donggua127/control_board/doc/jsfs_zk_bk.pdf

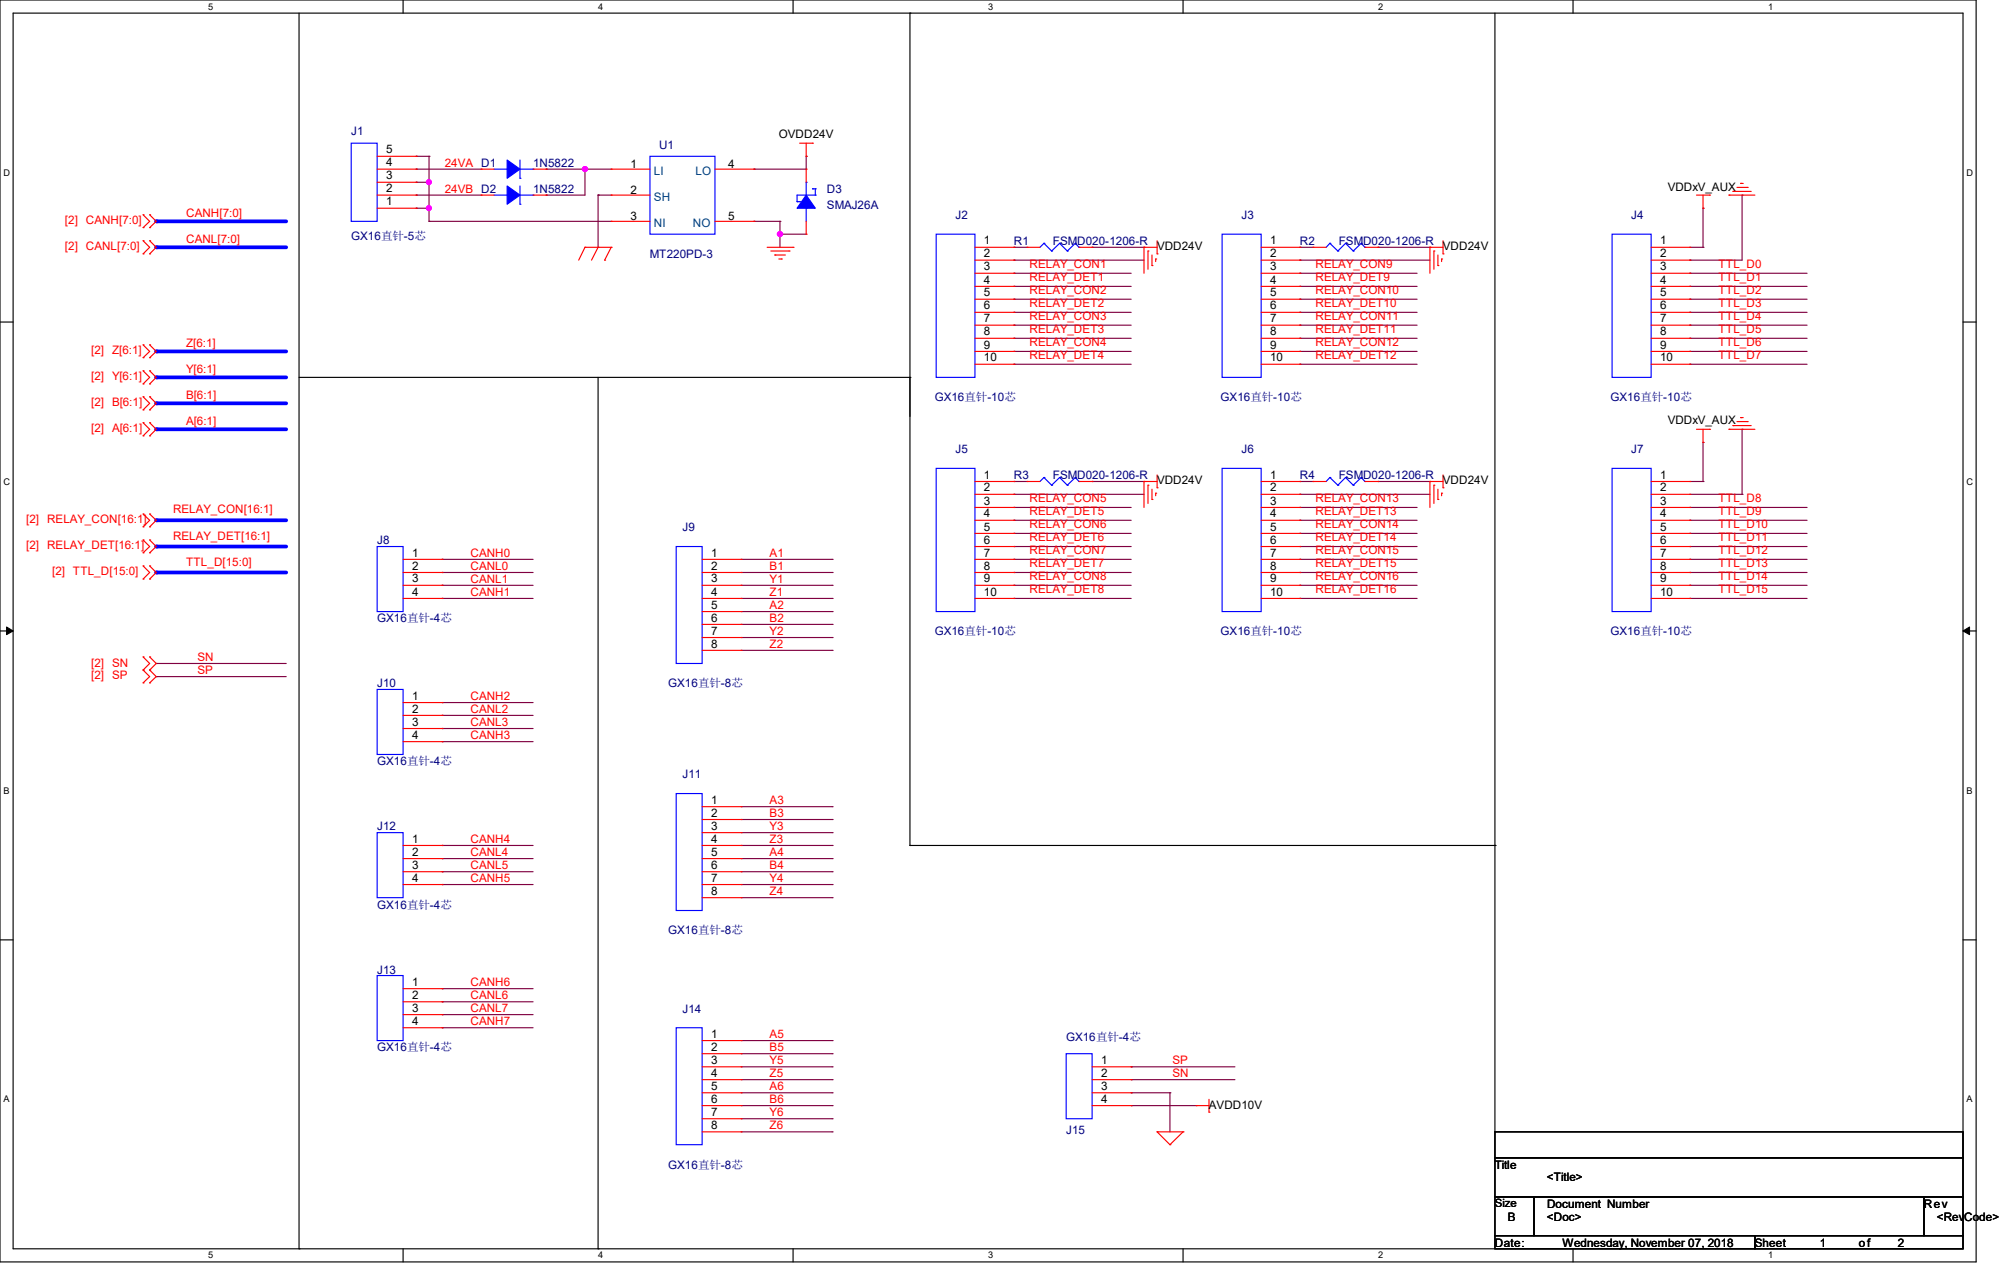
[picture p13: page 1]

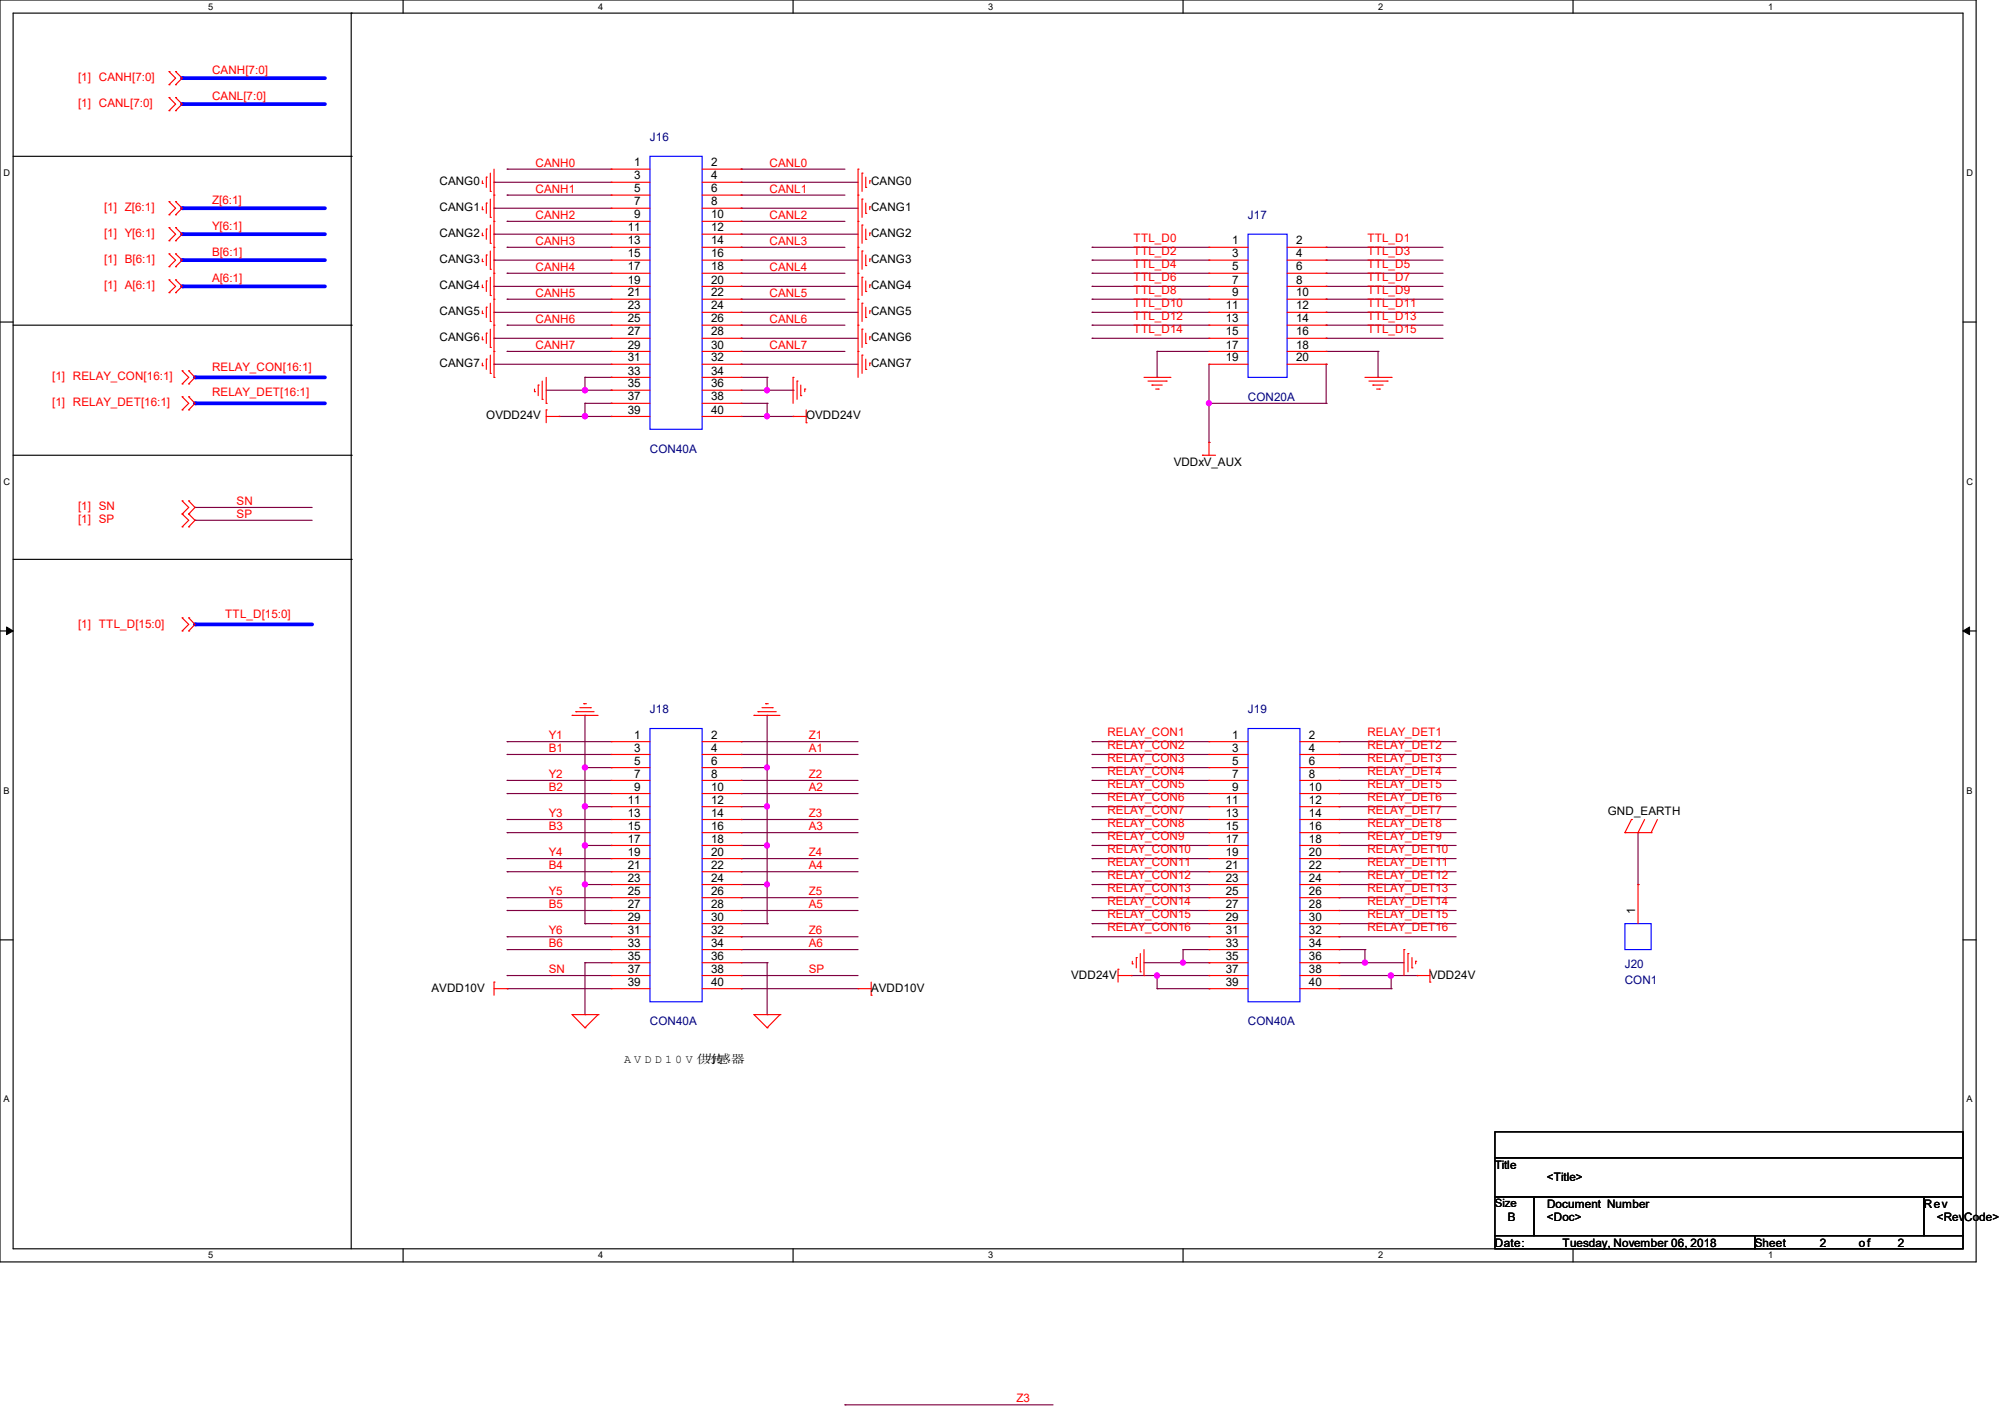
[picture p14: page 2]
A V D D 1 0 V 供力传感器; CANH[7:0]; CANL[7:0]; CANH0; CANL0; CANH1; CANL1; CANH2; CANL2; CANH3; CANL3; CANH4; CANL4; CANH5; CANL5; CANH6; CANL6; CANH7; CANL7; RELAY_CON[16:1]; RELAY_DET[16:1]; RELAY_CON1; RELAY_DET1; RELAY_CON2 RELAY_CON3 RELAY_CON4 RELAY_CON5 RELAY_CON6 RELAY_CON7 RELAY_CON8 RELAY_CON9 RELAY_CON10 RELAY_CON11 RELAY_CON12 RELAY_CON13 RELAY_CON14 RELAY_CON15 RELAY_CON16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
