donggua127/control_board/doc/JSFS_ZK_M_v1.3.pdf

# 01_NOTE 02_BLOCK_DIAGRAM

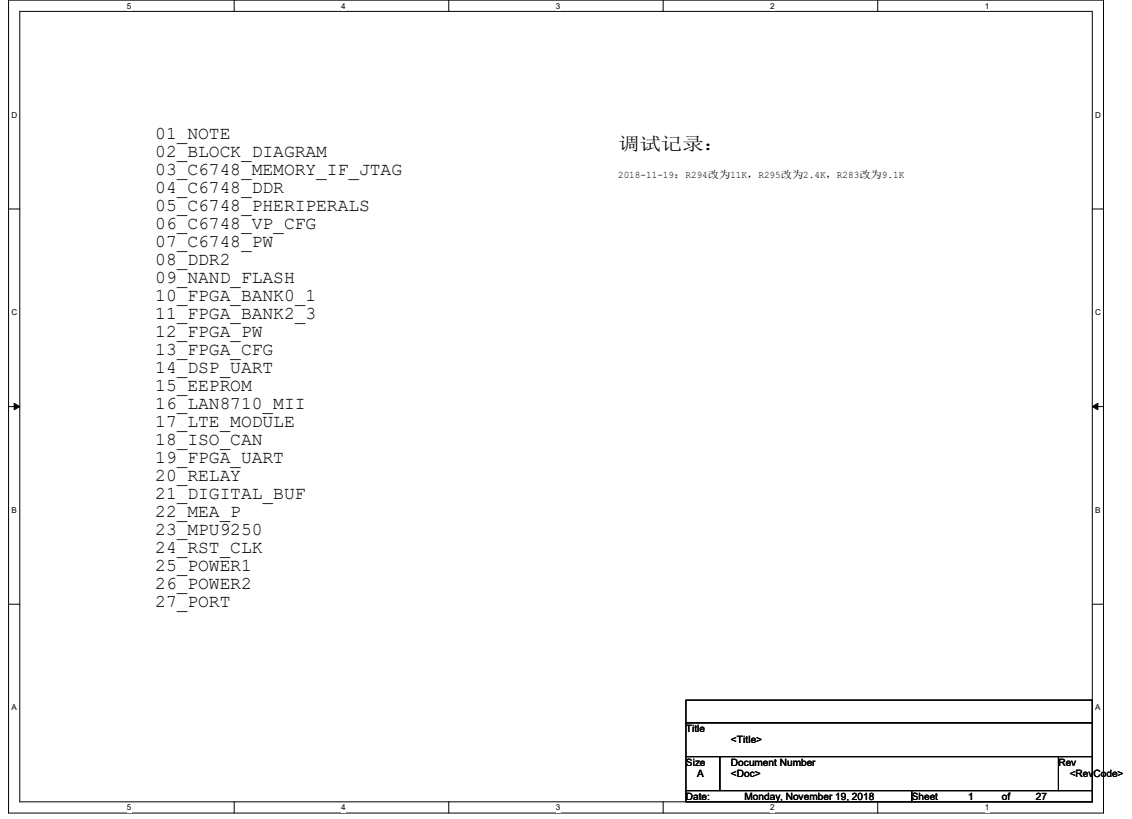
[picture p15: page 1]
03_C6748_MEMORY_IF_JTAG 04_C6748_DDR 05_C6748_PHERIPERALS 06_C6748_VP_CFG 07_C6748_PW 08_DDR2 09_NAND_FLASH 10_FPGA_BANK0_1 11_FPGA_BANK2_3 12_FPGA_PW 13_FPGA_CFG 14_DSP_UART 15_EEPROM 16_LAN8710_MII 17_LTE_MODULE 18_ISO_CAN 19_FPGA_UART 20_RELAY 21_DIGITAL_BUF 22_MEA_P 23_MPU9250 24_RST_CLK 25_POWER1 26_POWER2 27_PORT; 调试记录：; Title; Size; Document Number; Rev; Date:; Sheet; <Doc>; <RevCode>; <Title>; Monday, November 19, 2018

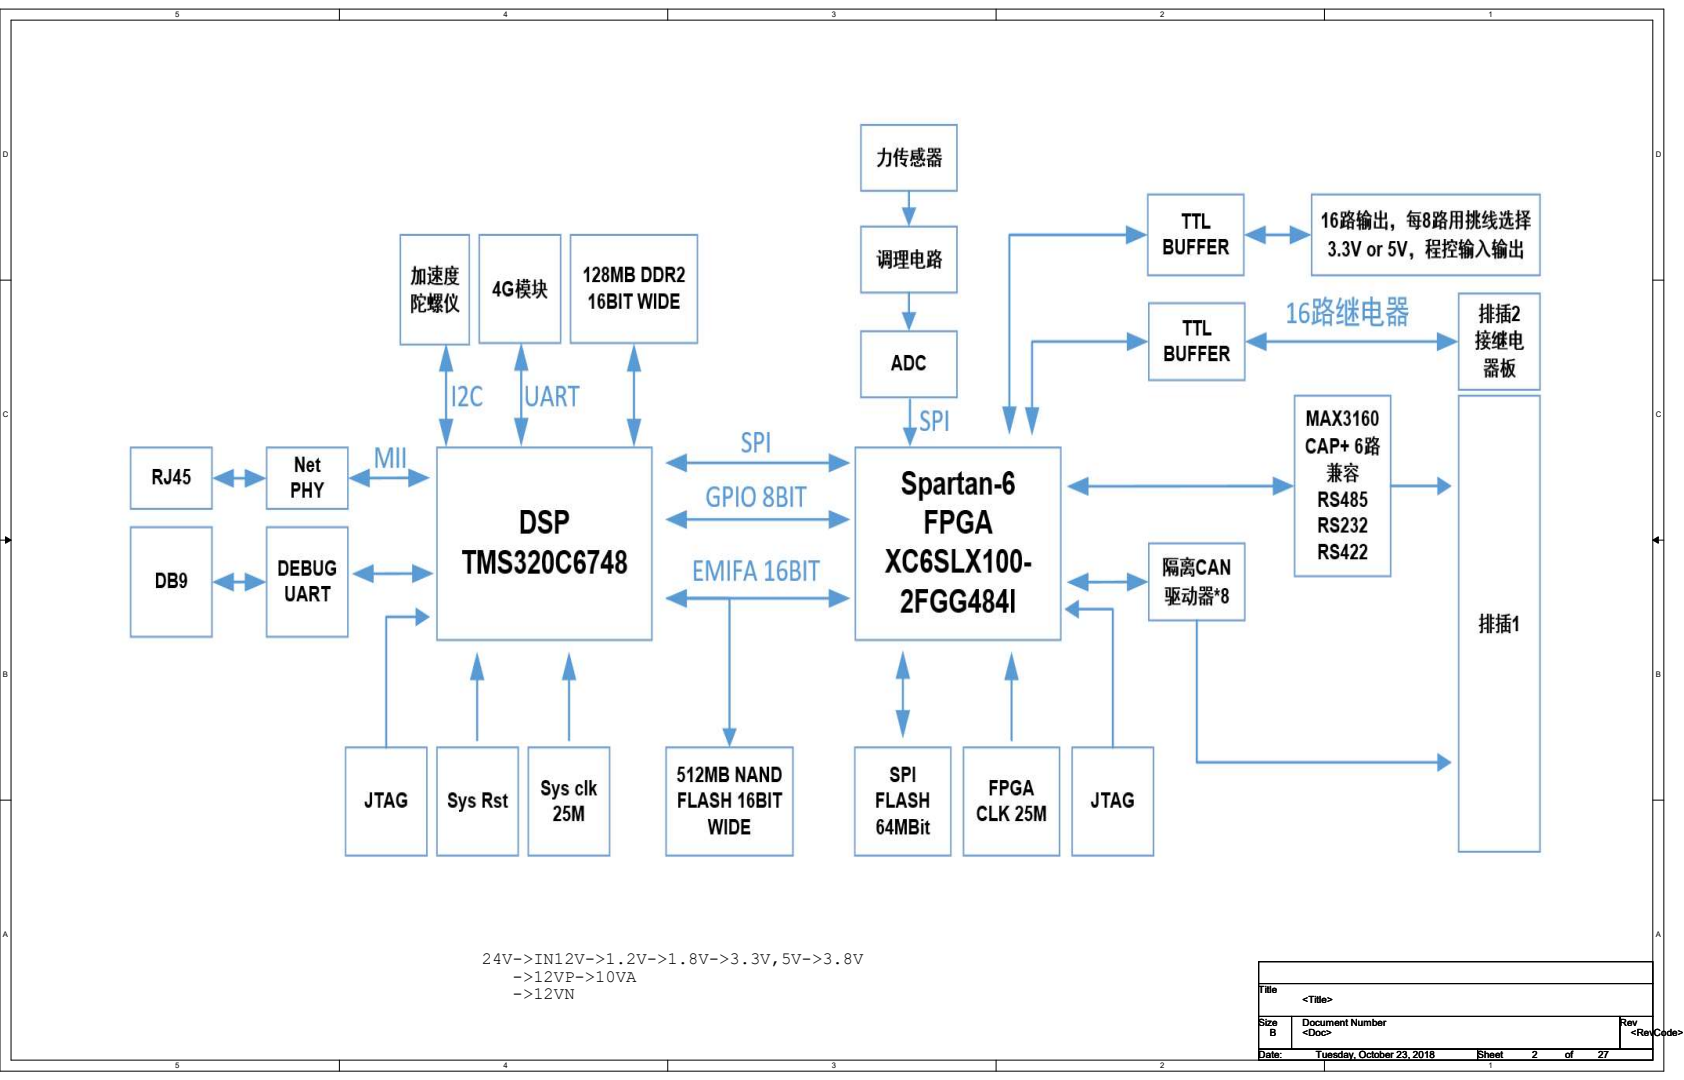
[picture p16: page 2]
Title Size; Document Number; Rev Date:; Sheet; of <Doc>; <RevCode>; <Title> B; Tuesday, October 23, 2018; 27 Title Size

# R304 4.7K R1 10K

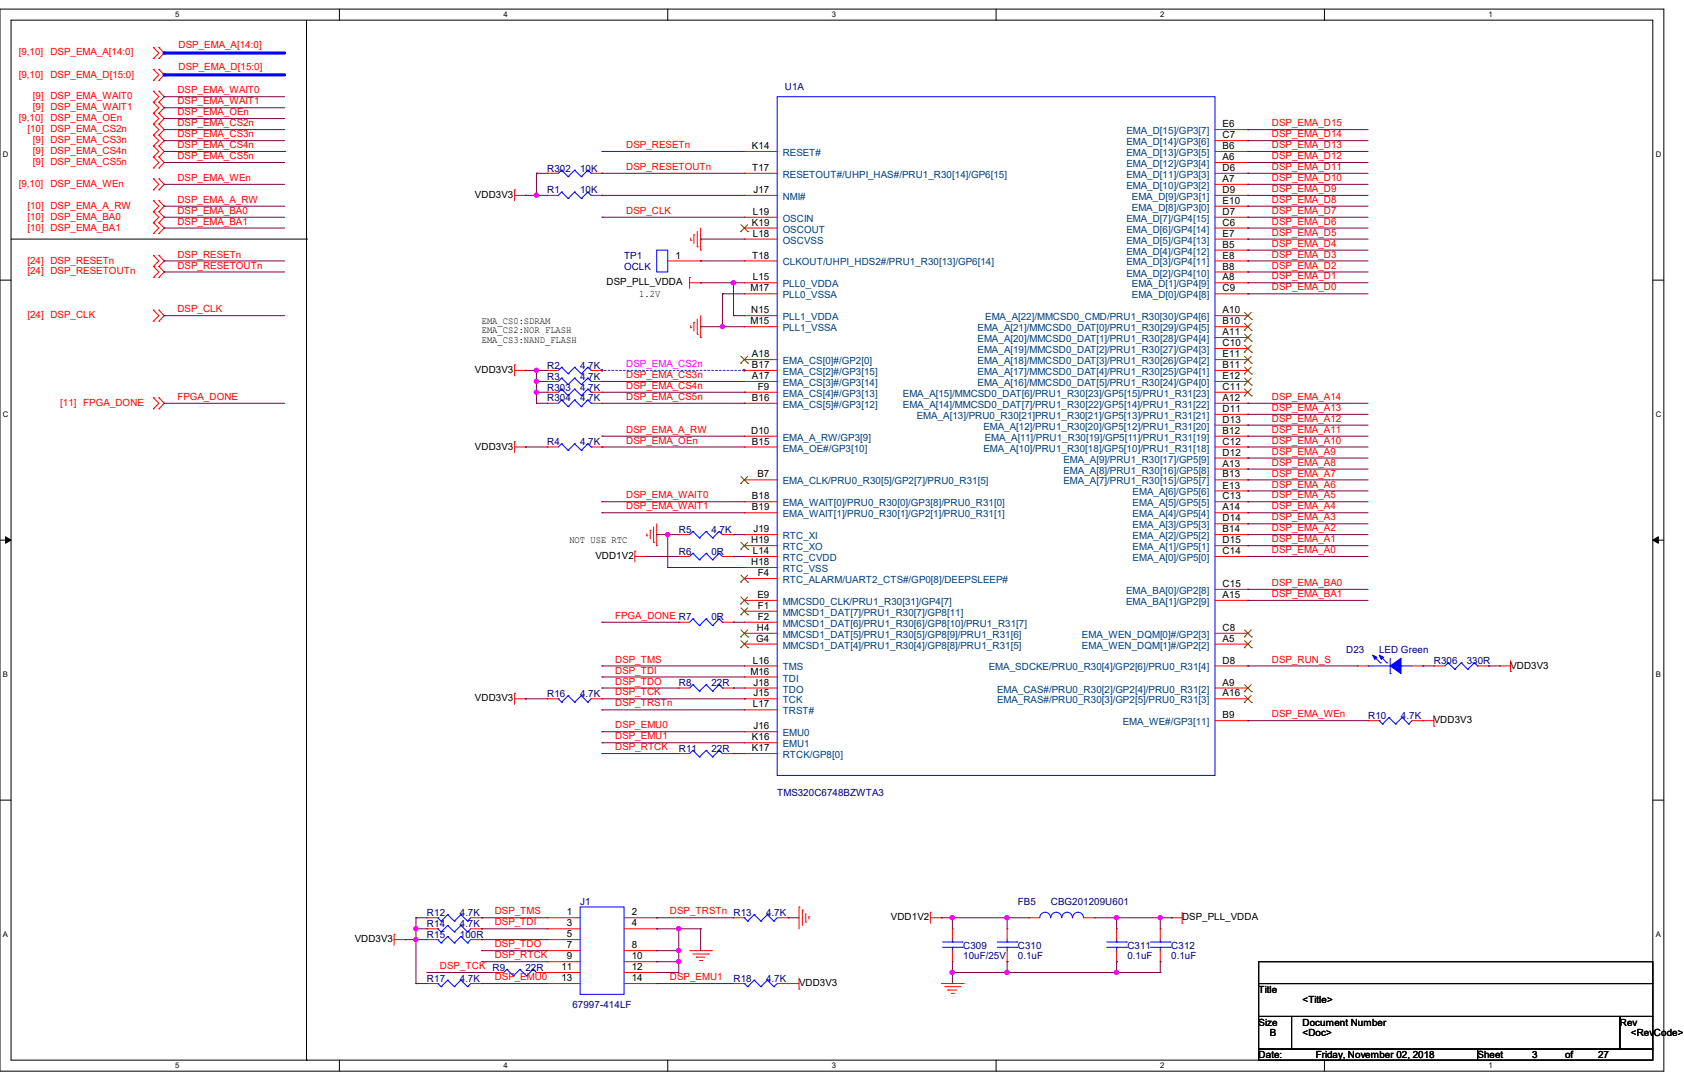
[picture p17: page 3]

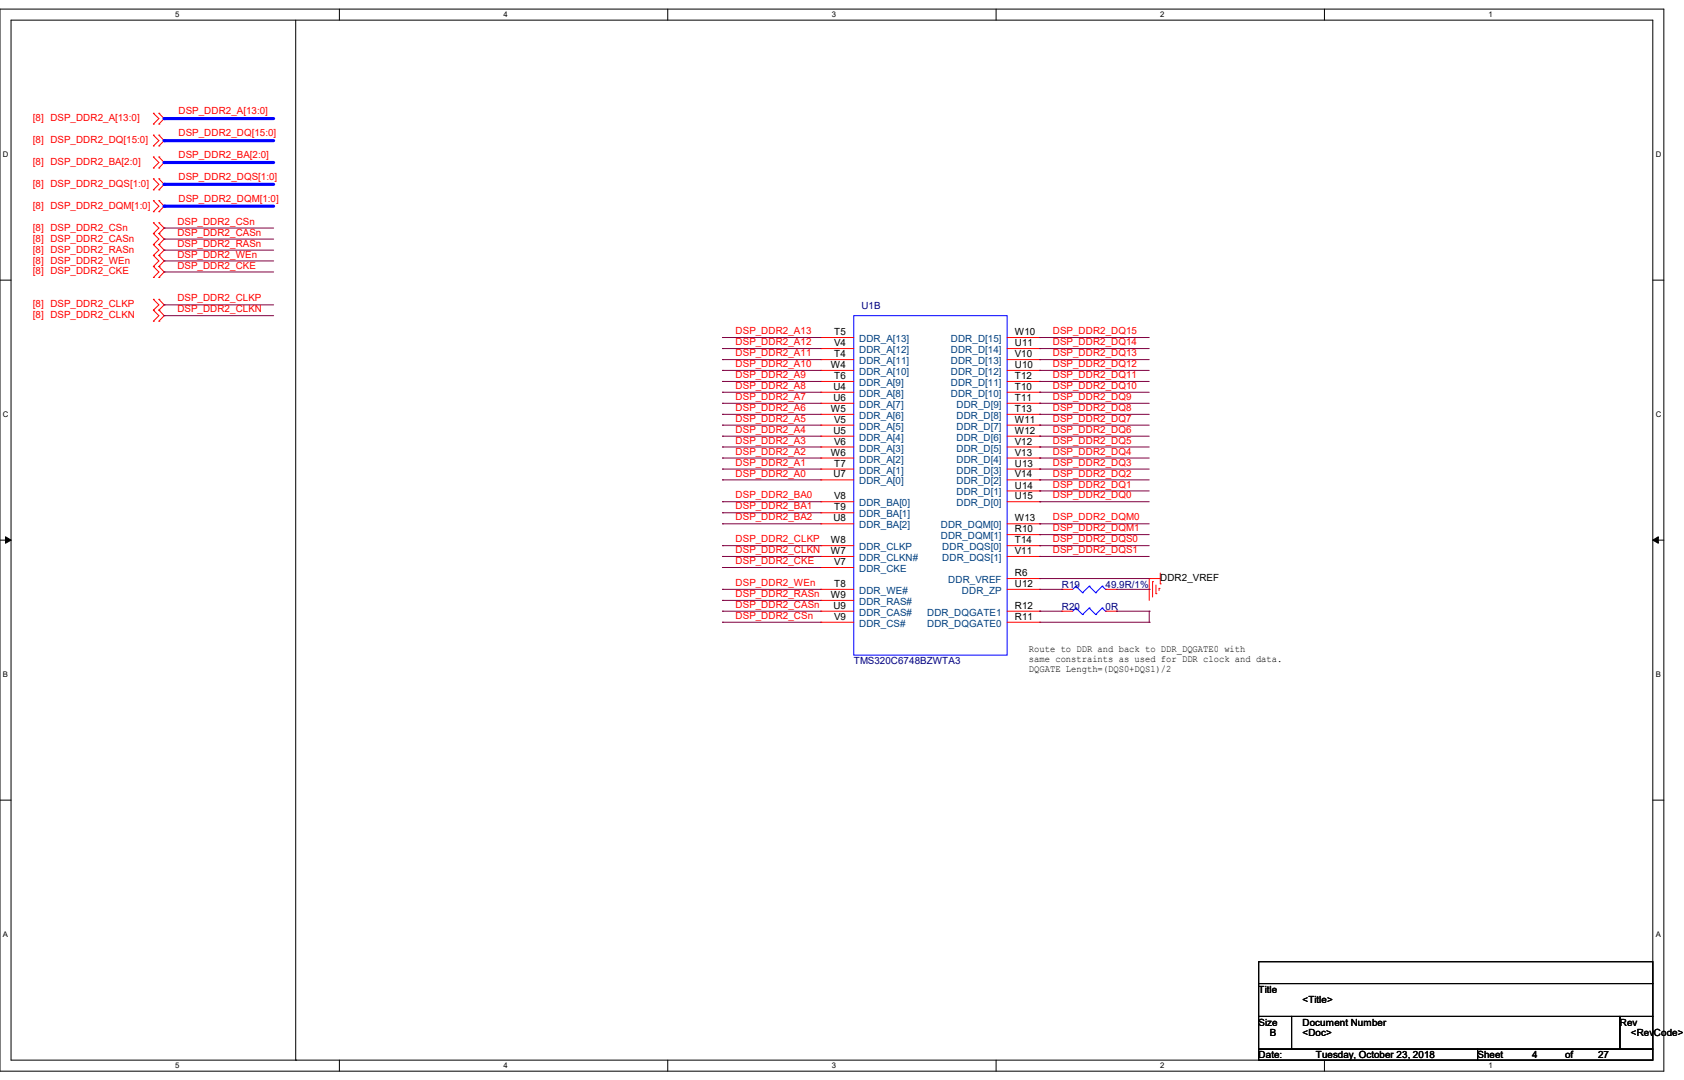
[picture p18: page 4]

Route to DDR and back to DDR_DQGATE0 with
same constraints as used for DDR clock and data.

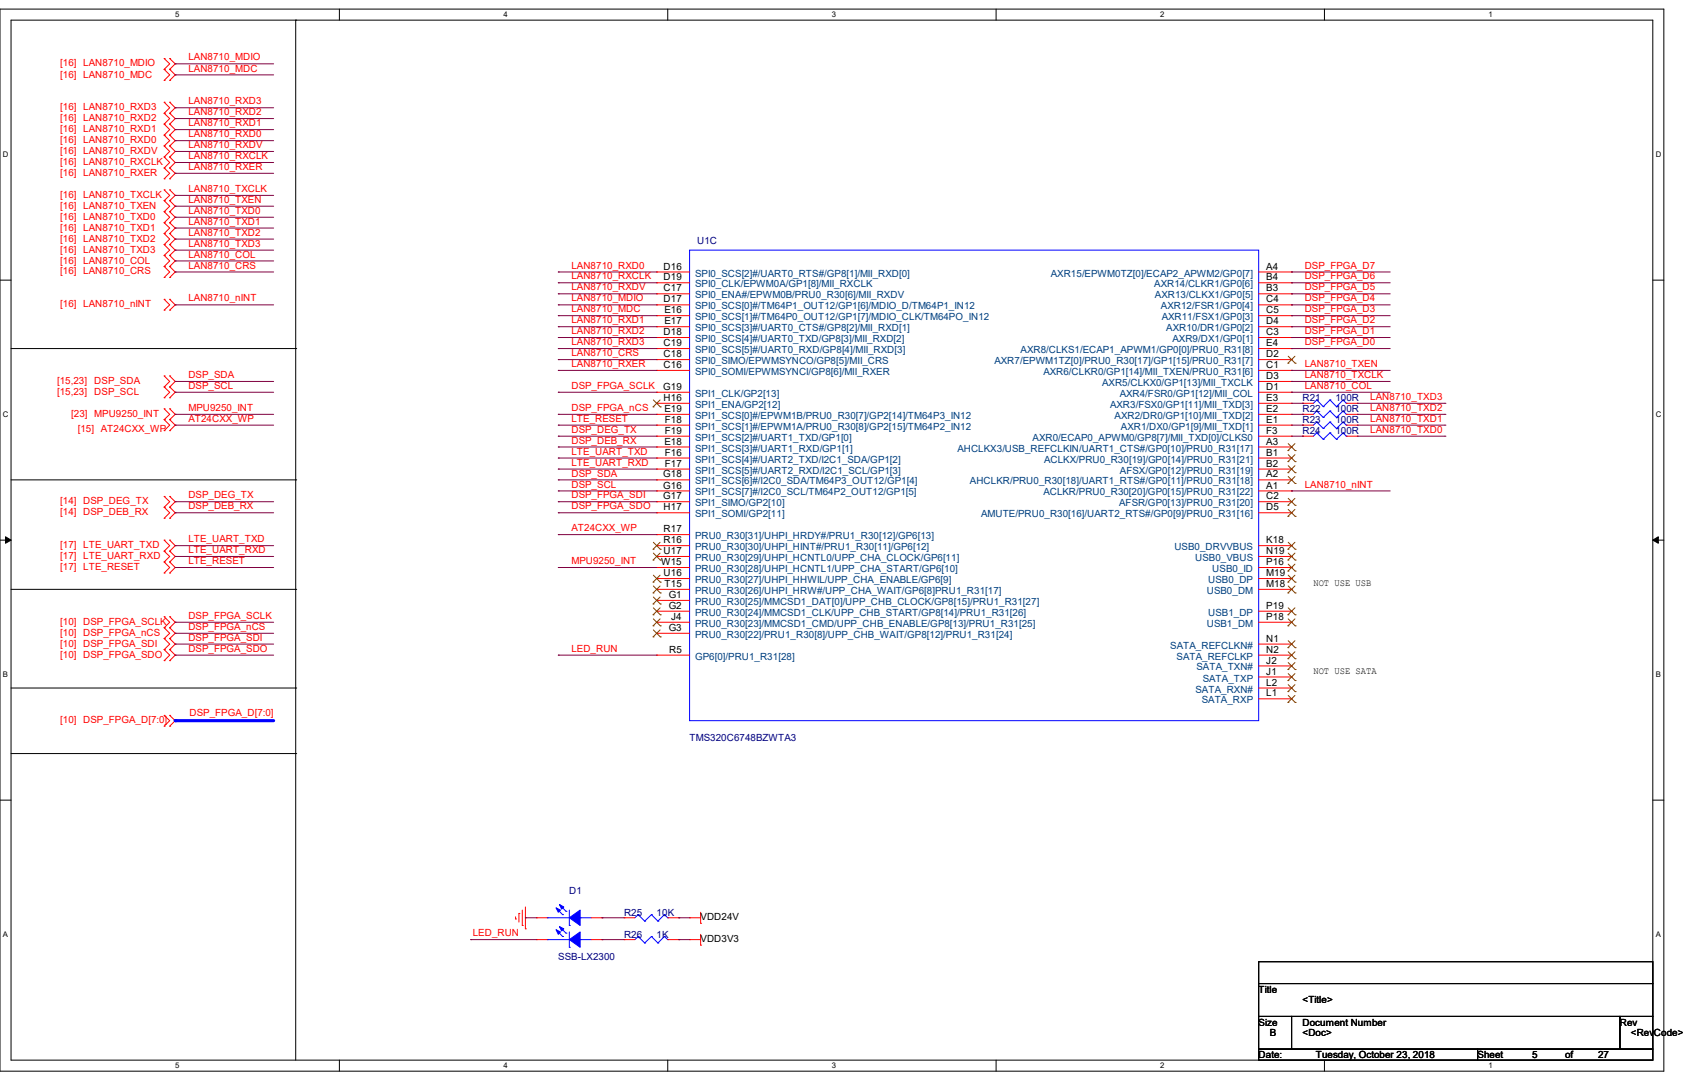
[picture p19: page 5]

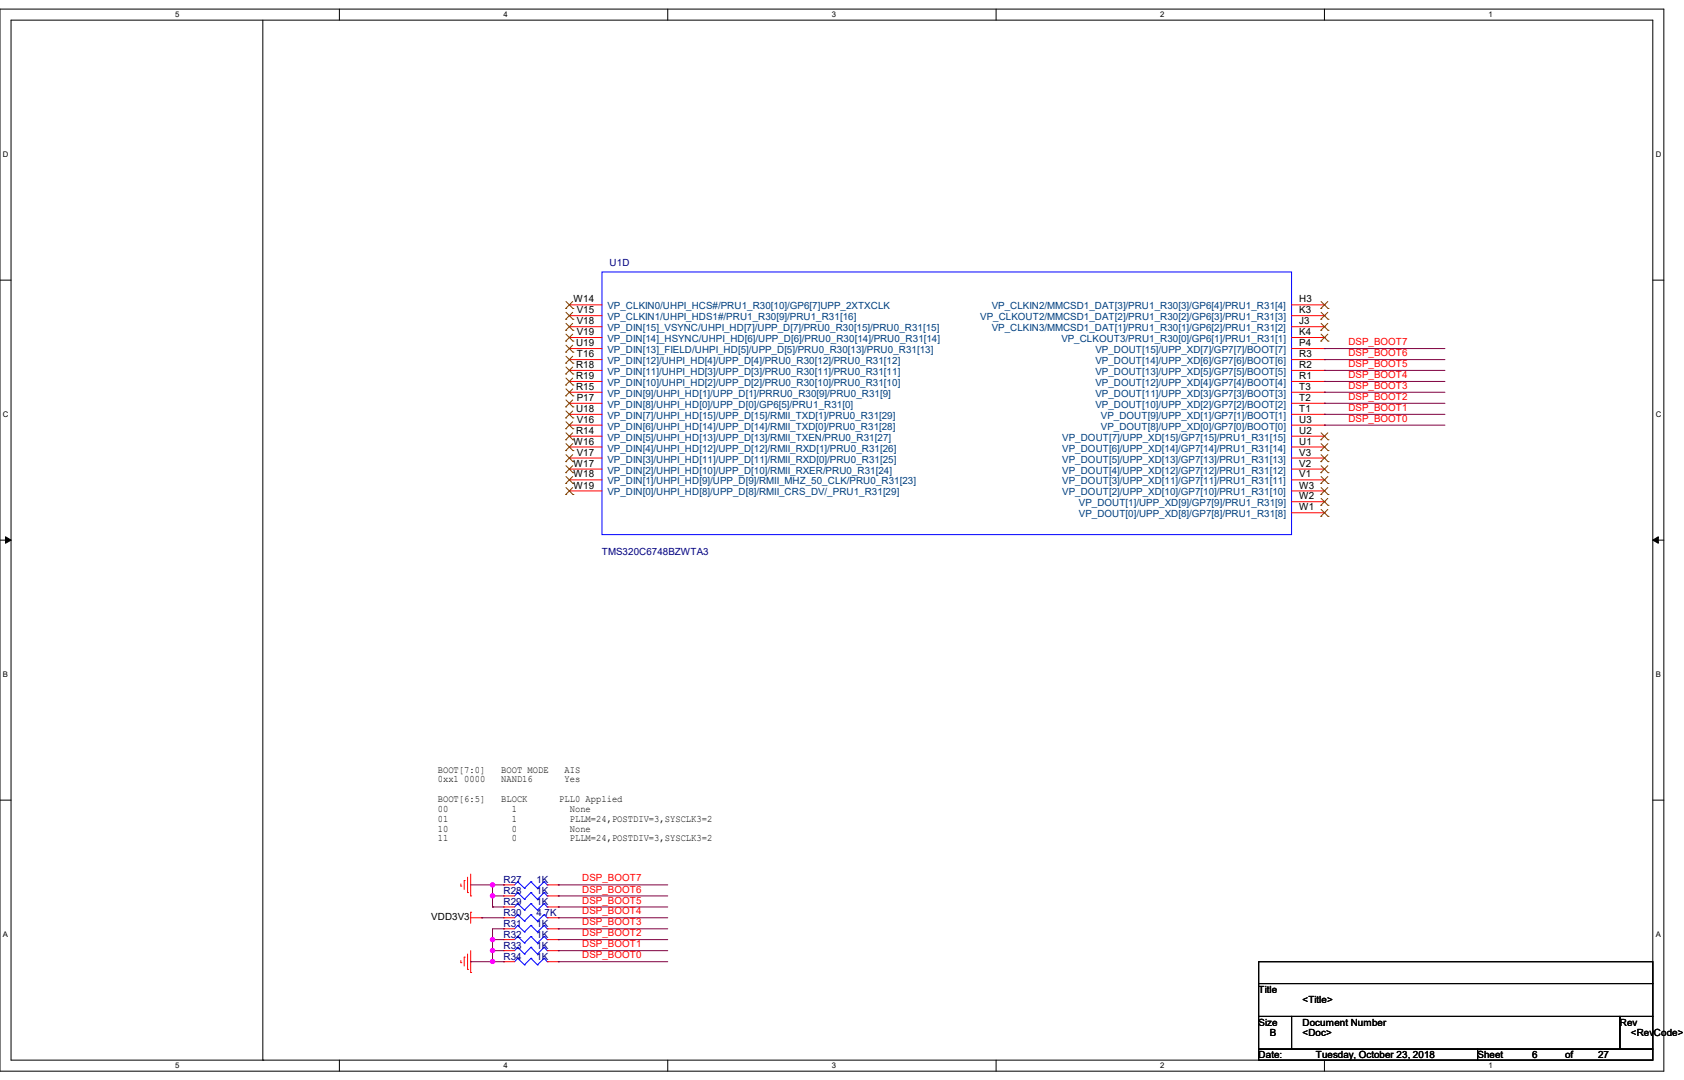
[picture p20: page 6]

RSV2 T19 | RSV3/SATA_VDD M2 | RSV3/SATA_VDD N4 | RSV3/SATA_VDD P2 | RSV3/SATA_VDD P1 | NC M³ NC M¹⁴ NC N¹⁶
USB0_VDDA33 | N18 USB0_VDDA18 | N14 USB0_VDDA12 | N17 USB_CVDD | M12 DDR_DVDD18 N6 | DDR_DVDD18 N9 | DDR_DVDD18 N10 | DDR_DVDD18 P7 | DDR_DVDD18 P8 | DDR_DVDD18 P9 | DDR_DVDD18 P10 | DDR_DVDD18 R7 | DDR_DVDD18 R8 | DDR_DVDD18 R9 | CVDD | E15 CVDD | G7 CVDD | G8 CVDD | G13 CVDD | H6 CVDD | H7 CVDD | H10 CVDD | H11 CVDD | H12 CVDD | H13 CVDD | J6 CVDD | J12 CVDD | K6 CVDD | K12 CVDD | L12 CVDD | M8 CVDD | M9 CVDD | N8 RVDD | E5 RVDD | H14 RVDD | N7 DVDD18 | F14 DVDD18 | G6 DVDD18 | G10 DVDD18 | G11 DVDD18 | G12 DVDD18 | J13 DVDD18 | K5 DVDD18 | L6 DVDD18 | P13 DVDD18 | R13 DVDD3318_A F5 DVDD3318_A F15 DVDD3318_A G5 DVDD3318_A G14 DVDD3318_A G15 DVDD3318_A H5 DVDD3318_B E14 DVDD3318_B F6 DVDD3318_B F7 DVDD3318_B F8 DVDD3318_B F10 DVDD3318_B F11 DVDD3318_B F12 DVDD3318_B F13 DVDD3318_B G9 DVDD3318_B J14 DVDD3318_B K15 DVDD3318_C | J5 DVDD3318_C | K13 DVDD3318_C | L4 DVDD3318_C | L13 DVDD3318_C | M13 DVDD3318_C | N13 DVDD3318_C | P5 DVDD3318_C | P6 DVDD3318_C | P12 DVDD3318_C | R4

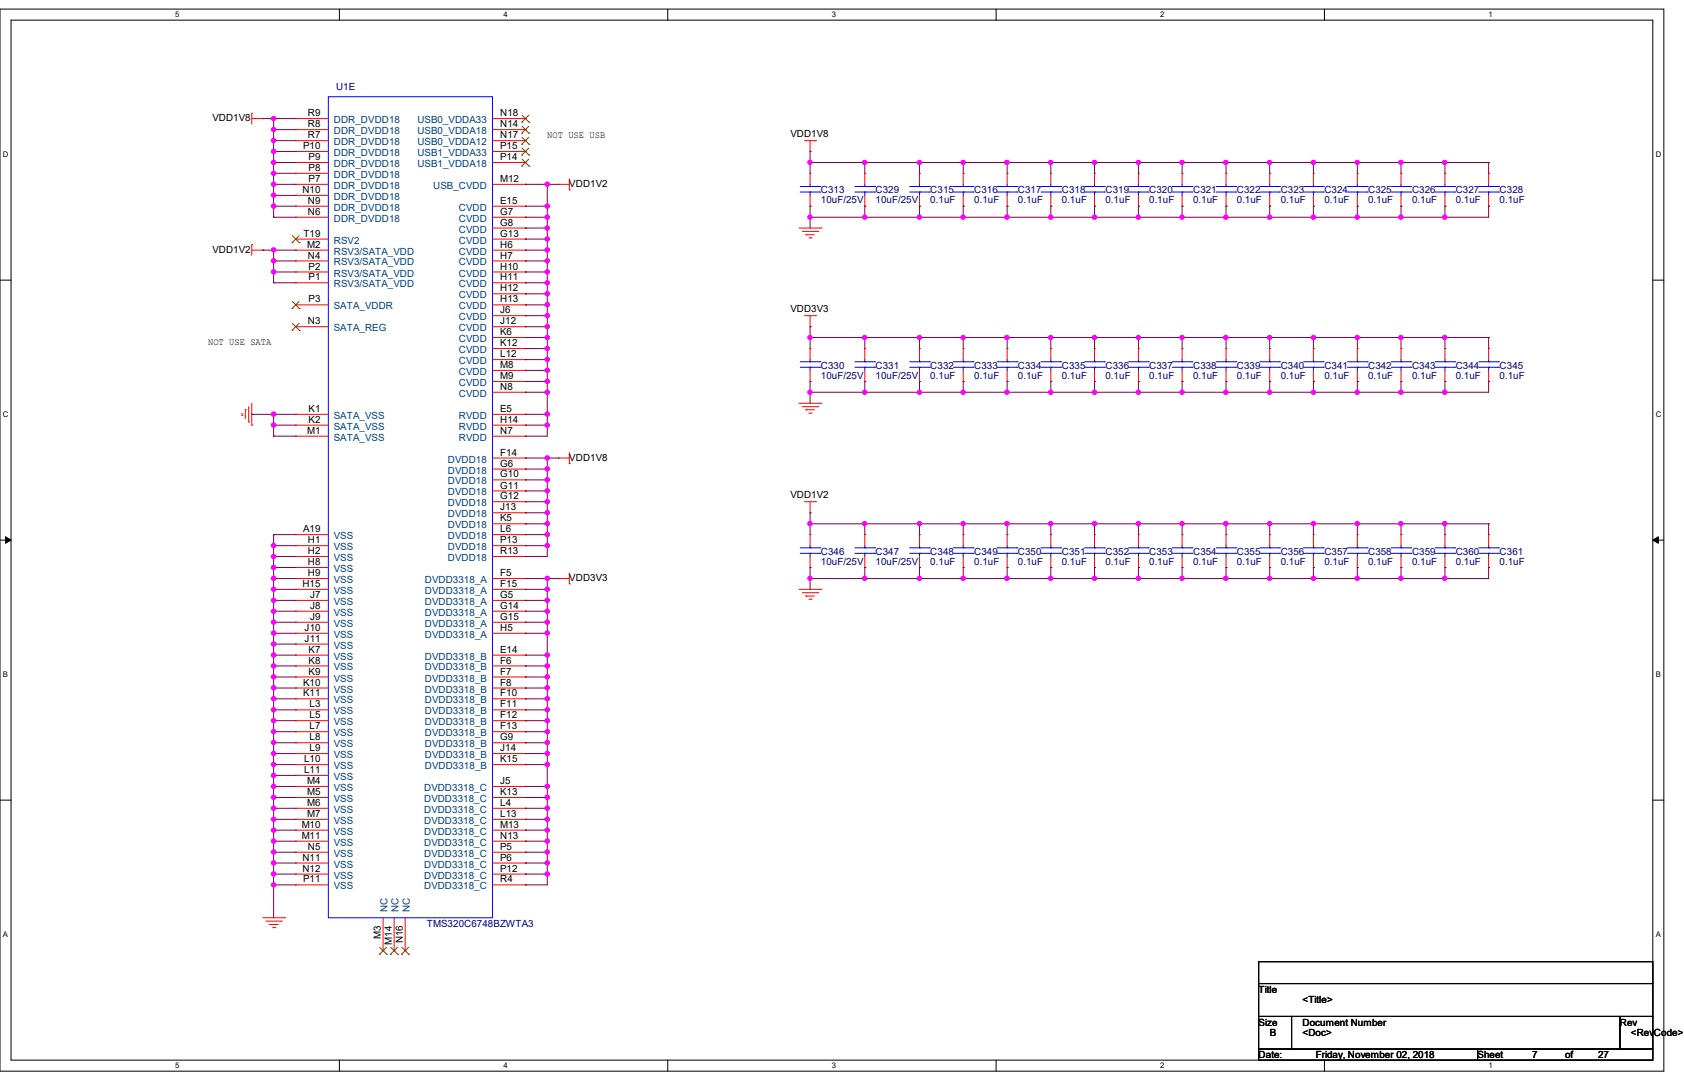
[picture p21: page 7]

A0 M8 | A1 M3 | A2 M7 | A3 N2 | A4 N8 | A5 N3 | A6 N7 | A7 P2 | A8 P8 | A9 P3 | A10 M2 | A11 P7 | A12 R2 | BA0 L2 | BA1 L3 | BA2 L1 | CK J8 | CKn K8 | CKE K2 | CSn L8
VDD5 | A1 VDD4 | E1 VDD3 | M9 VDD2 | R1 VDD1 | J9 VDDQ10 | A9 VDDQ9 | C1 VDDQ8 | C3 VDDQ7 | C7 VDDQ6 | C9 VDDQ5 | G3 VDDQ4 | E9 VDDQ3 | G1 VDDQ2 | G7 VDDQ1 | G9 VDDL | J1 VREF | J2 VSS5 | A3 VSS4 | E3 VSS3 | J3 VSS2 | N1 VSS1 | P9 VSSQ10 | A7 VSSQ9 | B2 VSSQ8 | B8 VSSQ7 | D2 VSSQ6 | D8 VSSQ5 | E7 VSSQ4 | F2 VSSQ3 | F8 VSSQ2 | H2 VSSQ1 | H8 VSSDL | J7 NC1 A2 | NC2 E2 | UDQSn/NU A8 | RFU2 R3 | RFU3 R7

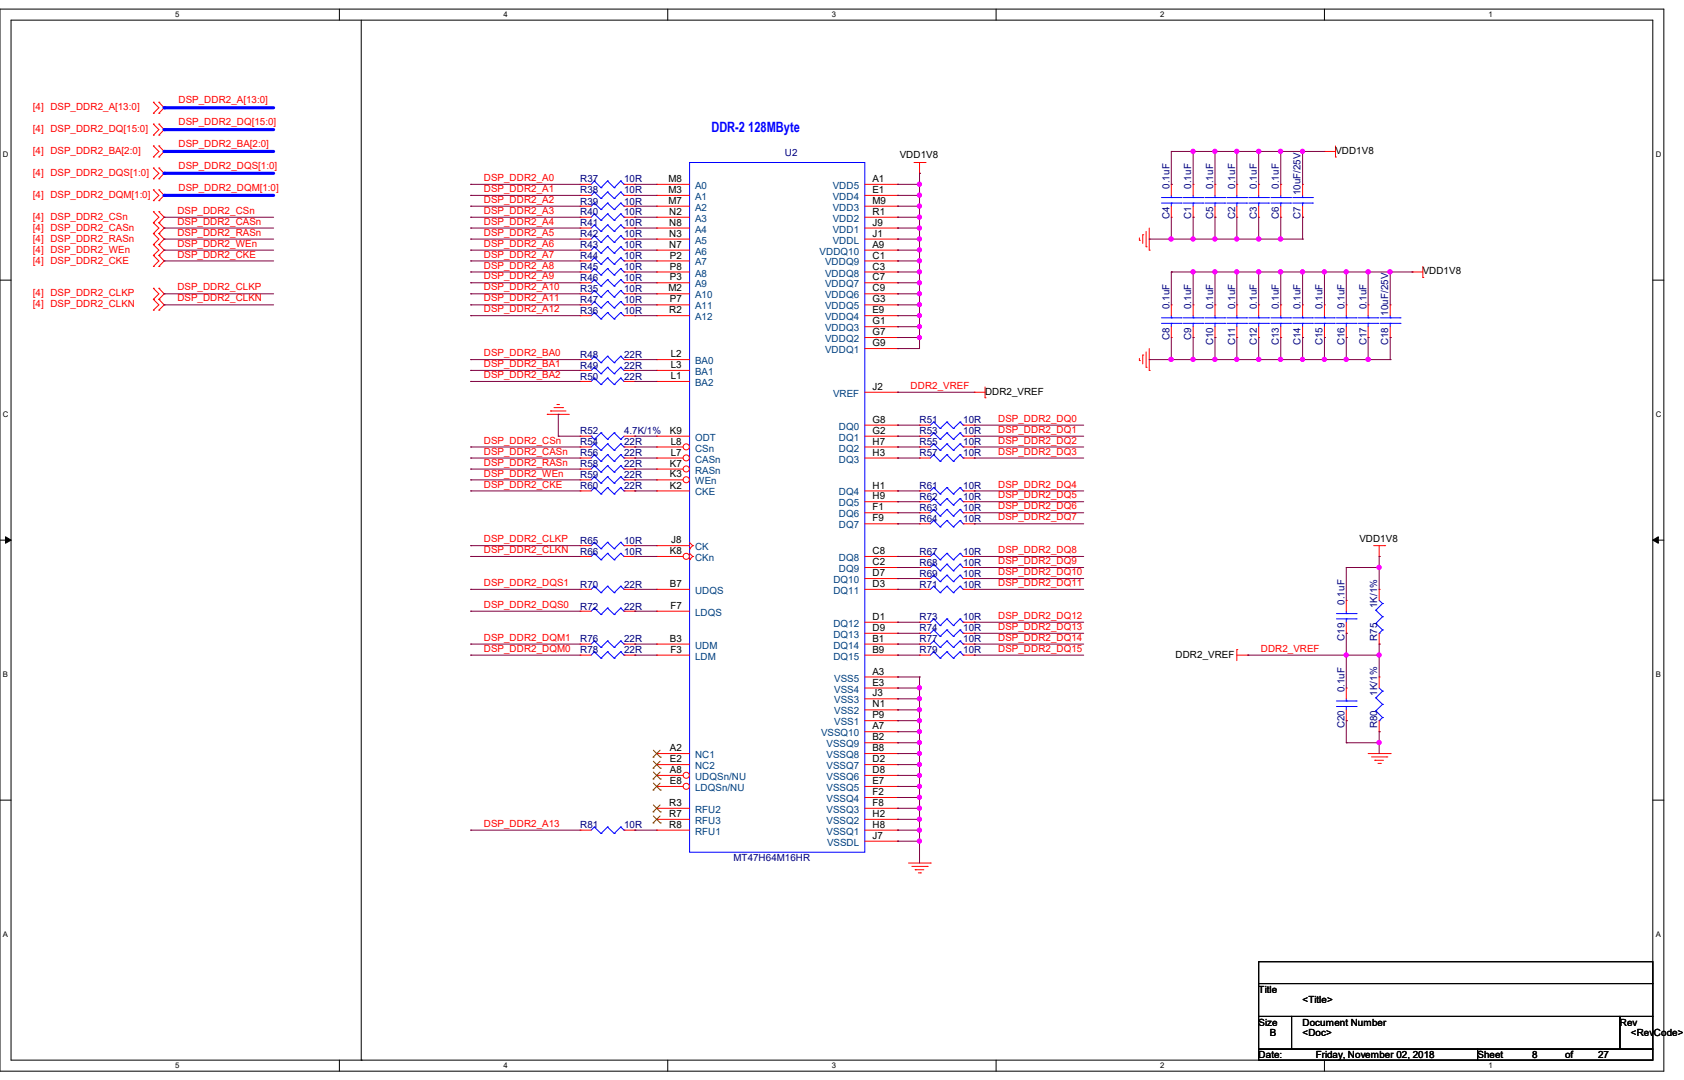
[picture p22: page 8]

## NAND FLASH 512MByte

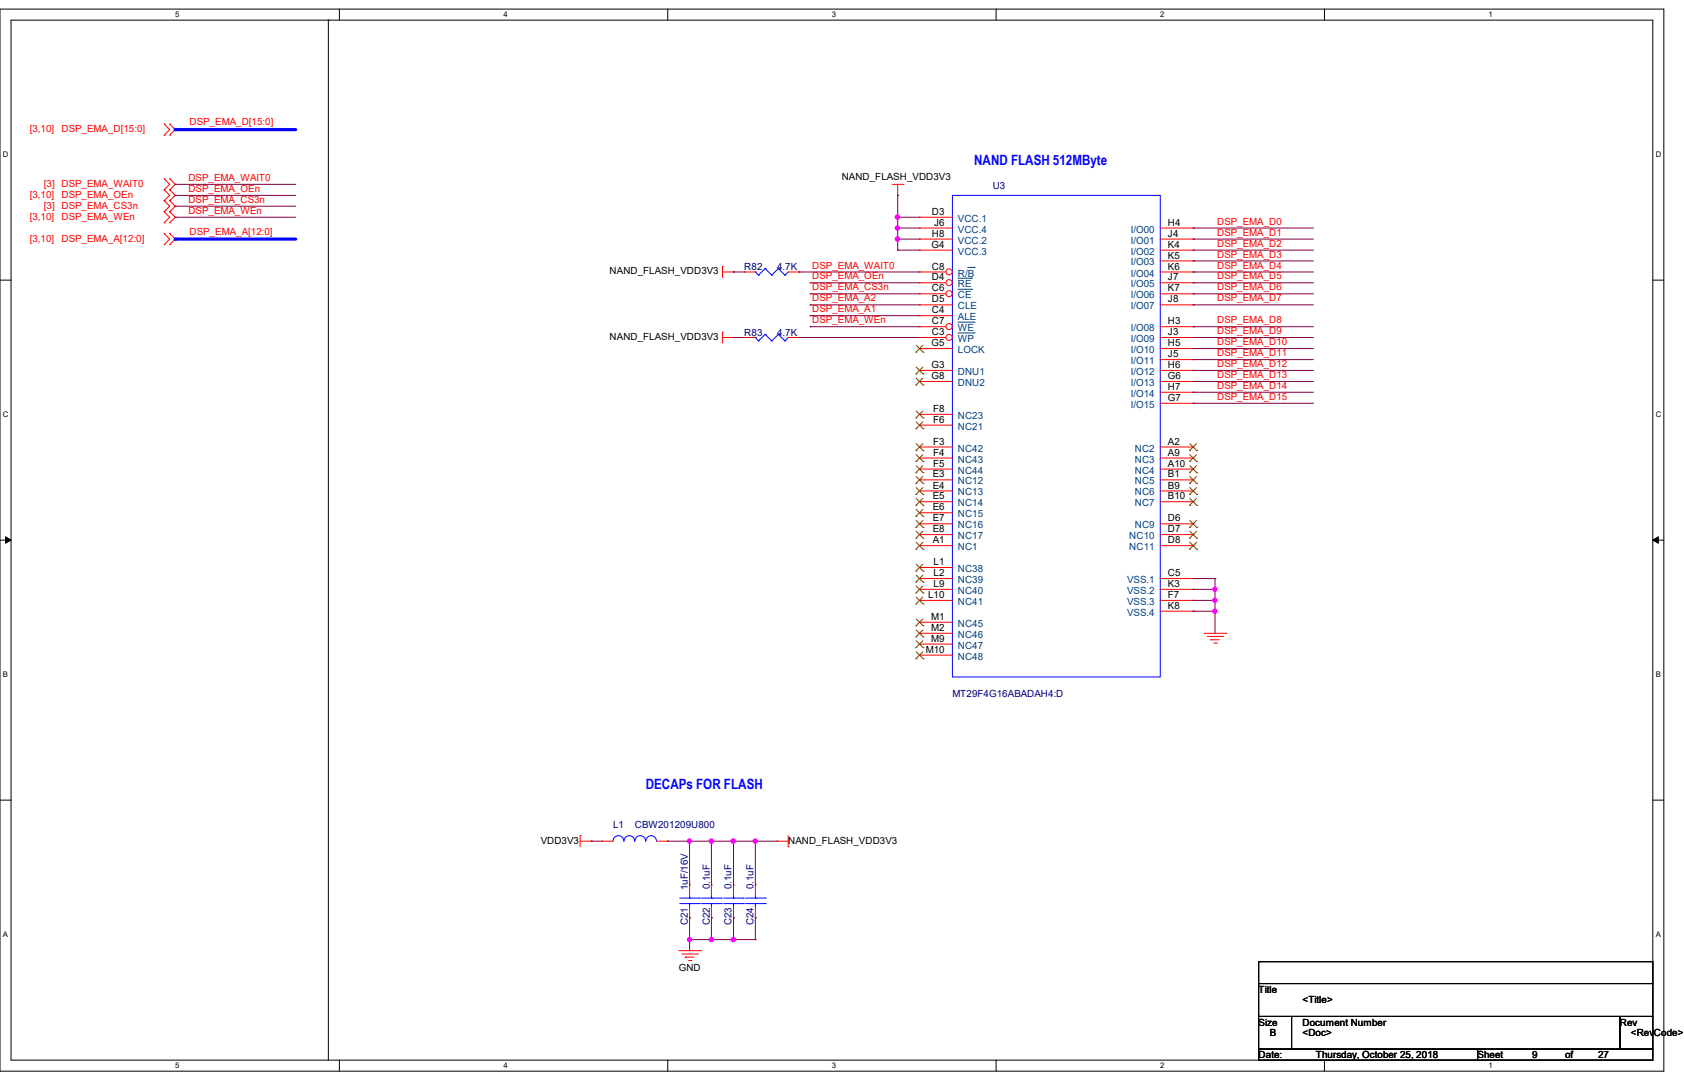
[picture p23: page 9]

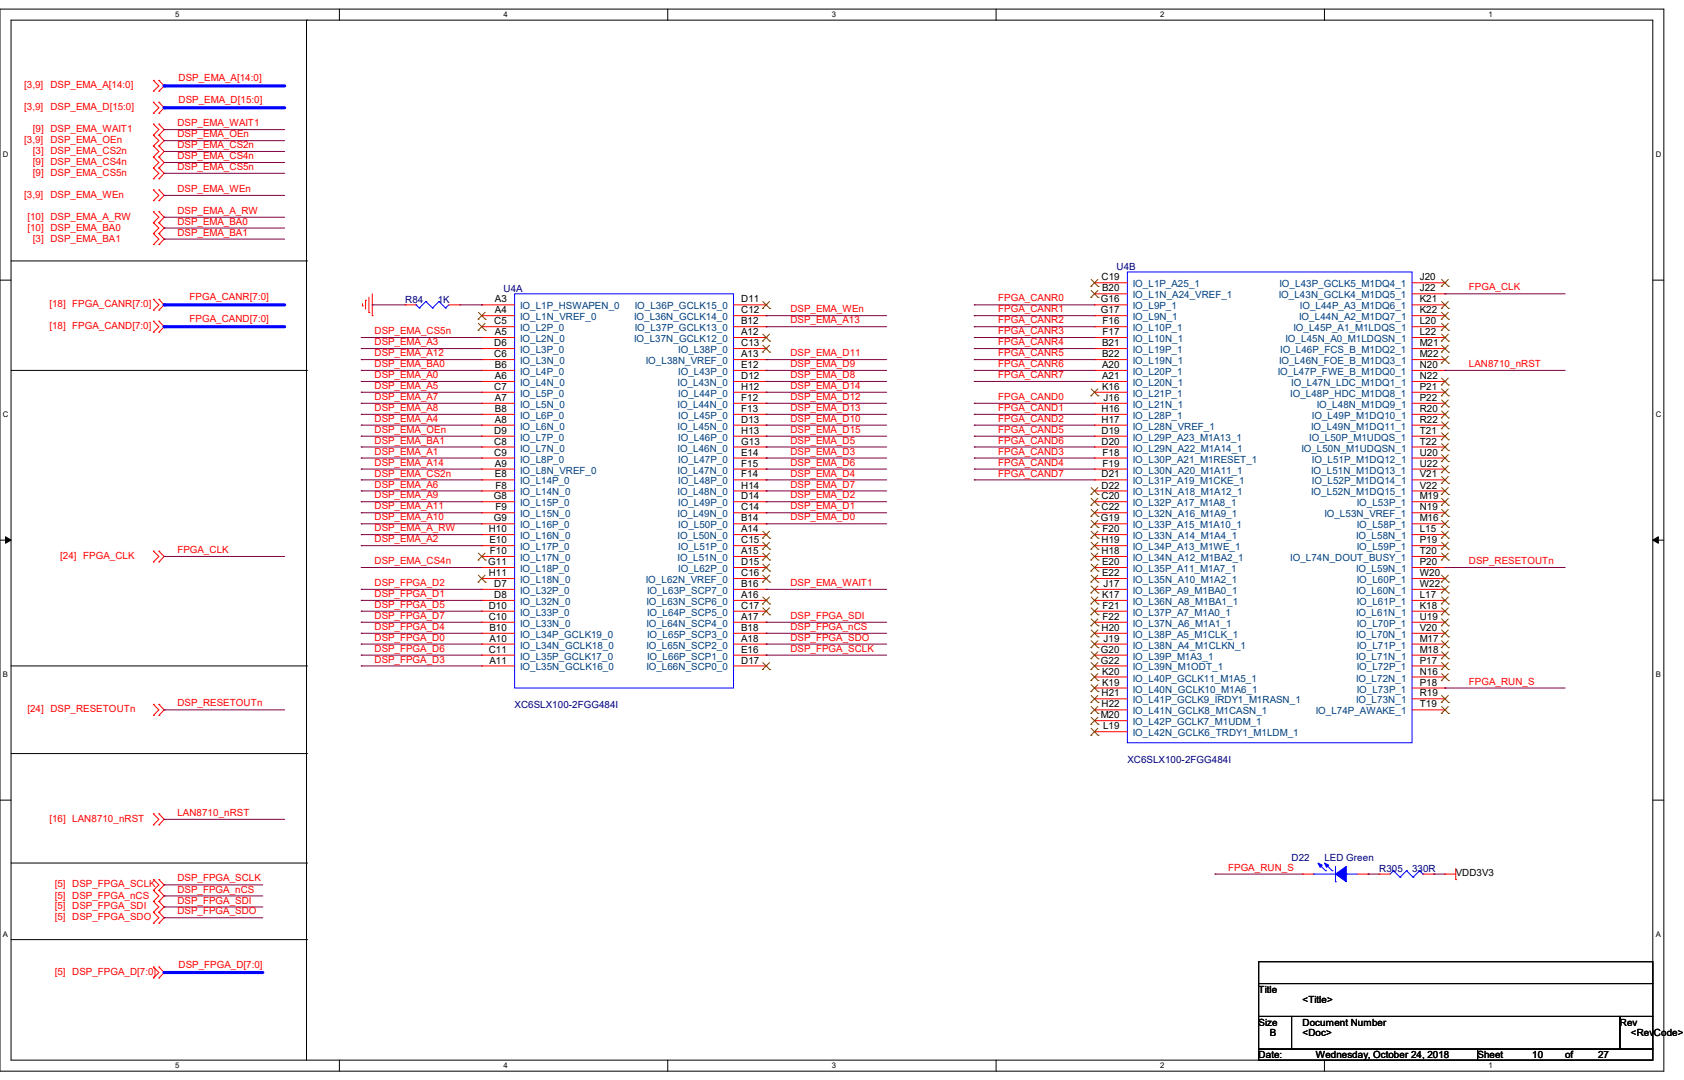
[picture p24: page 10]

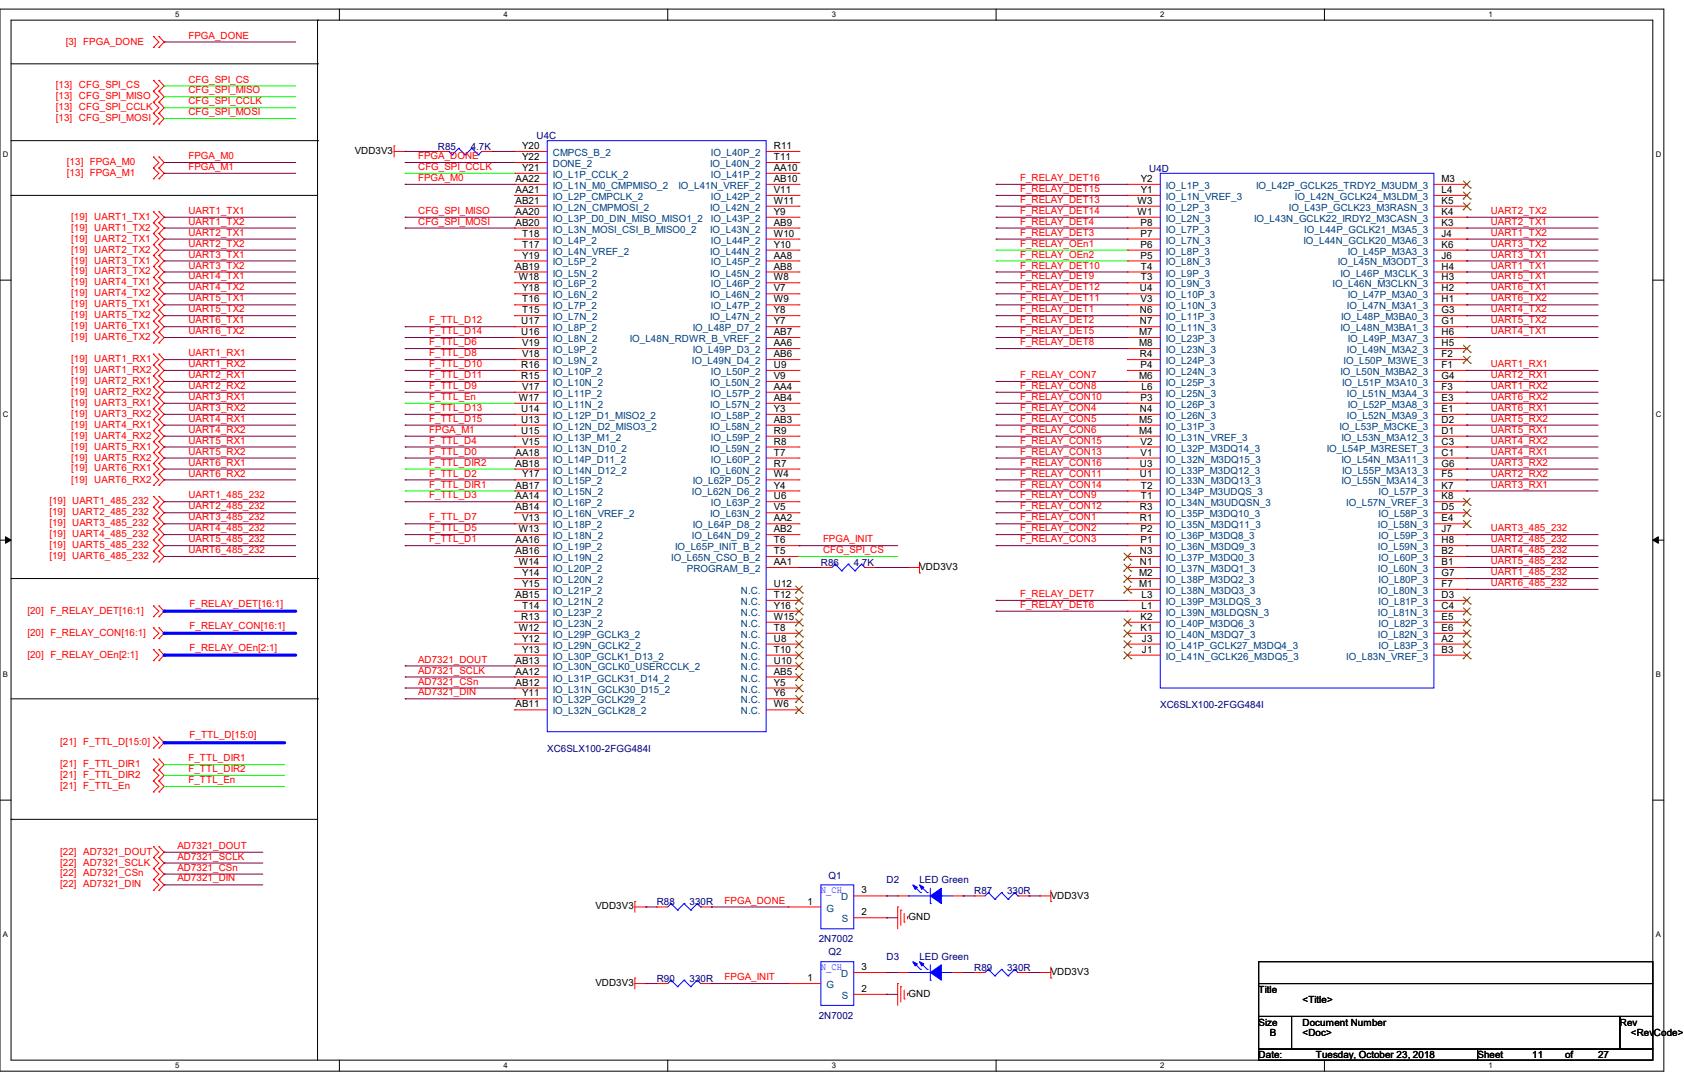
[picture p25: page 11]

# U4FXC6SLX100-2FGG484I

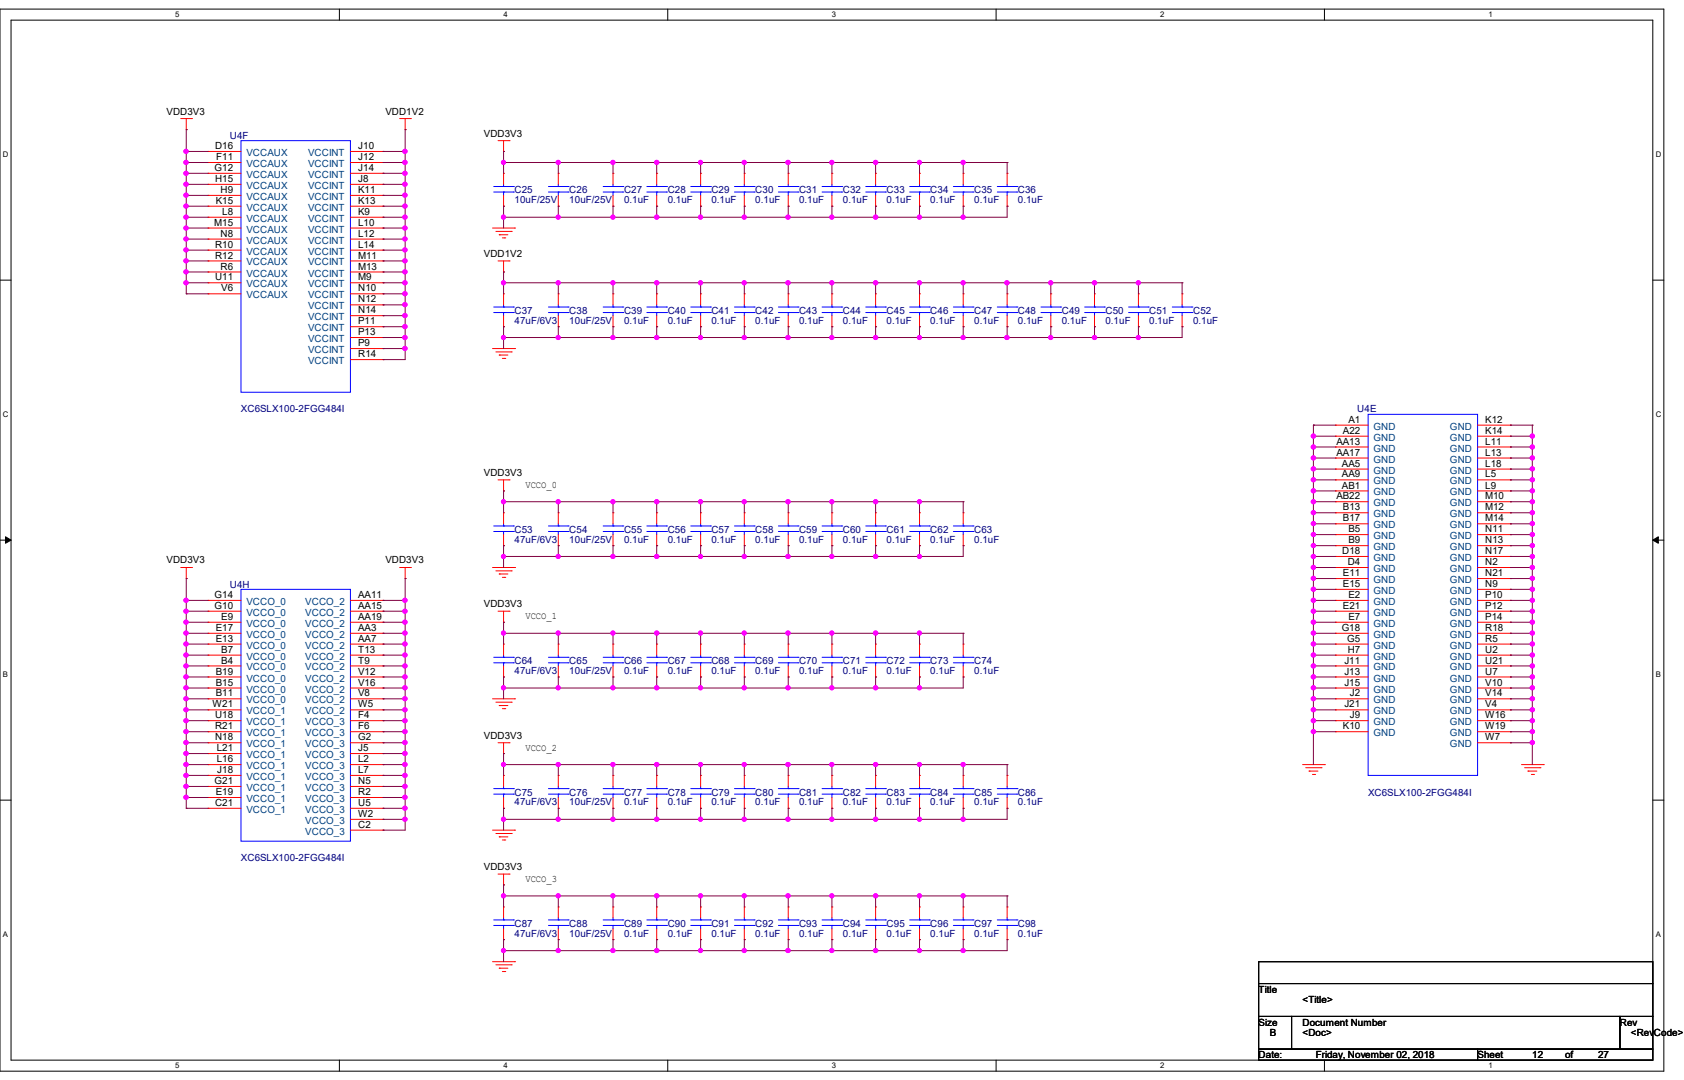
[picture p26: page 12]

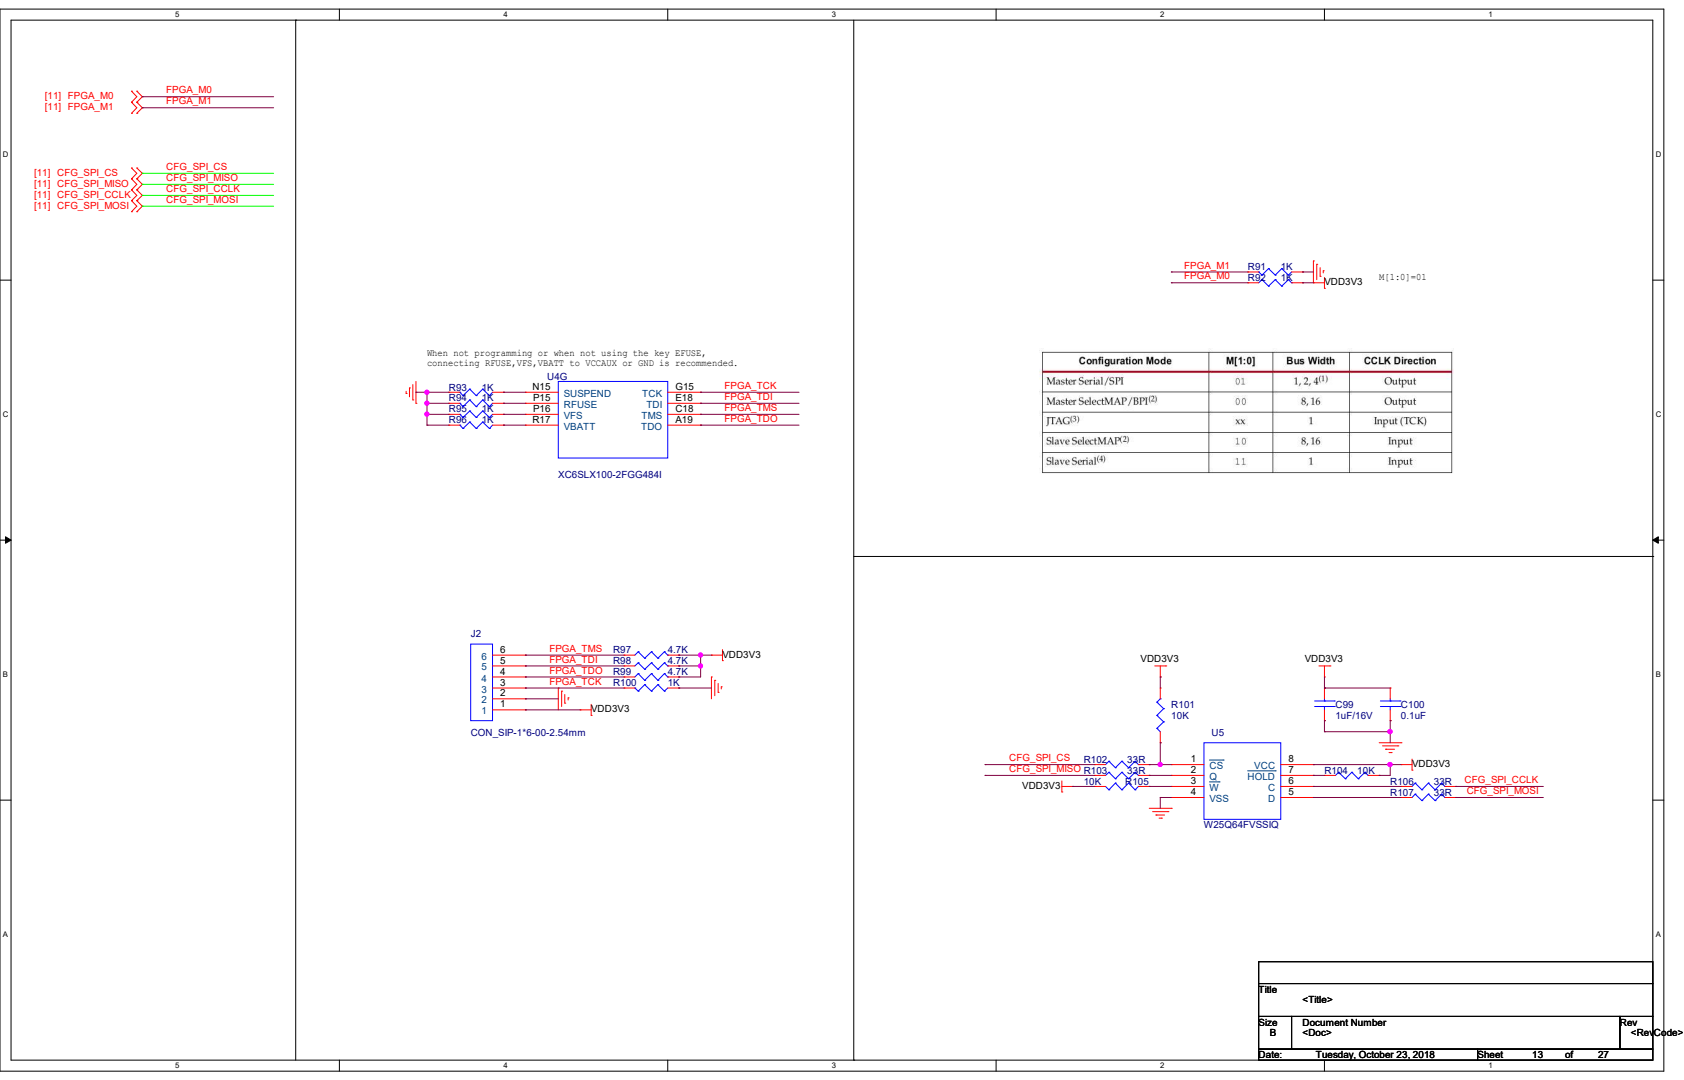
[picture p27: page 13]

When not programming or when not using the key EFUSE,
connecting RFUSE,VFS,VBATT to VCCAUX or GND is recommended.

## VDD3V3

## [5] DSP_DEG_TX

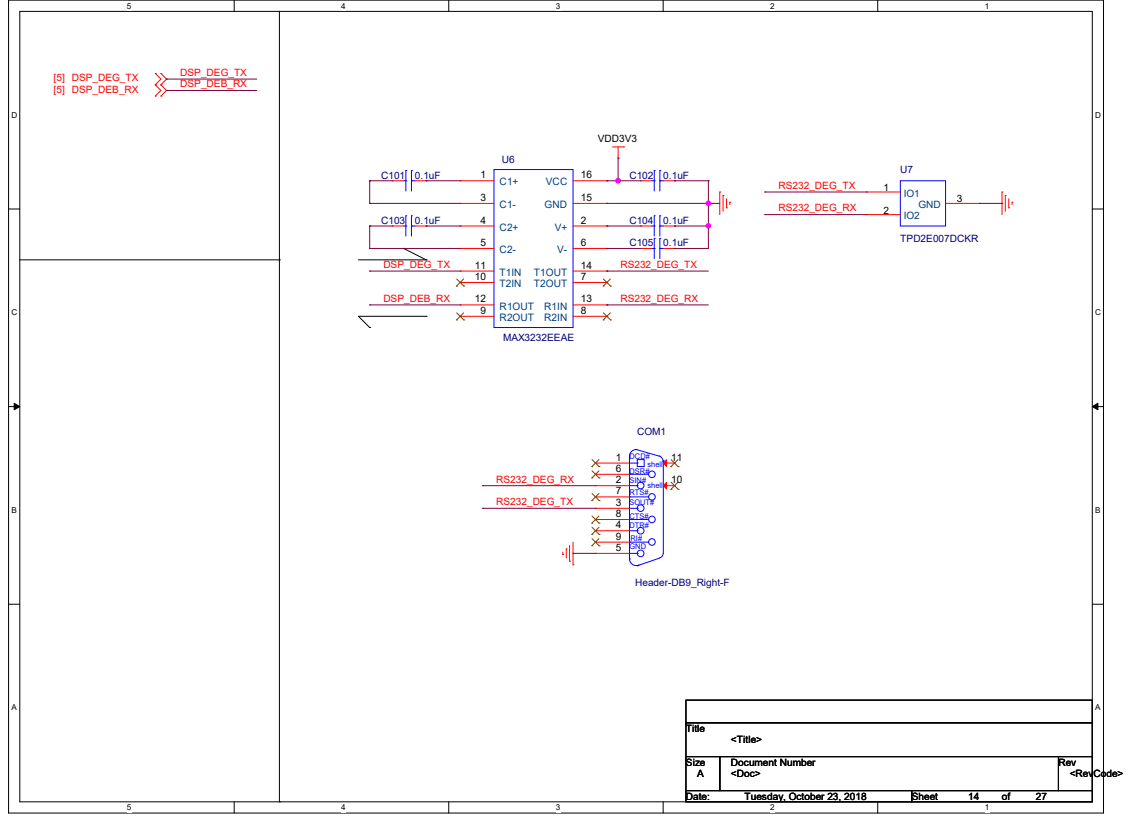
[picture p28: page 14]
[5] DSP_DEB_RX; Title; Size; Document Number; Rev; Date:; Sheet; <Doc>; <RevCode>; <Title>; Tuesday, October 23, 2018; RI# CTS# DSR# DCD# SIN# RTS# SOUT# DTR# shell GND; shell COM1; Header-DB9_Right-F; MAX3232EEAE; T2OUT 7; R2IN 8 R2OUT 9; R1OUT 12; T1OUT 14; GND 15; VCC 16; TPD2E007DCKR; GND; RS232_DEG_RX; RS232_DEG_TX; DSP_DEG_TX; DSP_DEB_RX; DSP_DEG_TX DSP_DEB_RX

## [5] AT24CXX_WP

## [5,23] DSP_SDA

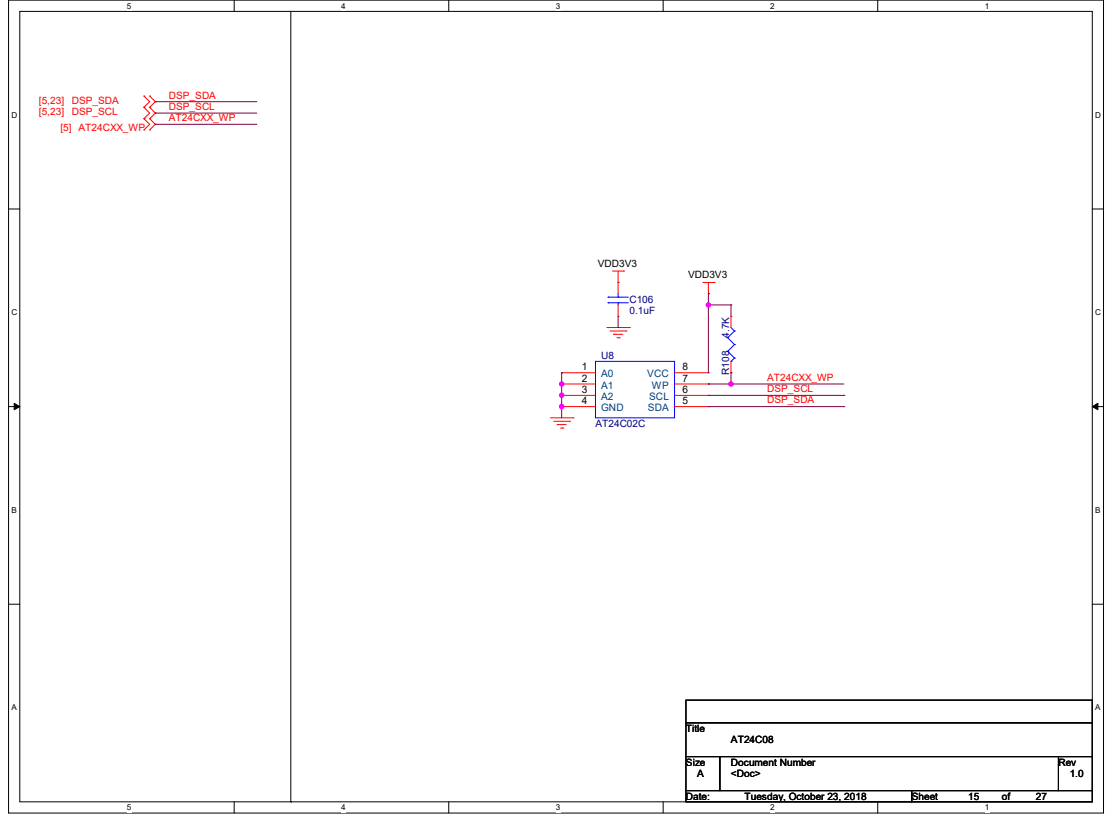
[picture p29: page 15]
VDD3V3; [5,23] DSP_SCL; Title; Size; Document Number; Rev; Date:; Sheet; <Doc>; Tuesday, October 23, 2018; U8 A0 1 A1 2 A2 3 GND 4; VCC 8 WP 7 SCL 6 SDA 5; R¹⁰⁸ ⁴.7K; DSP_SCL DSP_SDA; AT24CXX_WP; DSP_SDA DSP_SCL

# 0.1uF C¹¹³ ¹⁰pF

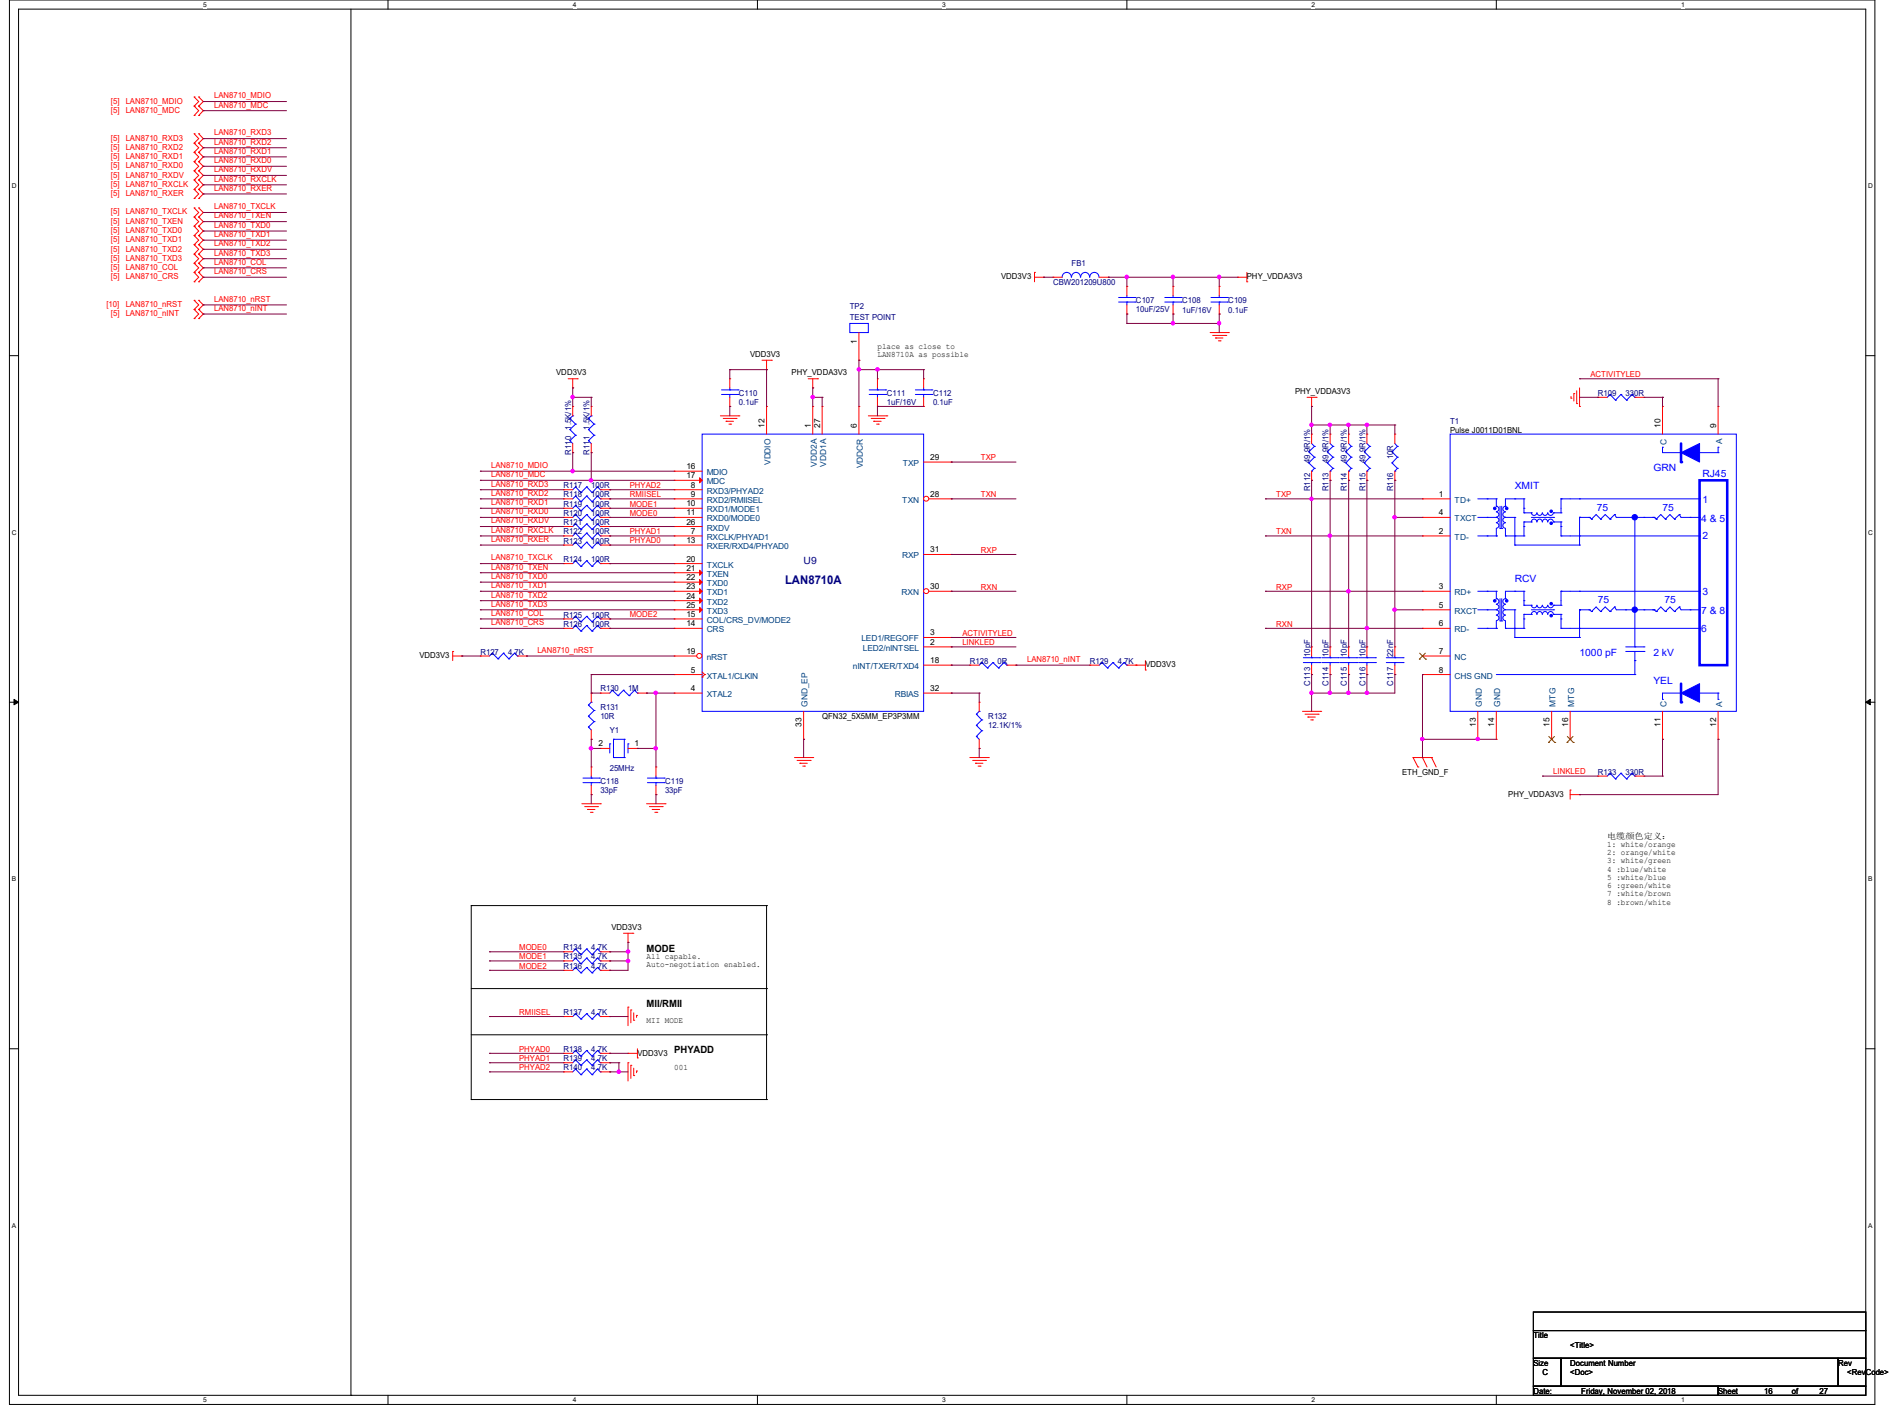
[picture p30: page 16]

place as close to
LAN8710A as possible

6 RXP 31 RXN 30 TXN 28 TXP 29

MDIO 16 MDC 17 RXD3/PHYAD2 8 RXD2/RMIISEL 9 RXD1/MODE1 10 RXD0/MODE0 11 RXDV 26 RXCLK/PHYAD1 7 RXER/RXD4/PHYAD0 13 TXCLK 20 TXEN 21 TXD0 22 TXD1 23 TXD2 24 TXD3 25 COL/CRS_DV/MODE2 15 CRS 14

8 :brown/white PHYADD MII/RMII MODE

## VDD3V3

## VDD3V3

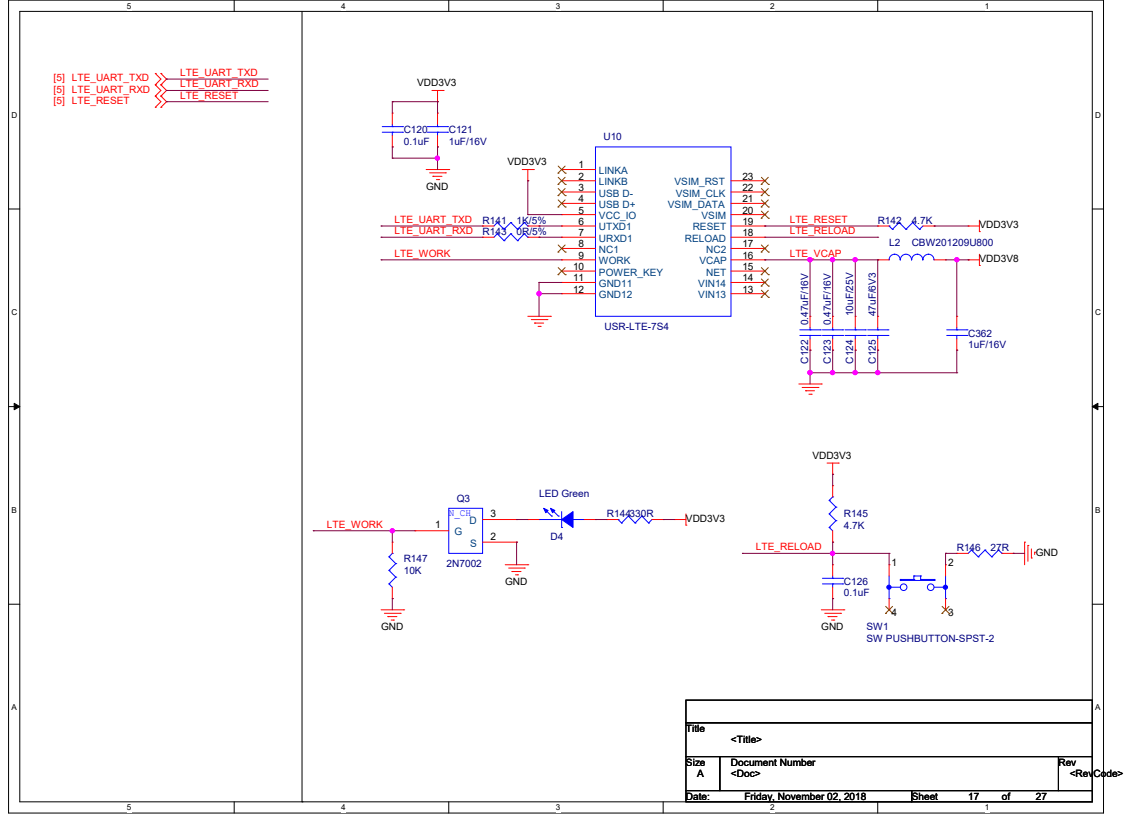
[picture p31: page 17]

VDD3V3 | CAN5V0 CANG0 | CANG0 VDD3V3 | CAN5V0 CANG0 | CANG0 | CAN5V0 VDD5VCANG1 VDD3V3 | CAN5V1 CANG1 | CANG1 VDD3V3 | CAN5V1 CAN5V1 VDD5V | CANG1 CANG2 VDD3V3 | CAN5V2 CANG2 | CANG2 VDD3V3 | CAN5V2 CAN5V2 VDD5V | CANG2 CANG3 VDD3V3 | CAN5V3 CANG3 | CANG3 VDD3V3 | CAN5V3 CAN5V3 VDD5V | CANG3
CANG4 VDD3V3 | CAN5V4 CANG4 | CANG4 VDD3V3 | CAN5V4 CAN5V4 VDD5V | CANG4 CANG5 VDD3V3 | CAN5V5 CANG5 | CANG5 VDD3V3 | CAN5V5 CAN5V5 VDD5V | CANG5 CANG6 VDD3V3 | CAN5V6 CANG6 | CANG6 VDD3V3 | CAN5V6 CAN5V6 VDD5V | CANG6 CANG7 VDD3V3 | CAN5V7 CANG7 | CANG7 VDD3V3 | CAN5V7 CAN5V7 VDD5V | CANG7

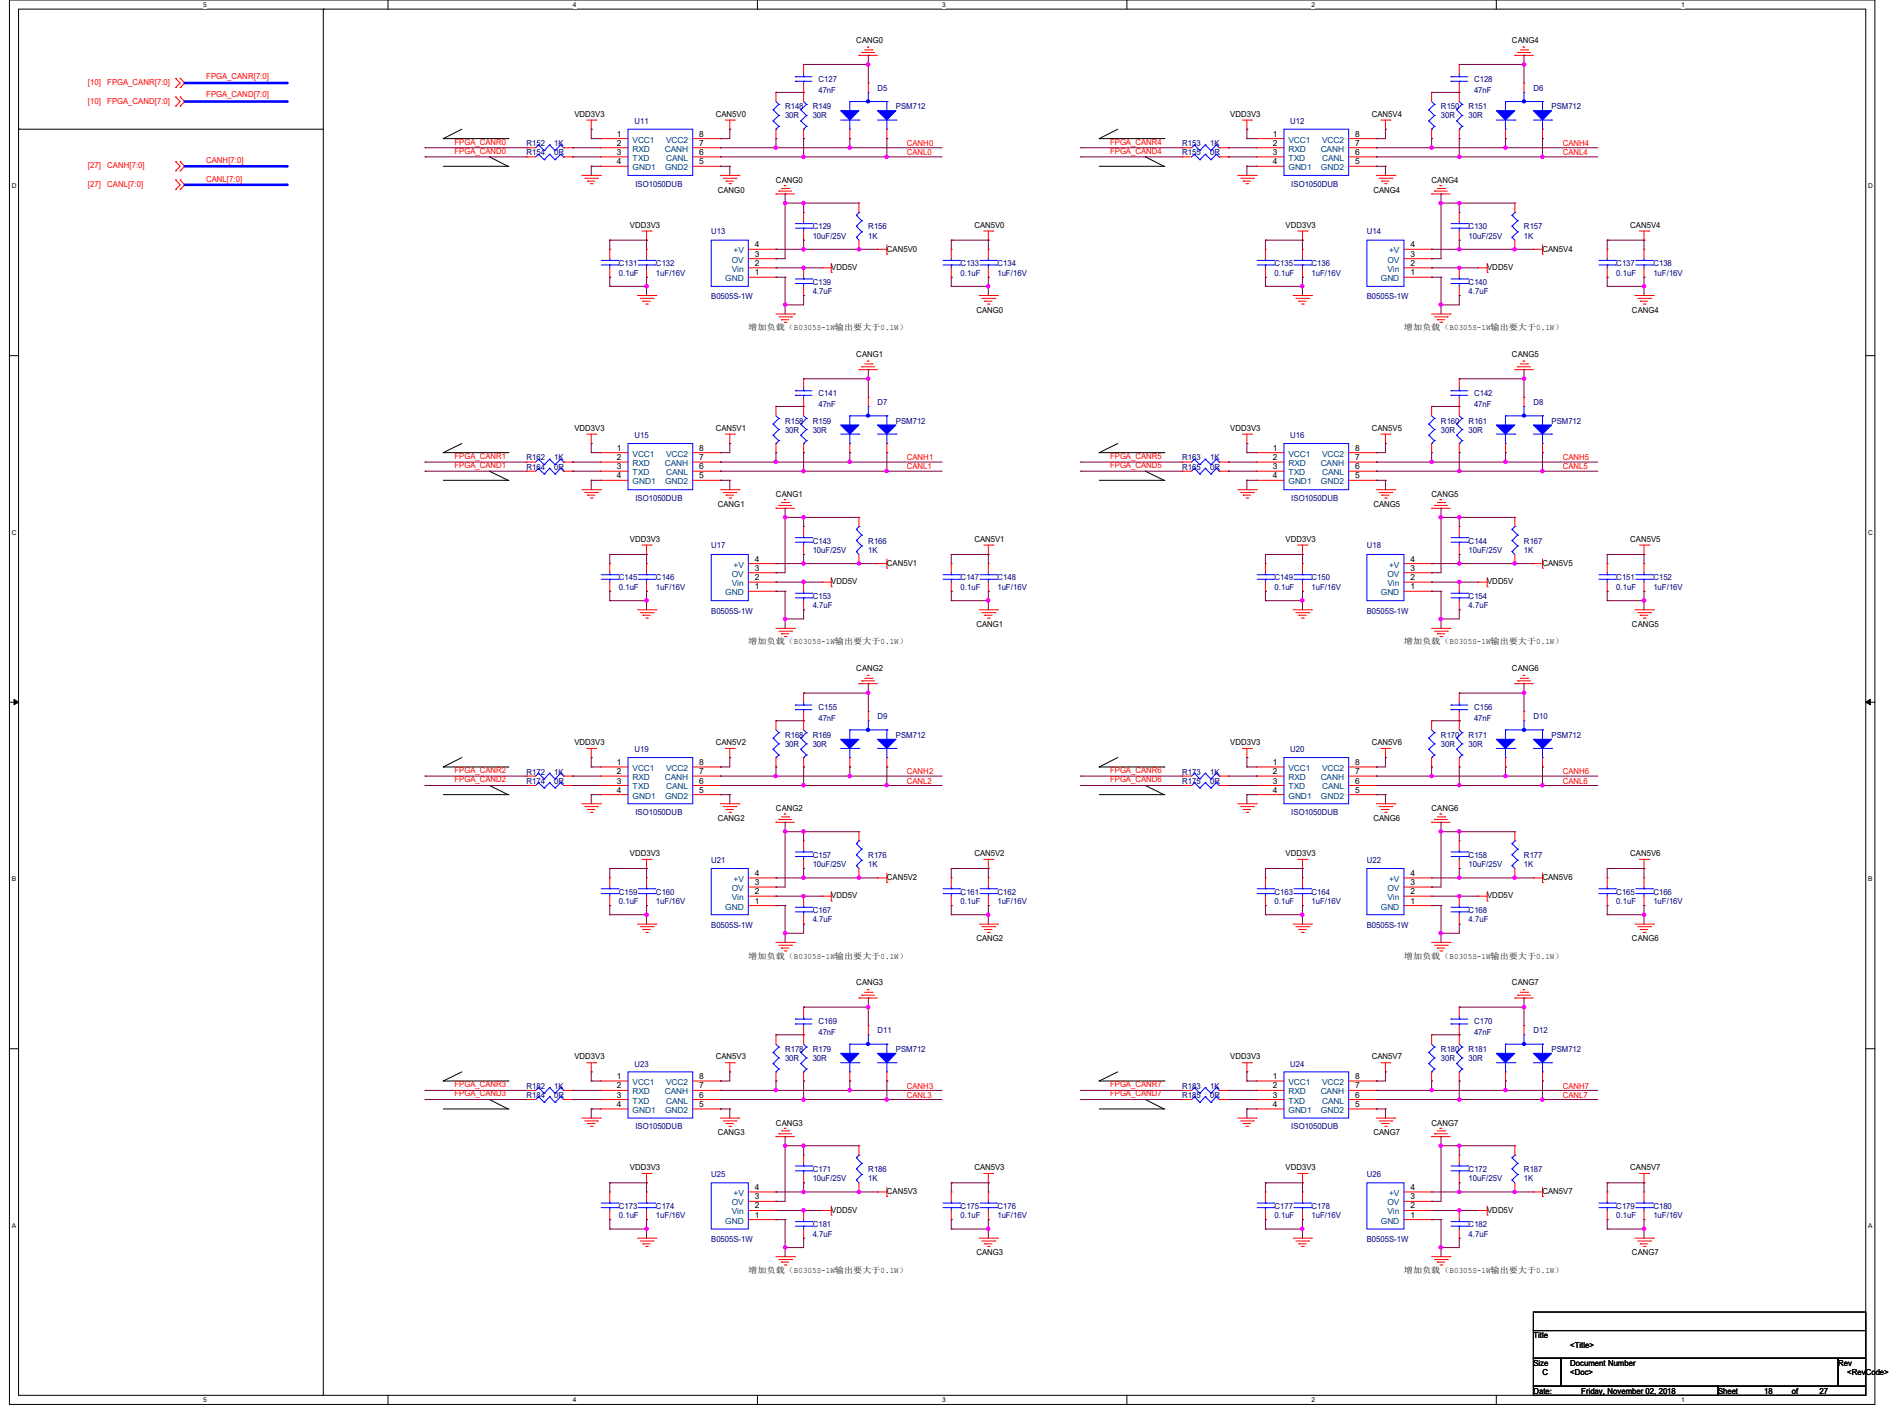
[picture p32: page 18]

VDD3V3 VDD3V3 | VDD3V3 VDD3V3 | VDD3V3 VDD3V3
VDD3V3 VDD3V3 | VDD3V3 VDD3V3 | VDD3V3 VDD3V3

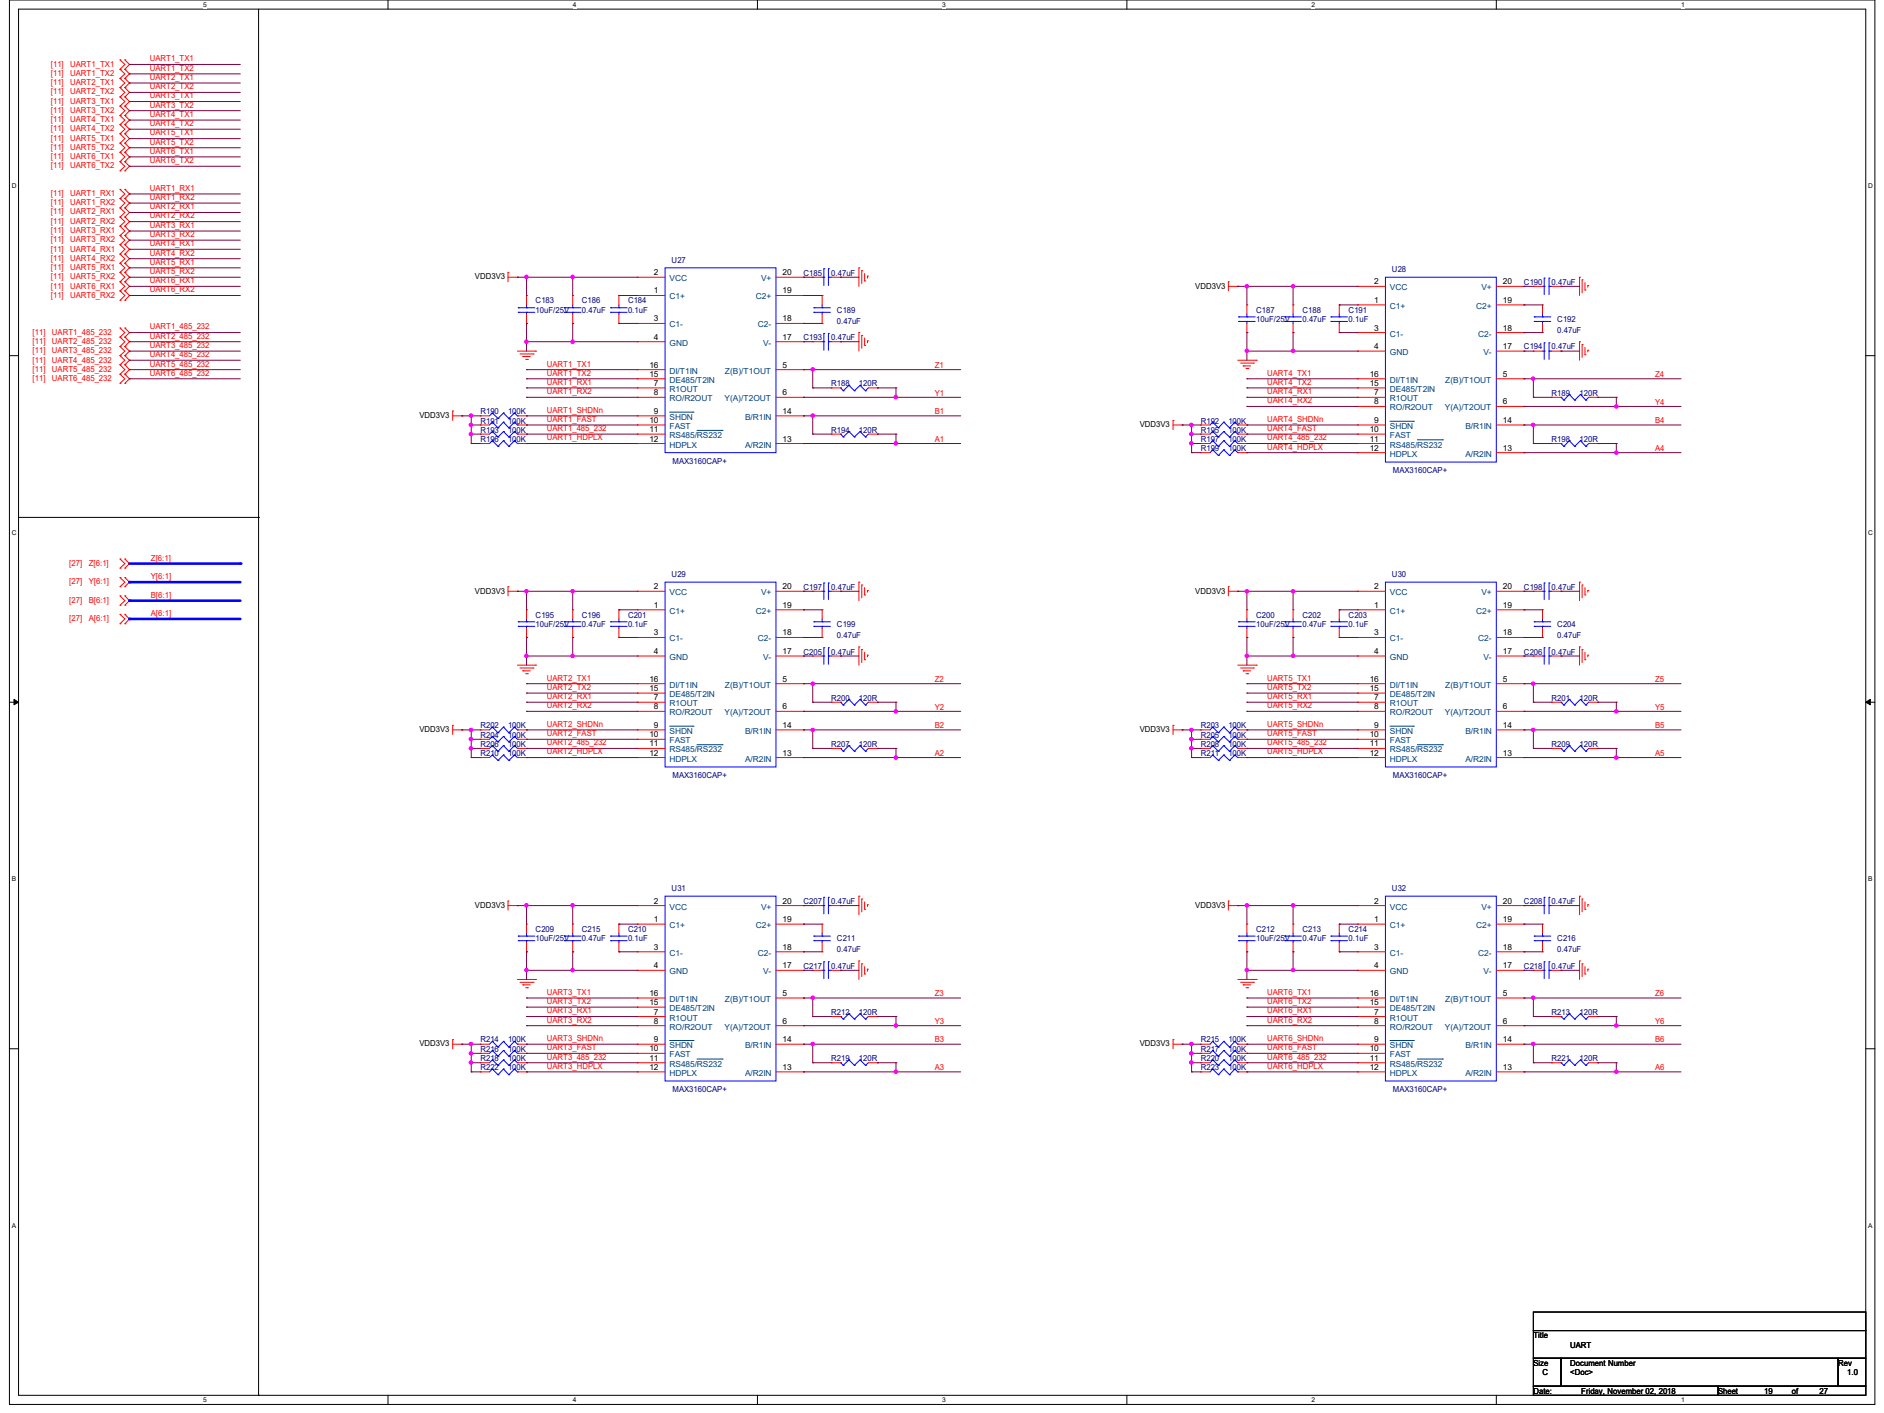
[picture p33: page 19]

# F_RELAY_DET[16:1] F_RELAY_CON[16:1] F_RELAY_OEn[2:1] RELAY_CON[16:1] RELAY_DET[16:1]

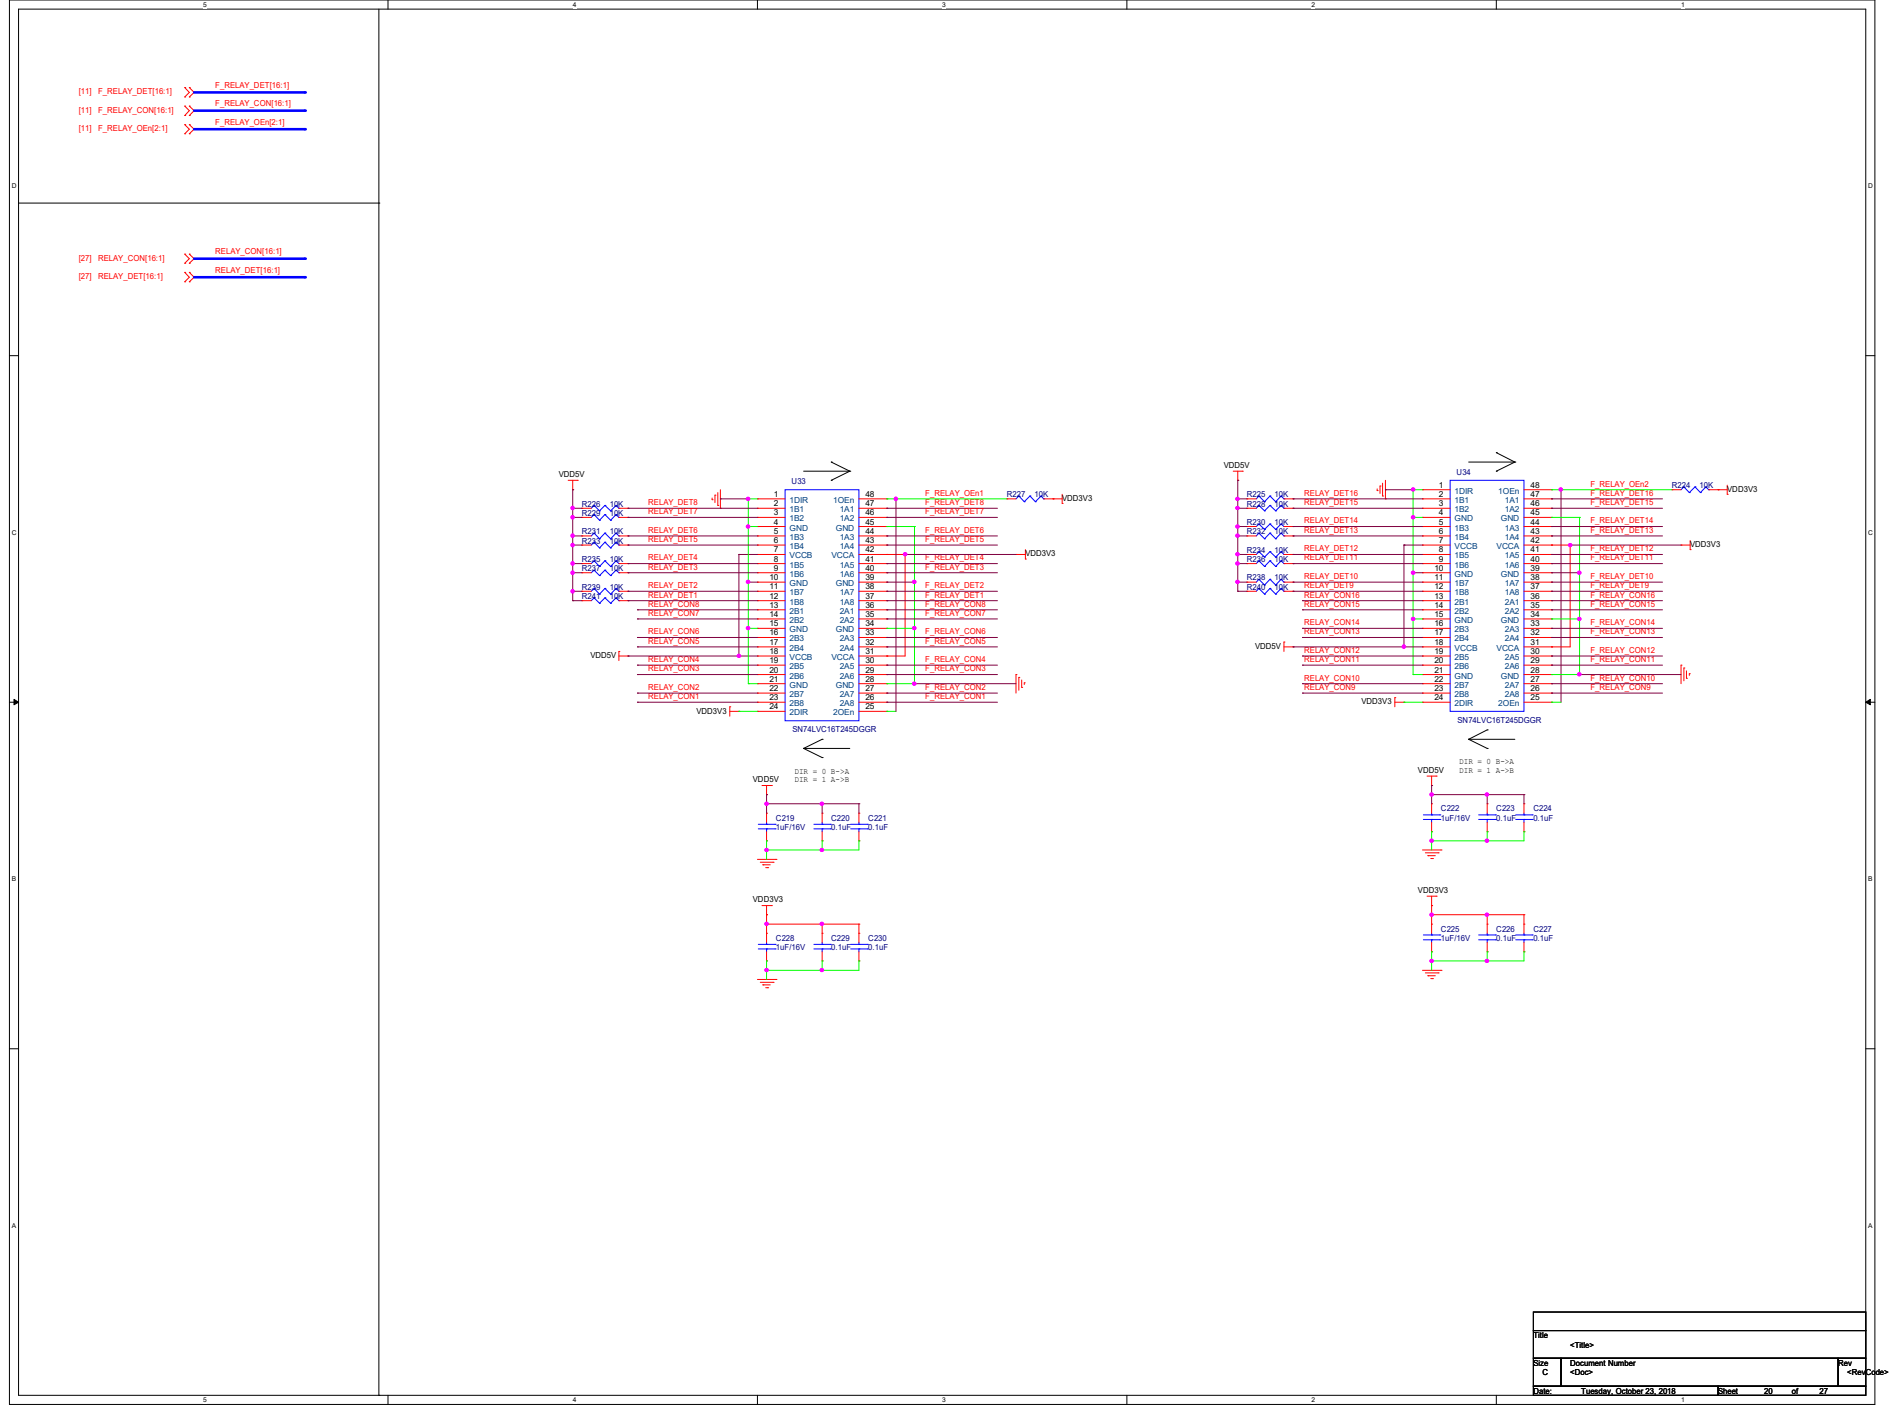
[picture p34: page 20]

# R252 4.7K R249 4.7K R253 4.7K R245 4.7K R254 4.7K R250 4.7K

# R242 4.7K R256 4.7K R251 4.7K R247 4.7K R257 4.7K

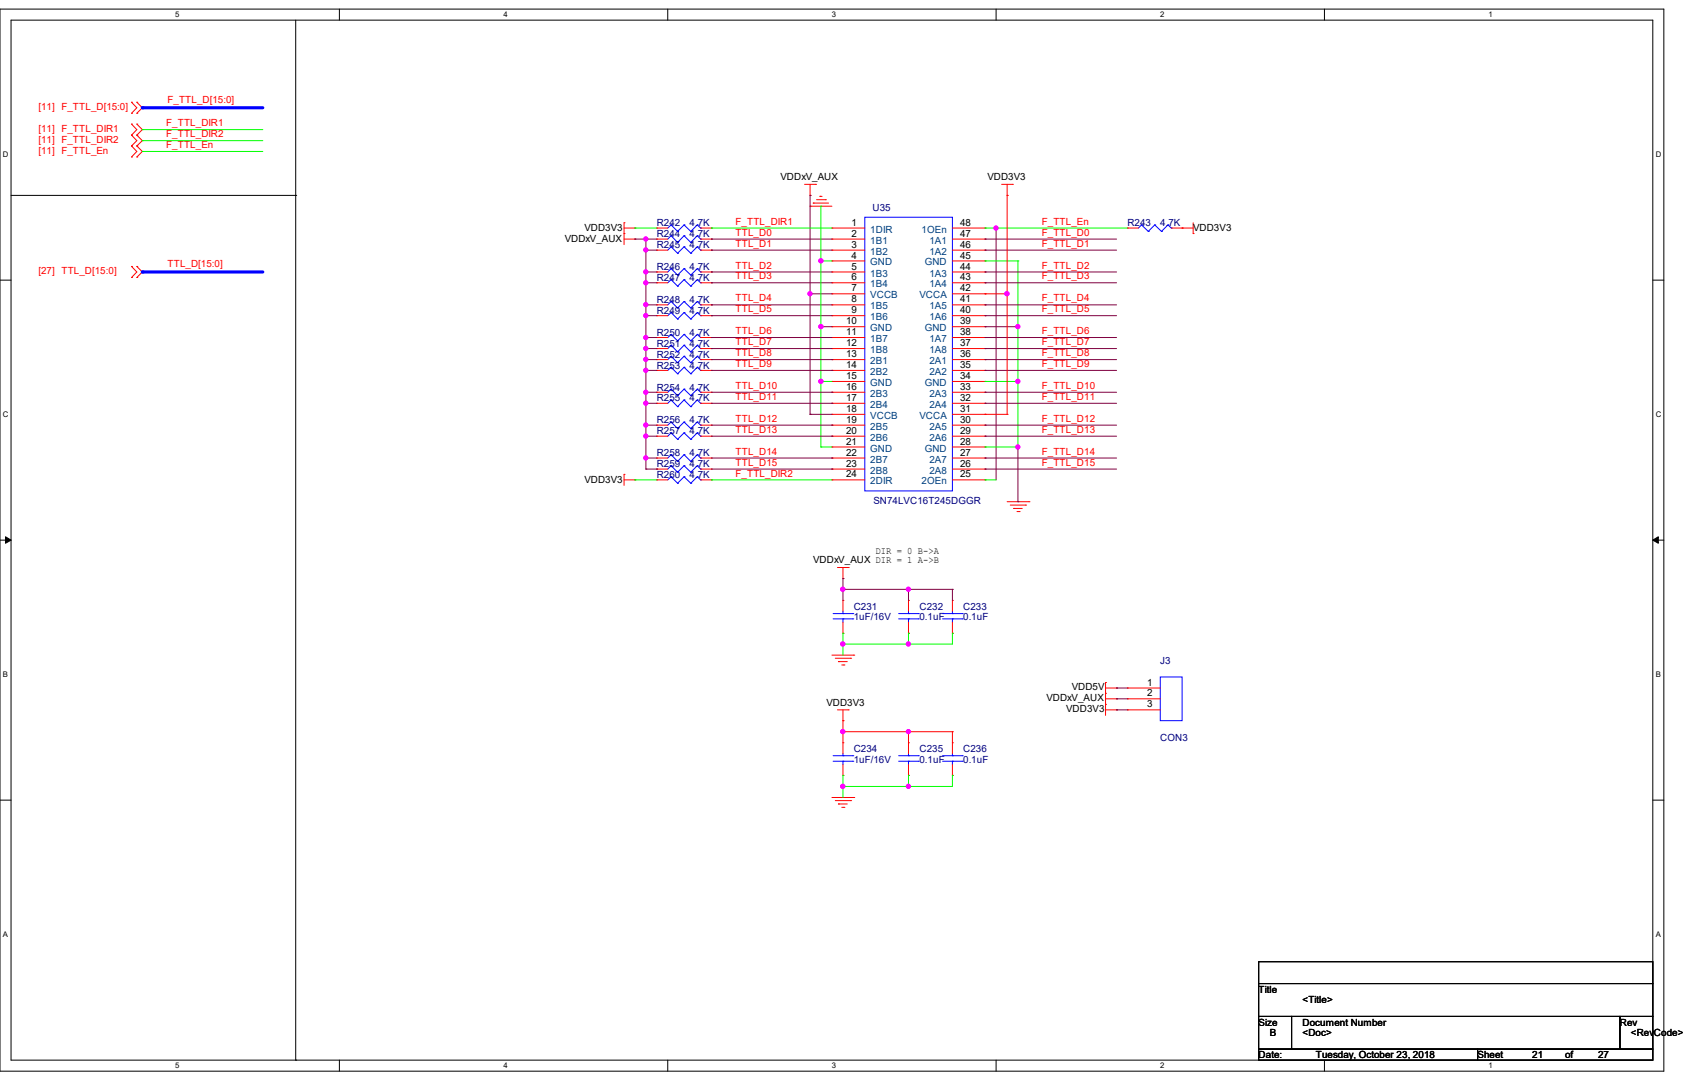
[picture p35: page 21]

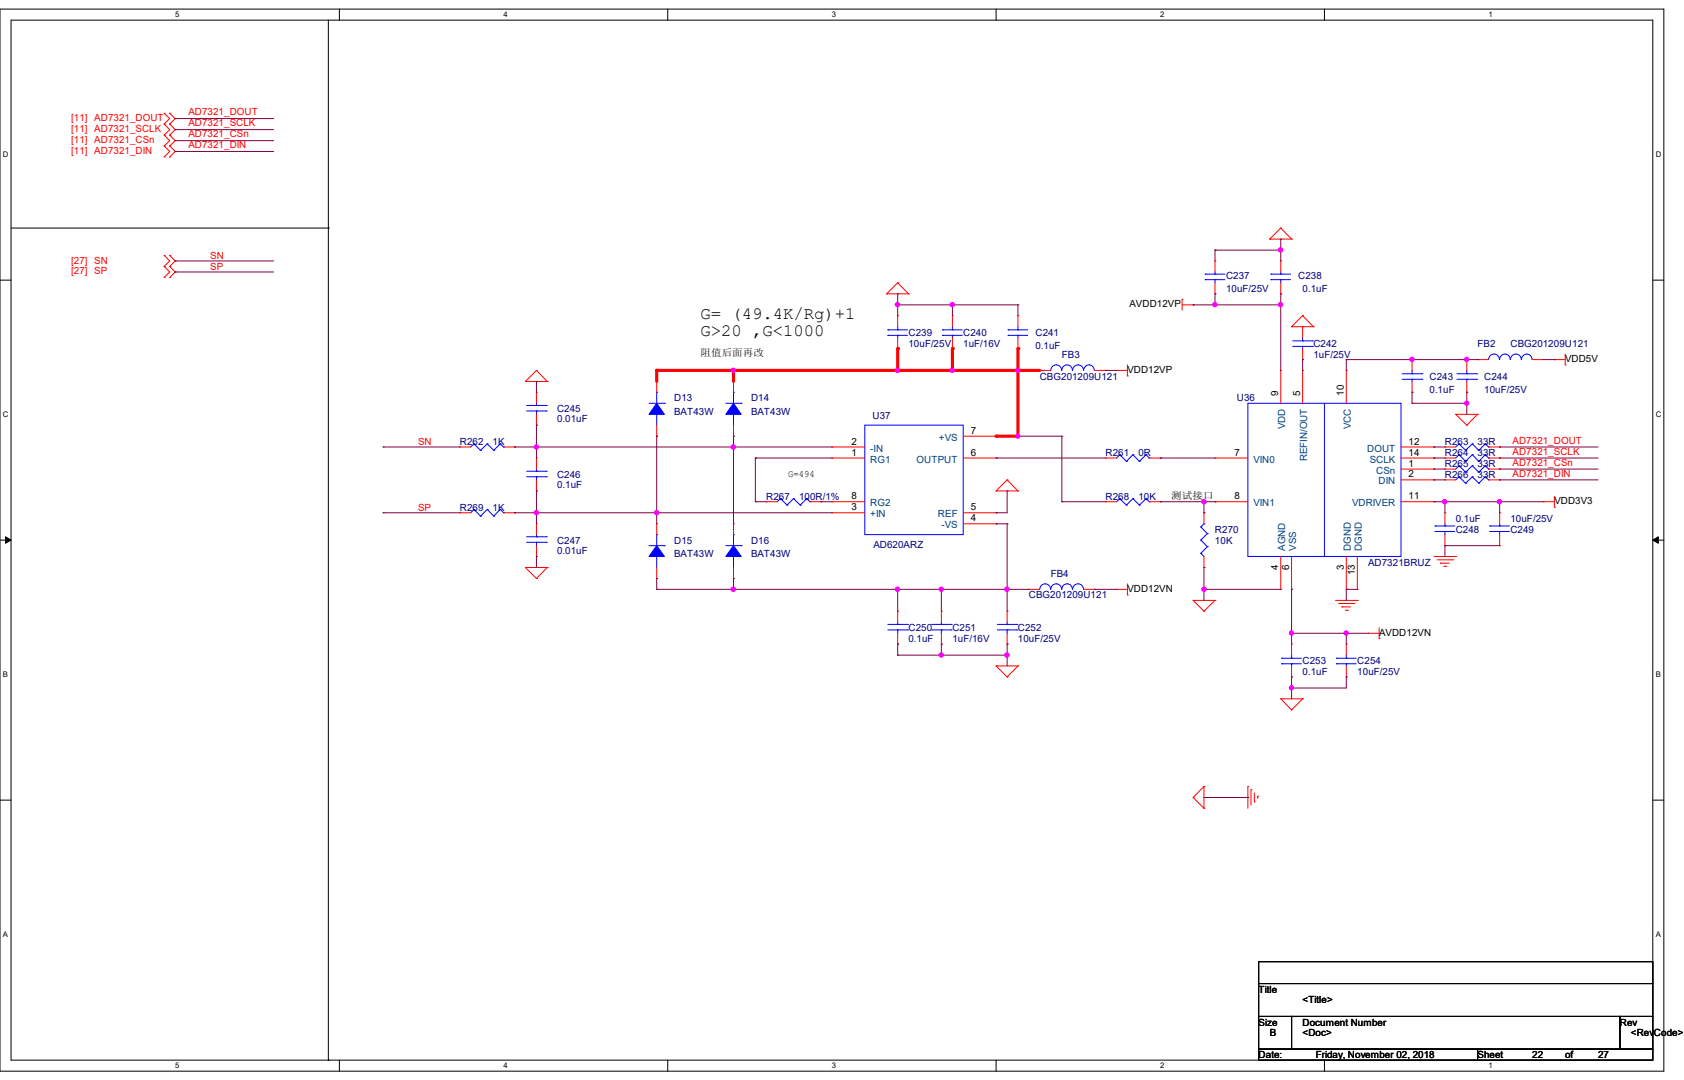
[picture p36: page 22]

9 VCC 10 VDRIVER 11 DOUT 12 DGND 13 SCLK 14 C254

## [5,15] DSP_SDA [5,15] DSP_SCL

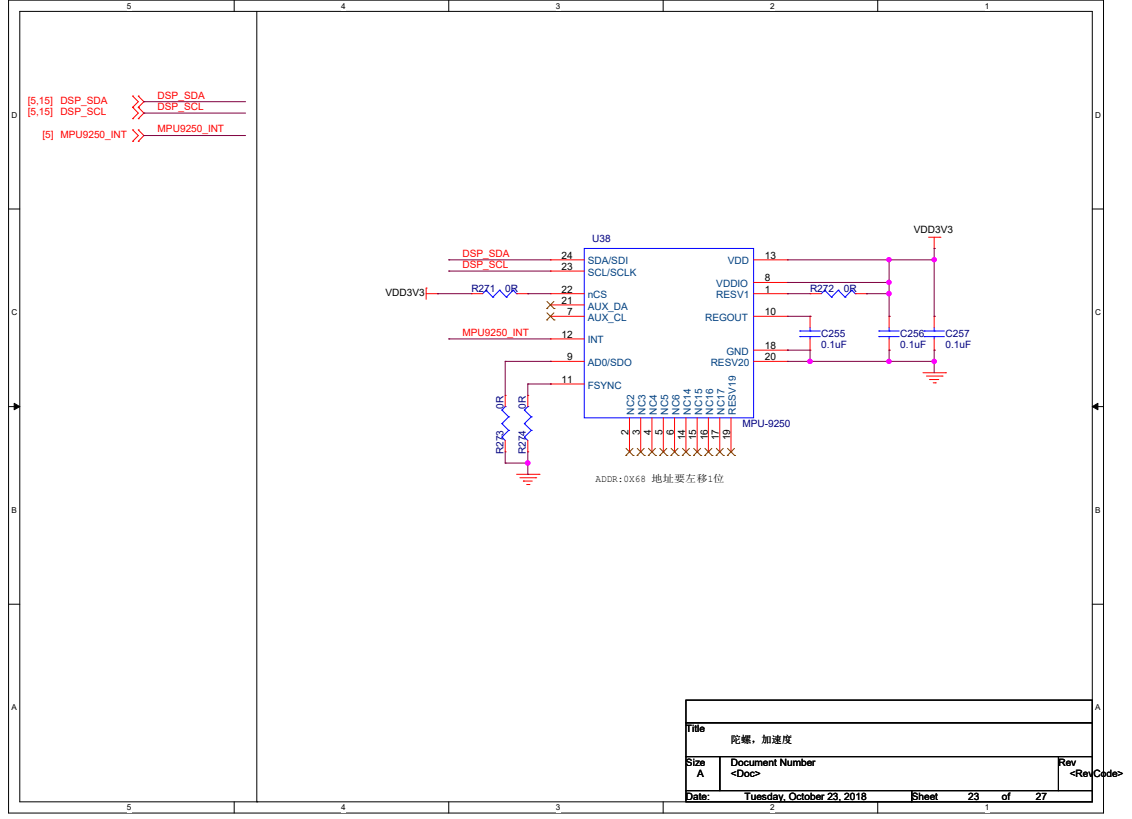
[picture p37: page 23]
ADDR:0X68 地址要左移1位; VDD3V3; [5] MPU9250_INT; Title; Size; Document Number; Rev; Date:; Sheet; <Doc>; <RevCode>; 陀螺，加速度; Tuesday, October 23, 2018; MPU-9250; RESV1; 1 NC²; AUX_CL 7; VDDIO; AD0/SDO 9; REGOUT; FSYNC 11; INT 12; VDD; 13 NC¹⁴ 14 NC¹⁵ 15 NC¹⁶ 16 NC¹⁷ 17; GND; 18 RESV¹⁹ 19; RESV20; AUX_DA 21; nCS 22; SCL/SCLK 23; SDA/SDI 24 R²⁷⁴ ⁰R; C256 0.1uF R²⁷³ ⁰R; DSP_SDA DSP_SCL; MPU9250_INT; DSP_SCL; DSP_SDA

## DSP 1.2V OSCILLATOR

## DSP Oscillator frequency range 12MHz~30MHz

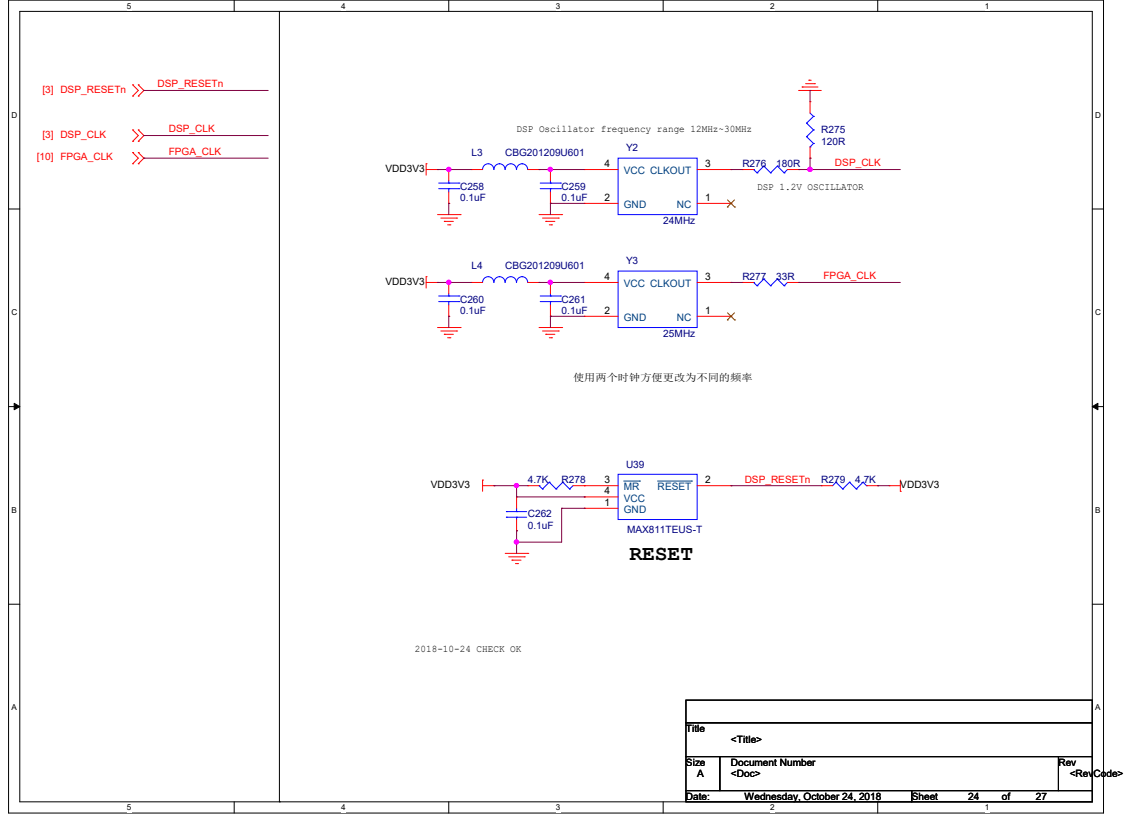
[picture p38: page 24]

# D18 SMAJ26A C273

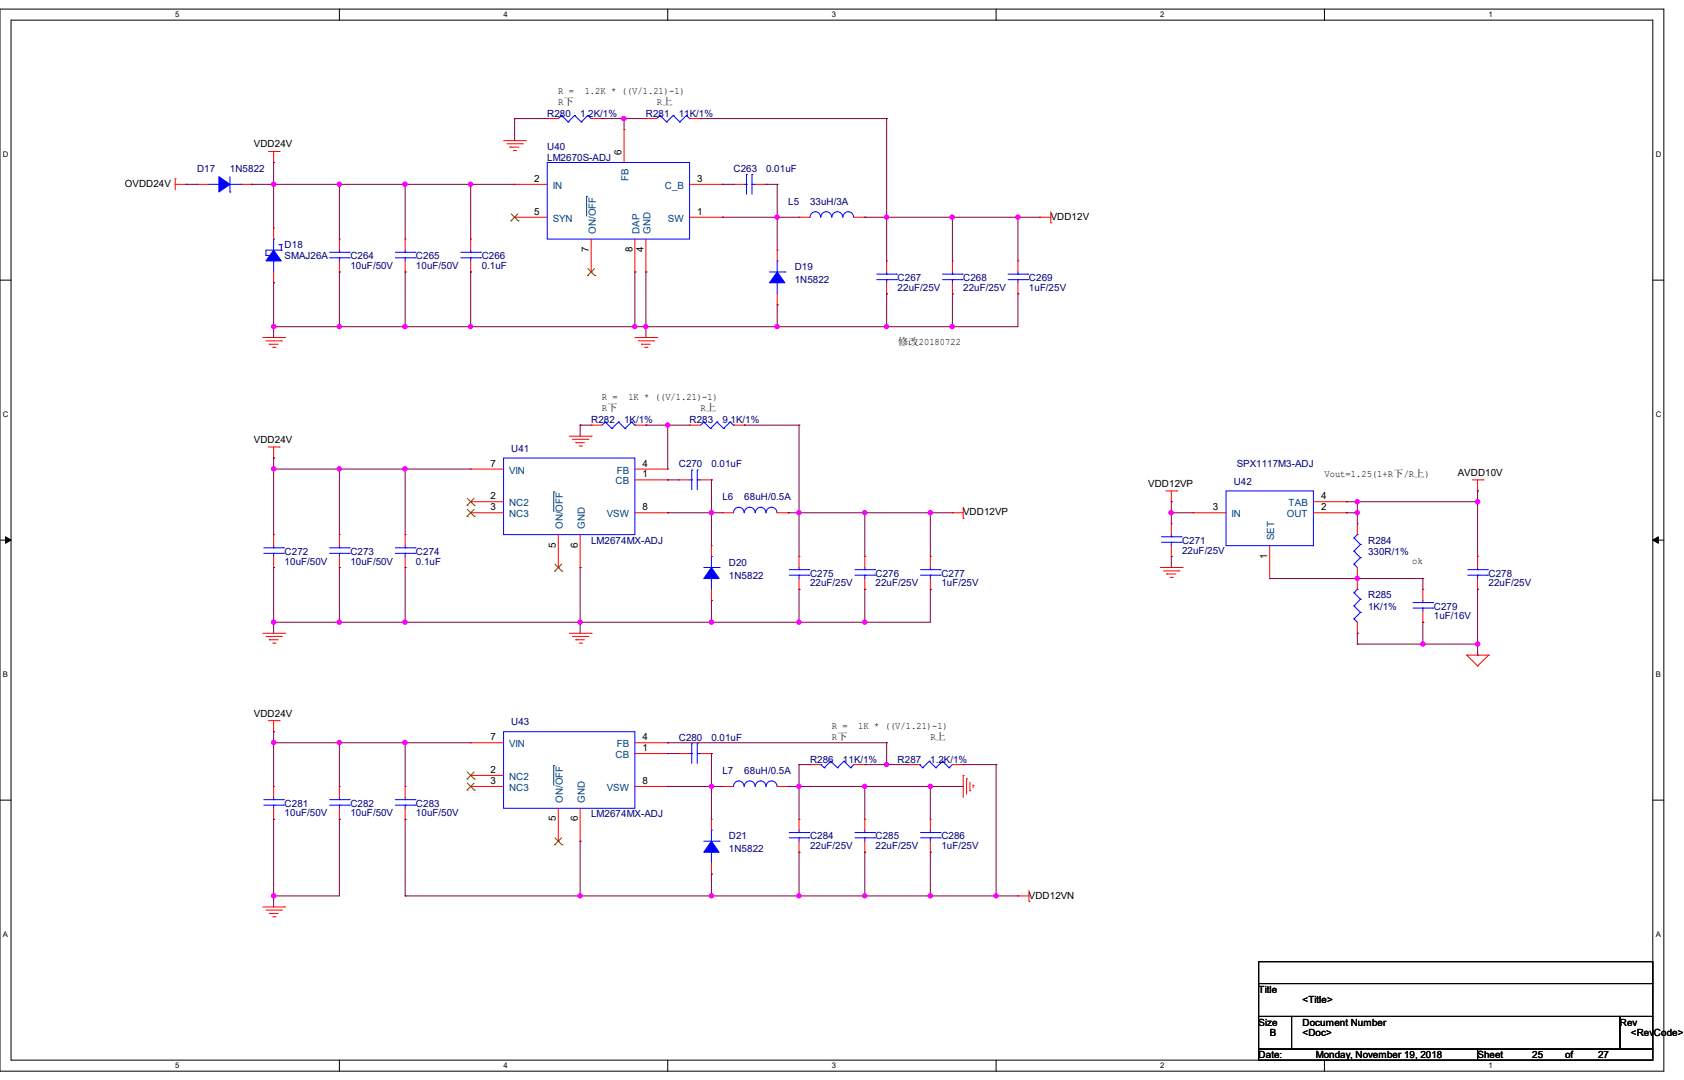
[picture p39: page 25]

注意：VIN>VOUT | 3.3V 4A
COMP1 | B7 COMP2 | E7 COMP3 | H7 COMP4 | L7

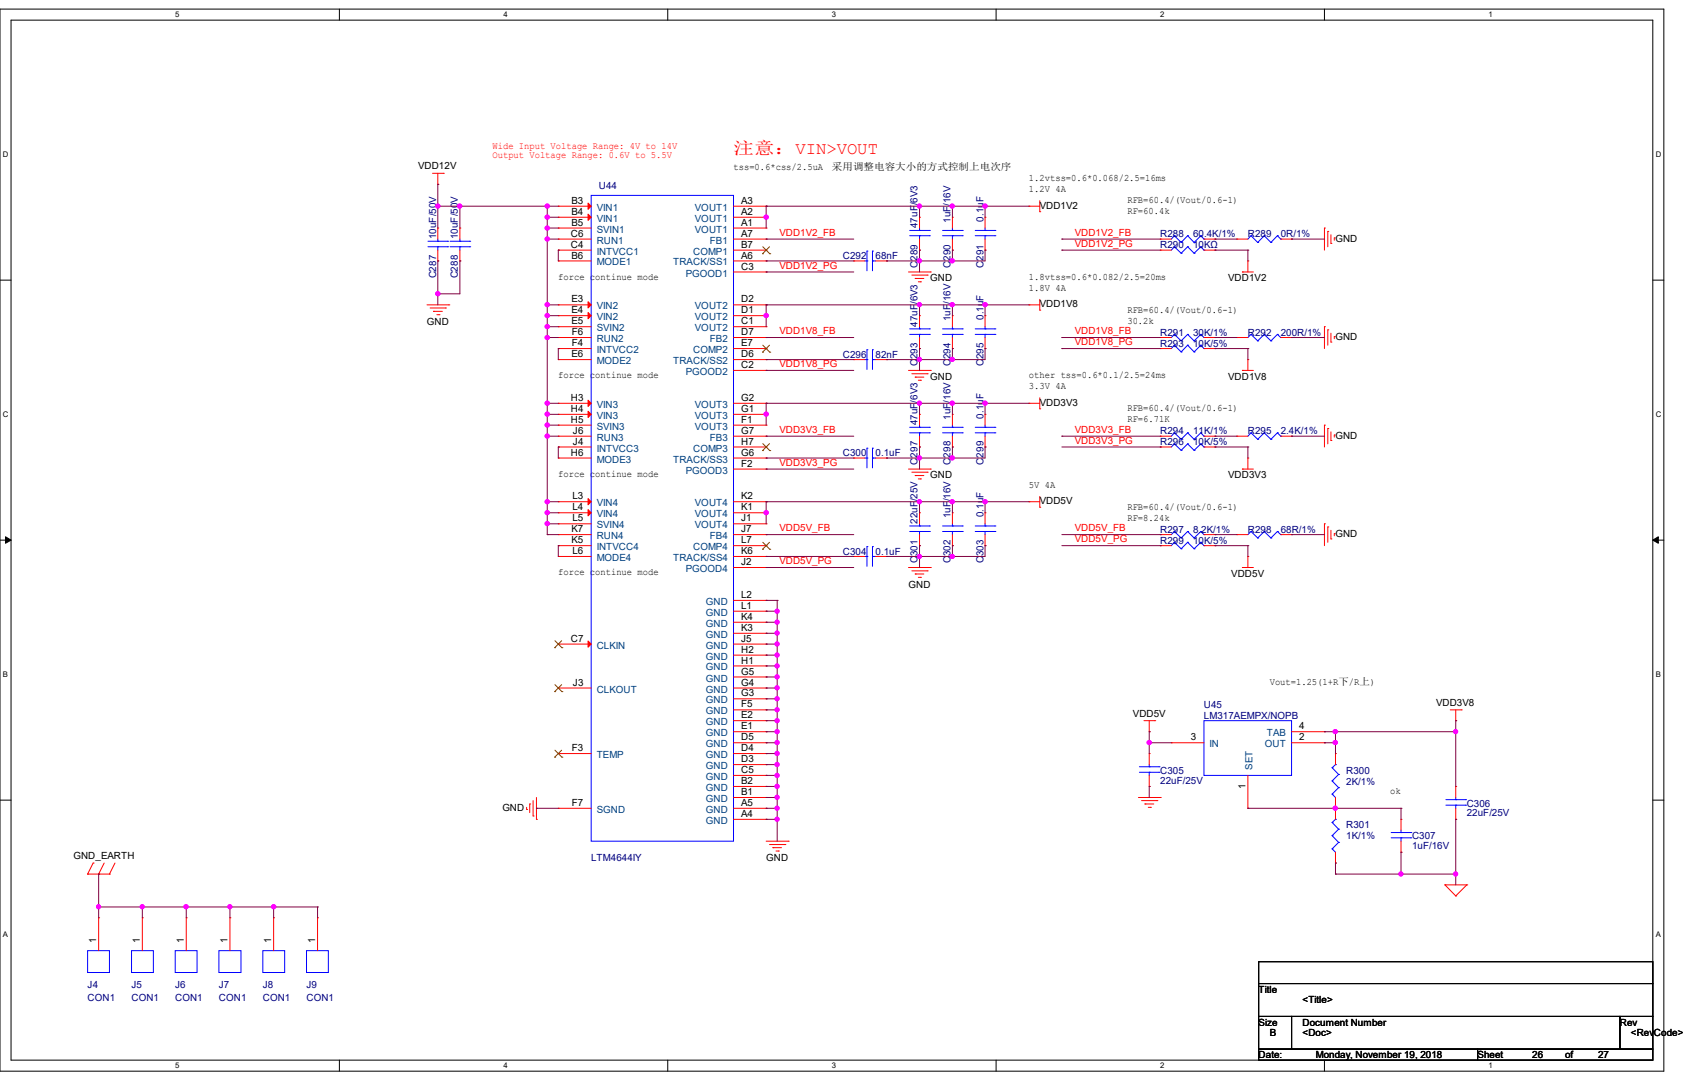
[picture p40: page 26]

Wide Input Voltage Range: 4V to 14V
Output Voltage Range: 0.6V to 5.5V

22uF/25V C²⁹⁸ ¹uF/16V
R297 8.2K/1% C²⁹⁷ ⁴⁷uF/6V³ C³⁰¹ ²²uF/25V

# J11 CON20A

# J10 CON40A

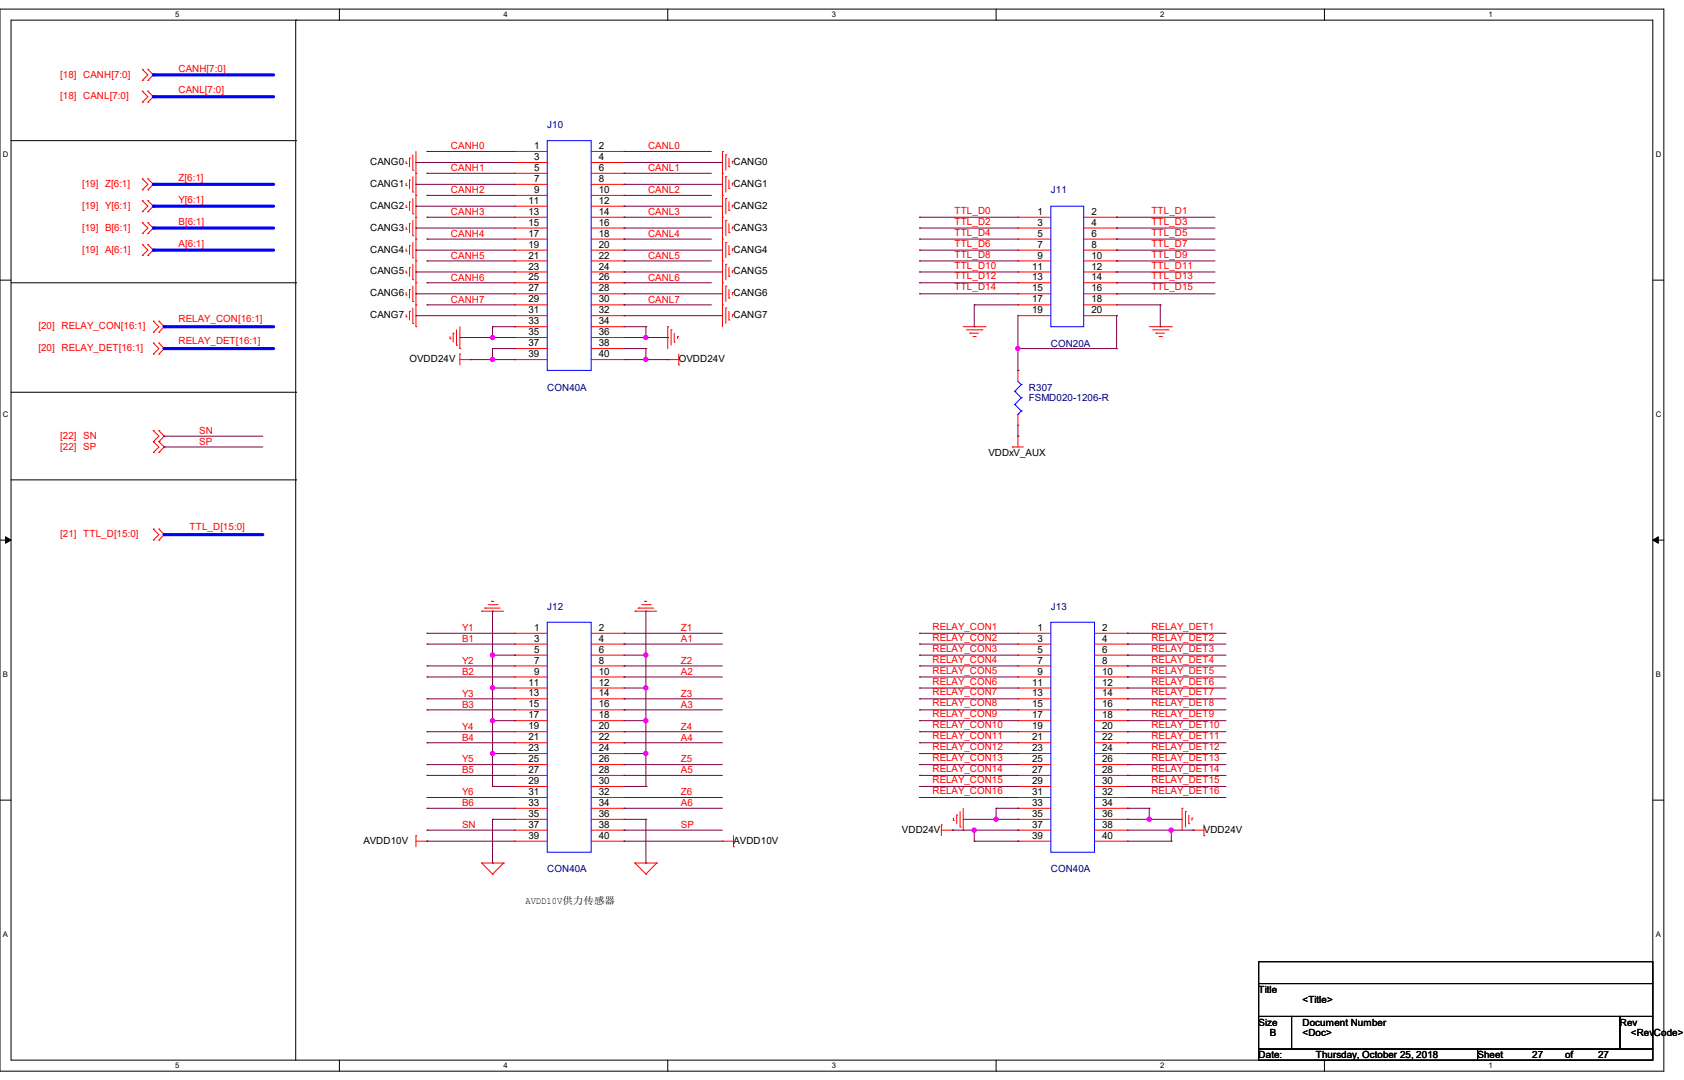
[picture p41: page 27]
A A AVDD10V供力传感器; CANG0 CANG1 CANG2 CANG3 CANG4 CANG5 CANG6 CANG7; AVDD10V; VDD24V; VDDxV_AUX OVDD24V; OVDD24V; [18] CANH[7:0]; [18] CANL[7:0]; [20] RELAY_CON[16:1]; [20] RELAY_DET[16:1]; [21] TTL_D[15:0]; Title Size; Document Number; Rev Date:; Sheet; of <Doc>; <RevCode>; <Title> B; Thursday, October 25, 2018; 27 Title Size; J12 CON40A; J13 CON40A; R307 FSMD020-1206-R; CANH[7:0]; CANL[7:0]; CANH0; CANL0 CANH1; CANL1 CANH2; CANL2 CANH3; CANL3 CANH4; CANL4 CANH5; CANL5 CANH6; CANL6 CANH7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
