donggua127/control_board/doc/3.0sch/JSFS_INT_V2.pdf

5

4

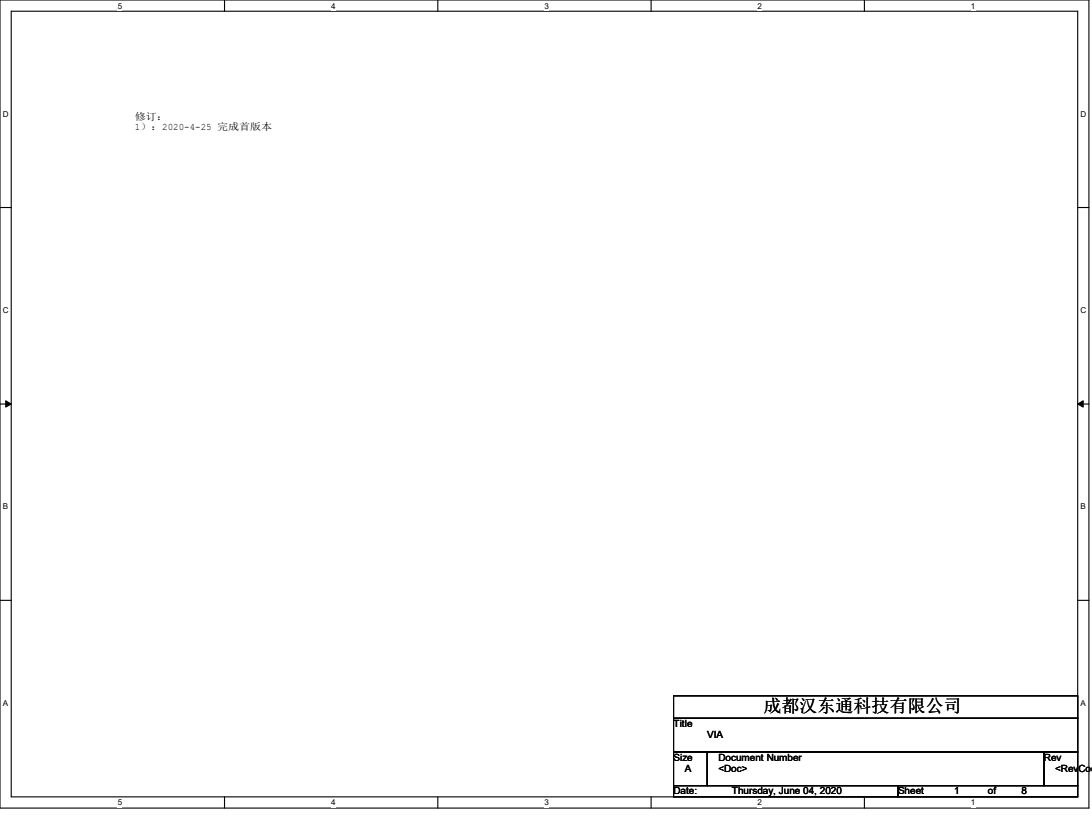
[picture p42: page 1]
修订： 1）：2020-4-25 完成首版本; Title Size; Document Number; Rev Date:; Sheet; of <Doc>; <RevCode> VIA; Thursday, June 04, 2020; 成都汉东通科技有限公司 Title Size; 成都汉东通科技有限公司

VBAT 6 | PC13-RTC_AF1 7 PC14-OSC32_IN 8 PC15-OSC32_OUT | 9 VSS_10 10 VDD_11 11 PH0-OSC_IN 12 PH1-OSC_OUT 13 | NRST | 14
PC0 15 PC1 16 PC2 17 PC3 18 VDD_19 19 VSSA 20 VREF+ 21 VDDA 22 PA0-WKUP 23 PA1 24 PA2 25 PA3 26 VSS_27 27 VDD_28 28 PA4 29 PA5 30 PA6 31 PA7 32 | PC4 33 PC5 34 PB0 35 PB1 36 PB2 37 | PE7 38 PE8 39 PE9 40 PE10 41 PE11 42 PE12 43 PE13 44 PE14 45 PE15 46 PB10 47 PB11 48

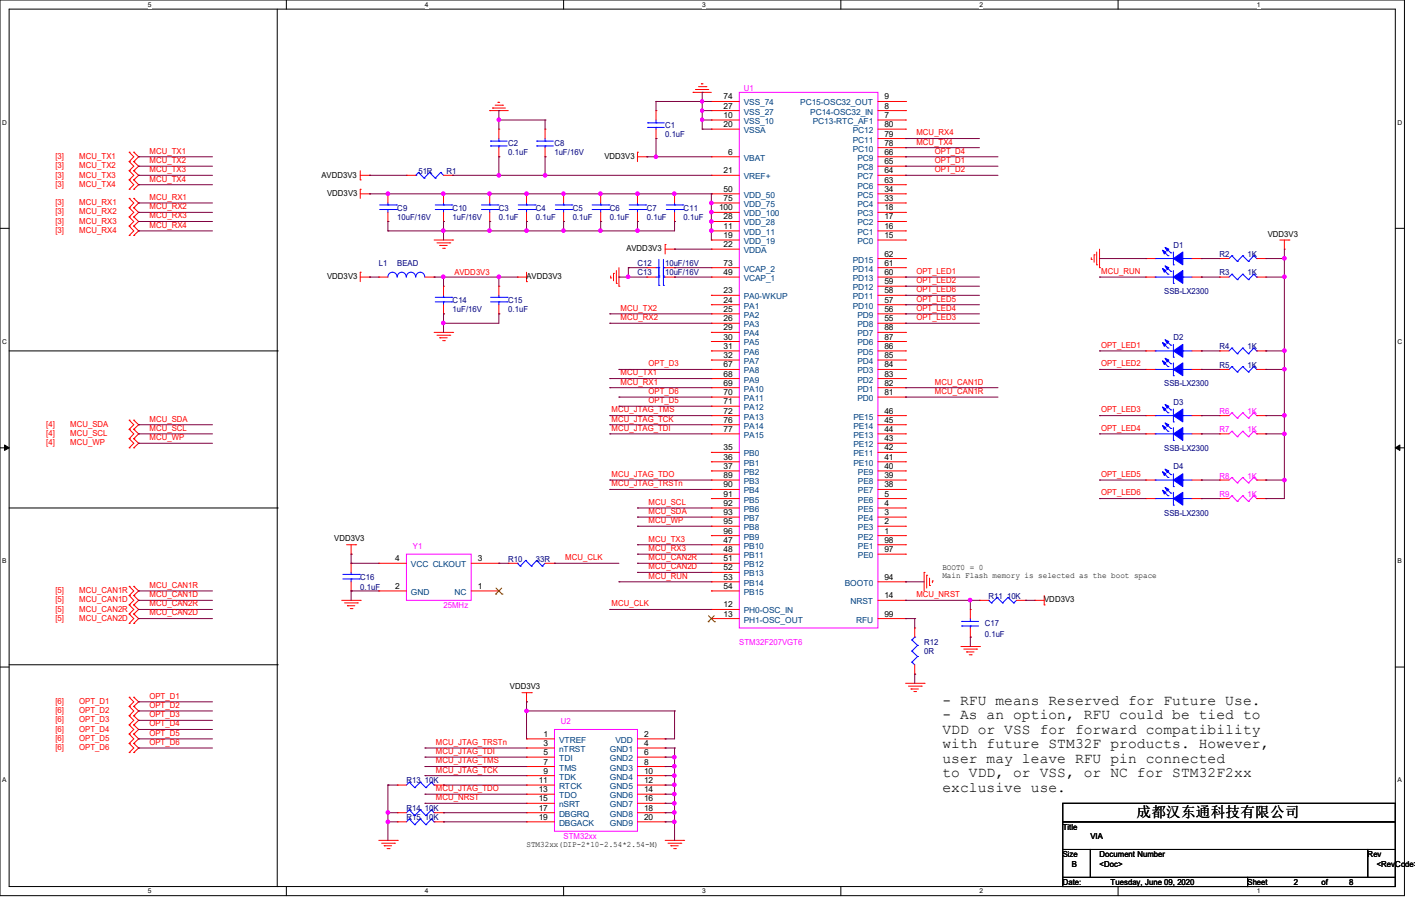
[picture p43: page 2]

Main Flash memory is selected as the boot space

- RFU means Reserved for Future Use.
- As an option, RFU could be tied to
VDD or VSS for forward compatibility
with future STM32F products. However,
user may leave RFU pin connected
to VDD, or VSS, or NC for STM32F2xx

# J1CON3

# J3CON3

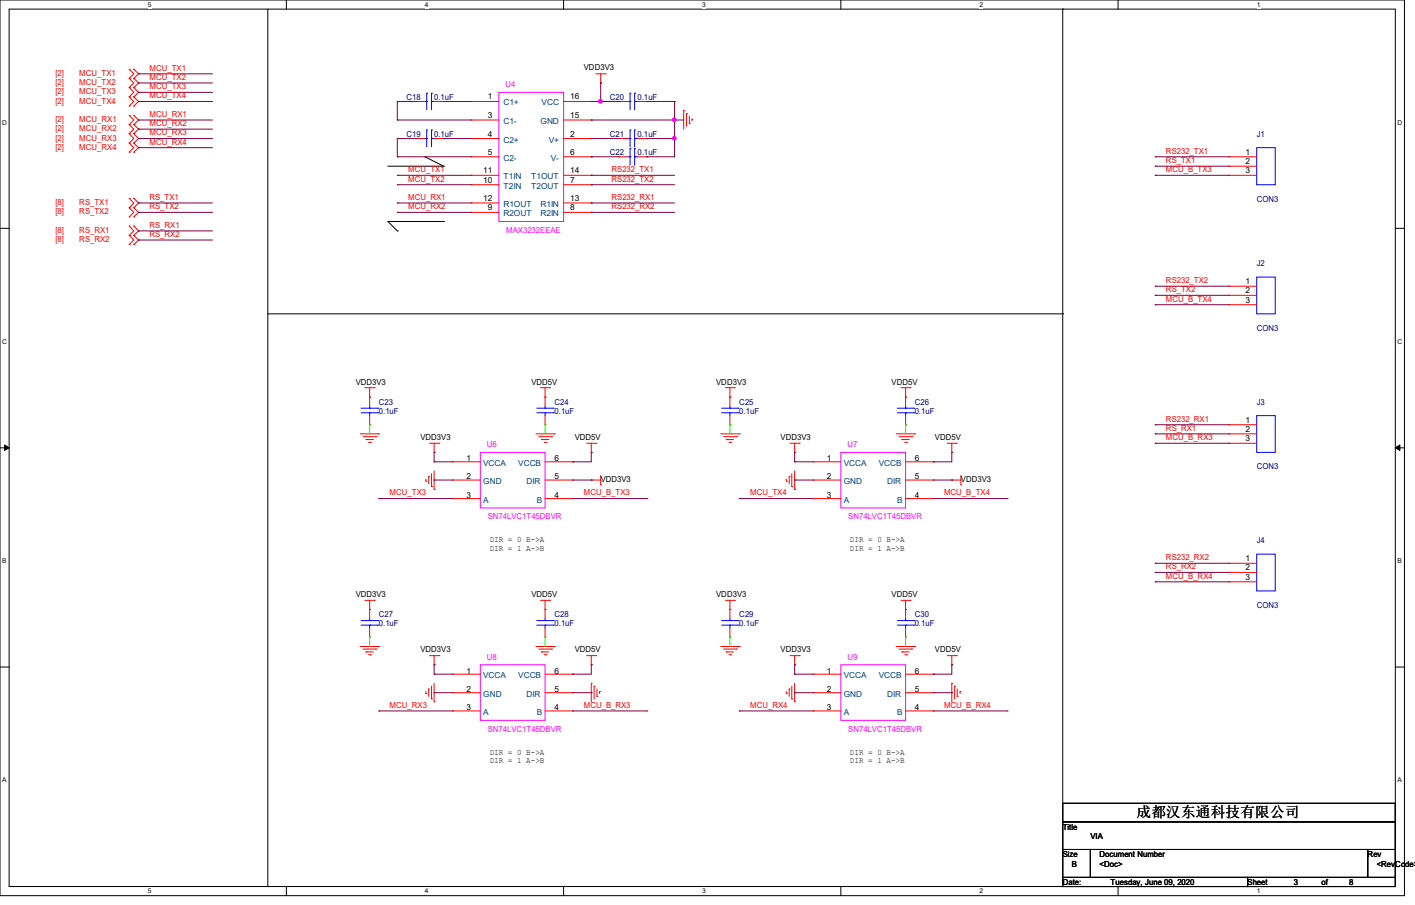
[picture p44: page 3]

C C

VDD3V3 | VDD3V3

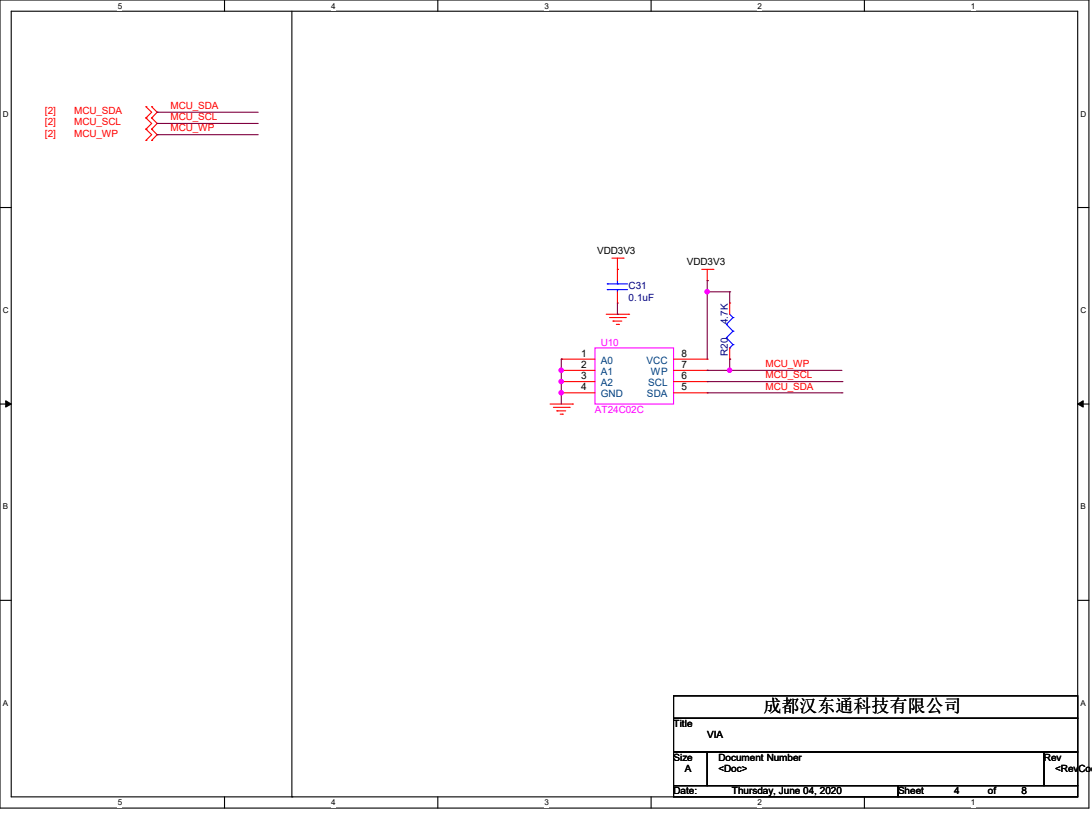
[picture p45: page 4]
[2] MCU_SDA [2] MCU_SCL [2] MCU_WP; Title Size; Document Number; Rev Date:; Sheet; of <Doc>; <RevCode> VIA; Thursday, June 04, 2020; 成都汉东通科技有限公司 Title Size; 成都汉东通科技有限公司; GND 4; VCC; 7 SCL; 6 SDA; R²⁰ ⁴.7K; MCU_WP MCU_SCL MCU_SDA; MCU_SDA MCU_SCL MCU_WP

# 10uF/25V U14 B0305S-1W

# 1uF/16V R27 0R

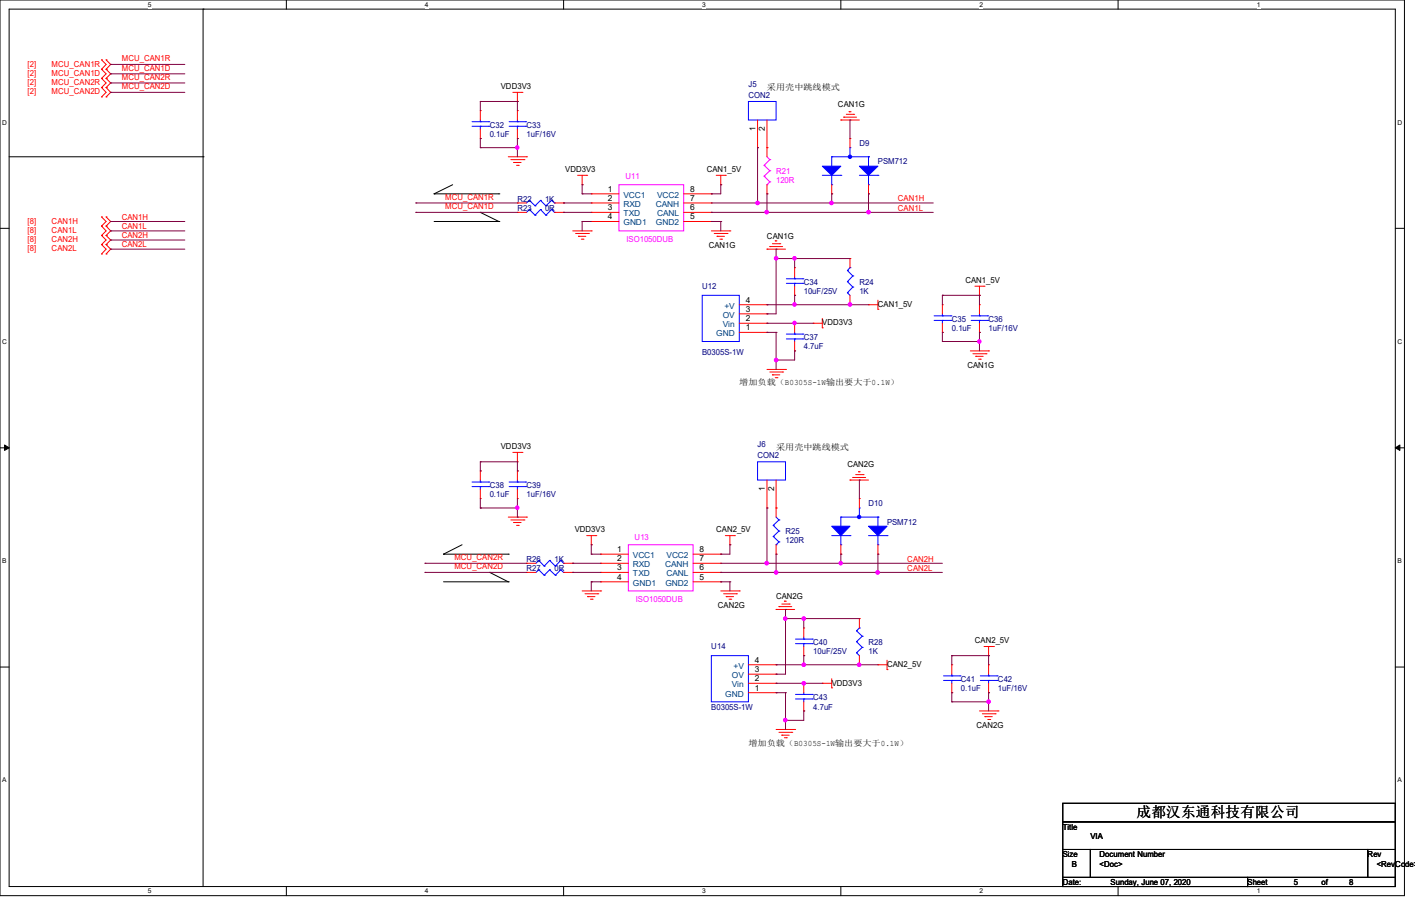
[picture p46: page 5]

# OPT_IN1 OPT_IN2 OPT_IN3 OPT_IN4 OPT_IN5 OPT_IN6 OPT_D1 OPT_D2 OPT_D3 OPT_D5 OPT_D6 OPT_D4

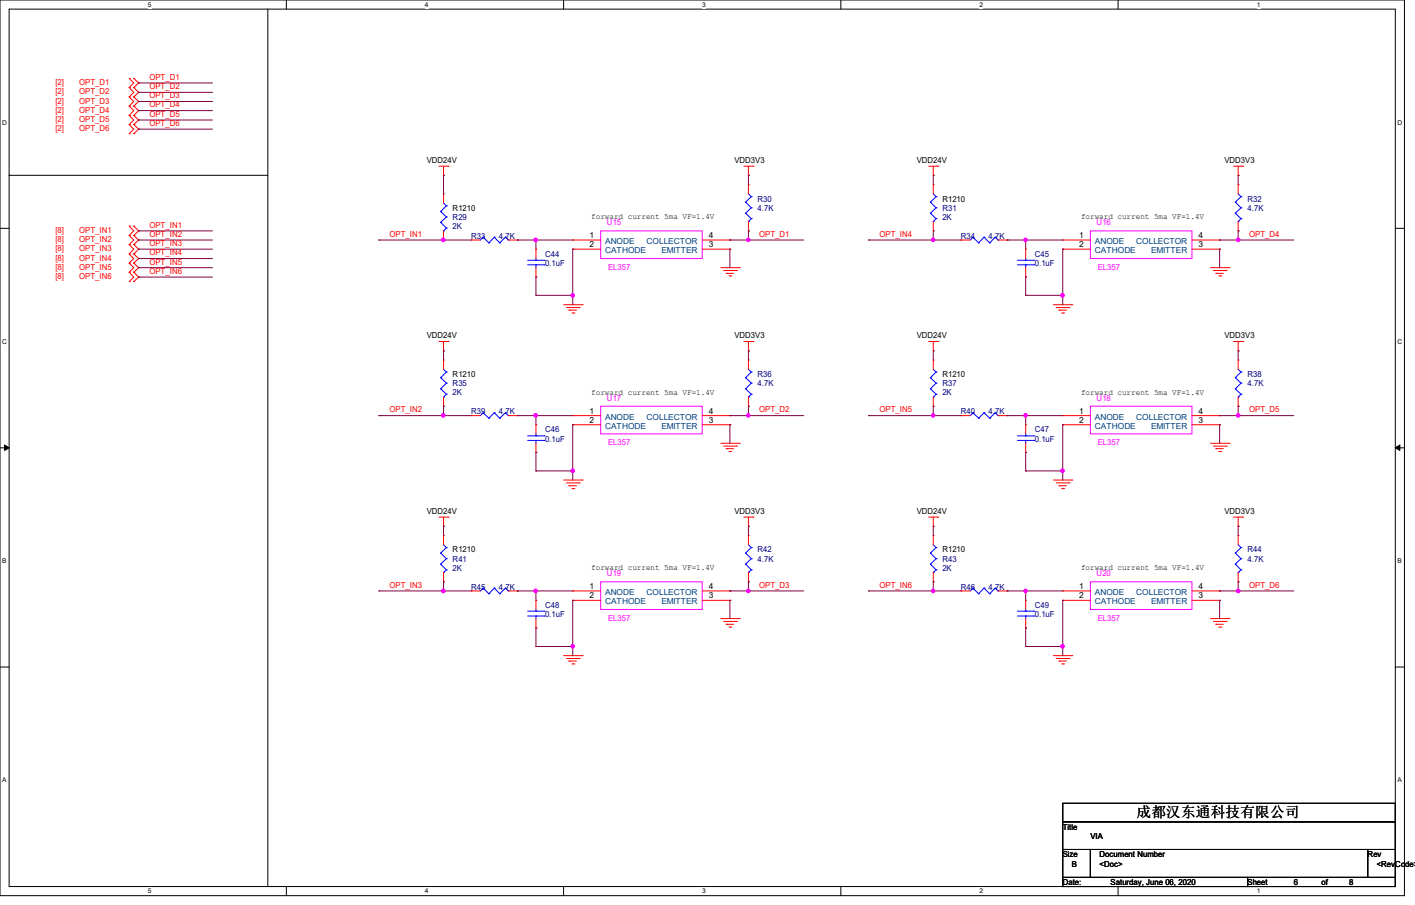
[picture p47: page 6]

# L4 68uH/0.5A C65

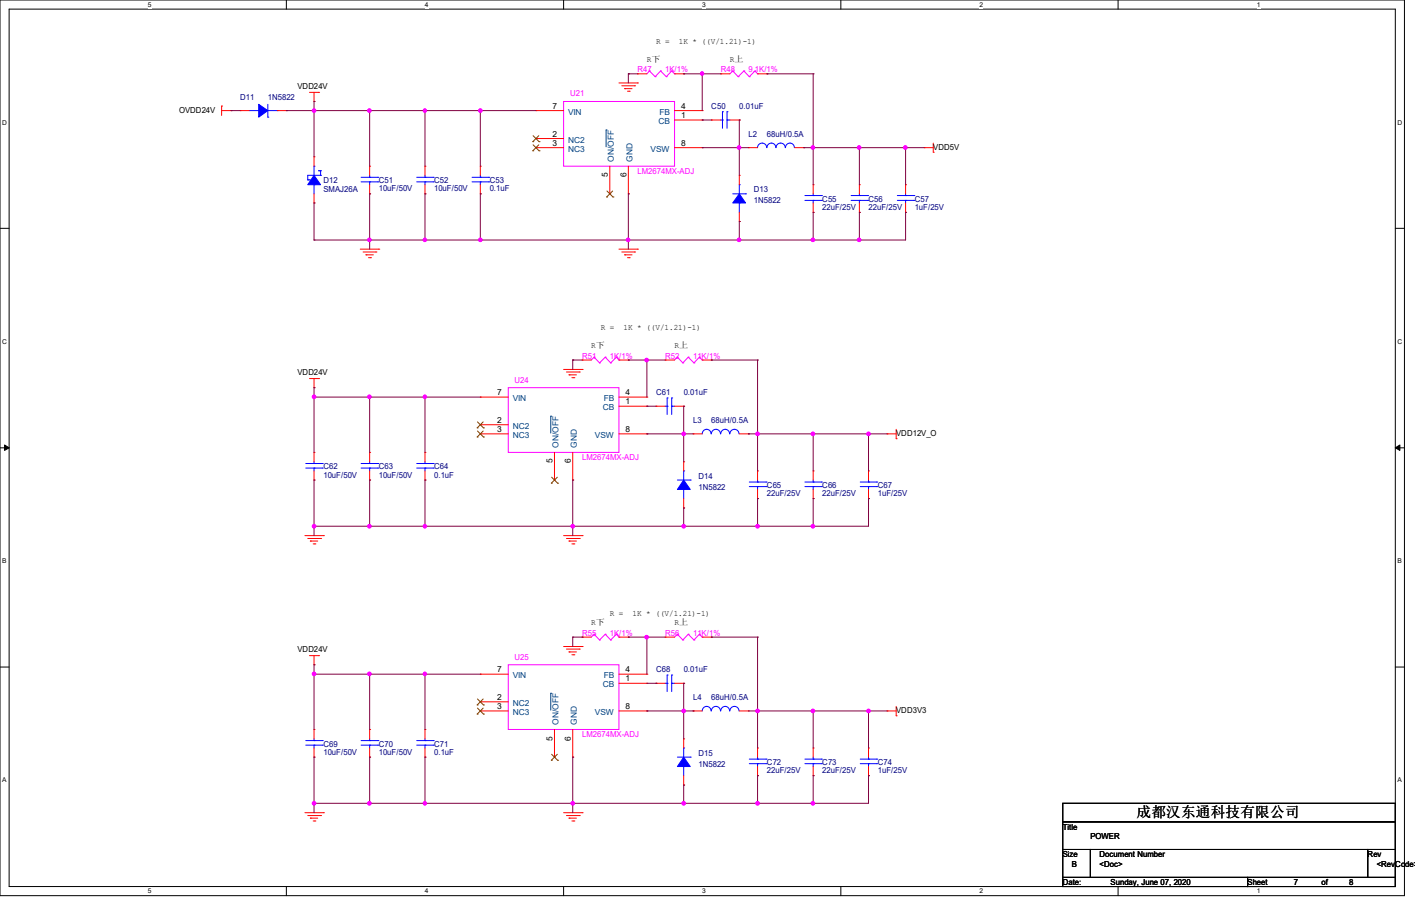
[picture p48: page 7]

# RS_TX1 RS_RX1 RS_TX2 RS_RX2

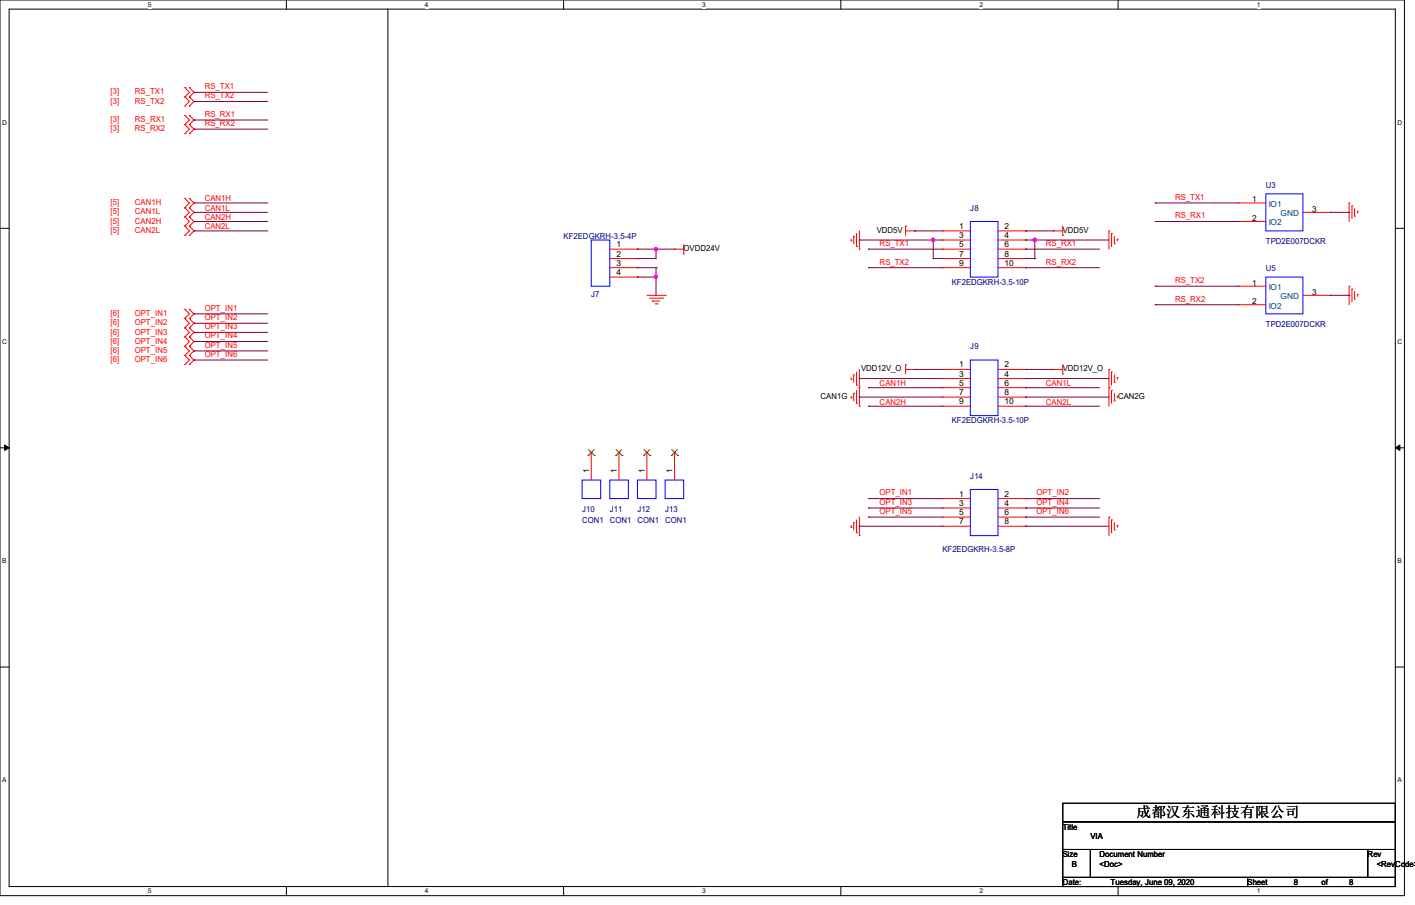
[picture p49: page 8]
