donggua127/control_board/doc/2.0sch/JSFS_ZK_M_v2.0.pdf

# 01_NOTE 02_BLOCK_DIAGRAM

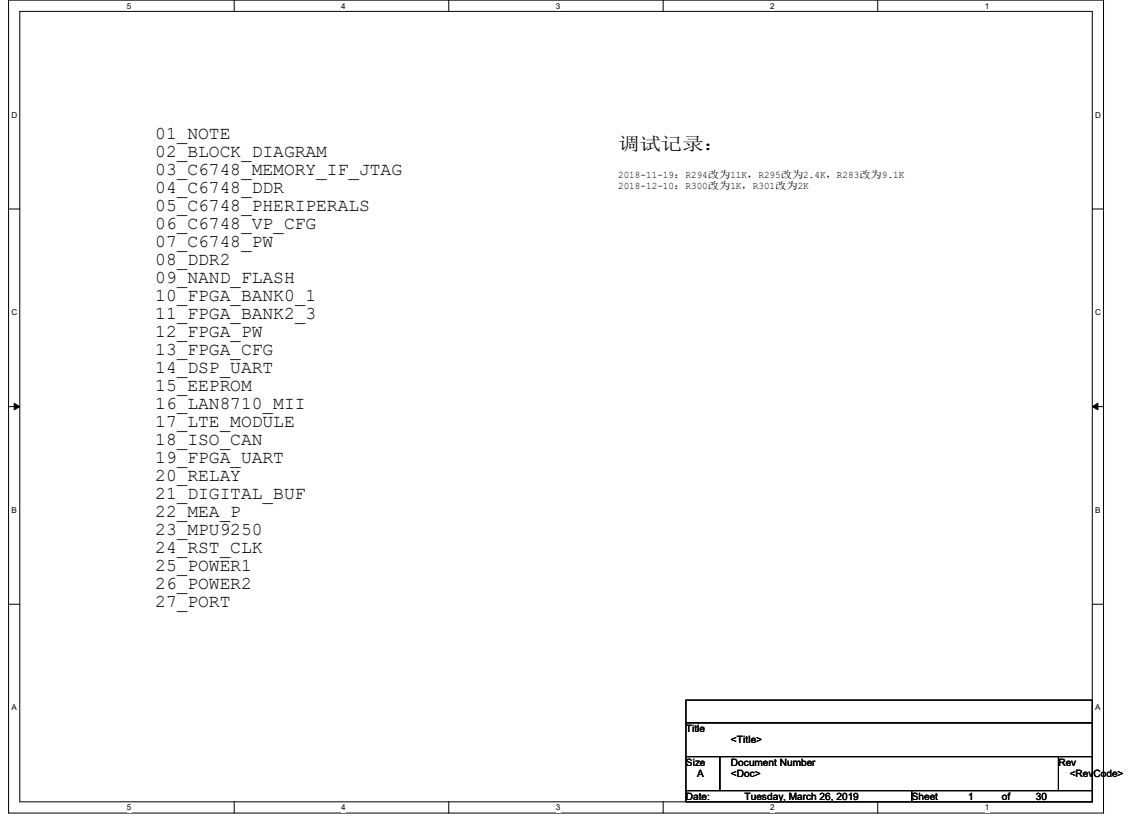
[picture p50: page 1]
03_C6748_MEMORY_IF_JTAG 04_C6748_DDR 05_C6748_PHERIPERALS 06_C6748_VP_CFG 07_C6748_PW 08_DDR2 09_NAND_FLASH 10_FPGA_BANK0_1 11_FPGA_BANK2_3 12_FPGA_PW 13_FPGA_CFG 14_DSP_UART 15_EEPROM 16_LAN8710_MII 17_LTE_MODULE 18_ISO_CAN 19_FPGA_UART 20_RELAY 21_DIGITAL_BUF 22_MEA_P 23_MPU9250 24_RST_CLK 25_POWER1 26_POWER2 27_PORT; 调试记录：; Title; Size; Document Number; Rev; Date:; Sheet; <Doc>; <RevCode>; <Title>; Tuesday, March 26, 2019

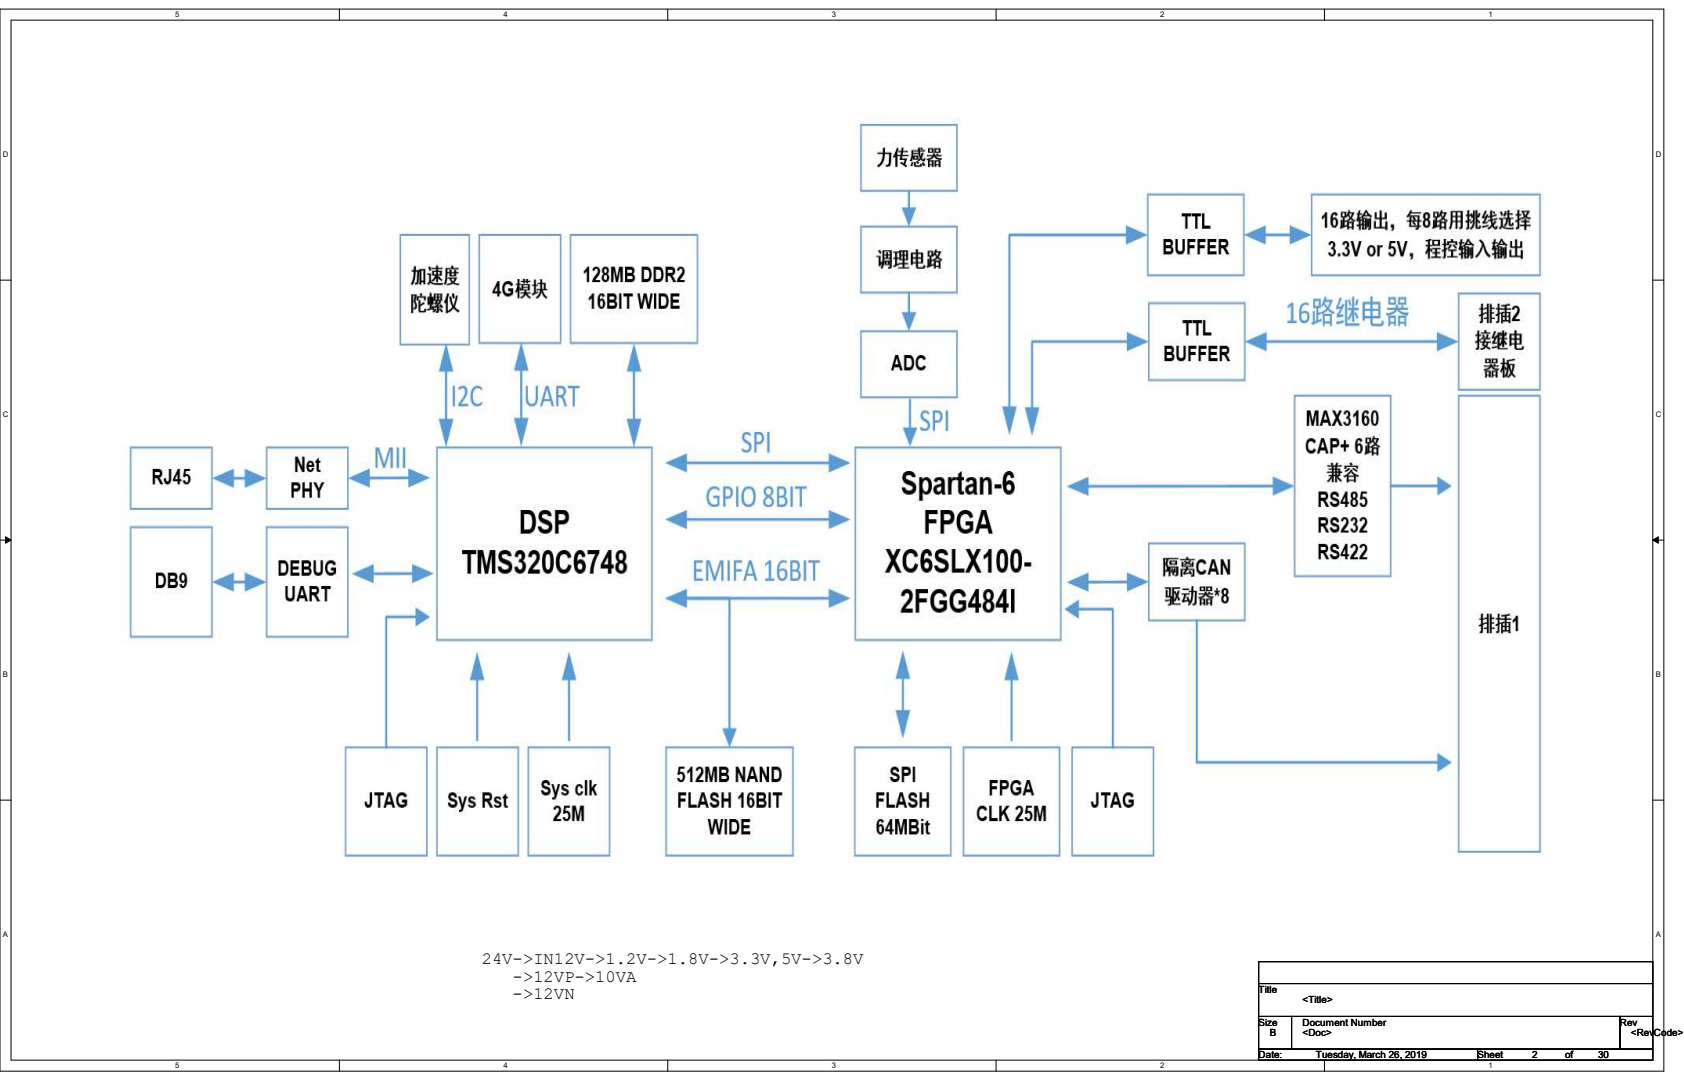
[picture p51: page 2]
Title Size; Document Number; Rev Date:; Sheet; of <Doc>; <RevCode>; <Title> B; Tuesday, March 26, 2019; 30 Title Size

R6 | 4.7K R2 | 10K

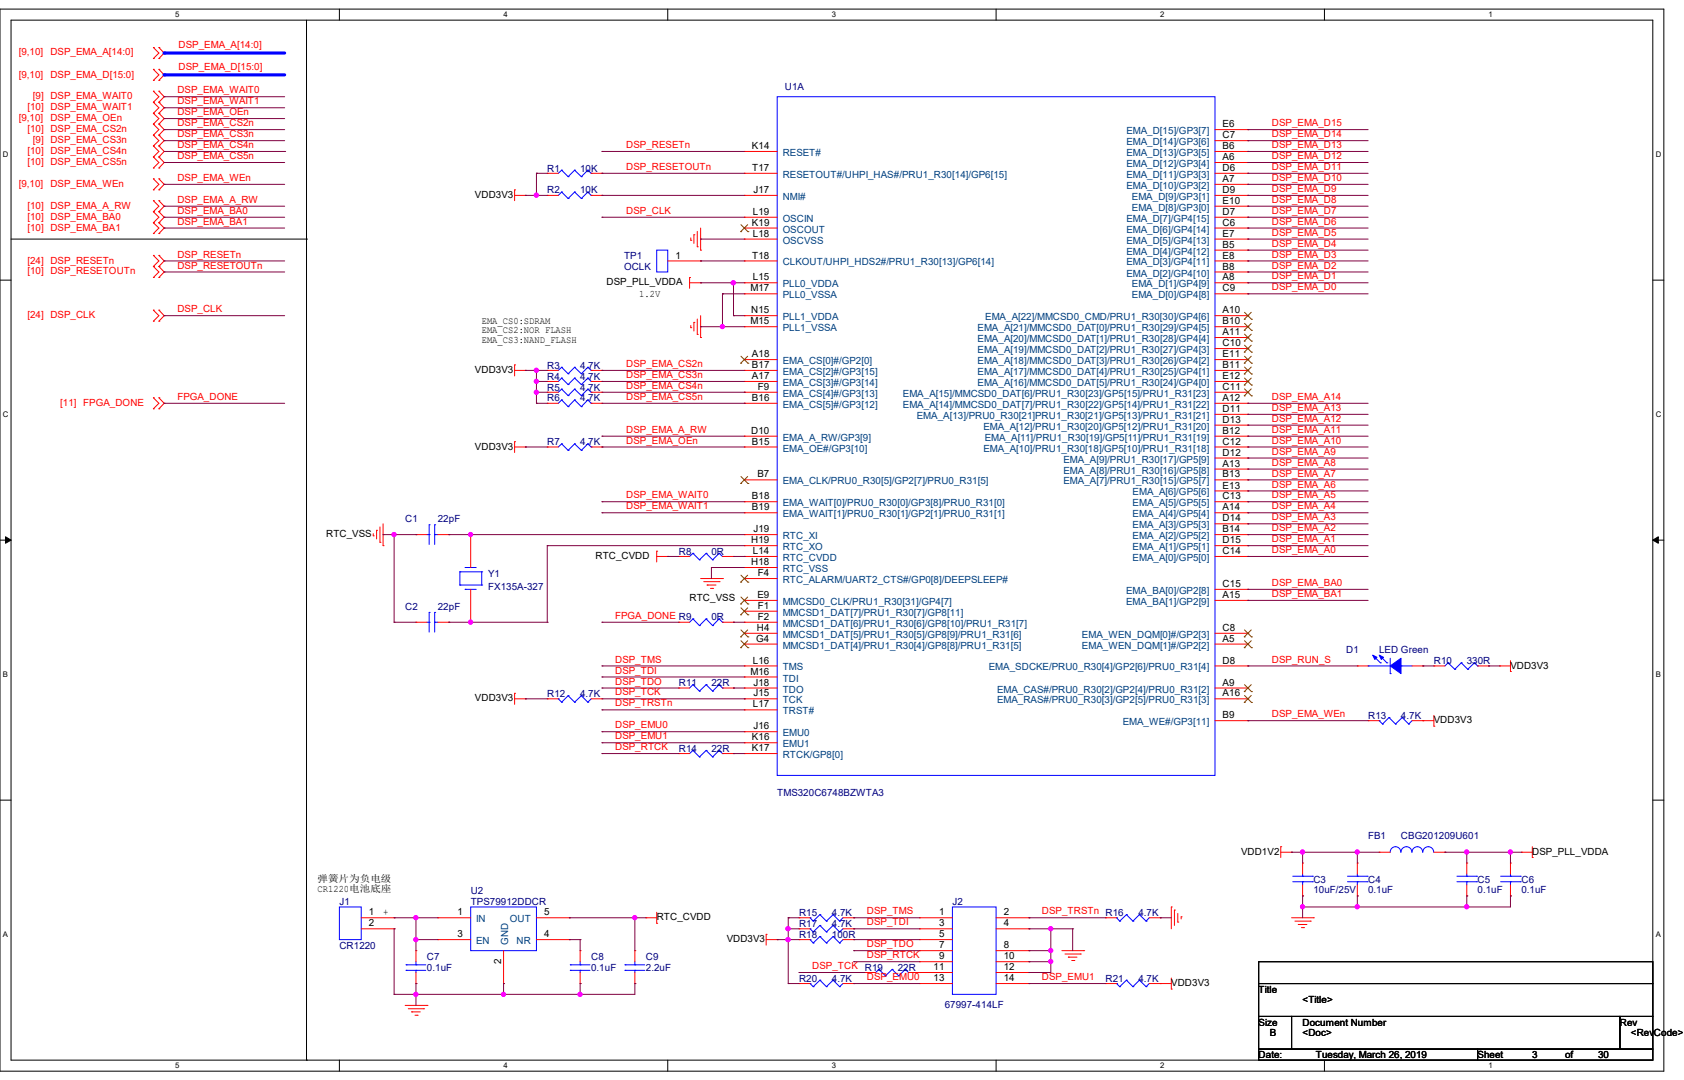
[picture p52: page 3]

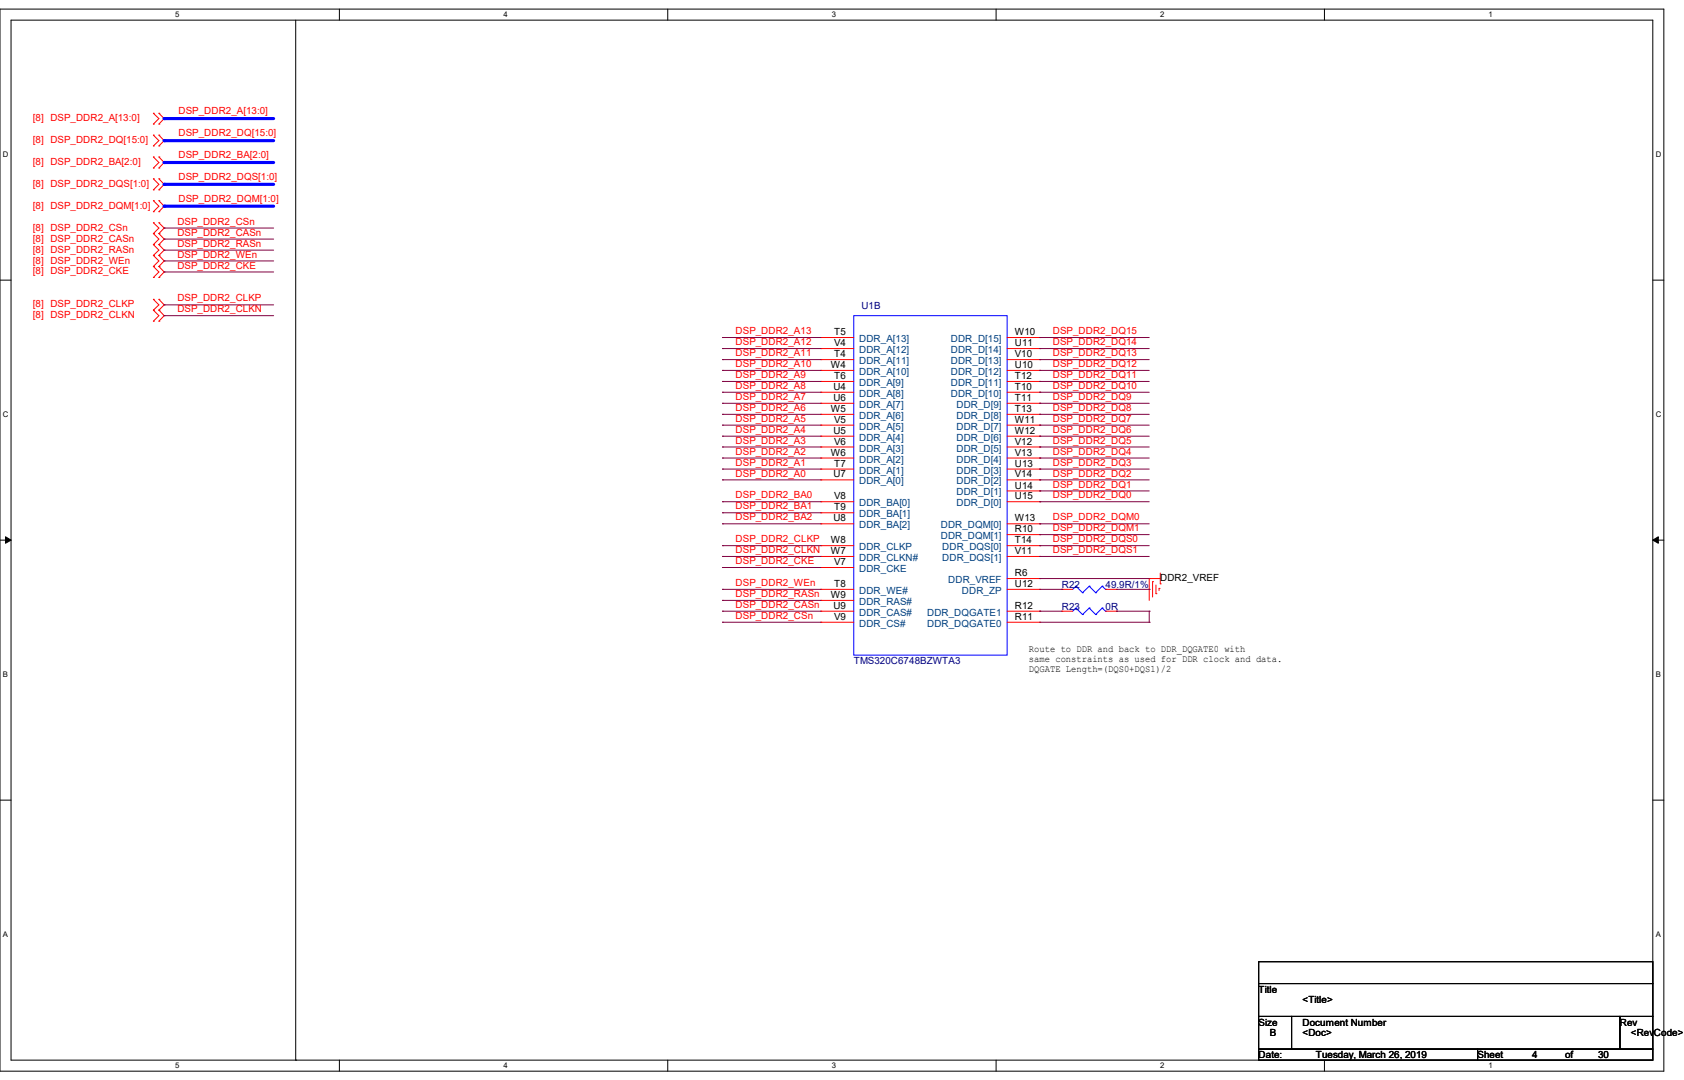
[picture p53: page 4]

Route to DDR and back to DDR_DQGATE0 with
same constraints as used for DDR clock and data.

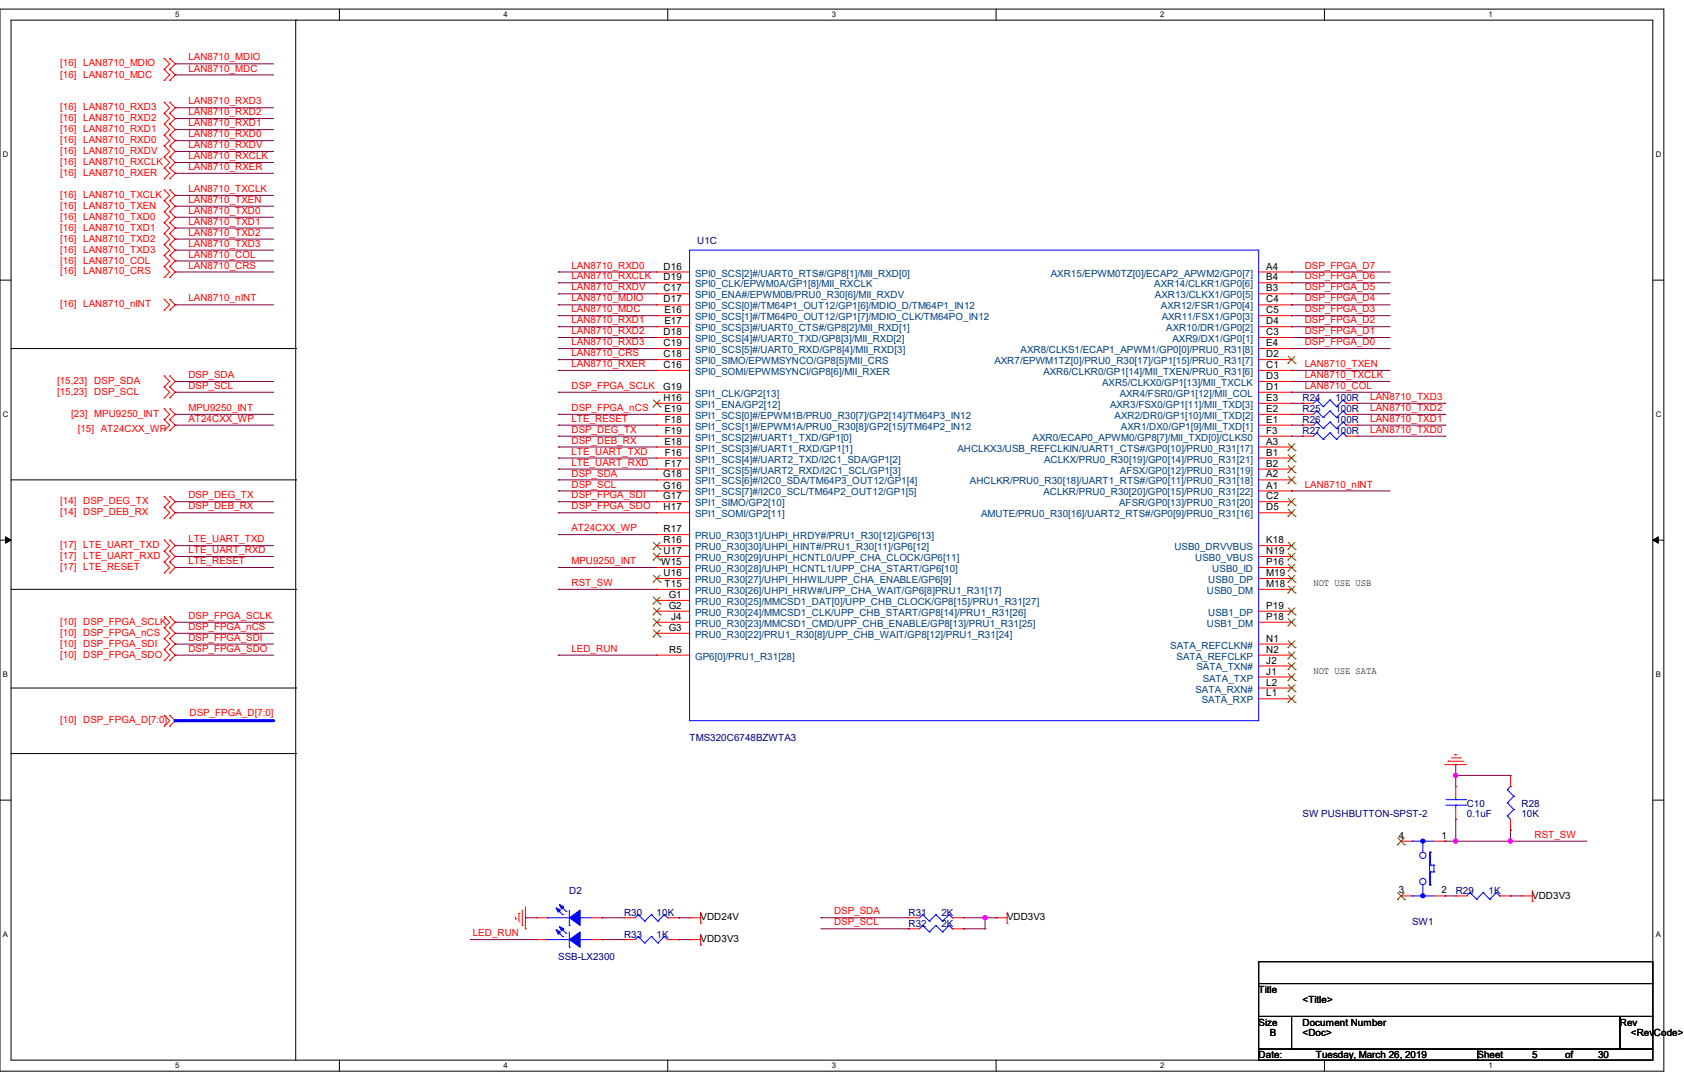
[picture p54: page 5]

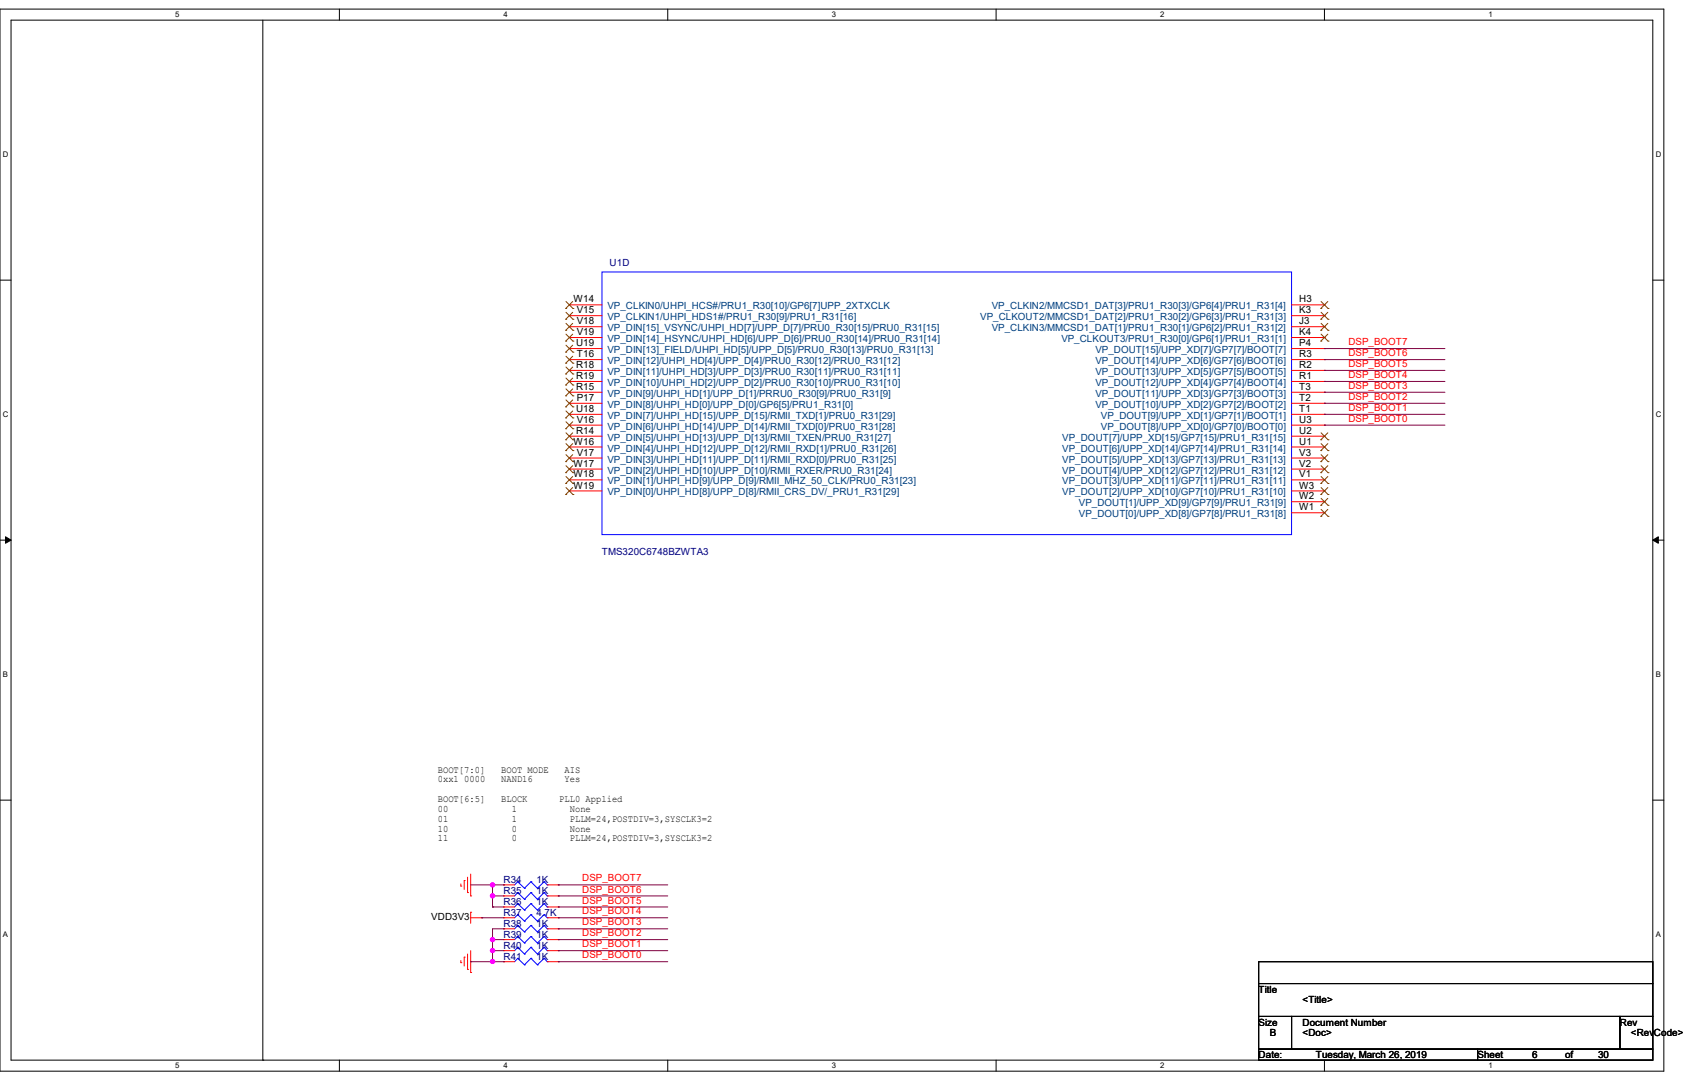
[picture p55: page 6]

RSV2 T19 | RSV3/SATA_VDD M2 | RSV3/SATA_VDD N4 | RSV3/SATA_VDD P2 | RSV3/SATA_VDD P1 | NC M³ NC M¹⁴ NC N¹⁶
USB0_VDDA33 | N18 USB0_VDDA18 | N14 USB0_VDDA12 | N17 USB_CVDD | M12 DDR_DVDD18 N6 | DDR_DVDD18 N9 | DDR_DVDD18 N10 | DDR_DVDD18 P7 | DDR_DVDD18 P8 | DDR_DVDD18 P9 | DDR_DVDD18 P10 | DDR_DVDD18 R7 | DDR_DVDD18 R8 | DDR_DVDD18 R9 | CVDD | E15 CVDD | G7 CVDD | G8 CVDD | G13 CVDD | H6 CVDD | H7 CVDD | H10 CVDD | H11 CVDD | H12 CVDD | H13 CVDD | J6 CVDD | J12 CVDD | K6 CVDD | K12 CVDD | L12 CVDD | M8 CVDD | M9 CVDD | N8 RVDD | E5 RVDD | H14 RVDD | N7 DVDD18 | F14 DVDD18 | G6 DVDD18 | G10 DVDD18 | G11 DVDD18 | G12 DVDD18 | J13 DVDD18 | K5 DVDD18 | L6 DVDD18 | P13 DVDD18 | R13 DVDD3318_A F5 DVDD3318_A F15 DVDD3318_A G5 DVDD3318_A G14 DVDD3318_A G15 DVDD3318_A H5 DVDD3318_B E14 DVDD3318_B F6 DVDD3318_B F7 DVDD3318_B F8 DVDD3318_B F10 DVDD3318_B F11 DVDD3318_B F12 DVDD3318_B F13 DVDD3318_B G9 DVDD3318_B J14 DVDD3318_B K15 DVDD3318_C | J5 DVDD3318_C | K13 DVDD3318_C | L4 DVDD3318_C | L13 DVDD3318_C | M13 DVDD3318_C | N13 DVDD3318_C | P5 DVDD3318_C | P6 DVDD3318_C | P12 DVDD3318_C | R4

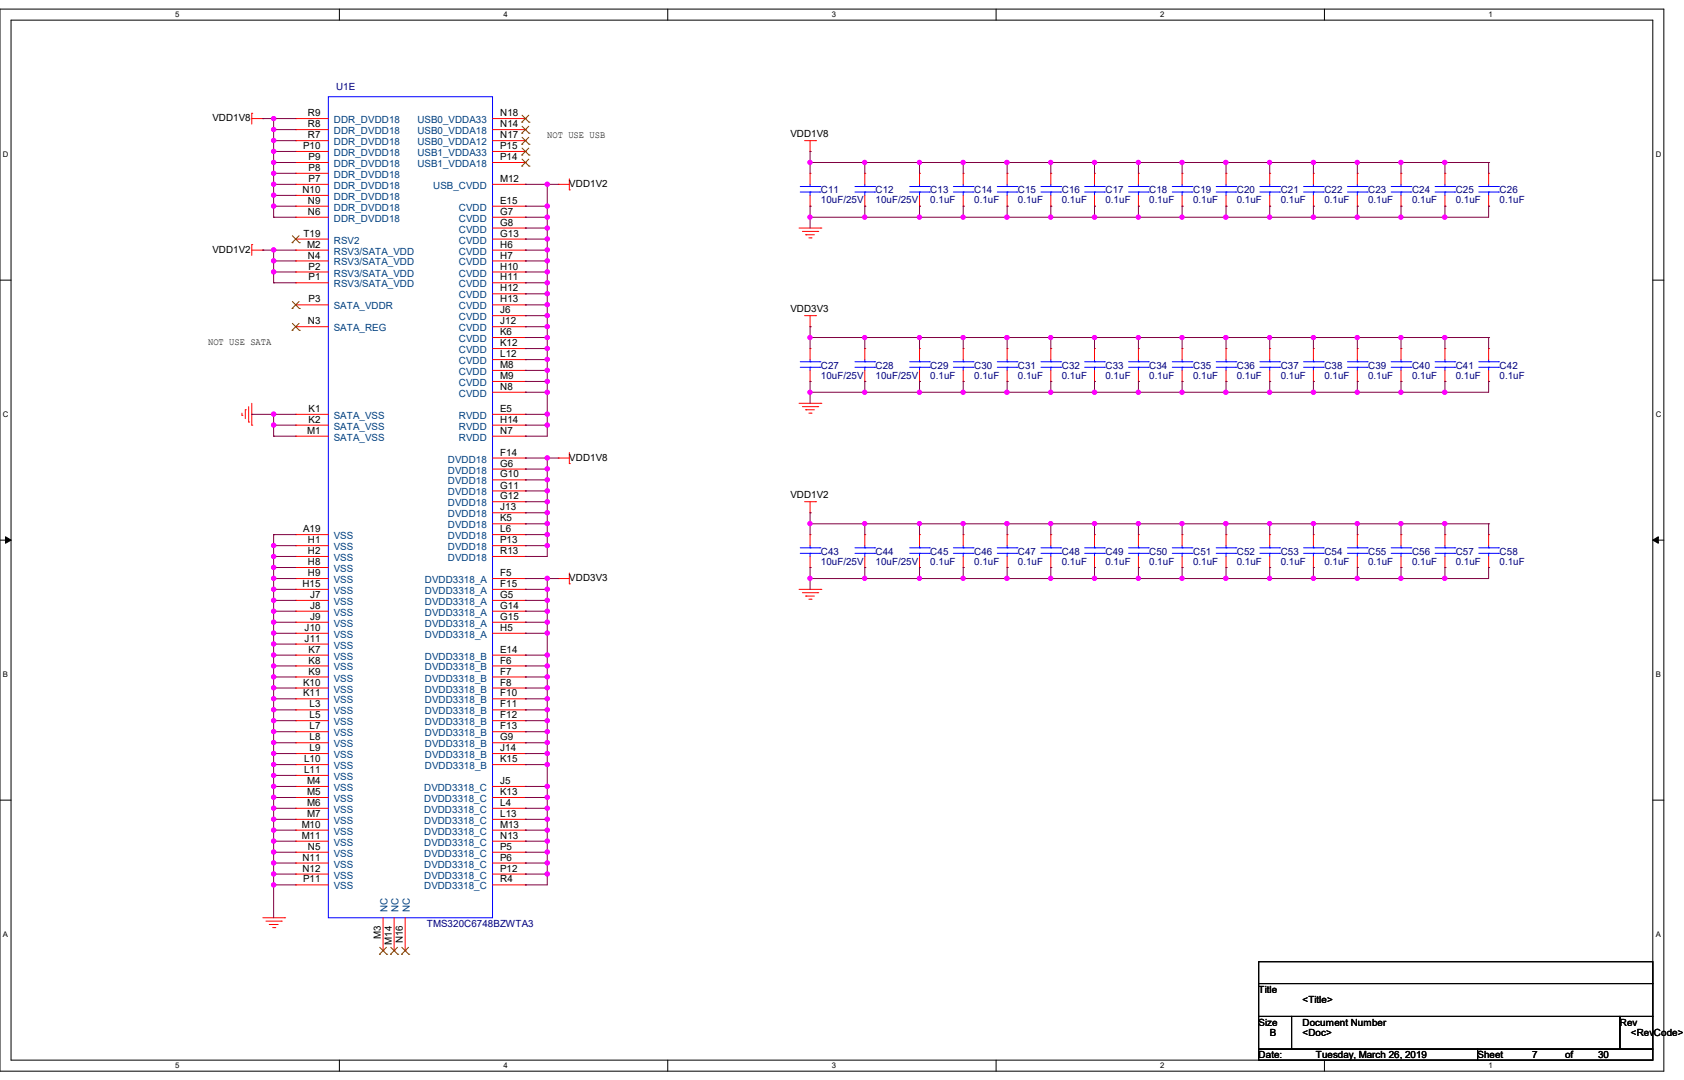
[picture p56: page 7]

A0 M8 | A1 M3 | A2 M7 | A3 N2 | A4 N8 | A5 N3 | A6 N7 | A7 P2 | A8 P8 | A9 P3 | A10 M2 | A11 P7 | A12 R2 | BA0 L2 | BA1 L3 | BA2 L1 | CK J8 | CKn K8 | CKE K2 | CSn L8
VDD5 | A1 VDD4 | E1 VDD3 | M9 VDD2 | R1 VDD1 | J9 VDDQ10 | A9 VDDQ9 | C1 VDDQ8 | C3 VDDQ7 | C7 VDDQ6 | C9 VDDQ5 | G3 VDDQ4 | E9 VDDQ3 | G1 VDDQ2 | G7 VDDQ1 | G9 VDDL | J1 VREF | J2 VSS5 | A3 VSS4 | E3 VSS3 | J3 VSS2 | N1 VSS1 | P9 VSSQ10 | A7 VSSQ9 | B2 VSSQ8 | B8 VSSQ7 | D2 VSSQ6 | D8 VSSQ5 | E7 VSSQ4 | F2 VSSQ3 | F8 VSSQ2 | H2 VSSQ1 | H8 VSSDL | J7 NC1 A2 | NC2 E2 | UDQSn/NU A8 | RFU2 R3 | RFU3 R7

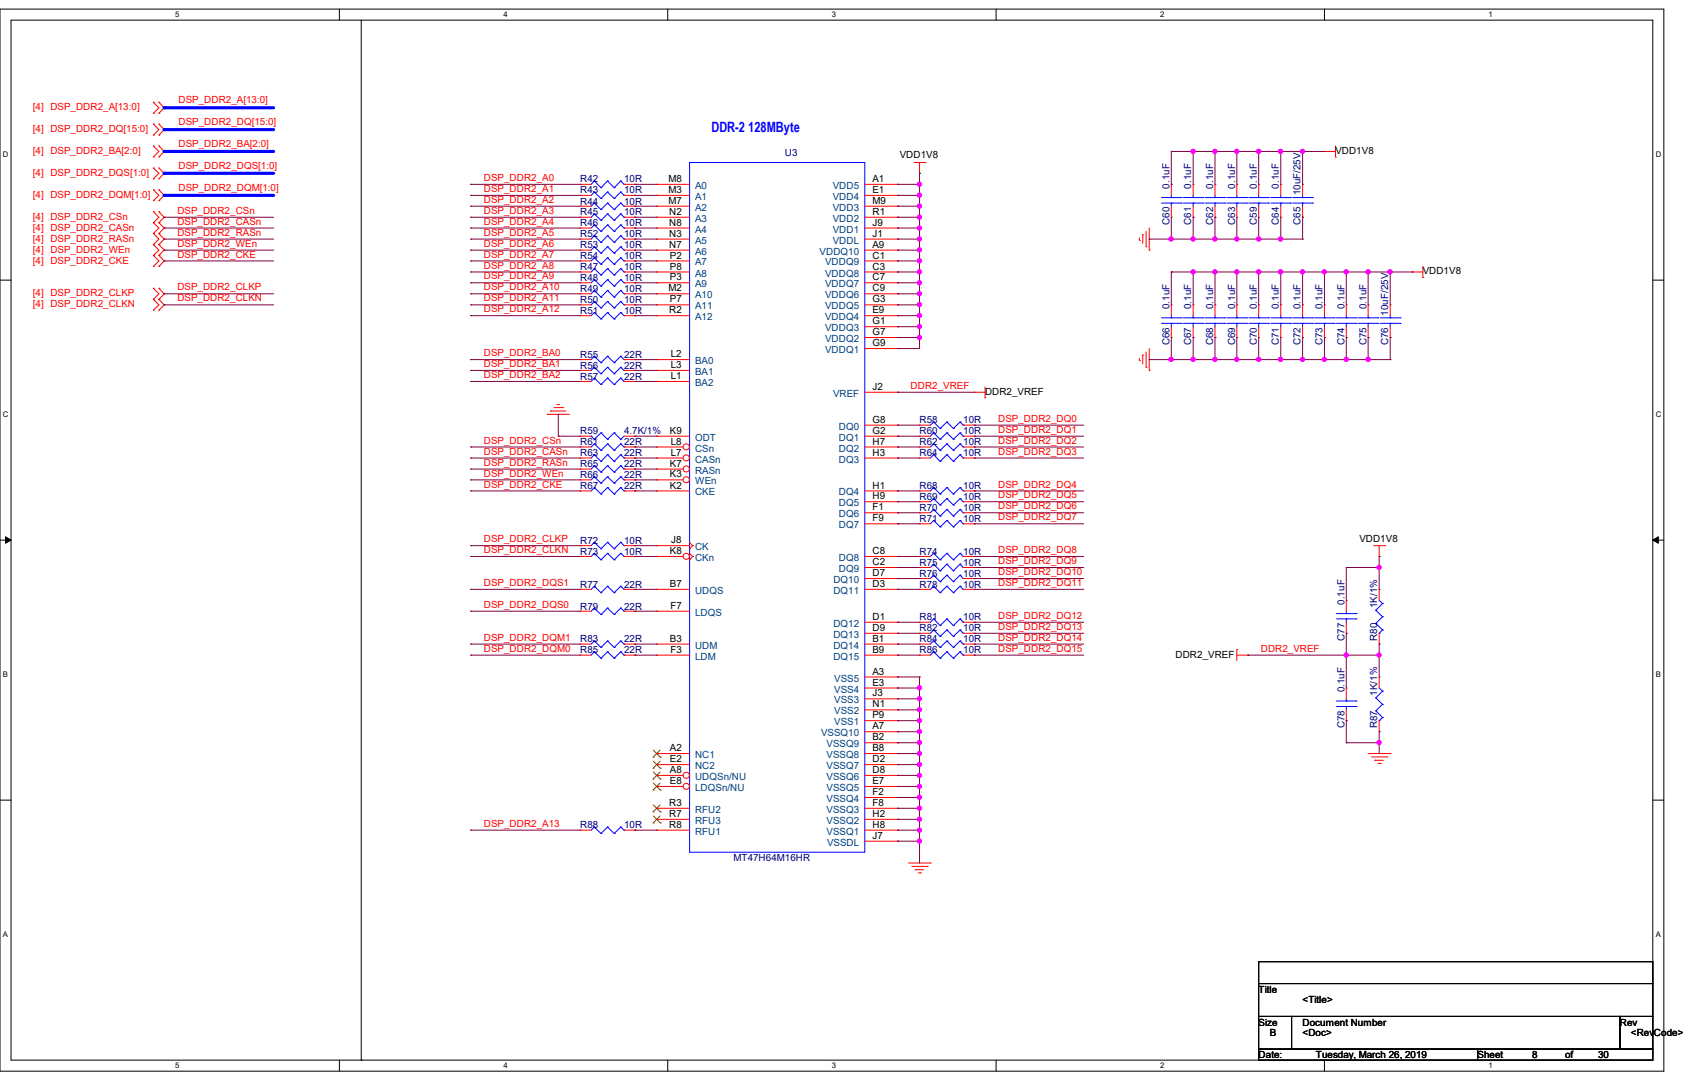
[picture p57: page 8]

## NAND FLASH 512MByte

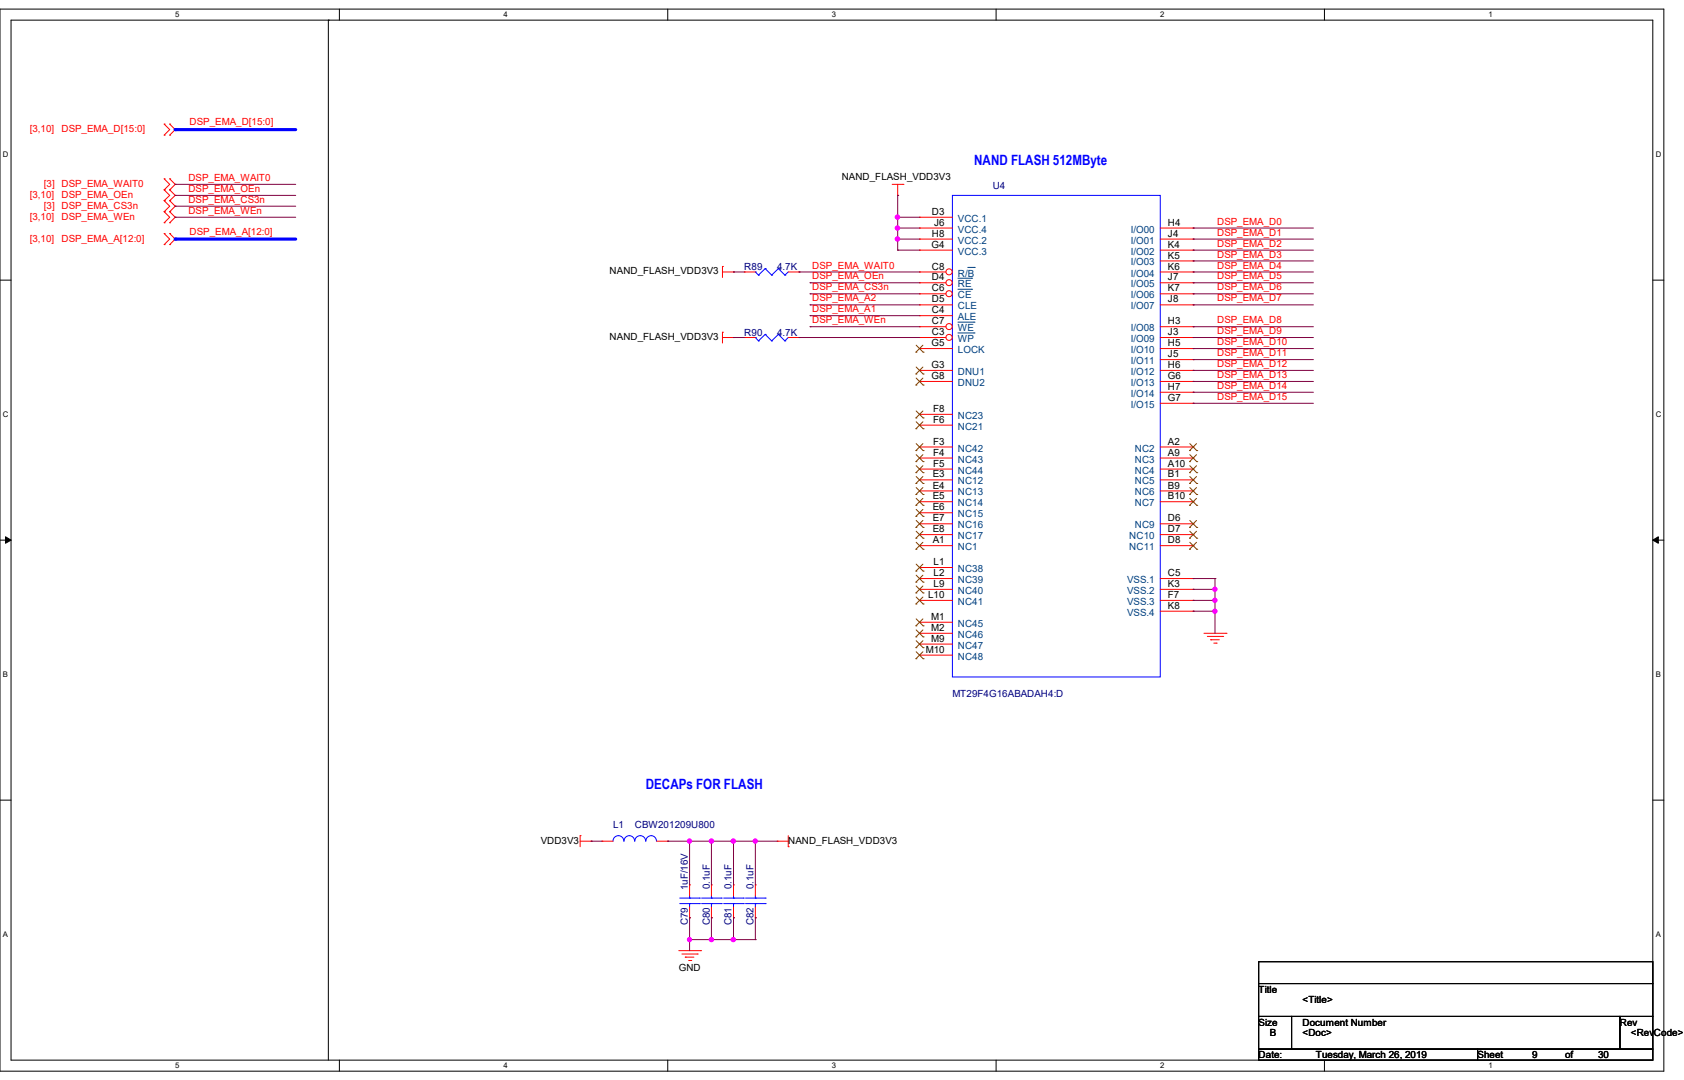
[picture p58: page 9]

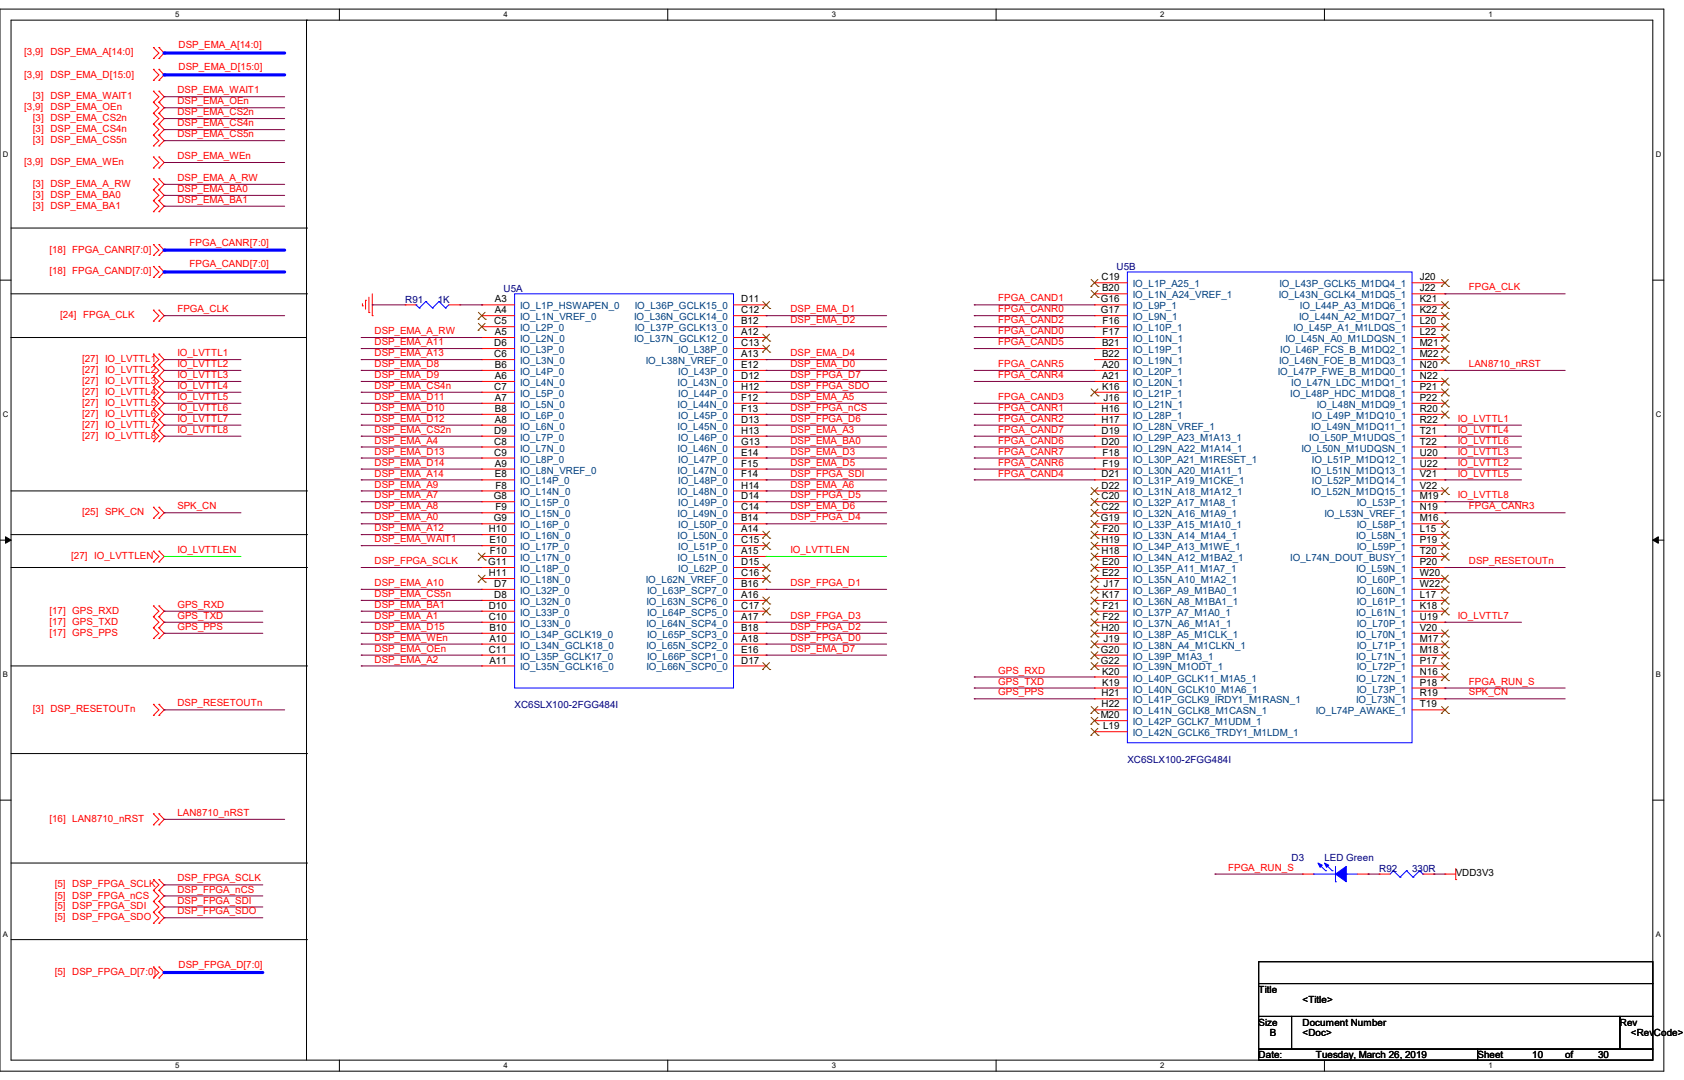
[picture p59: page 10]

# OS_2 DB0 DB1 DB2 DB3 DB4 DB5 DB6 DB7 DB8 DB9 DB10 DB11 DB12 DB13 DB14 DB15

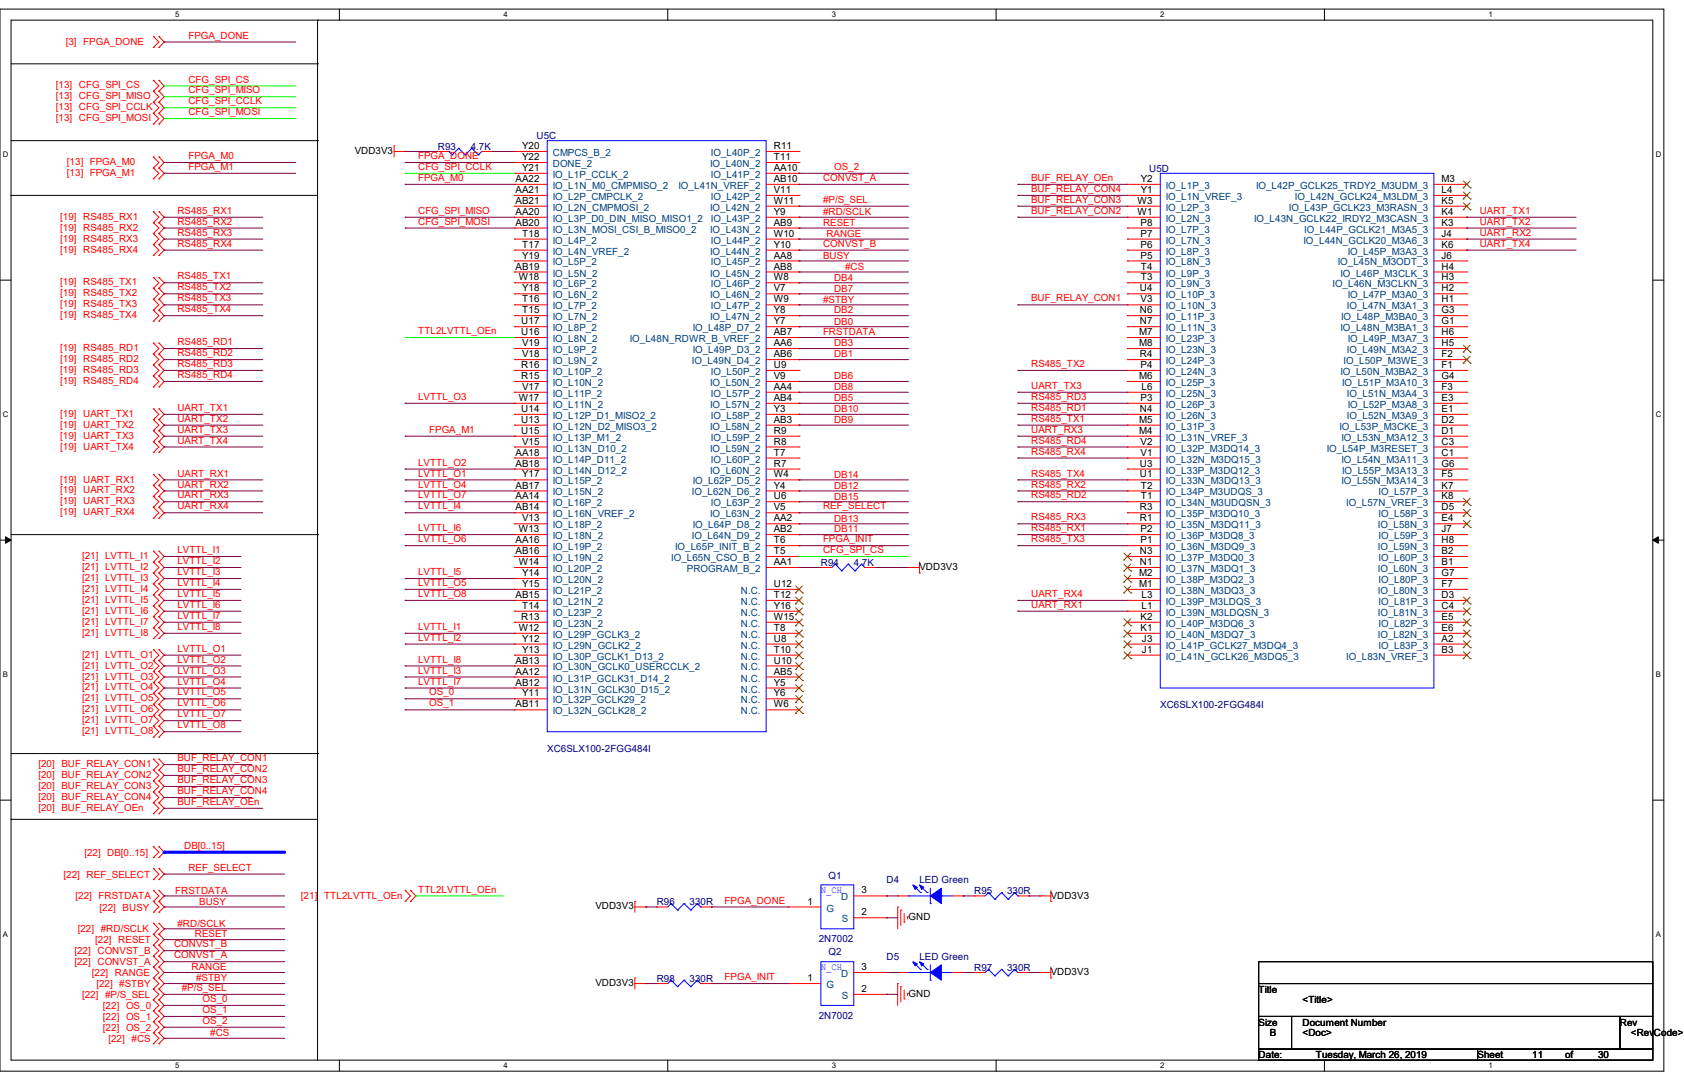
[picture p60: page 11]

# U5FXC6SLX100-2FGG484I

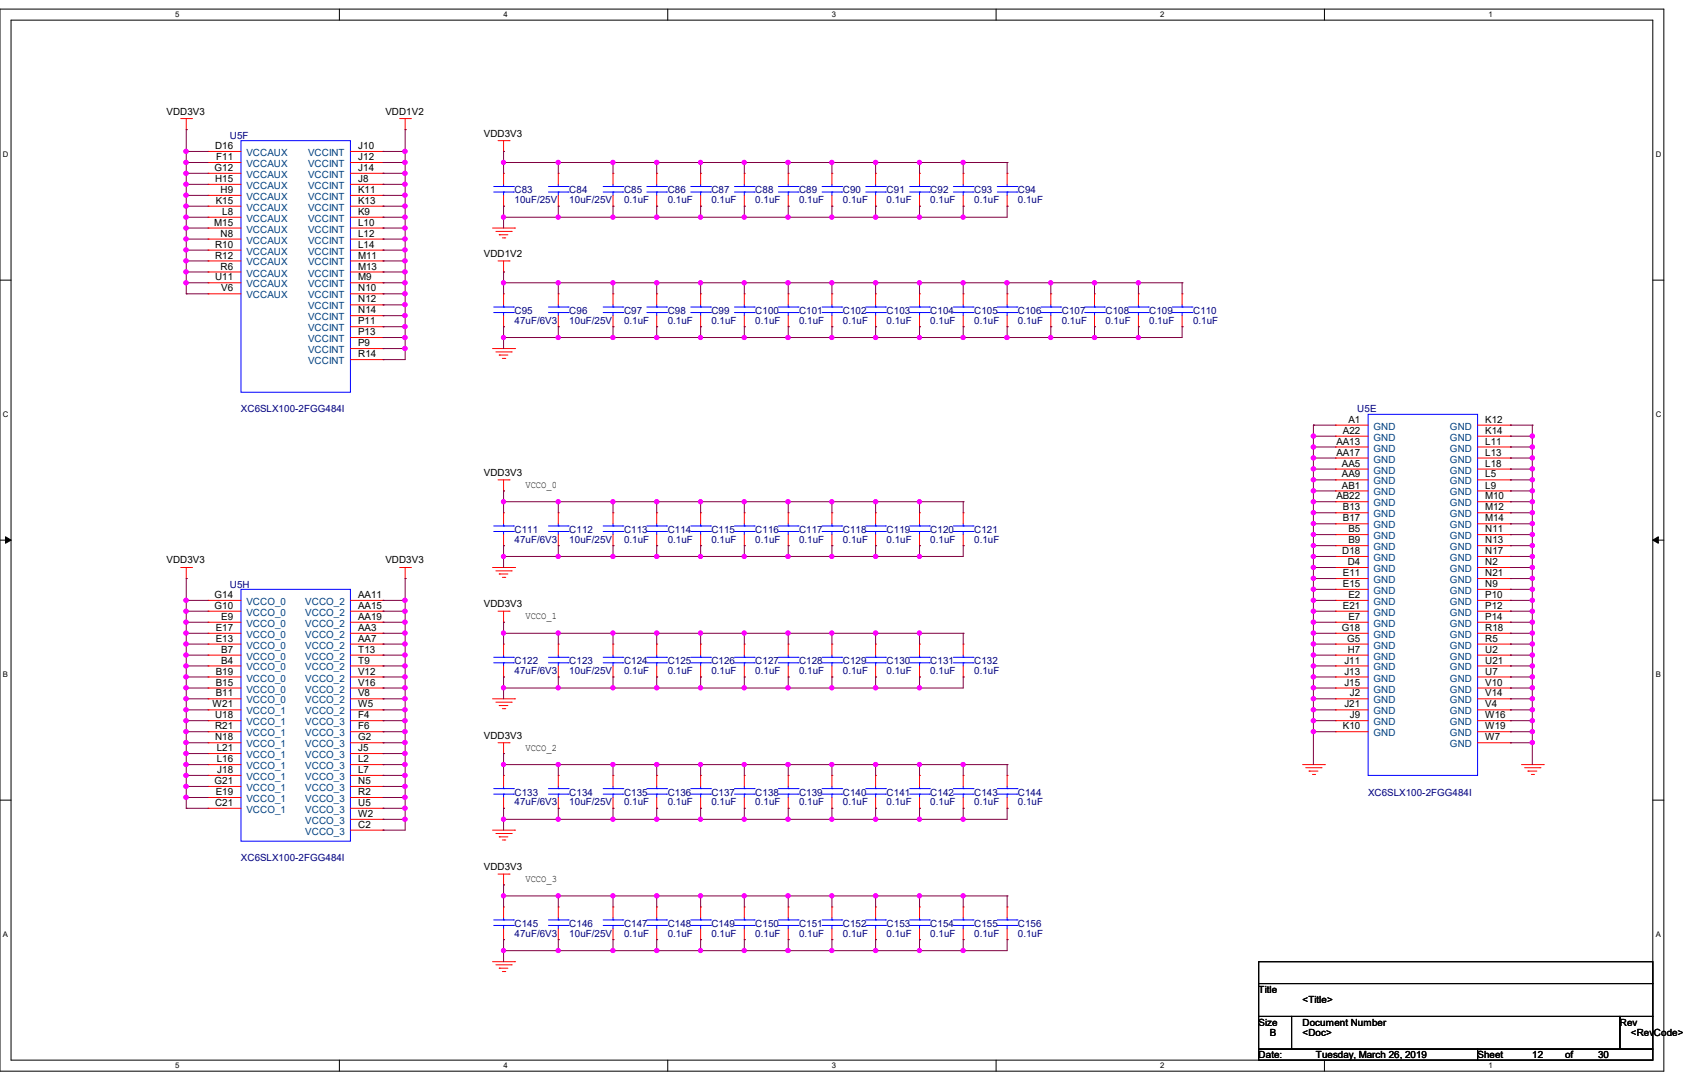
[picture p61: page 12]

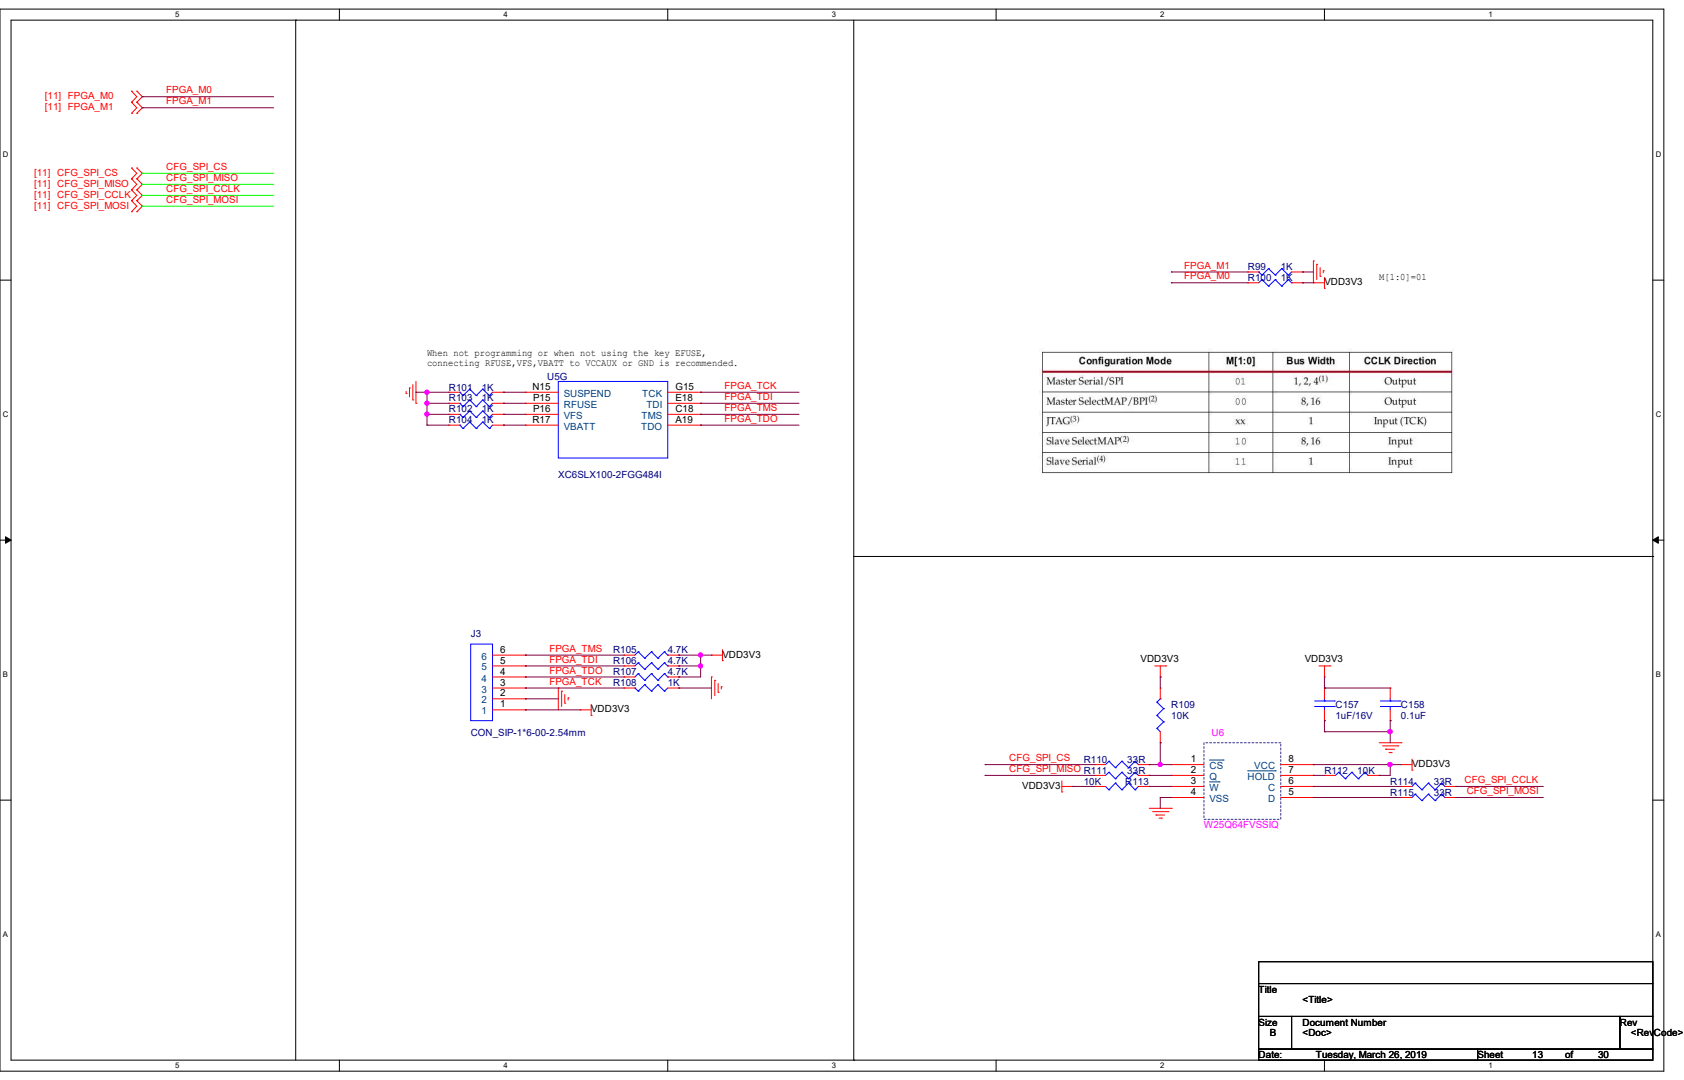
[picture p62: page 13]

When not programming or when not using the key EFUSE,
connecting RFUSE,VFS,VBATT to VCCAUX or GND is recommended.

## VDD3V3

## [5] DSP_DEG_TX

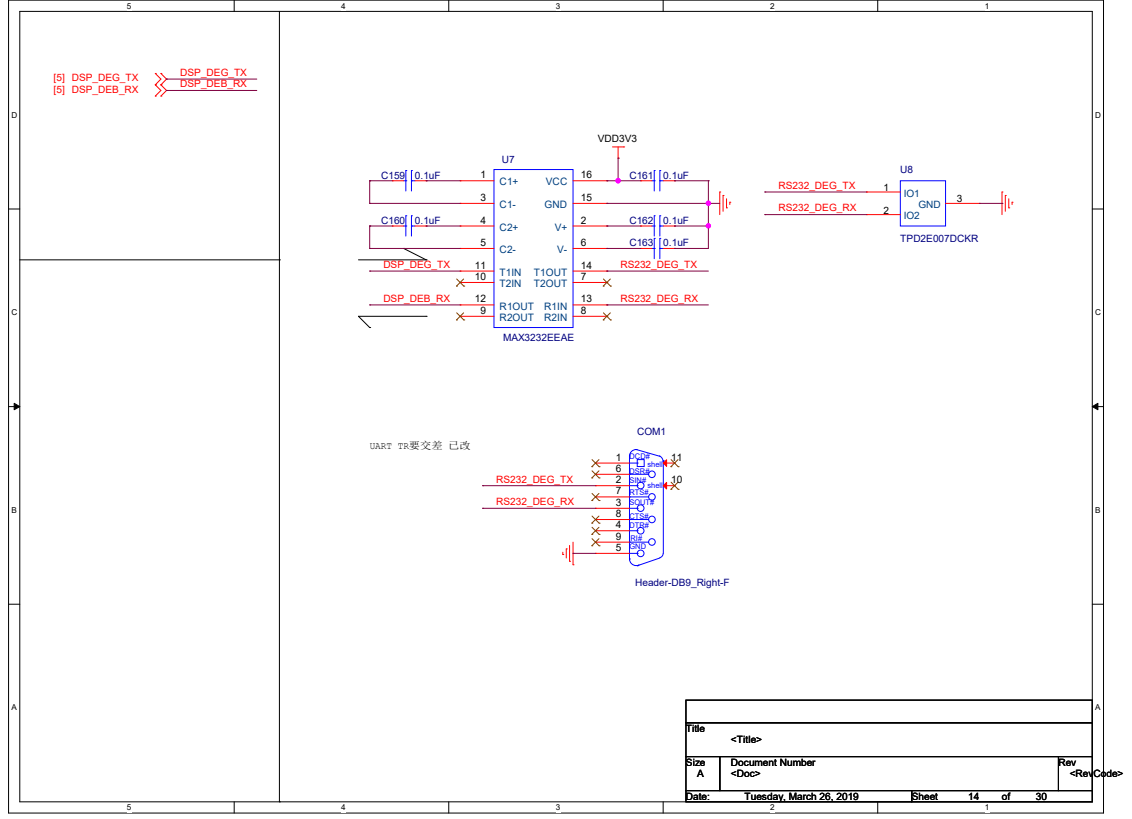
[picture p63: page 14]
[5] DSP_DEB_RX; Title; Size; Document Number; Rev; Date:; Sheet; <Doc>; <RevCode>; <Title>; Tuesday, March 26, 2019; MAX3232EEAE; T2OUT 7; R2IN 8 R2OUT 9; R1OUT 12; T1OUT 14; GND 15; VCC 16; RI# CTS# DSR# DCD# SIN# RTS# SOUT# DTR# shell GND; shell COM1; Header-DB9_Right-F; TPD2E007DCKR; GND; RS232_DEG_RX; RS232_DEG_TX; DSP_DEG_TX; DSP_DEB_RX; DSP_DEG_TX DSP_DEB_RX

UART TR要交差 已改

## [5] AT24CXX_WP

## [5,23] DSP_SDA

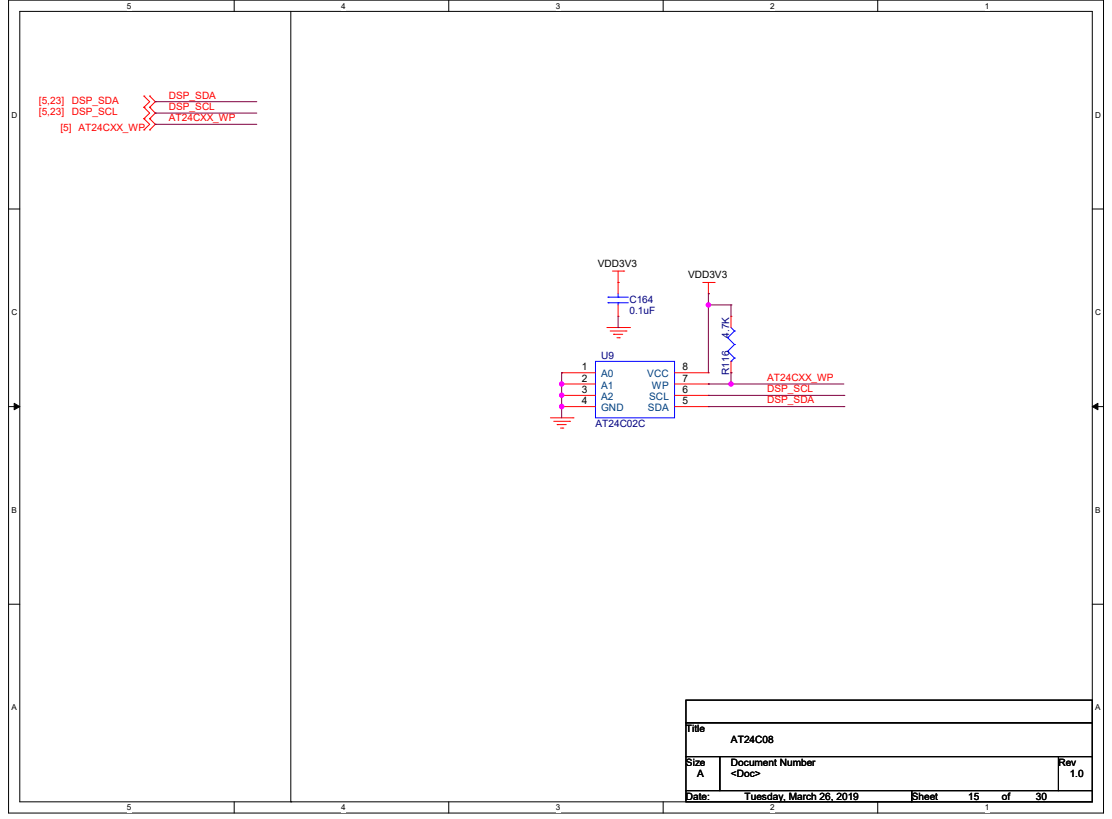
[picture p64: page 15]
VDD3V3; [5,23] DSP_SCL; Title; Size; Document Number; Rev; Date:; Sheet; <Doc>; Tuesday, March 26, 2019; U9 A0 1 A1 2 A2 3 GND 4; VCC 8 WP 7 SCL 6 SDA 5; R¹¹⁶ ⁴.7K; DSP_SCL DSP_SDA; AT24CXX_WP; DSP_SDA DSP_SCL

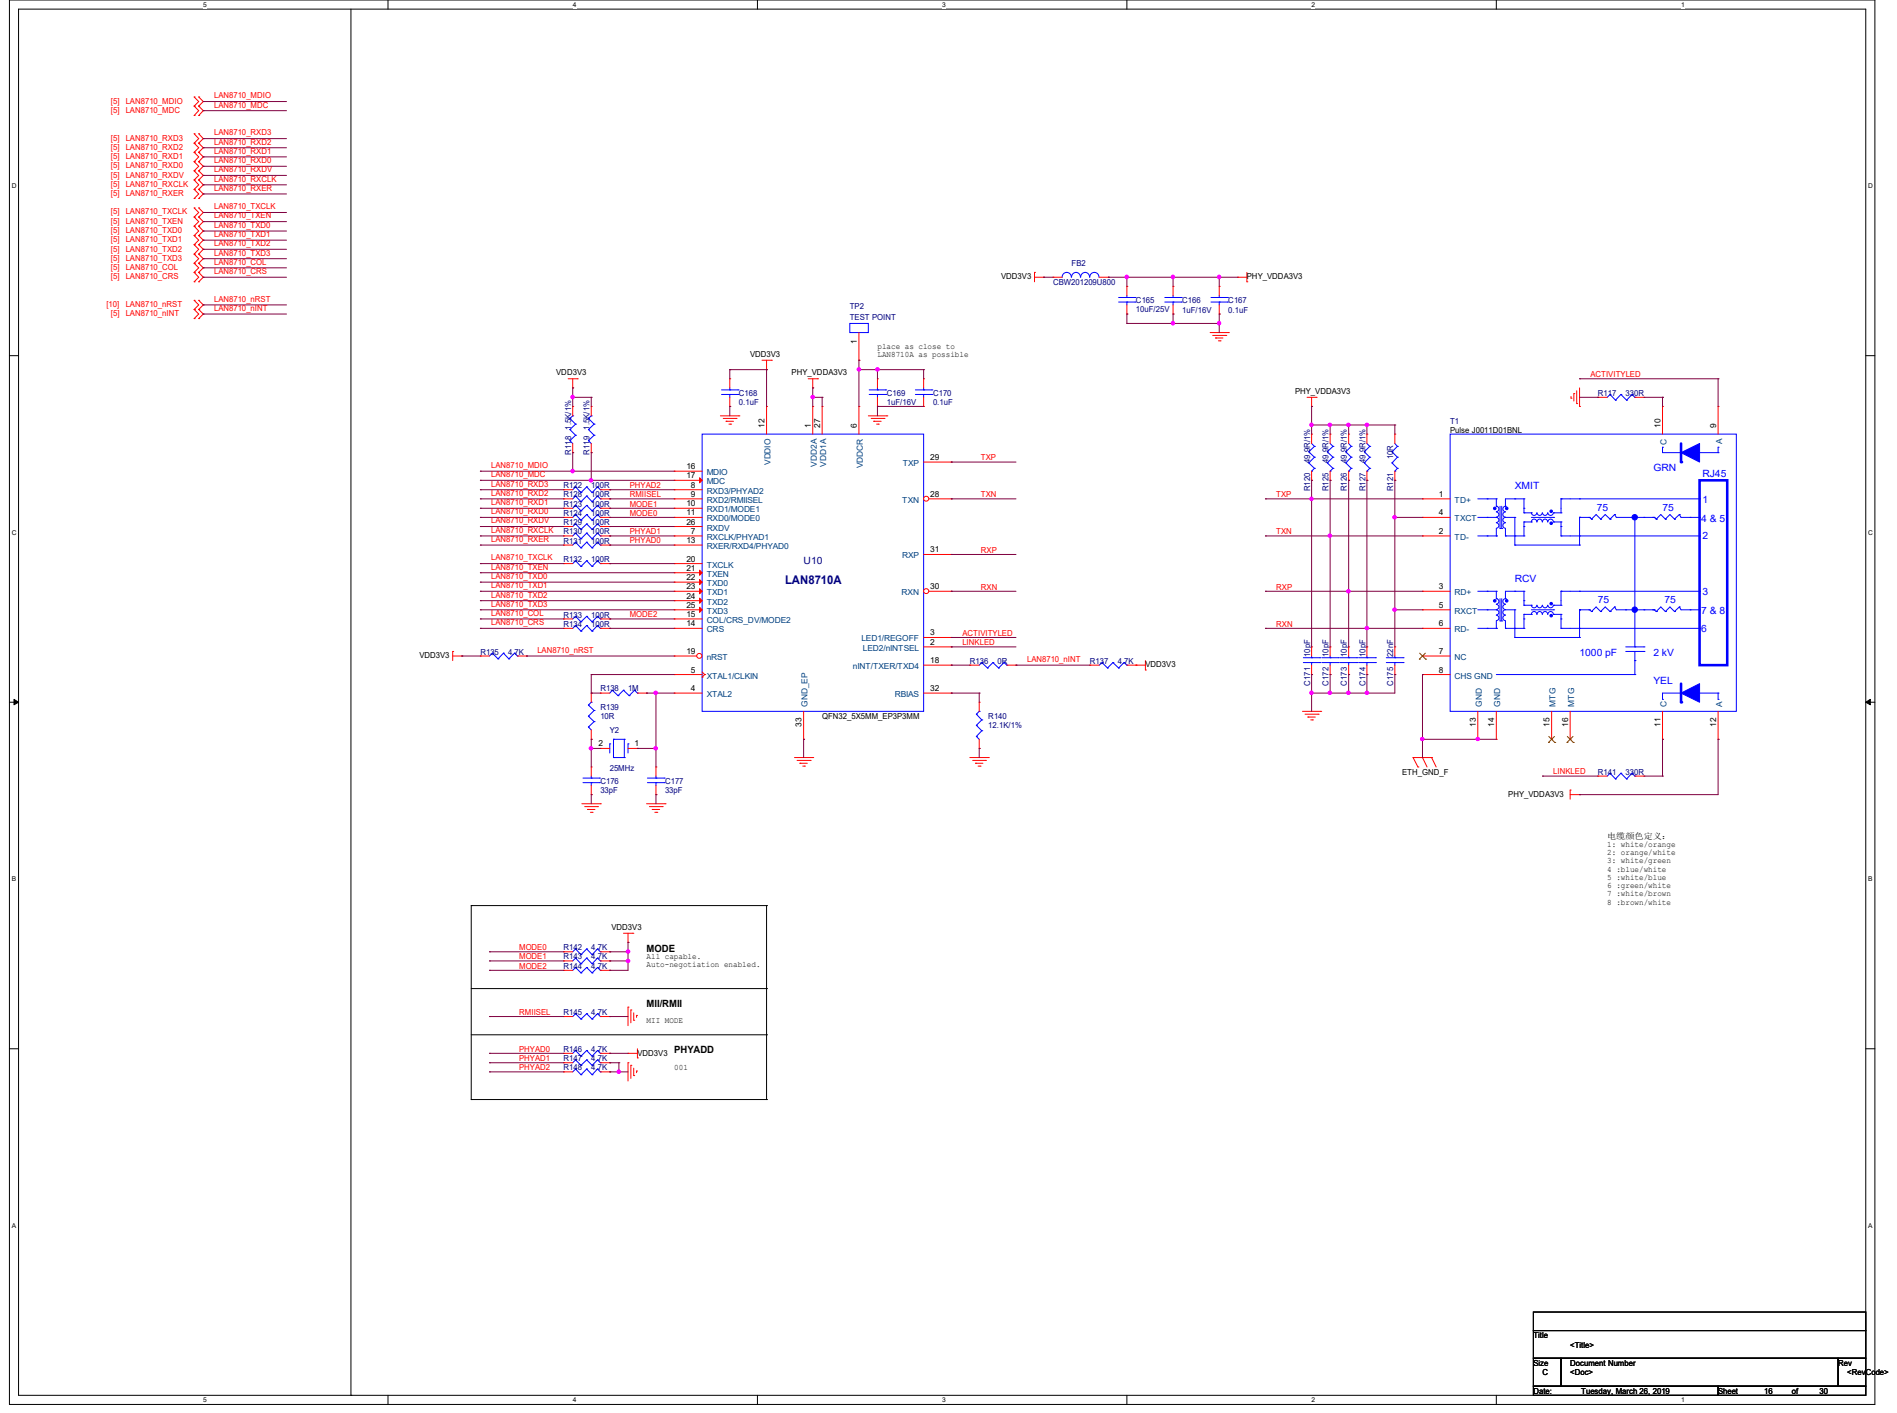
[picture p65: page 16]

place as close to
LAN8710A as possible

6 RXP 31 RXN 30 TXN 28 TXP 29

MDIO 16 MDC 17 RXD3/PHYAD2 8 RXD2/RMIISEL 9 RXD1/MODE1 10 RXD0/MODE0 11 RXDV 26 RXCLK/PHYAD1 7 RXER/RXD4/PHYAD0 13 TXCLK 20 TXEN 21 TXD0 22 TXD1 23 TXD2 24 TXD3 25 COL/CRS_DV/MODE2 15 CRS 14

8 :brown/white PHYADD MII/RMII MODE

# U11 USR-LTE-7S4

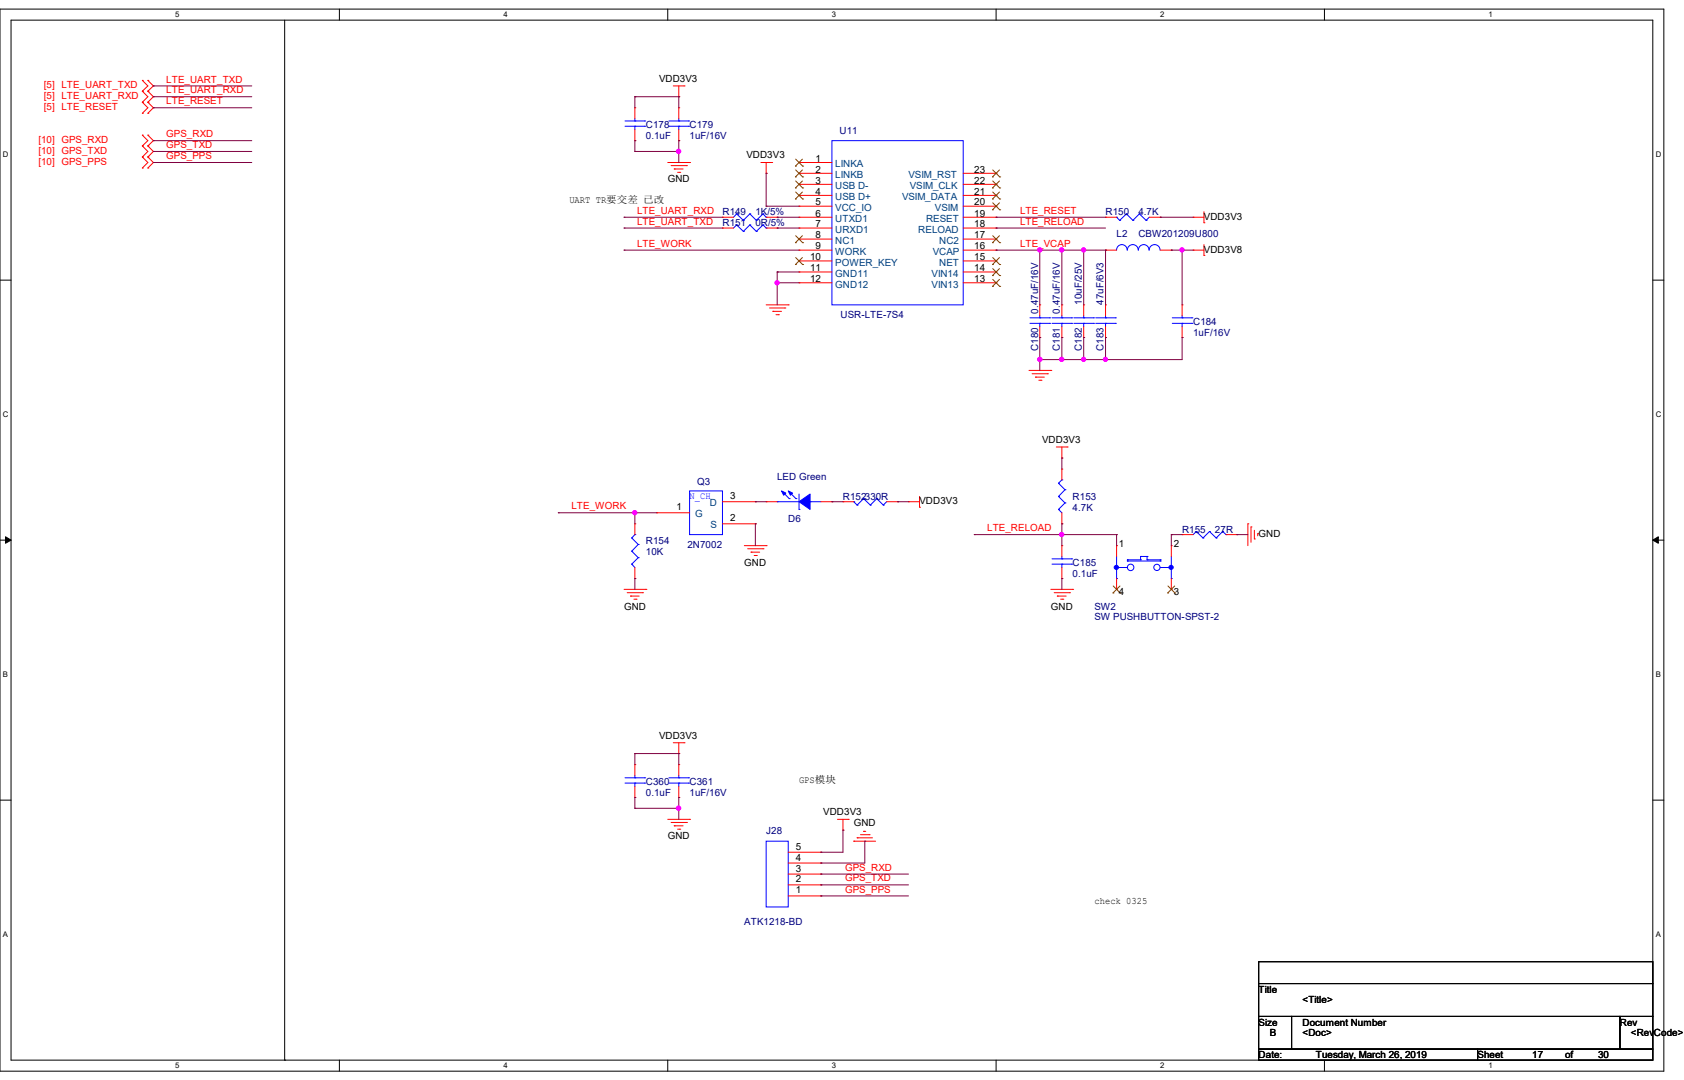
[picture p66: page 17]

# R158 1K U17

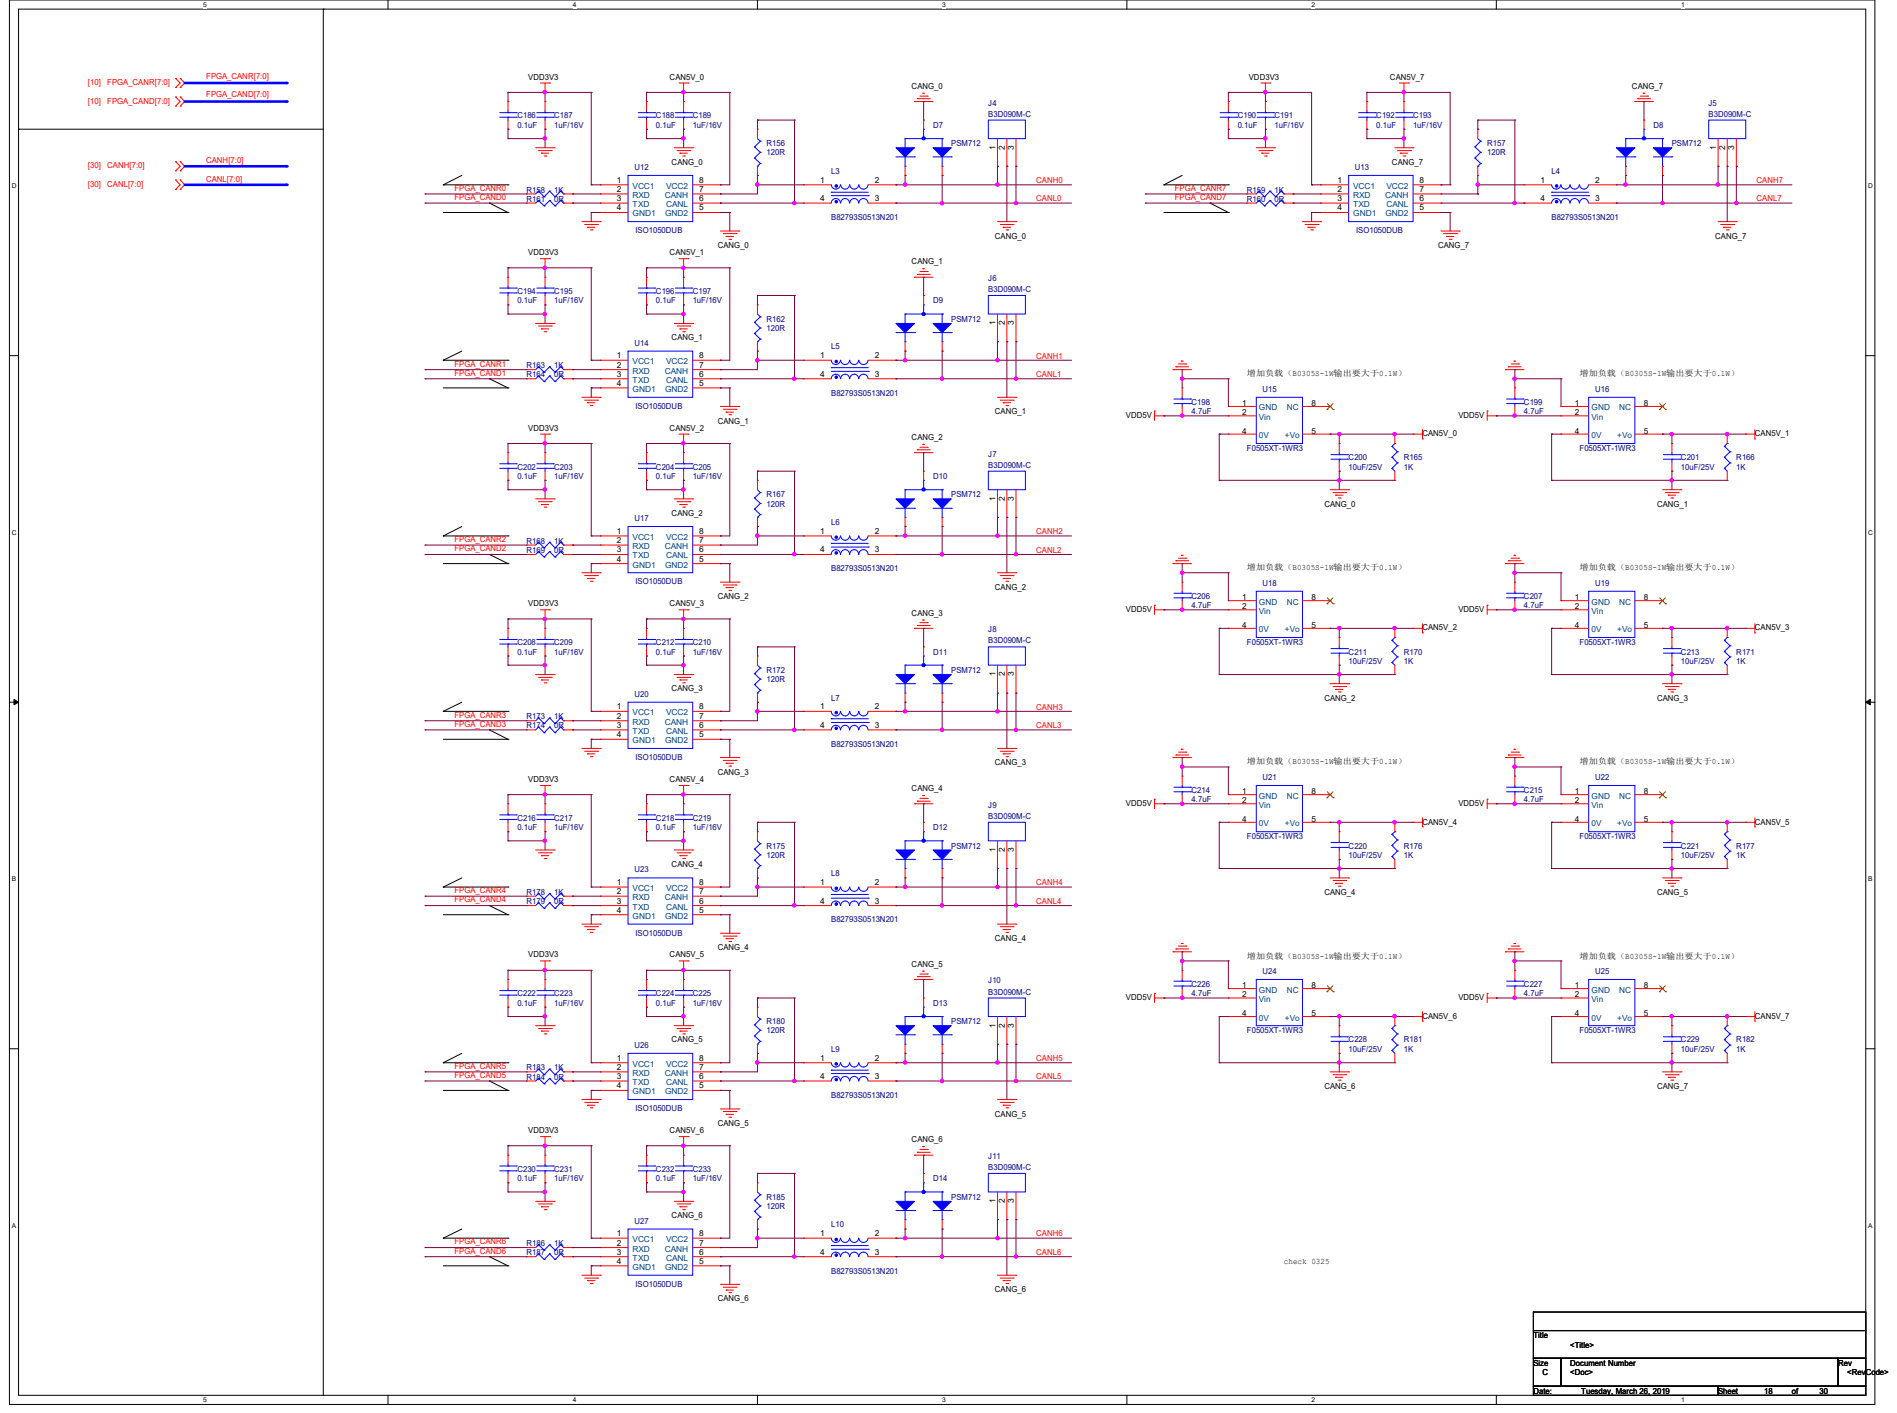
[picture p67: page 18]

10K R204

RS485_RX1 RS485_RX2 RS485_RX3 RS485_RX4 RS485_TX1 RS485_TX2 RS485_TX3 RS485_TX4 RS485_RD1 RS485_RD2 RS485_RD3 RS485_RD4 MAX485_B1 MAX485_A1 MAX485_A2 MAX485_A3 MAX485_A4 MAX485_B2 MAX485_B3 MAX485_B4 UART_TX1 UART_TX2 UART_TX3 UART_TX4 UART_RX1 UART_RX2 UART_RX3 UART_RX4 RS232_TX1 RS232_RX1 RS232_TX2 RS232_TX3 RS232_TX4 RS232_RX2 RS232_RX3 RS232_RX4

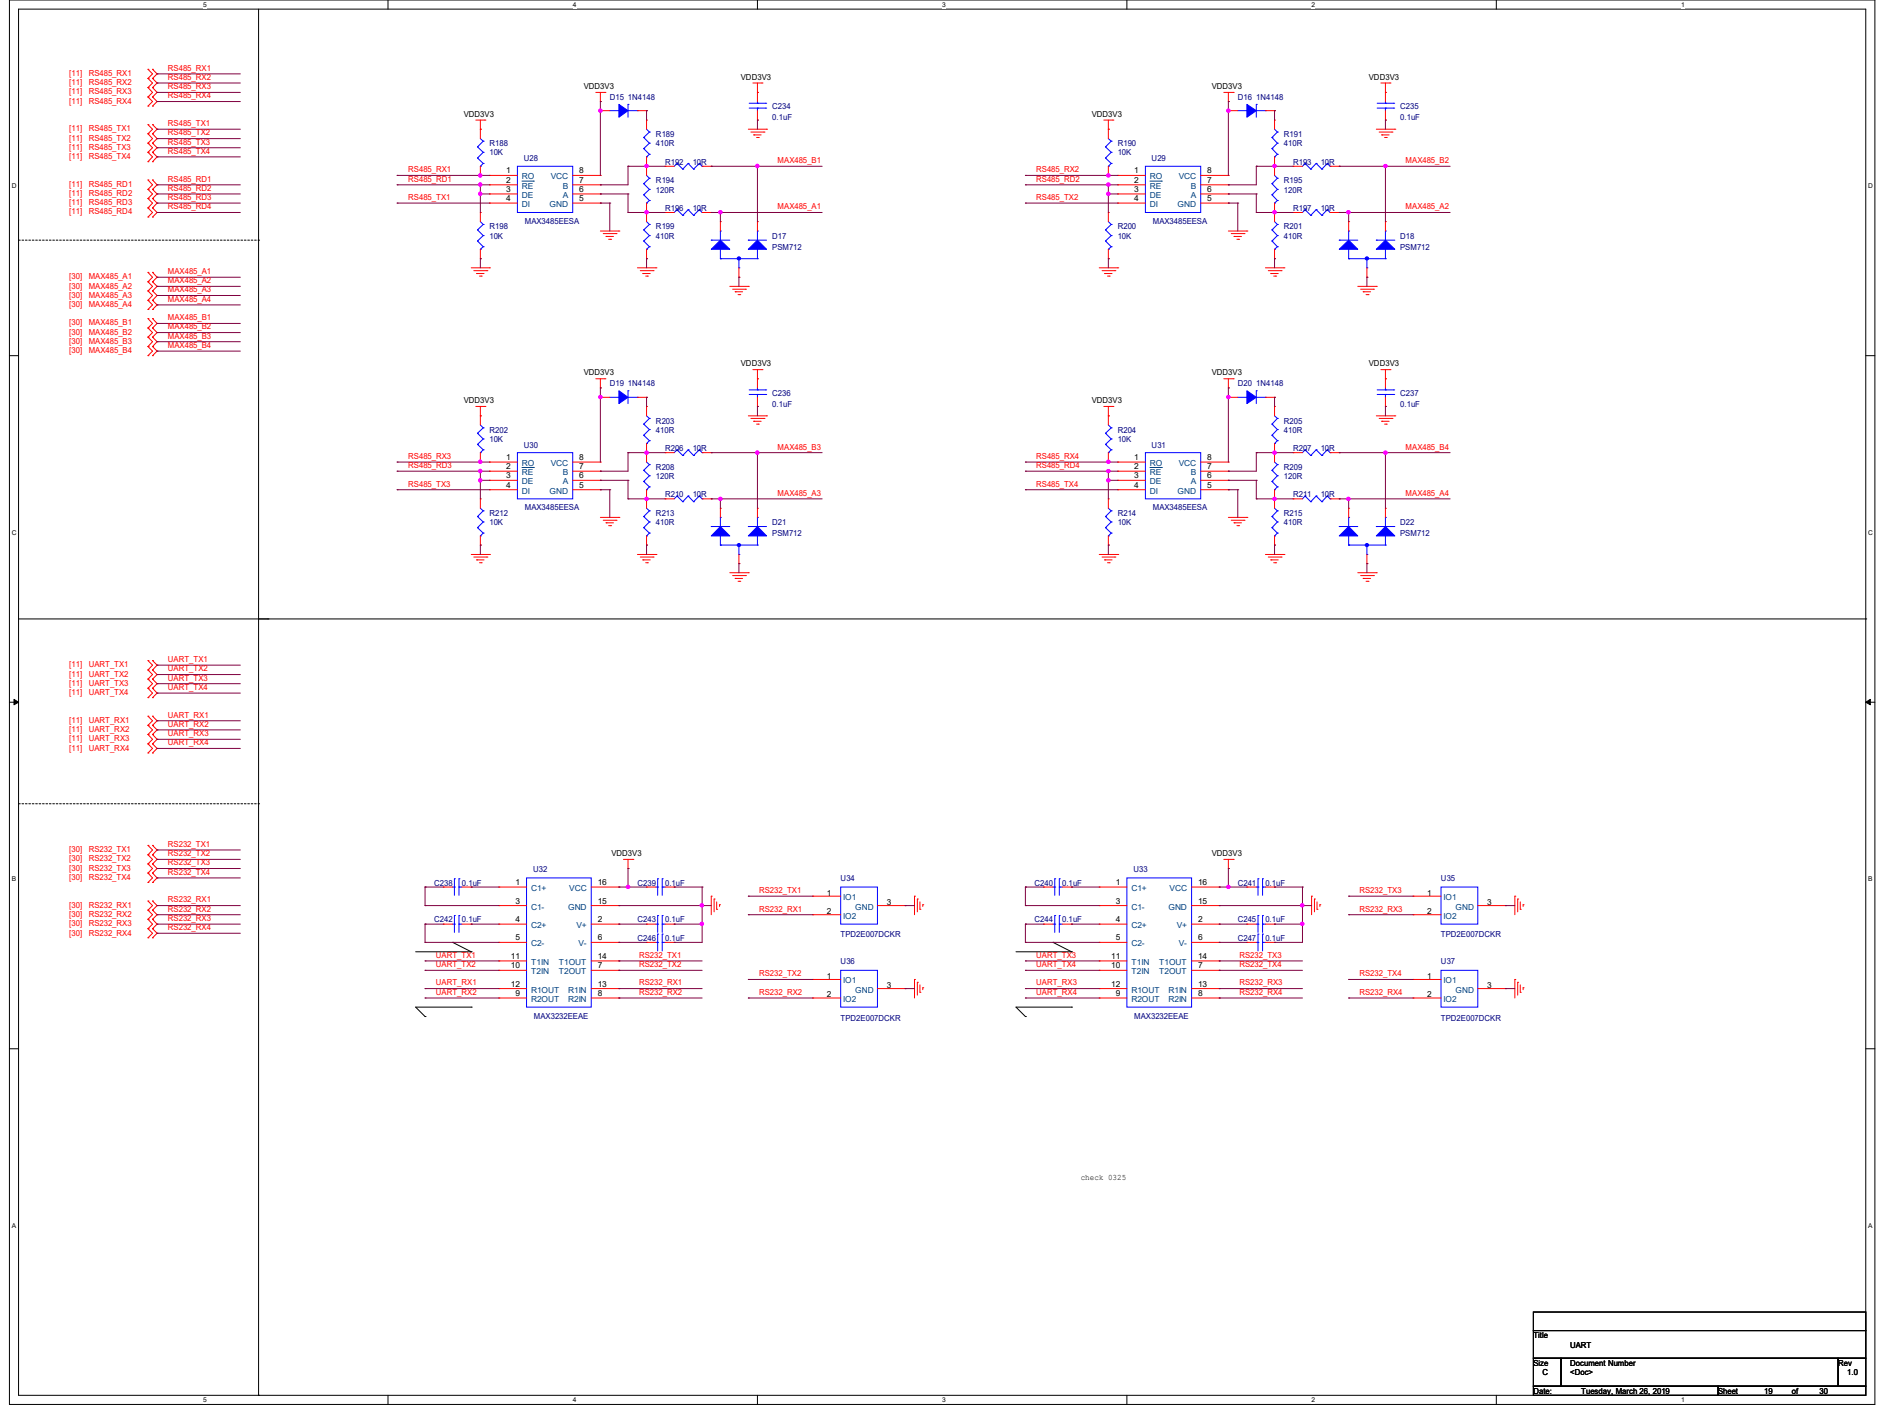
[picture p68: page 19]

# RL2 APAN3124

# RL1 APAN3124

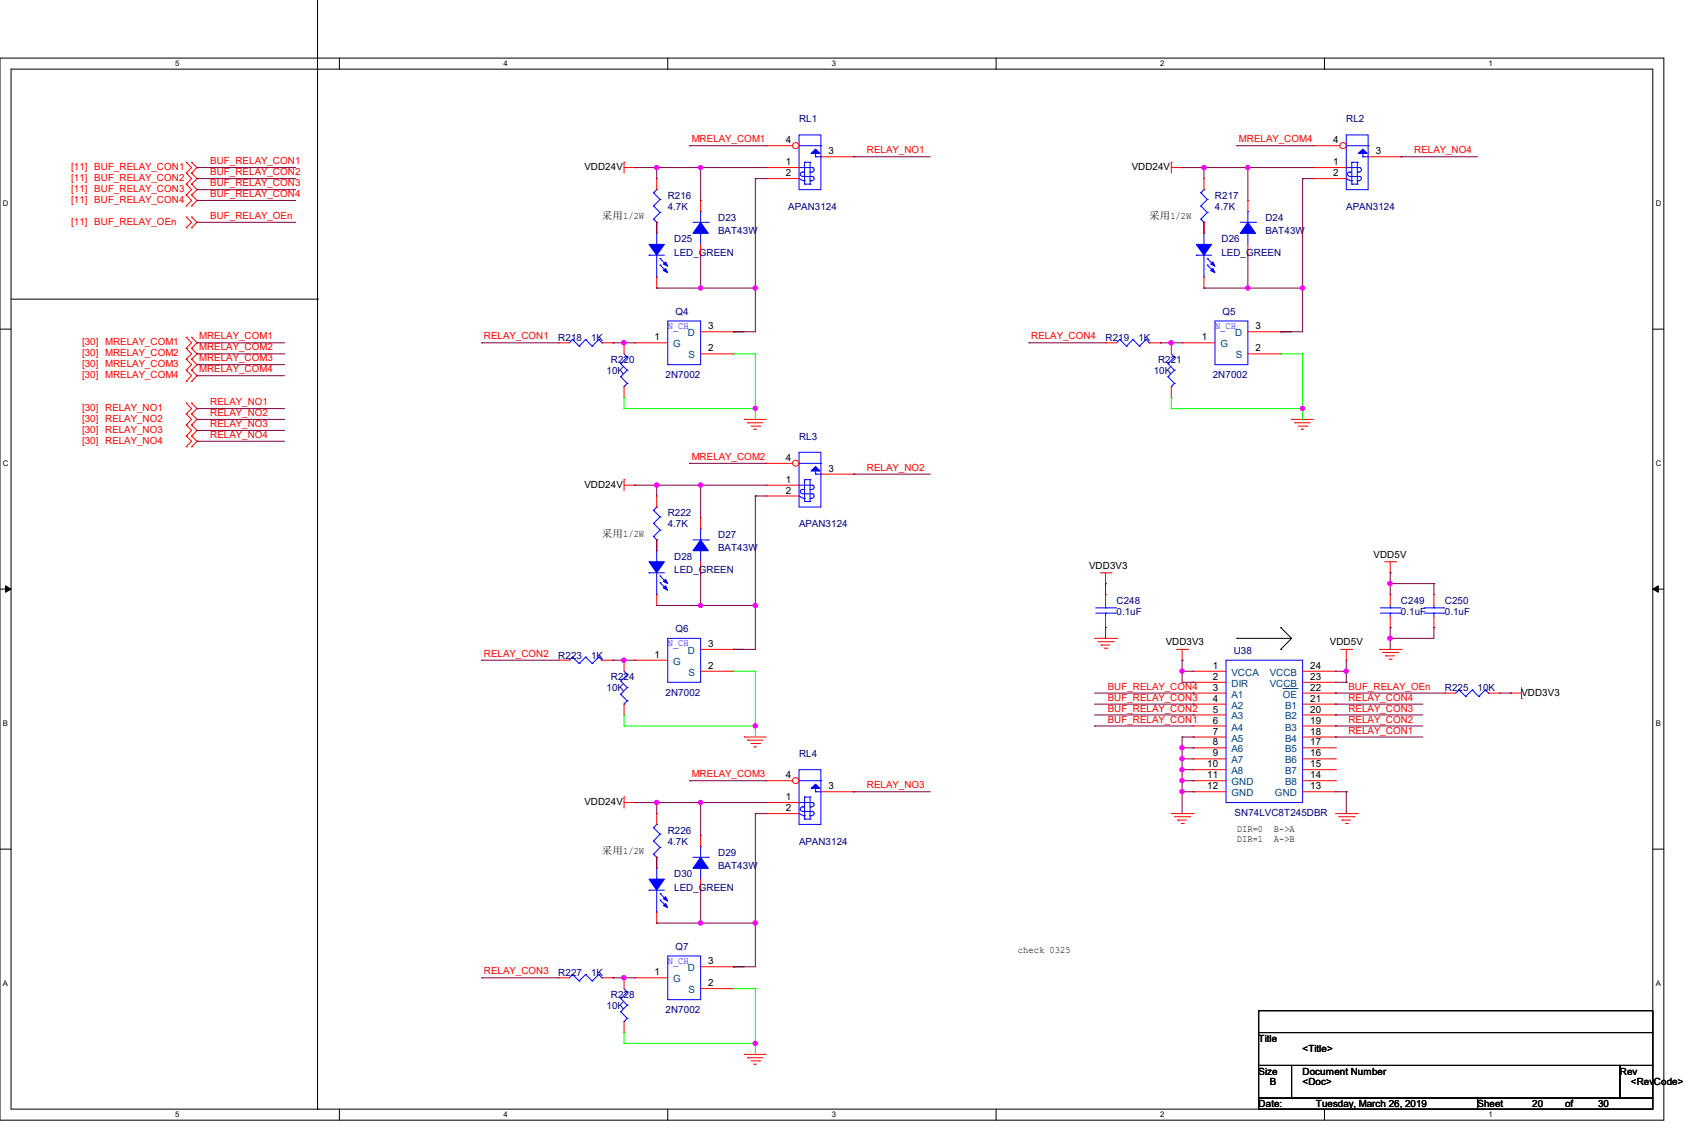
[picture p69: page 20]

[11] BUF_RELAY_CON1 BUF_RELAY_CON2 [11] BUF_RELAY_CON2 BUF_RELAY_CON3 [11] BUF_RELAY_CON3 BUF_RELAY_CON4 [11] BUF_RELAY_CON4 BUF_RELAY_OEn [11] BUF_RELAY_OEn | MRELAY_COM1 4 MRELAY_COM4 4

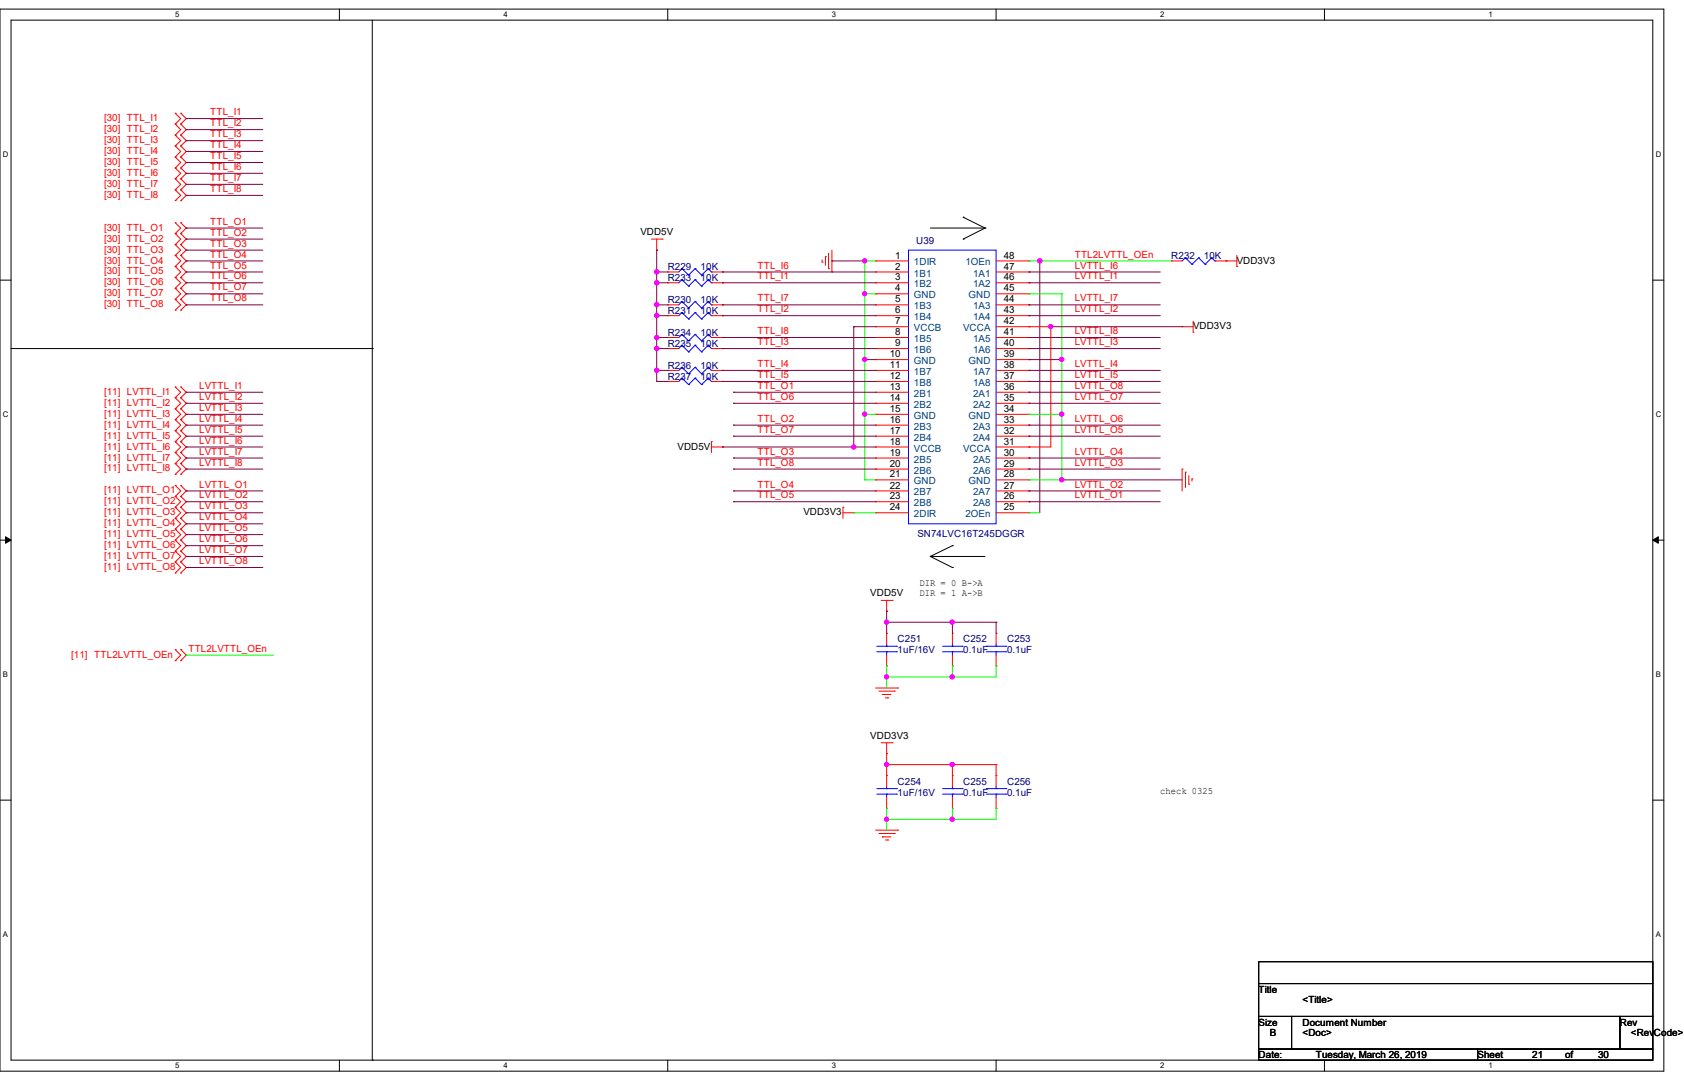
[picture p70: page 21]

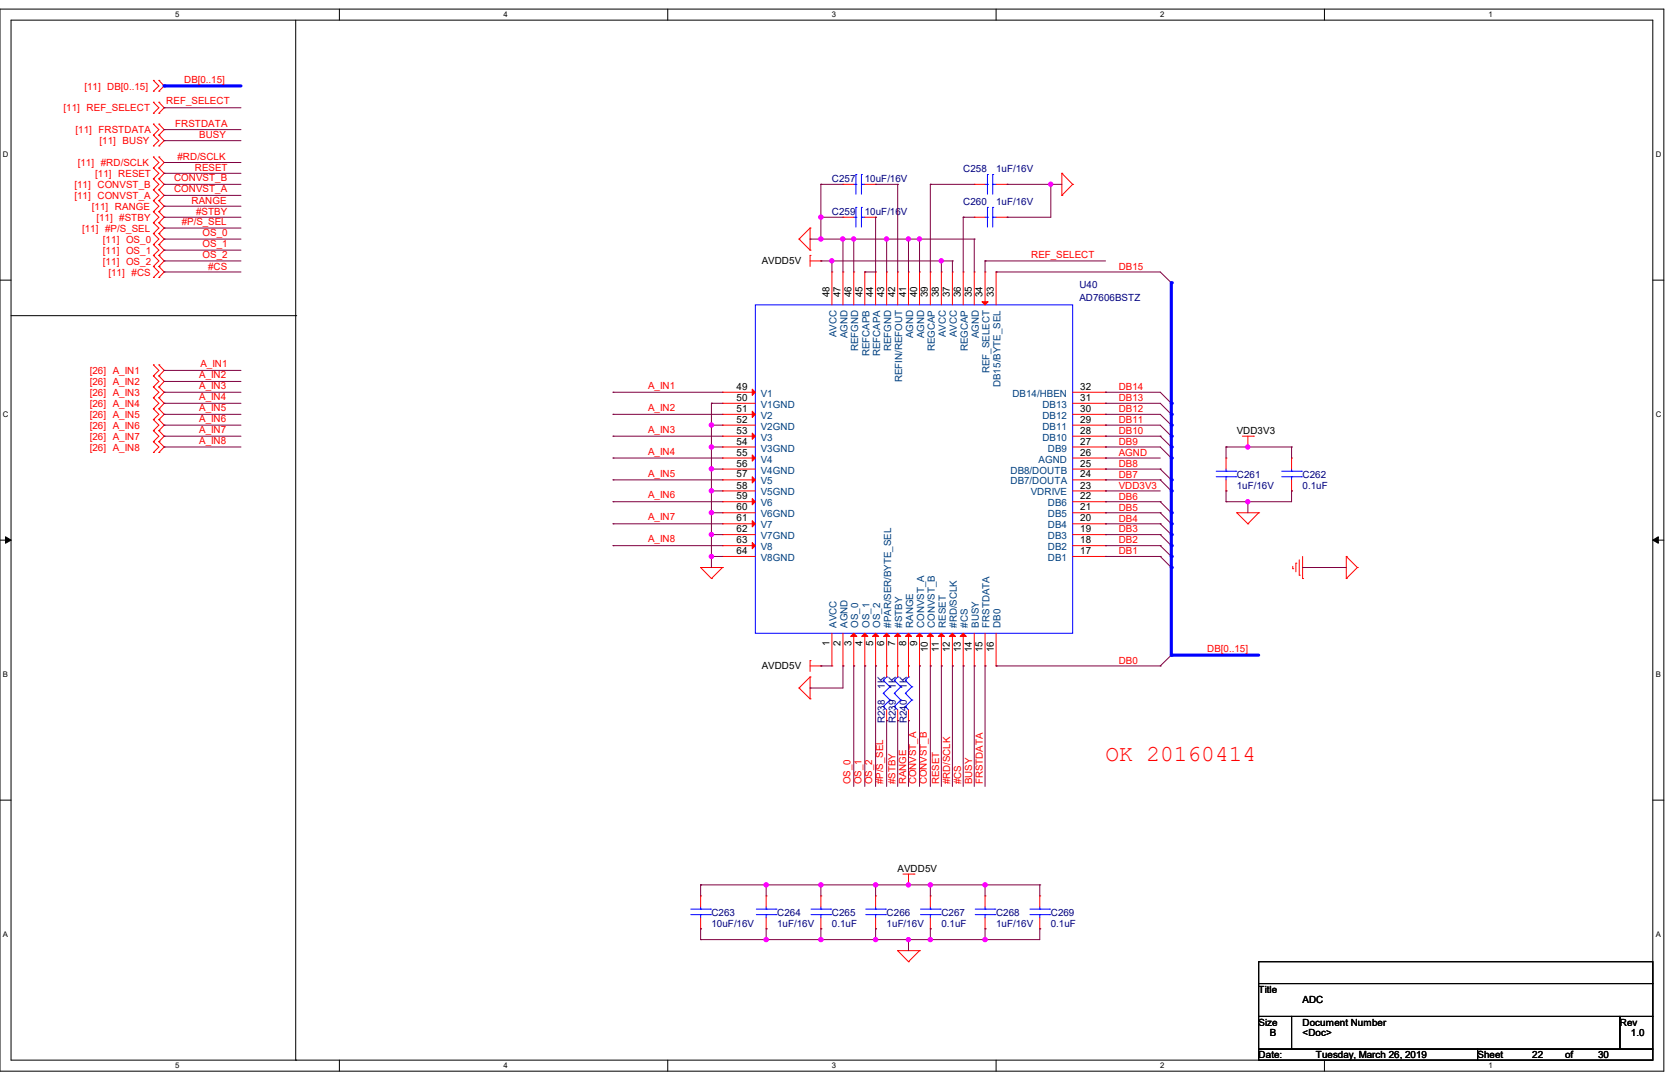
[picture p71: page 22]

## [5,15] DSP_SDA [5,15] DSP_SCL

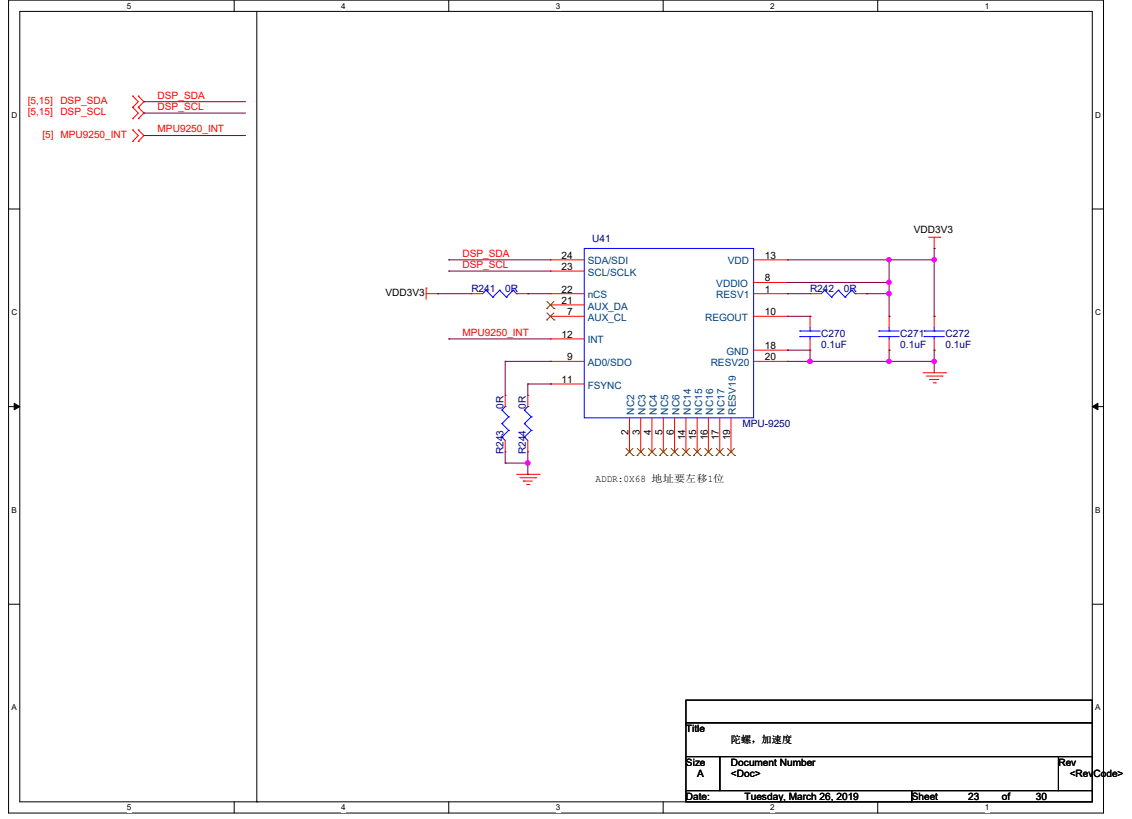
[picture p72: page 23]
ADDR:0X68 地址要左移1位; VDD3V3; [5] MPU9250_INT; Title; Size; Document Number; Rev; Date:; Sheet; <Doc>; <RevCode>; 陀螺，加速度; Tuesday, March 26, 2019; 0.1uF R²⁴³ ⁰R; R²⁴⁴ ⁰R; MPU-9250; RESV1; 1 NC²; AUX_CL 7; VDDIO; AD0/SDO 9; REGOUT; FSYNC 11; INT 12; VDD; 13 NC¹⁴ 14 NC¹⁵ 15 NC¹⁶ 16 NC¹⁷ 17; GND; 18 RESV¹⁹ 19; RESV20; AUX_DA 21; nCS 22; SCL/SCLK 23; SDA/SDI 24; DSP_SDA DSP_SCL; MPU9250_INT; DSP_SCL; DSP_SDA

## DSP 1.2V OSCILLATOR

## DSP Oscillator frequency range 12MHz~30MHz

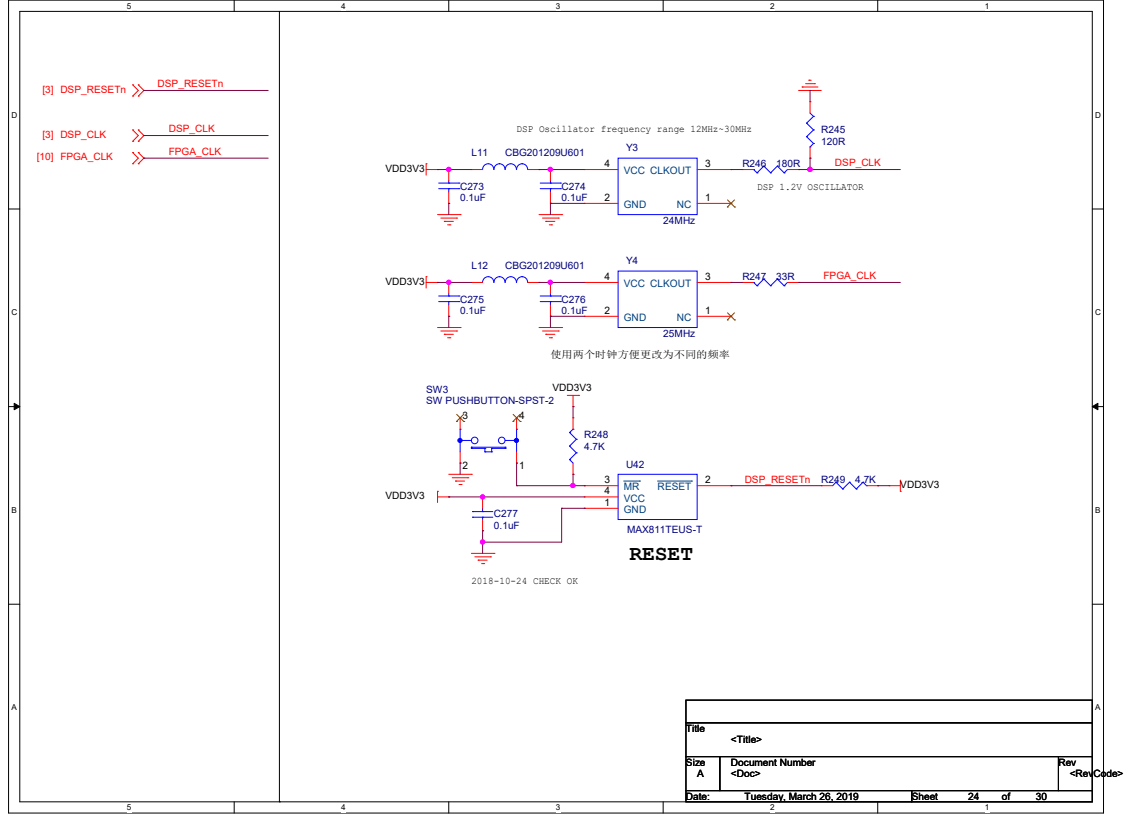
[picture p73: page 24]

## [10] SPK_CN

## SPK_CN

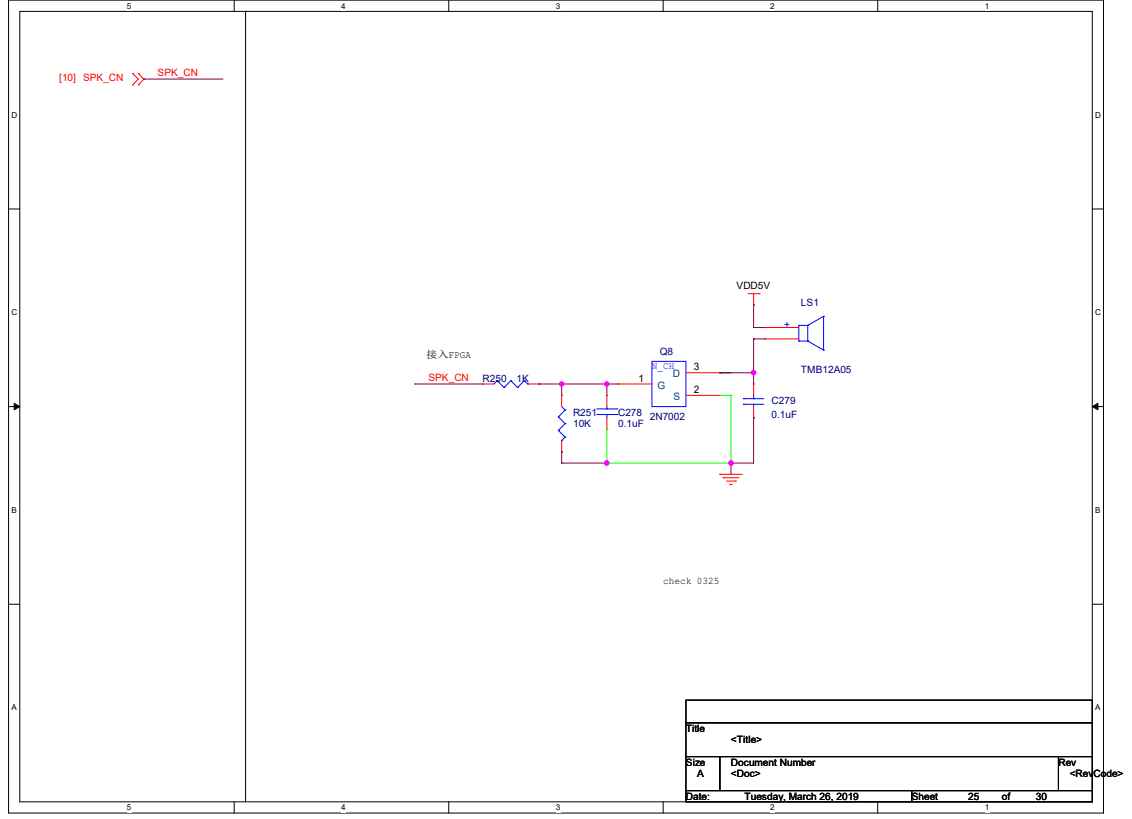
[picture p74: page 25]
接入FPGA; check 0325; VDD5V; Title; Size; Document Number; Rev; Date:; Sheet; <Doc>; <RevCode>; <Title>; Tuesday, March 26, 2019; TMB12A05; SPK_CN

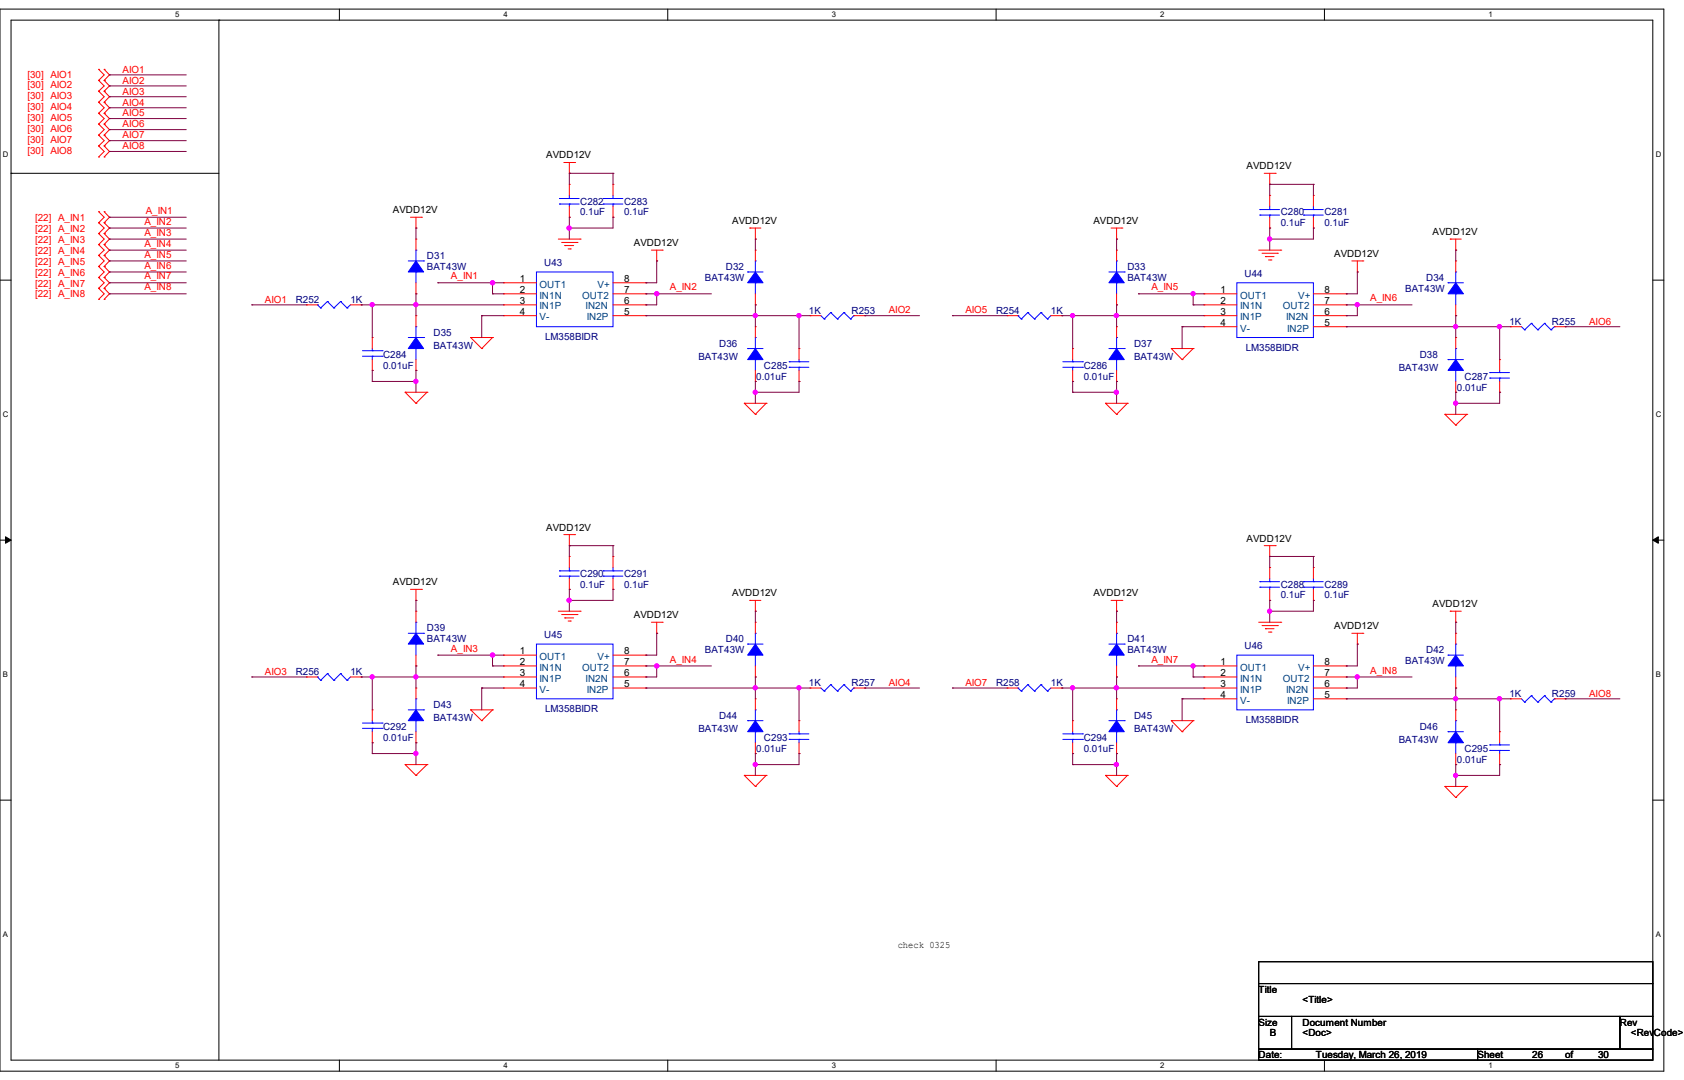
[picture p75: page 26]

# R264 4.7K C300

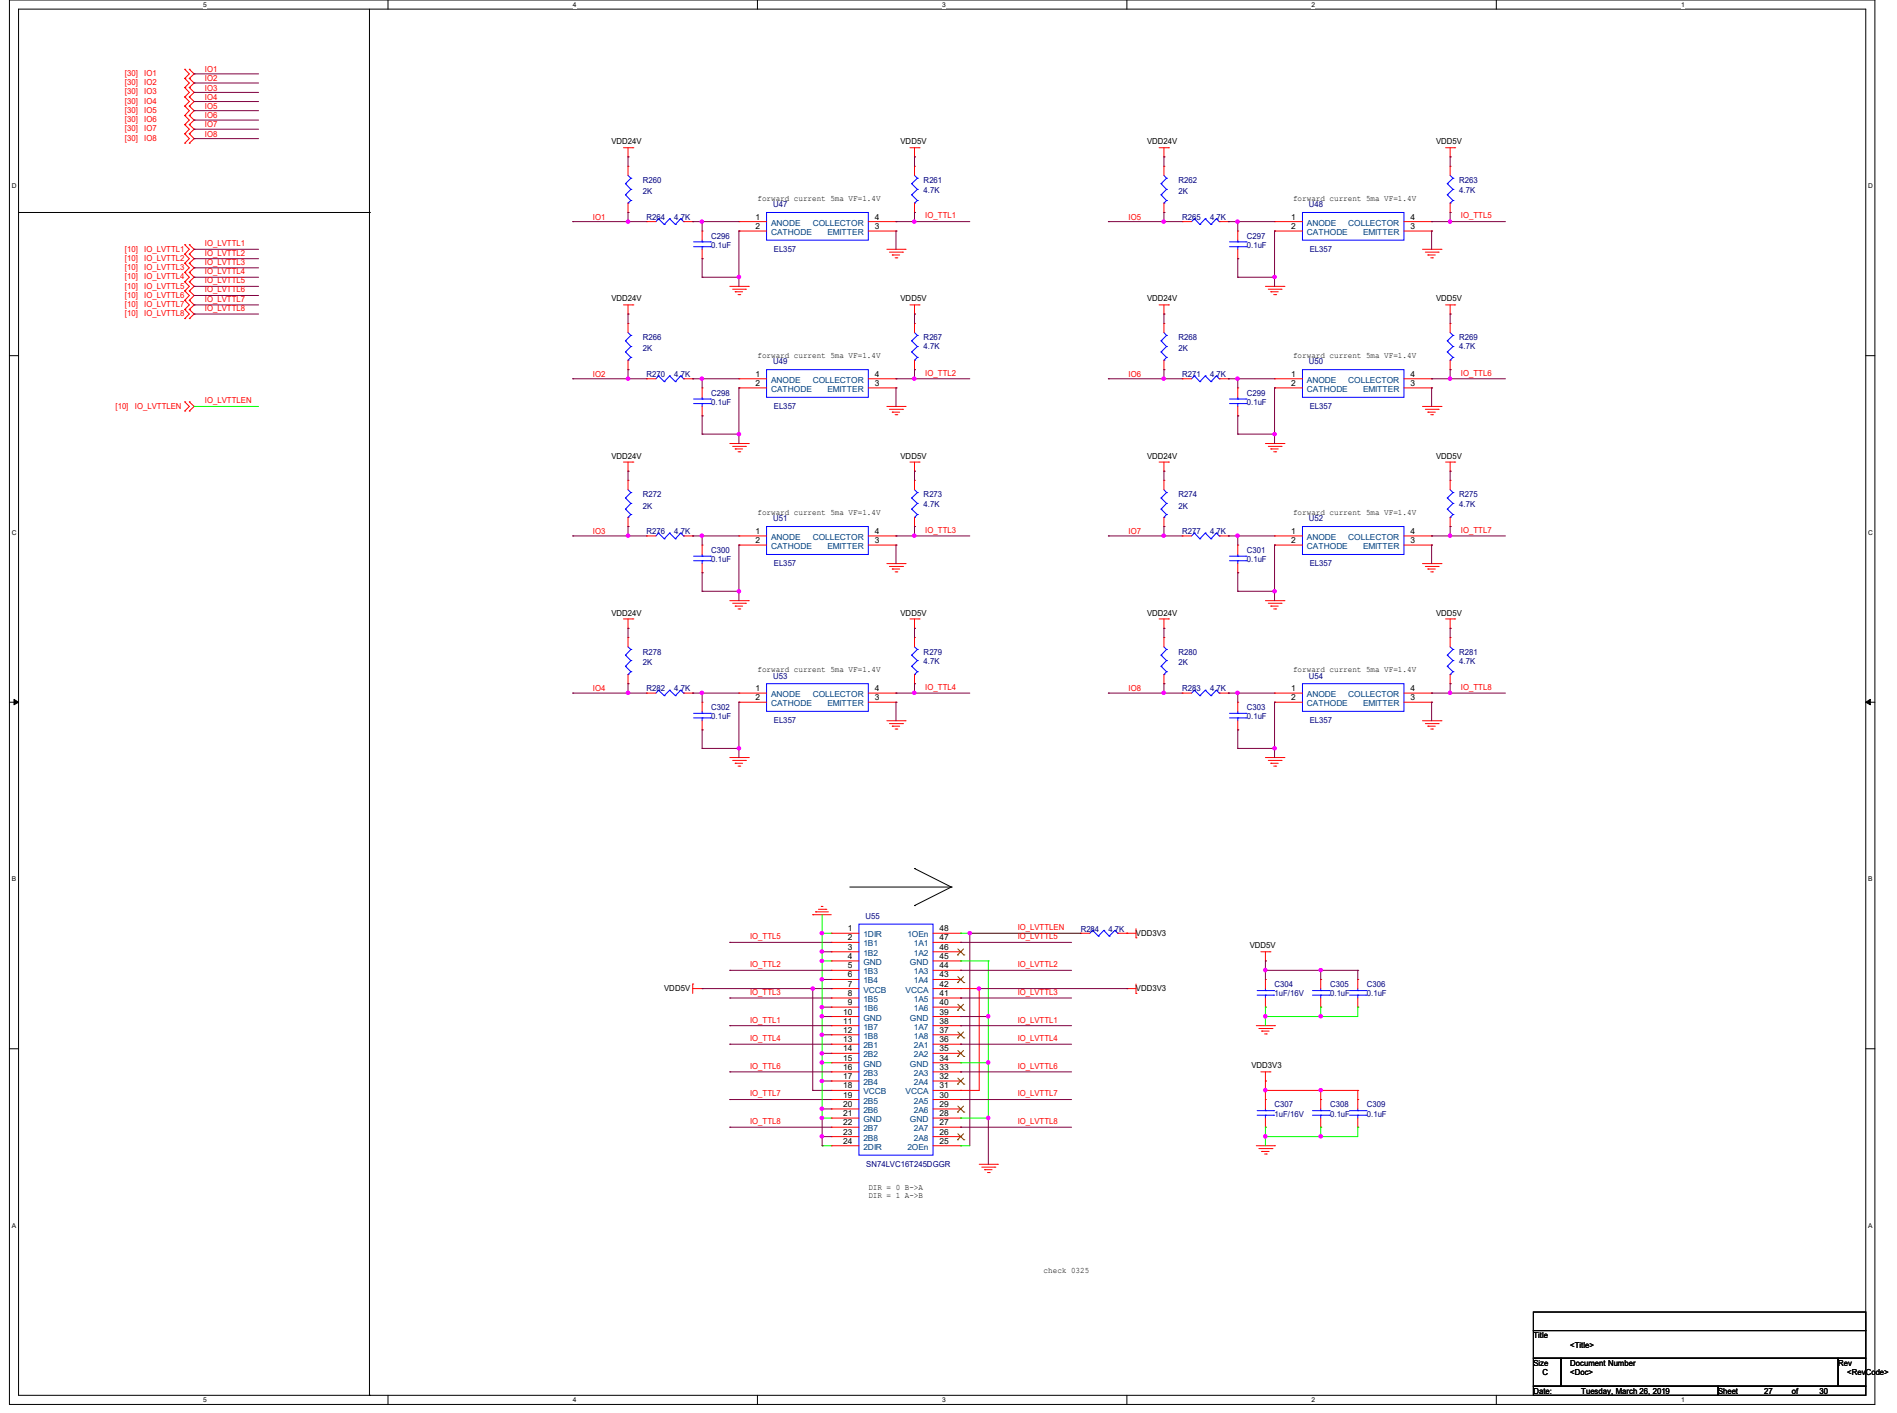
[picture p76: page 27]

# D47 SMAJ26AC323

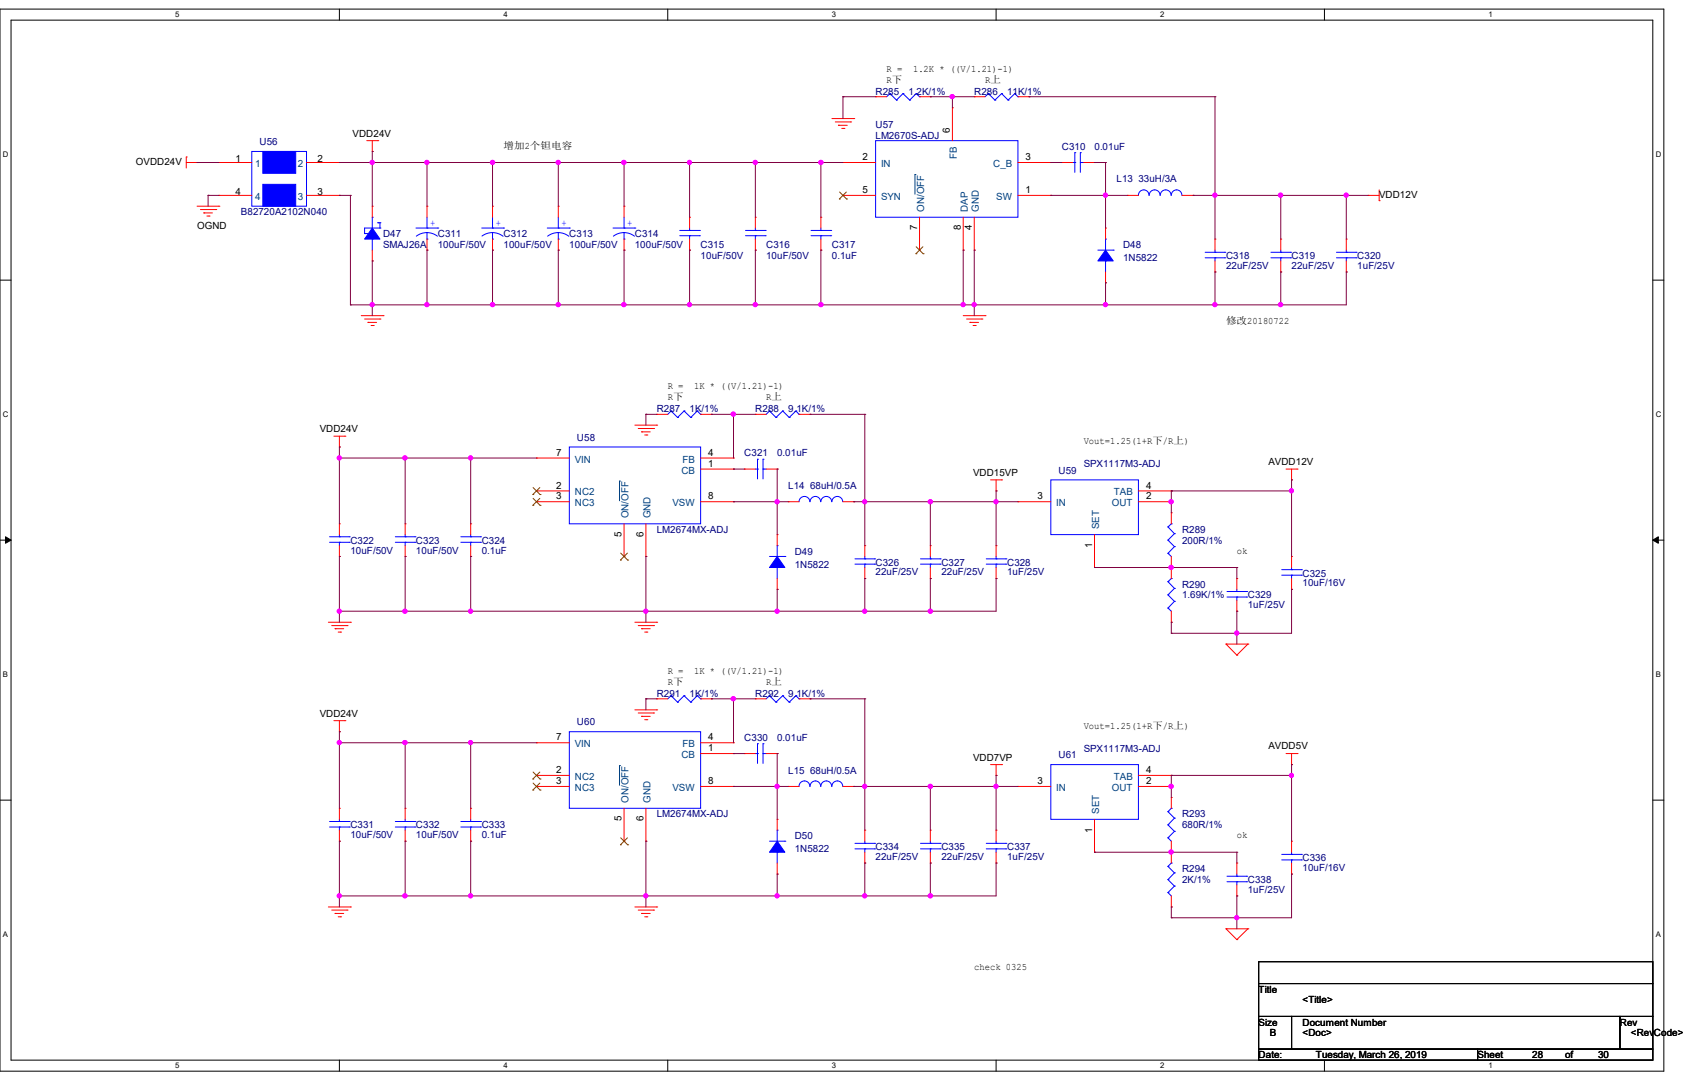
[picture p77: page 28]

注意：VIN>VOUT | 3.3V 4A
COMP1 | B7 COMP2 | E7 COMP3 | H7 COMP4 | L7

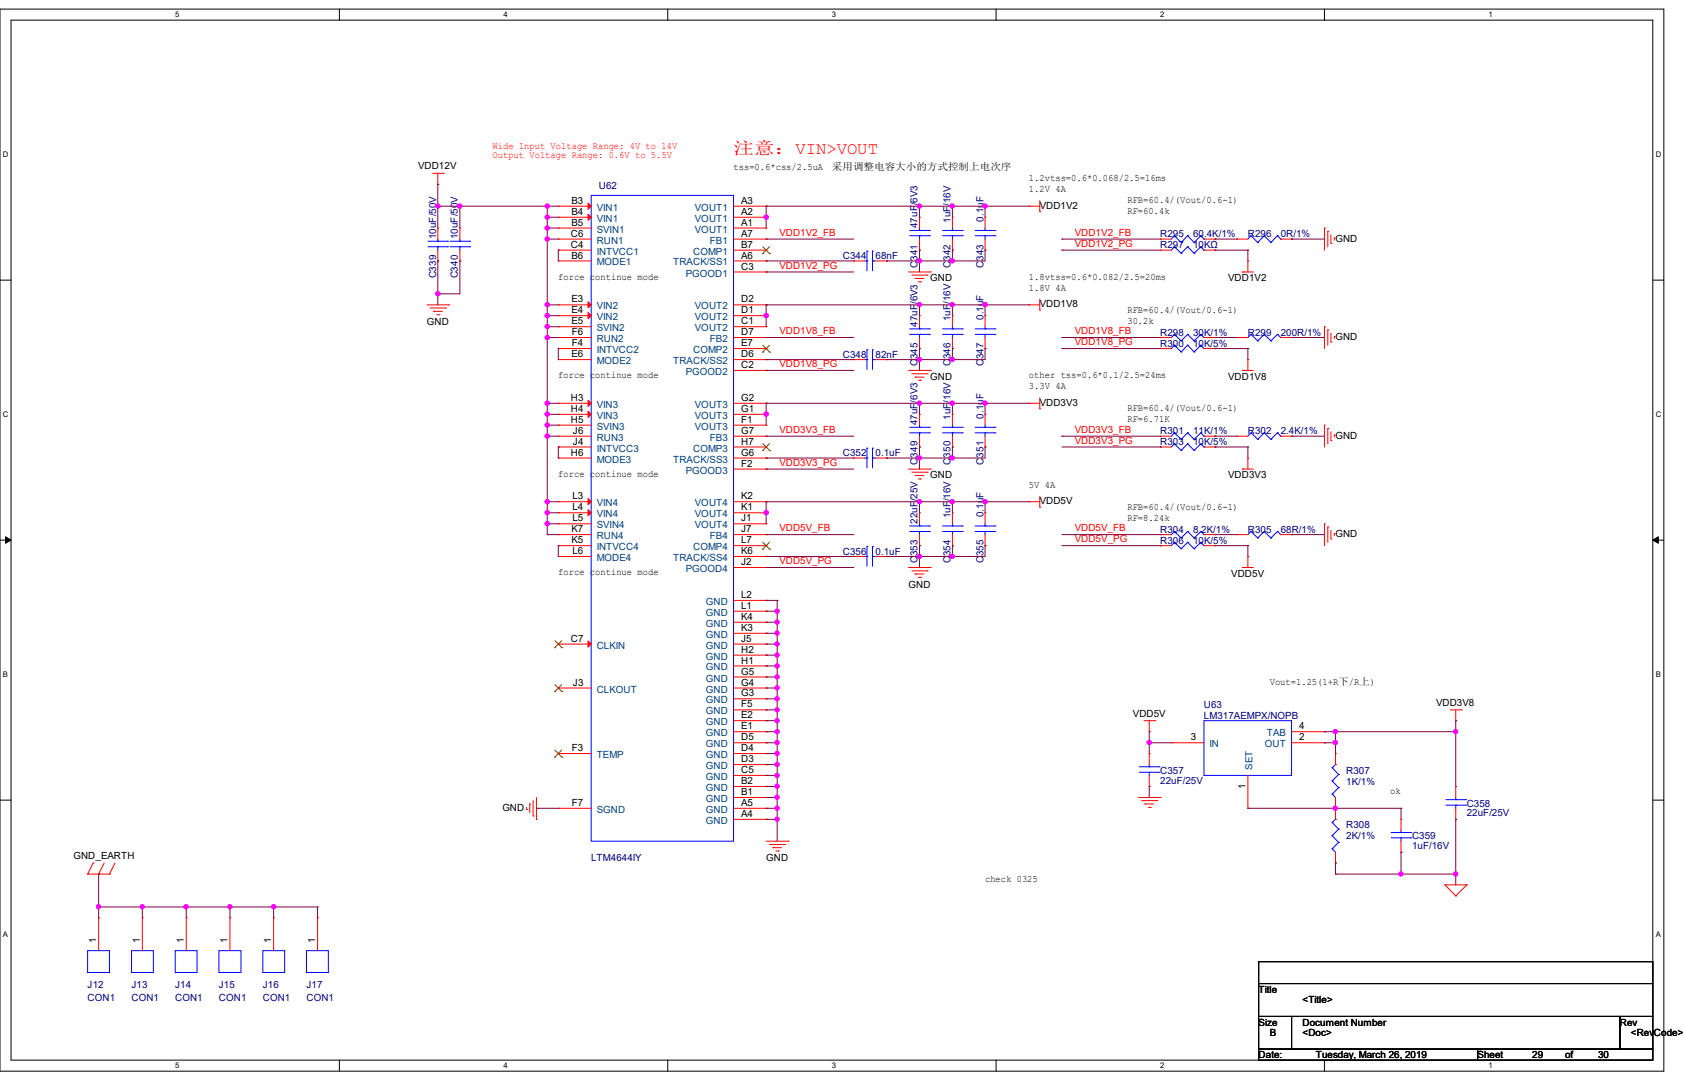
[picture p78: page 29]

Wide Input Voltage Range: 4V to 14V
Output Voltage Range: 0.6V to 5.5V

22uF/25V C³⁵⁰ ¹uF/16V
R304 8.2K/1% C³⁴⁹ ⁴⁷uF/6V³ C³⁵³ ²²uF/25V

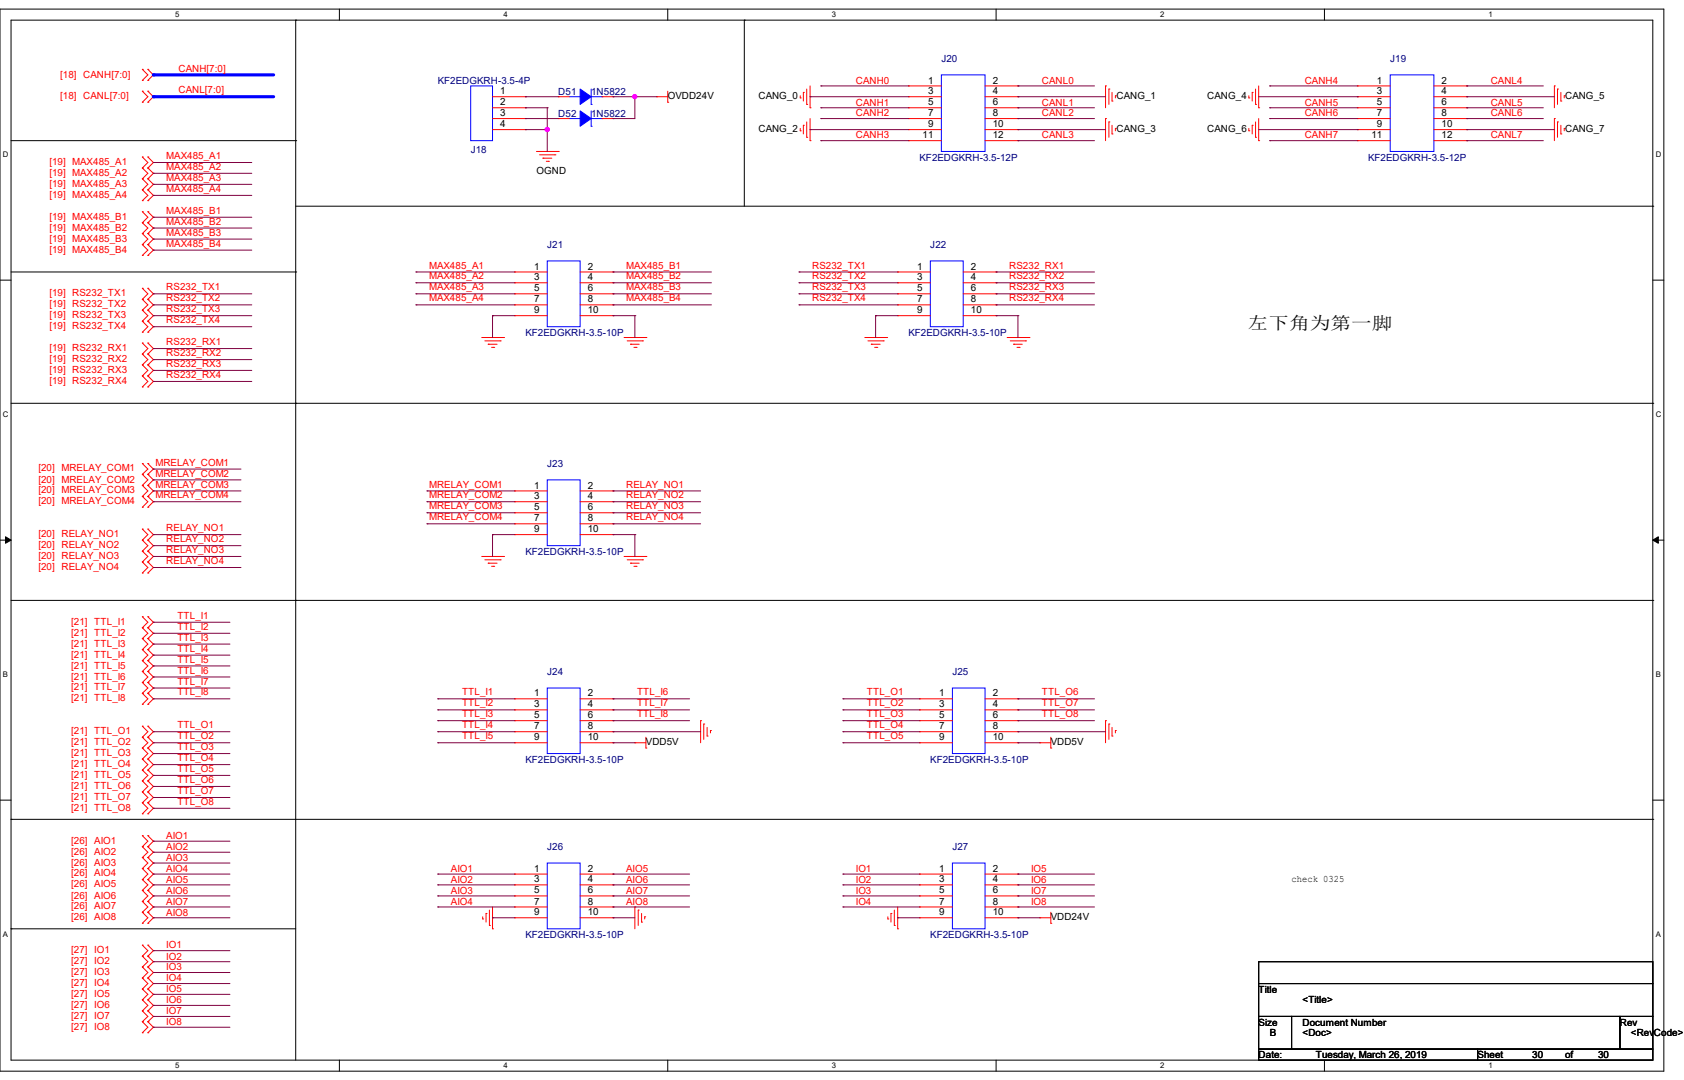
[picture p79: page 30]

MRELAY_COM1 [20] MRELAY_COM1 MRELAY_COM2 [20] MRELAY_COM2 MRELAY_COM3 [20] MRELAY_COM3 MRELAY_COM4 [20] MRELAY_COM4 RELAY_NO1 [20] RELAY_NO1 RELAY_NO2 [20] RELAY_NO2 RELAY_NO3 [20] RELAY_NO3 RELAY_NO4 [20] RELAY_NO4 | J23 KF2EDGKRH-3.5-10P 1 2 3 4 5 6 7 8 9 10 MRELAY_COM1 RELAY_NO1 MRELAY_COM2 RELAY_NO2 MRELAY_COM3 RELAY_NO3 MRELAY_COM4 RELAY_NO4

TTL_I1 [21] TTL_I1 TTL_I2 [21] TTL_I2 TTL_I3 [21] TTL_I3 TTL_I4 [21] TTL_I4 TTL_I5 [21] TTL_I5 TTL_I6 [21] TTL_I6 TTL_I7 [21] TTL_I7 TTL_I8 [21] TTL_I8 TTL_O1 [21] TTL_O1 TTL_O2 [21] TTL_O2 TTL_O3 [21] TTL_O3 [21] TTL_O4 TTL_O4 TTL_O5 [21] TTL_O5 TTL_O6 [21] TTL_O6 TTL_O7 [21] TTL_O7 TTL_O8 [21] TTL_O8 | J24 KF2EDGKRH-3.5-10P 1 2 3 4 5 6 7 8 9 10 J25 KF2EDGKRH-3.5-10P 1 2 3 4 5 6 7 8 9 10 TTL_I1 TTL_I6 TTL_O1 TTL_O6 TTL_I2 TTL_I7 TTL_O2 TTL_O7 TTL_I3 TTL_I8 TTL_O3

IO8 AIO1 AIO2 AIO3 AIO4 AIO5 AIO6 AIO7 AIO8 [26] AIO1 [26] AIO2 [26] AIO3 [26] AIO4 [26] AIO5 [26] AIO6 [26] AIO7 [26] AIO8 | J26 KF2EDGKRH-3.5-10P 1 2 3 4 5 6 7 8 9 10 J27 KF2EDGKRH-3.5-10P 1 2 3 4 5 6 7 8 9 10 IO1 IO5 IO2 IO6 check 0325 IO3 IO7 IO4 IO8 <Title> B <Title> B <Title> B Tuesday, March 26, 2019 30 30
