donggua127/control_board/doc/3.0sch/jsfs_zk_m_v3.1.pdf

# 01_NOTE 02_BLOCK_DIAGRAM

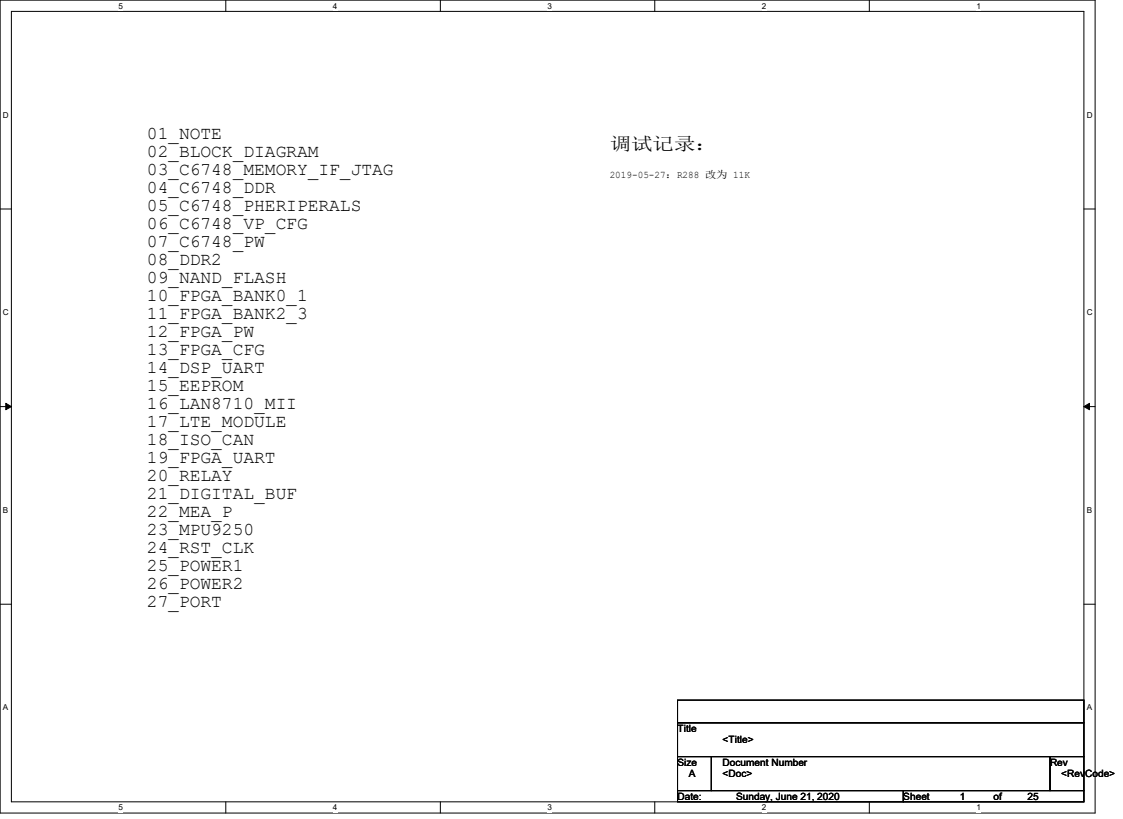
[picture p80: page 1]
03_C6748_MEMORY_IF_JTAG 04_C6748_DDR 05_C6748_PHERIPERALS 06_C6748_VP_CFG 07_C6748_PW 08_DDR2 09_NAND_FLASH 10_FPGA_BANK0_1 11_FPGA_BANK2_3 12_FPGA_PW 13_FPGA_CFG 14_DSP_UART 15_EEPROM 16_LAN8710_MII 17_LTE_MODULE 18_ISO_CAN 19_FPGA_UART 20_RELAY 21_DIGITAL_BUF 22_MEA_P 23_MPU9250 24_RST_CLK 25_POWER1 26_POWER2 27_PORT; 调试记录：; Title; Size; Document Number; Rev; Date:; Sheet; <Doc>; <RevCode>; <Title>; Sunday, June 21, 2020

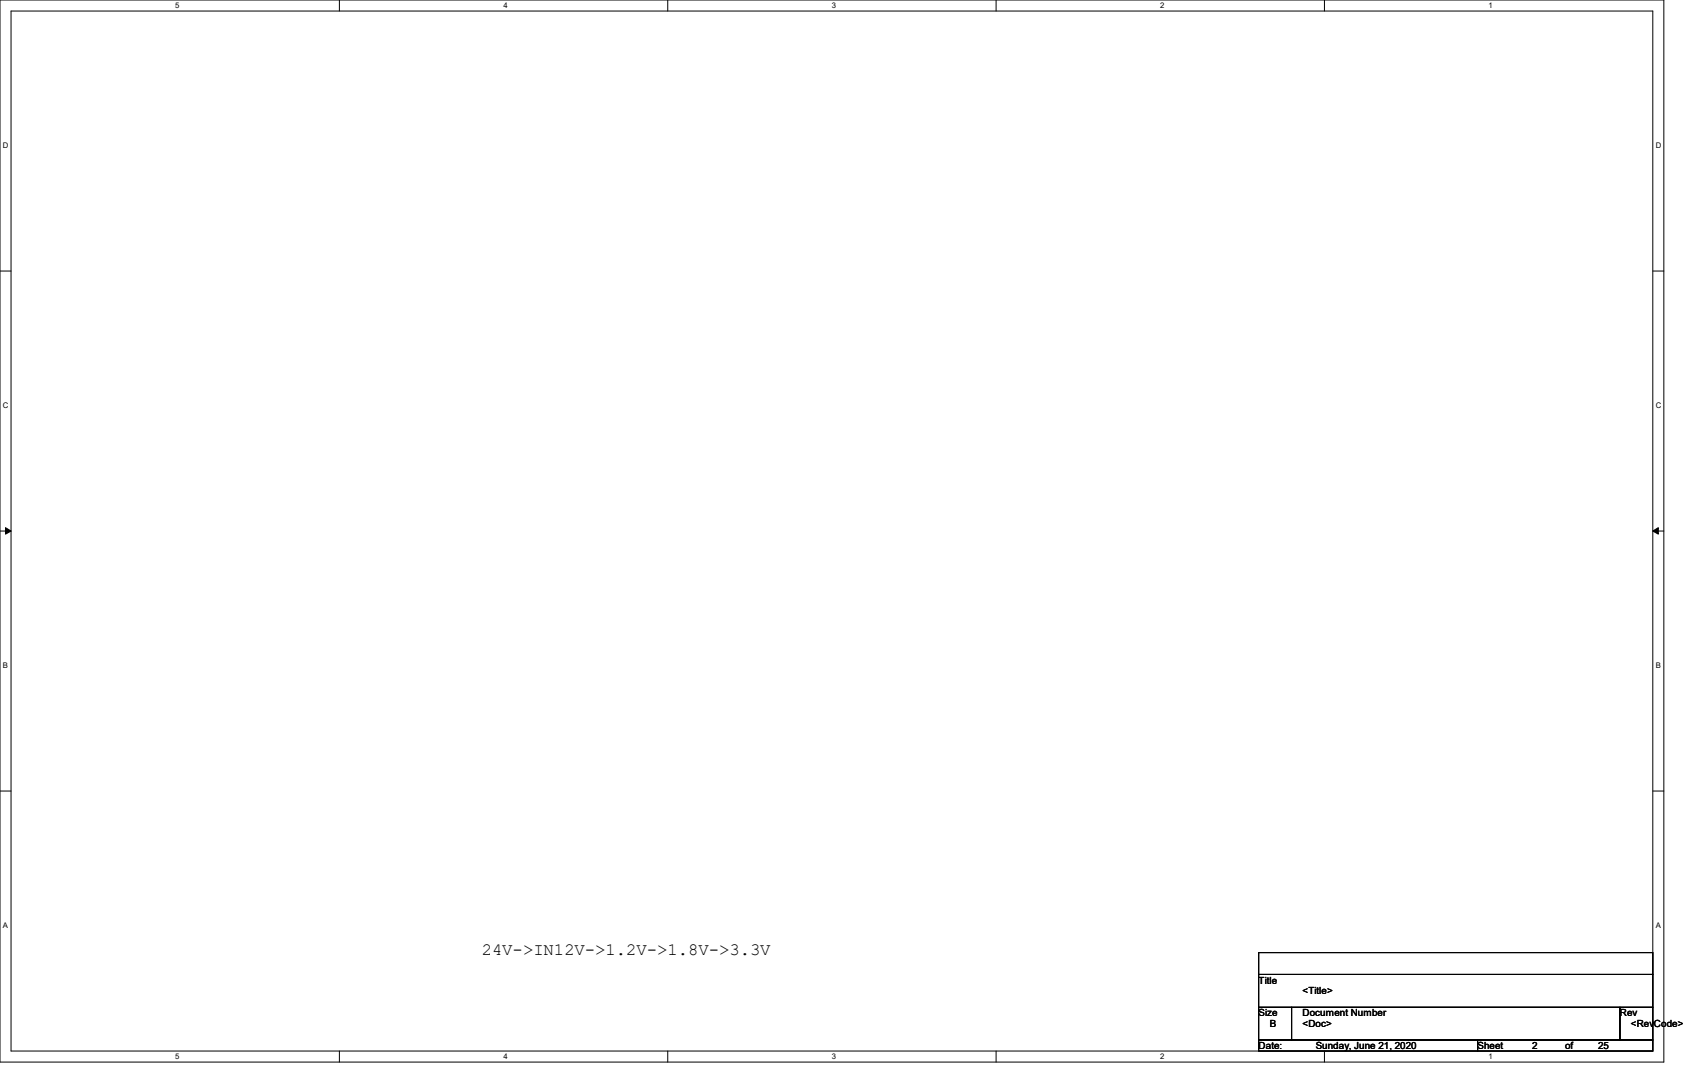
[picture p81: page 2]
Title Size; Document Number; Rev Date:; Sheet; of <Doc>; <RevCode>; <Title> B; Sunday, June 21, 2020; 25 Title Size

R6 | 4.7K R2 | 10K

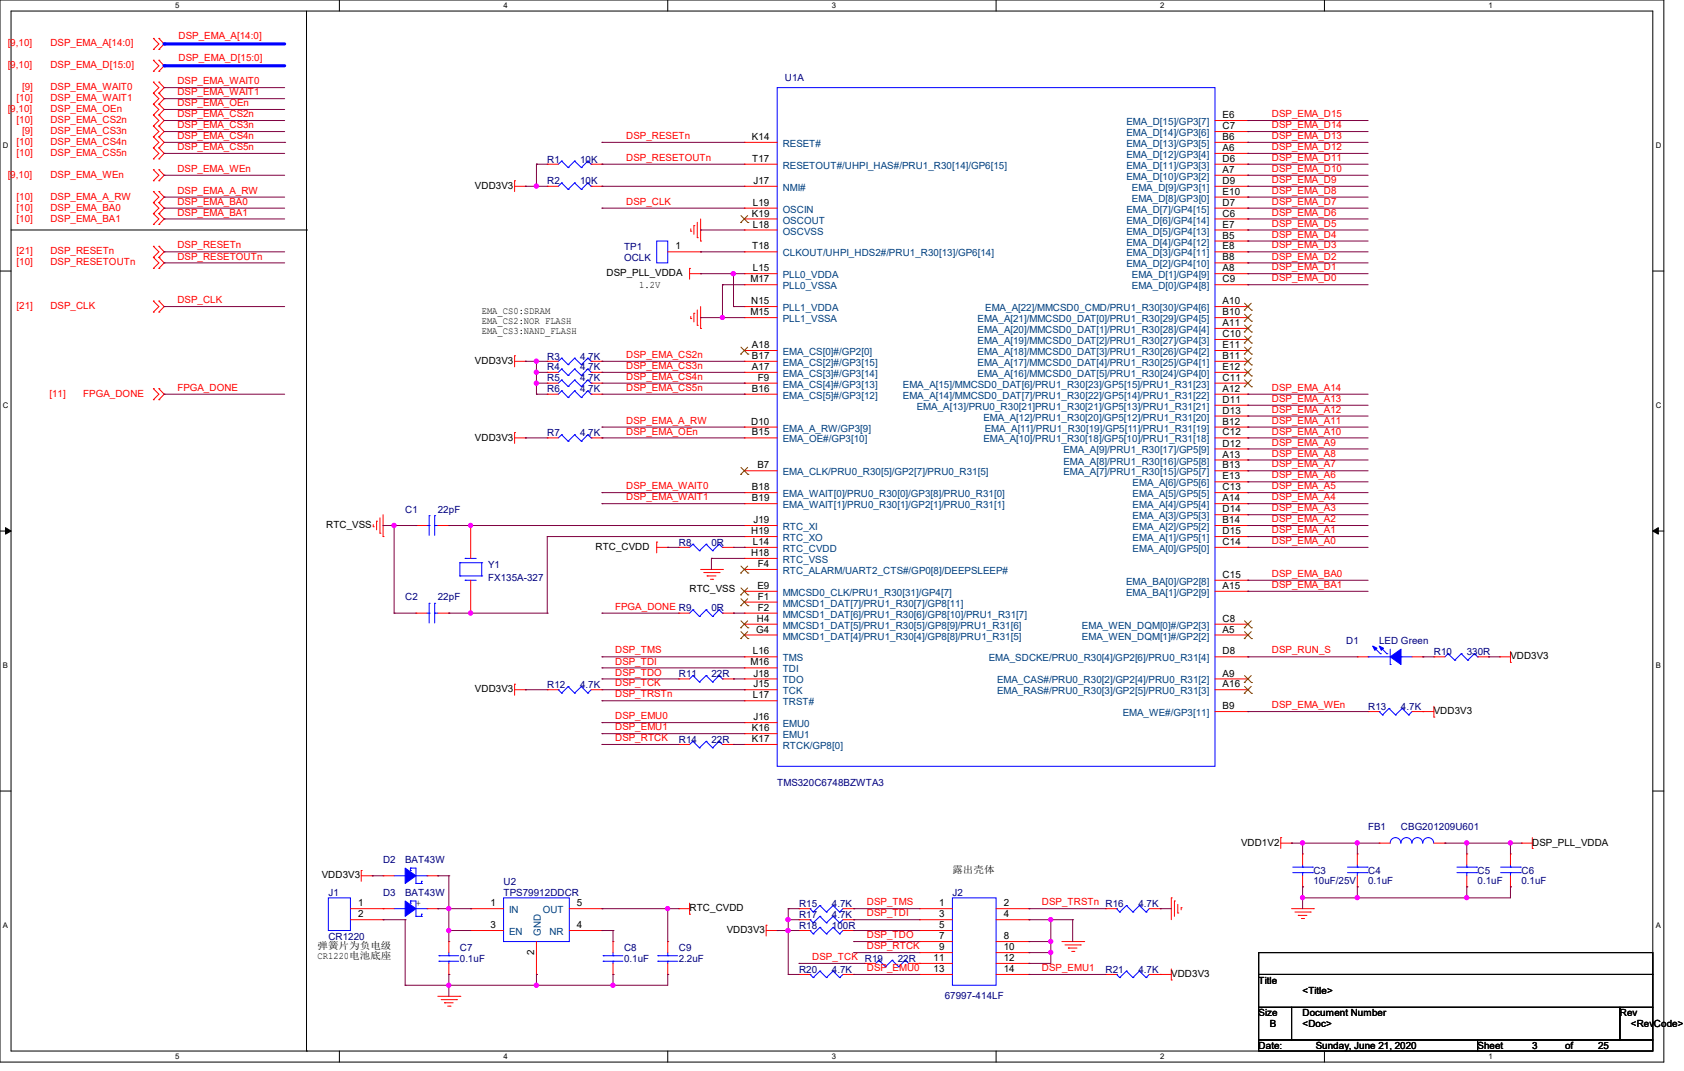
[picture p82: page 3]

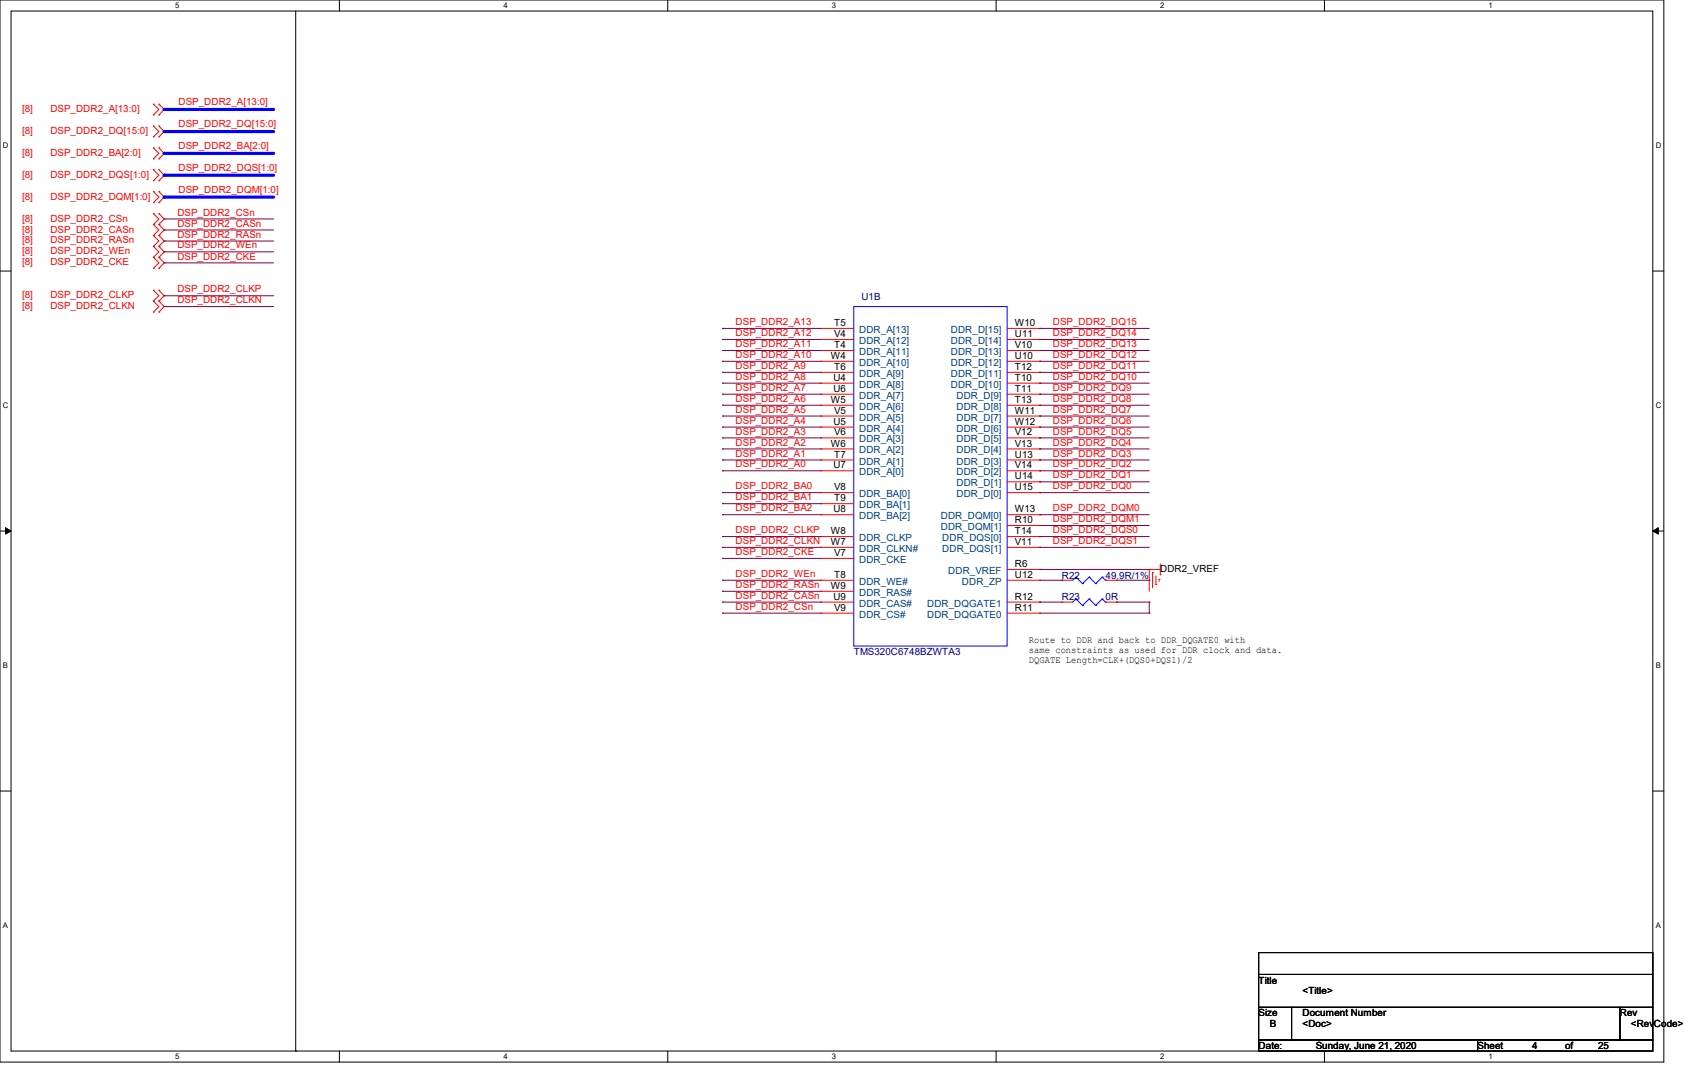
[picture p83: page 4]

Route to DDR and back to DDR_DQGATE0 with
same constraints as used for DDR clock and data.

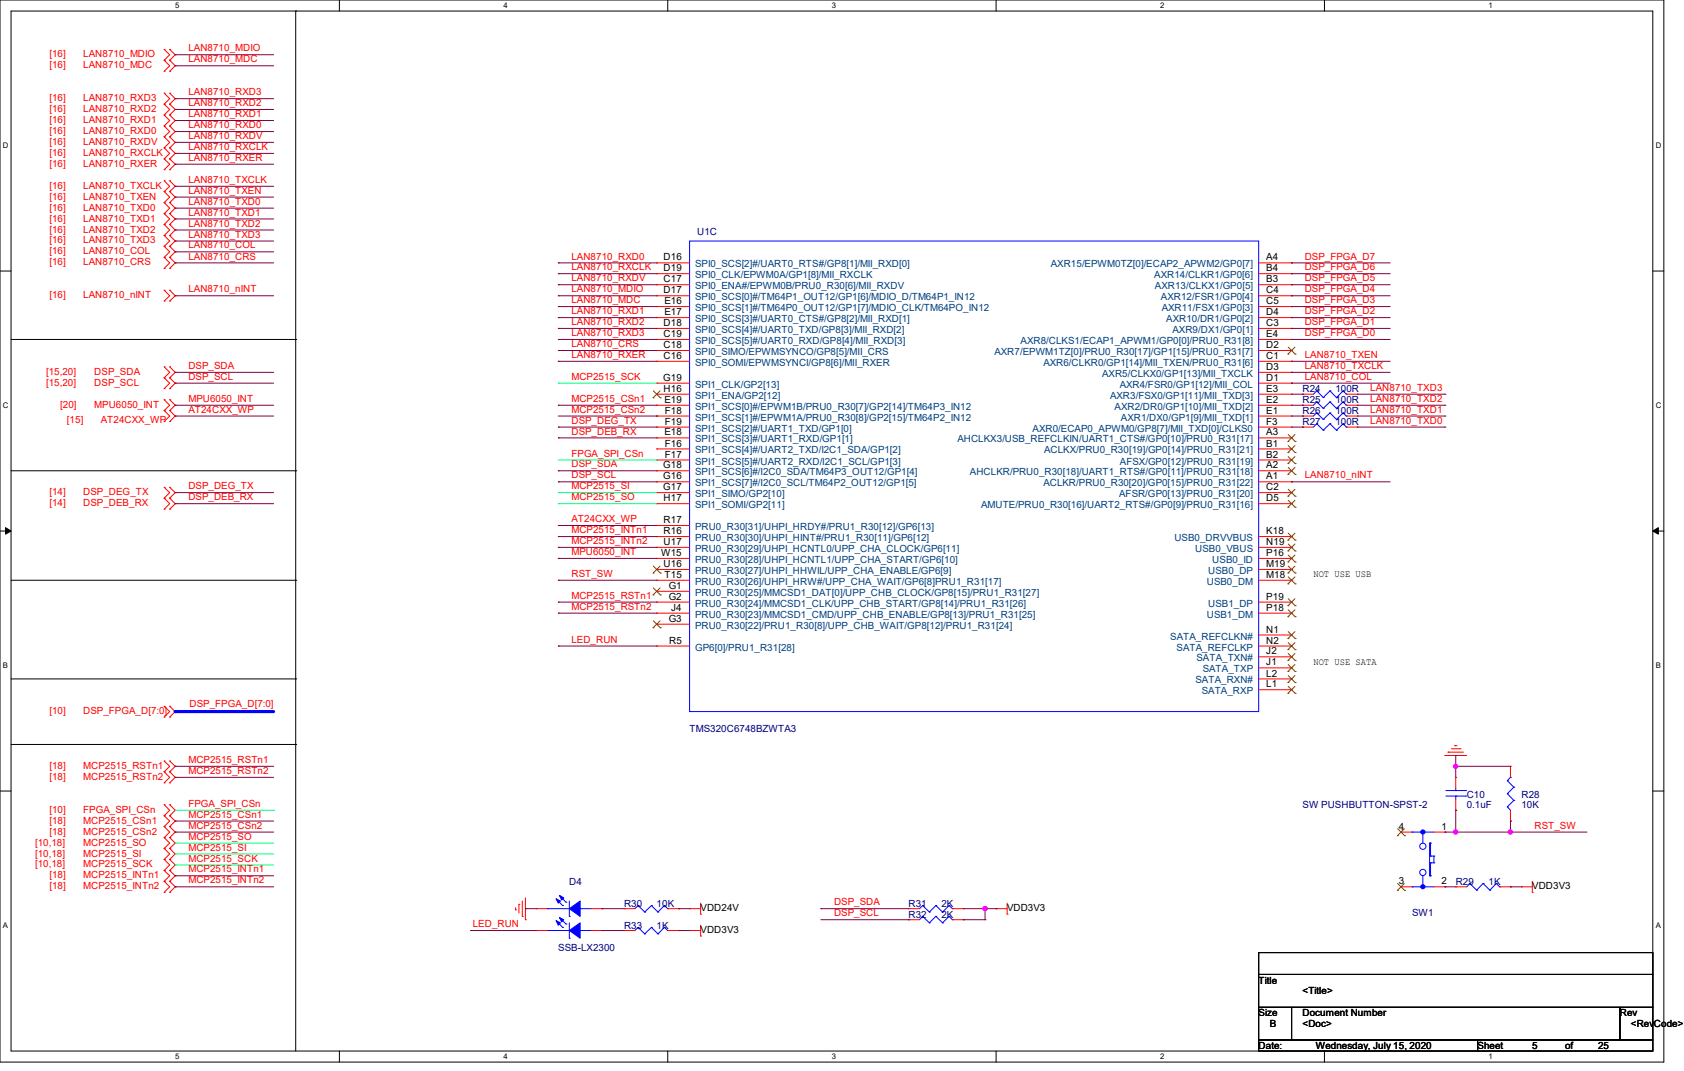
[picture p84: page 5]

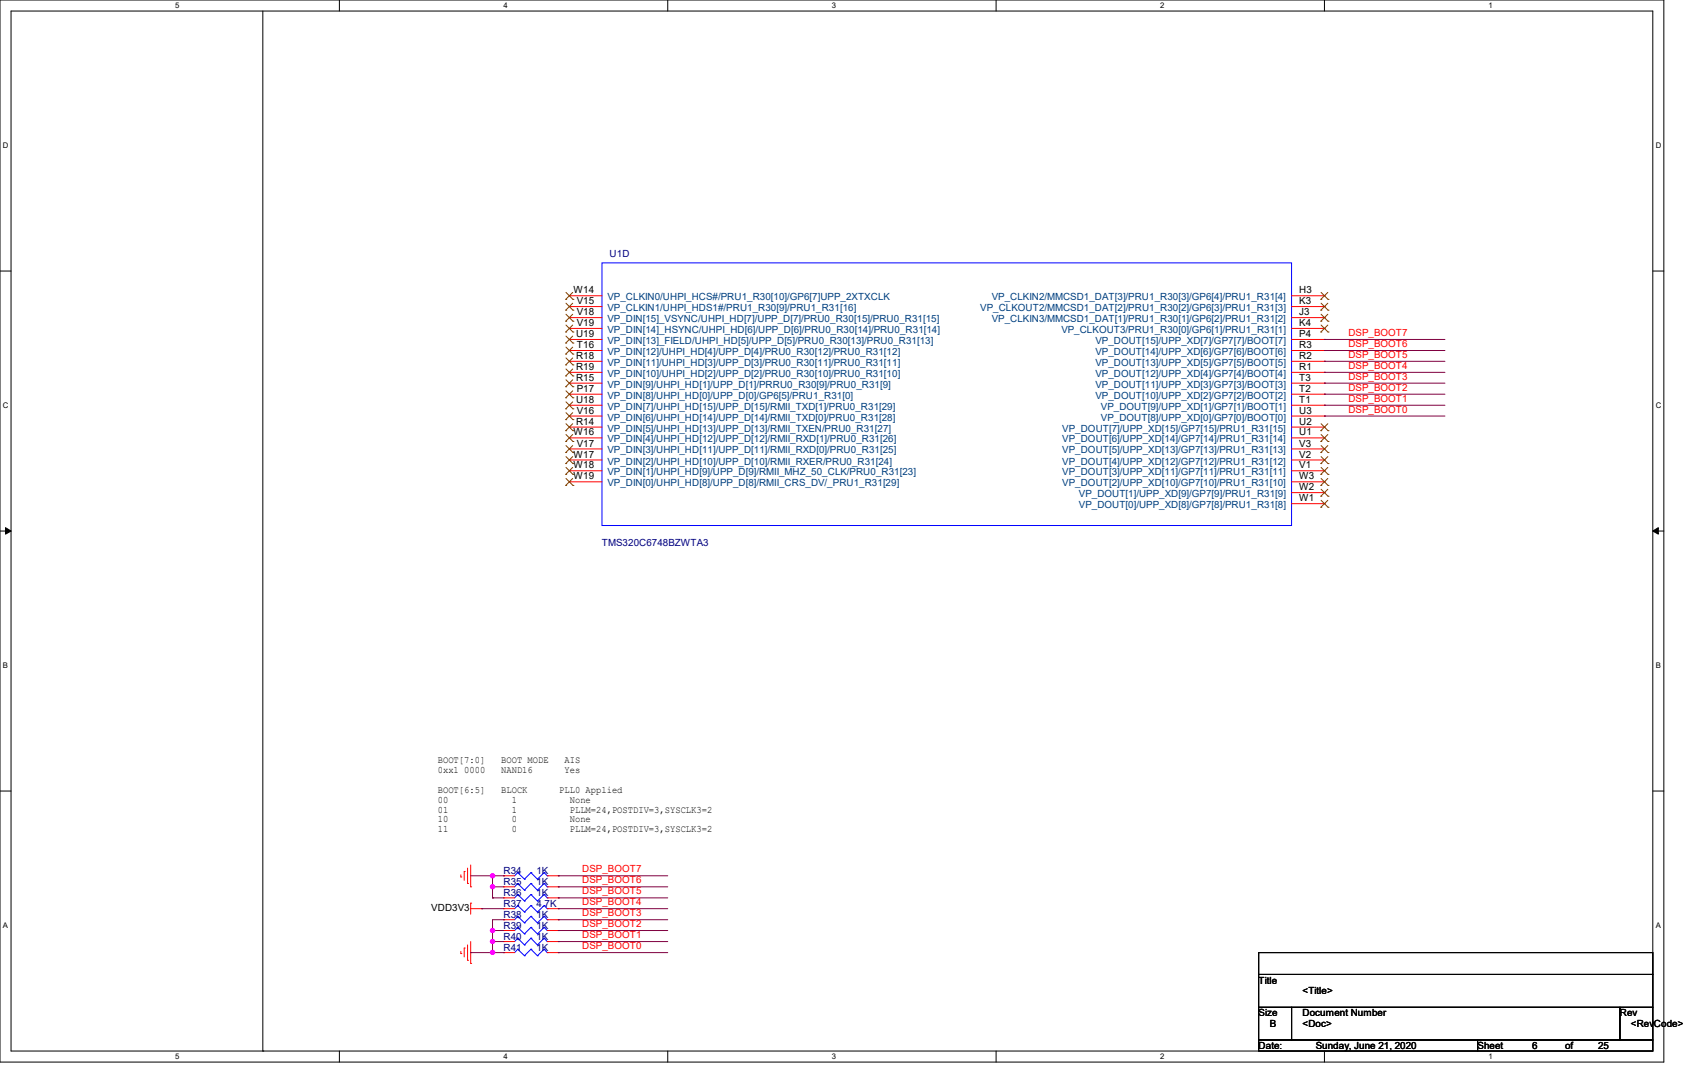
[picture p85: page 6]

RSV2 T19 | RSV3/SATA_VDD M2 | RSV3/SATA_VDD N4 | RSV3/SATA_VDD P2 | RSV3/SATA_VDD P1 | NC M³ NC M¹⁴ NC N¹⁶
USB0_VDDA33 | N18 USB0_VDDA18 | N14 USB0_VDDA12 | N17 USB_CVDD | M12 DDR_DVDD18 N6 | DDR_DVDD18 N9 | DDR_DVDD18 N10 | DDR_DVDD18 P7 | DDR_DVDD18 P8 | DDR_DVDD18 P9 | DDR_DVDD18 P10 | DDR_DVDD18 R7 | DDR_DVDD18 R8 | DDR_DVDD18 R9 | CVDD | E15 CVDD | G7 CVDD | G8 CVDD | G13 CVDD | H6 CVDD | H7 CVDD | H10 CVDD | H11 CVDD | H12 CVDD | H13 CVDD | J6 CVDD | J12 CVDD | K6 CVDD | K12 CVDD | L12 CVDD | M8 CVDD | M9 CVDD | N8 RVDD | E5 RVDD | H14 RVDD | N7 DVDD18 | F14 DVDD18 | G6 DVDD18 | G10 DVDD18 | G11 DVDD18 | G12 DVDD18 | J13 DVDD18 | K5 DVDD18 | L6 DVDD18 | P13 DVDD18 | R13 DVDD3318_A F5 DVDD3318_A F15 DVDD3318_A G5 DVDD3318_A G14 DVDD3318_A G15 DVDD3318_A H5 DVDD3318_B E14 DVDD3318_B F6 DVDD3318_B F7 DVDD3318_B F8 DVDD3318_B F10 DVDD3318_B F11 DVDD3318_B F12 DVDD3318_B F13 DVDD3318_B G9 DVDD3318_B J14 DVDD3318_B K15 DVDD3318_C | J5 DVDD3318_C | K13 DVDD3318_C | L4 DVDD3318_C | L13 DVDD3318_C | M13 DVDD3318_C | N13 DVDD3318_C | P5 DVDD3318_C | P6 DVDD3318_C | P12 DVDD3318_C | R4

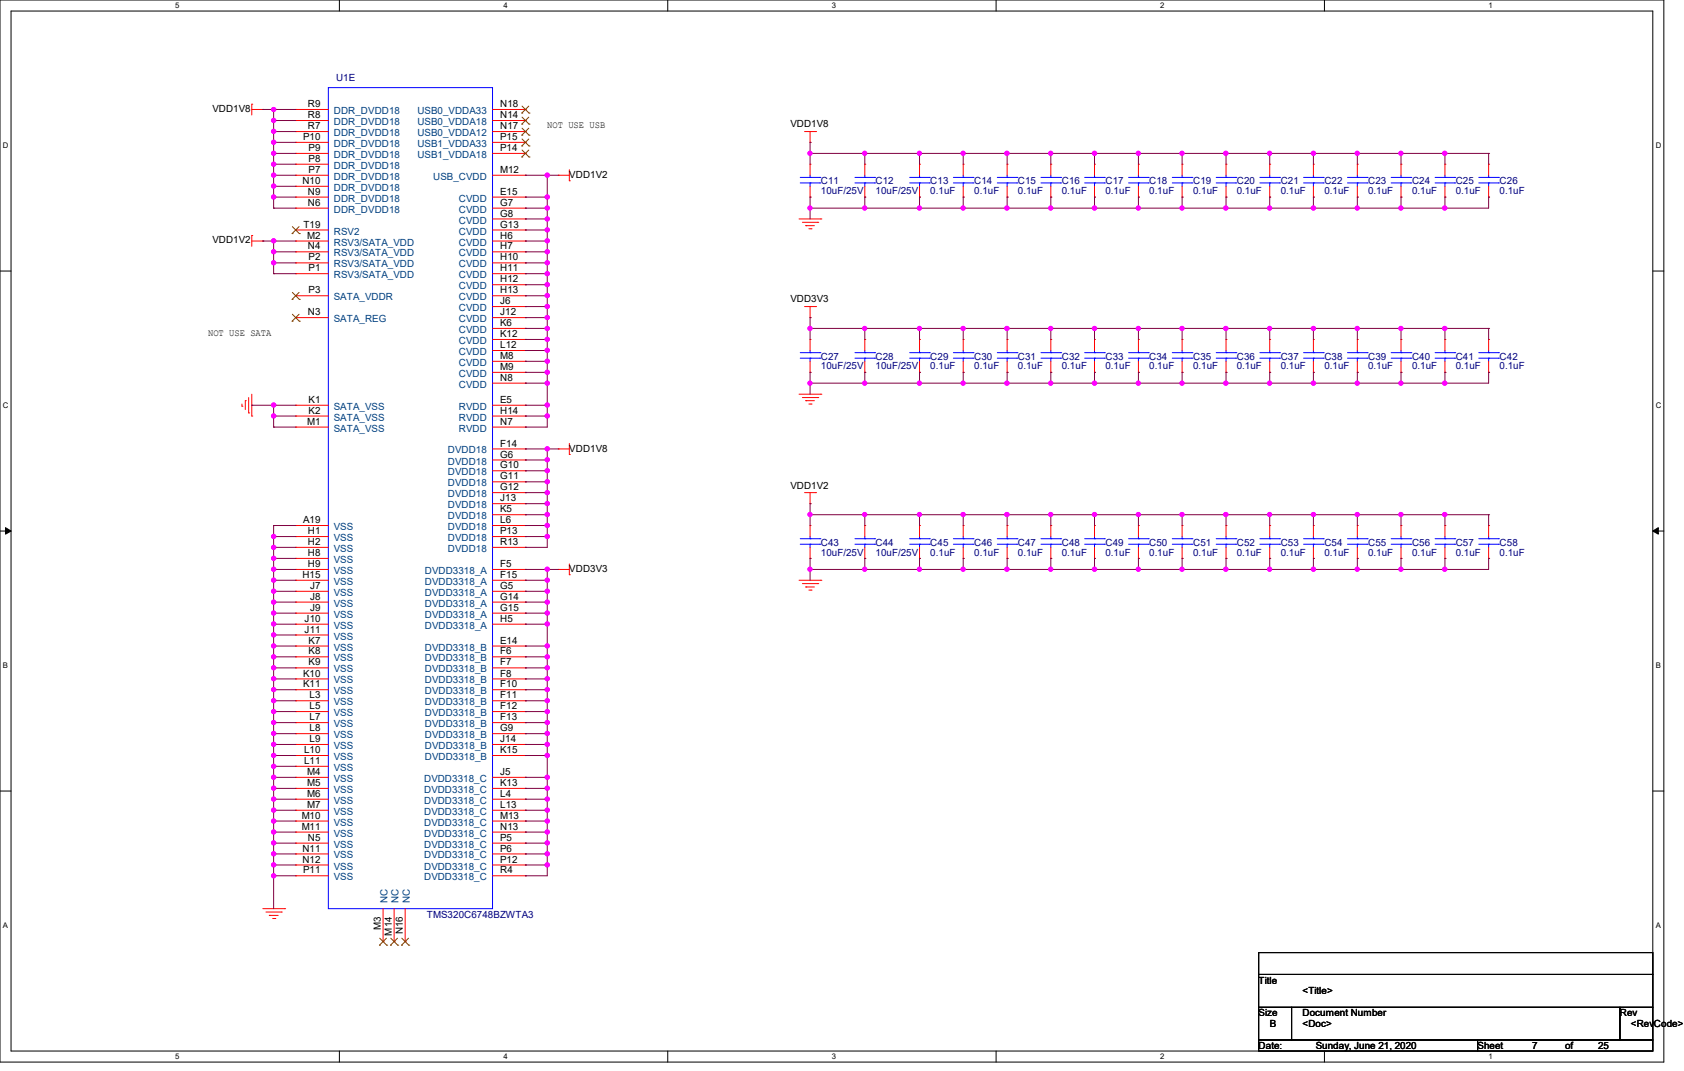
[picture p86: page 7]

A0 M8 | A1 M3 | A2 M7 | A3 N2 | A4 N8 | A5 N3 | A6 N7 | A7 P2 | A8 P8 | A9 P3 | A10 M2 | A11 P7 | A12 R2 | BA0 L2 | BA1 L3 | BA2 L1 | CK J8 | CKn K8 | CKE K2 | CSn L8
VDD5 | A1 VDD4 | E1 VDD3 | M9 VDD2 | R1 VDD1 | J9 VDDQ10 | A9 VDDQ9 | C1 VDDQ8 | C3 VDDQ7 | C7 VDDQ6 | C9 VDDQ5 | G3 VDDQ4 | E9 VDDQ3 | G1 VDDQ2 | G7 VDDQ1 | G9 VDDL | J1 VREF | J2 VSS5 | A3 VSS4 | E3 VSS3 | J3 VSS2 | N1 VSS1 | P9 VSSQ10 | A7 VSSQ9 | B2 VSSQ8 | B8 VSSQ7 | D2 VSSQ6 | D8 VSSQ5 | E7 VSSQ4 | F2 VSSQ3 | F8 VSSQ2 | H2 VSSQ1 | H8 VSSDL | J7 NC1 A2 | NC2 E2 | UDQSn/NU A8 | RFU2 R3 | RFU3 R7

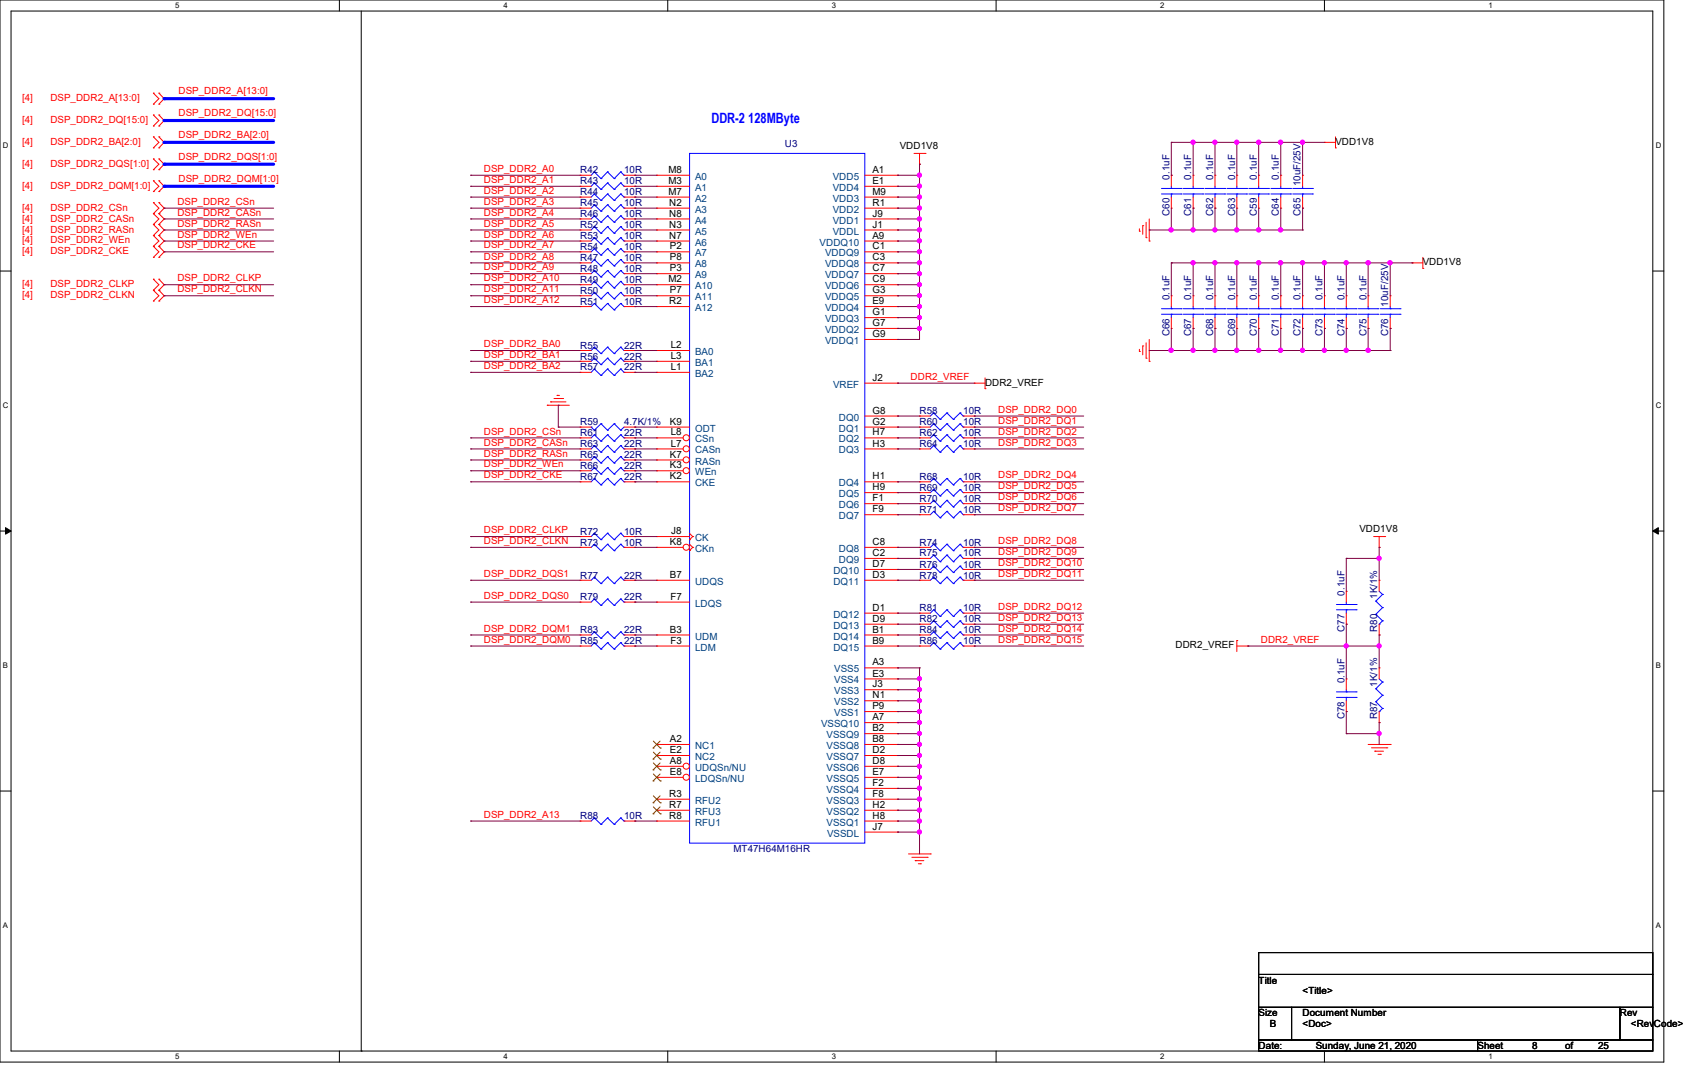
[picture p87: page 8]

## NAND FLASH 512MByte

I/O05 | J7 NC2 | A2 NC3 | A9 NC4 | A10 NC5 | B1 NC6 | B9 NC7 | B10

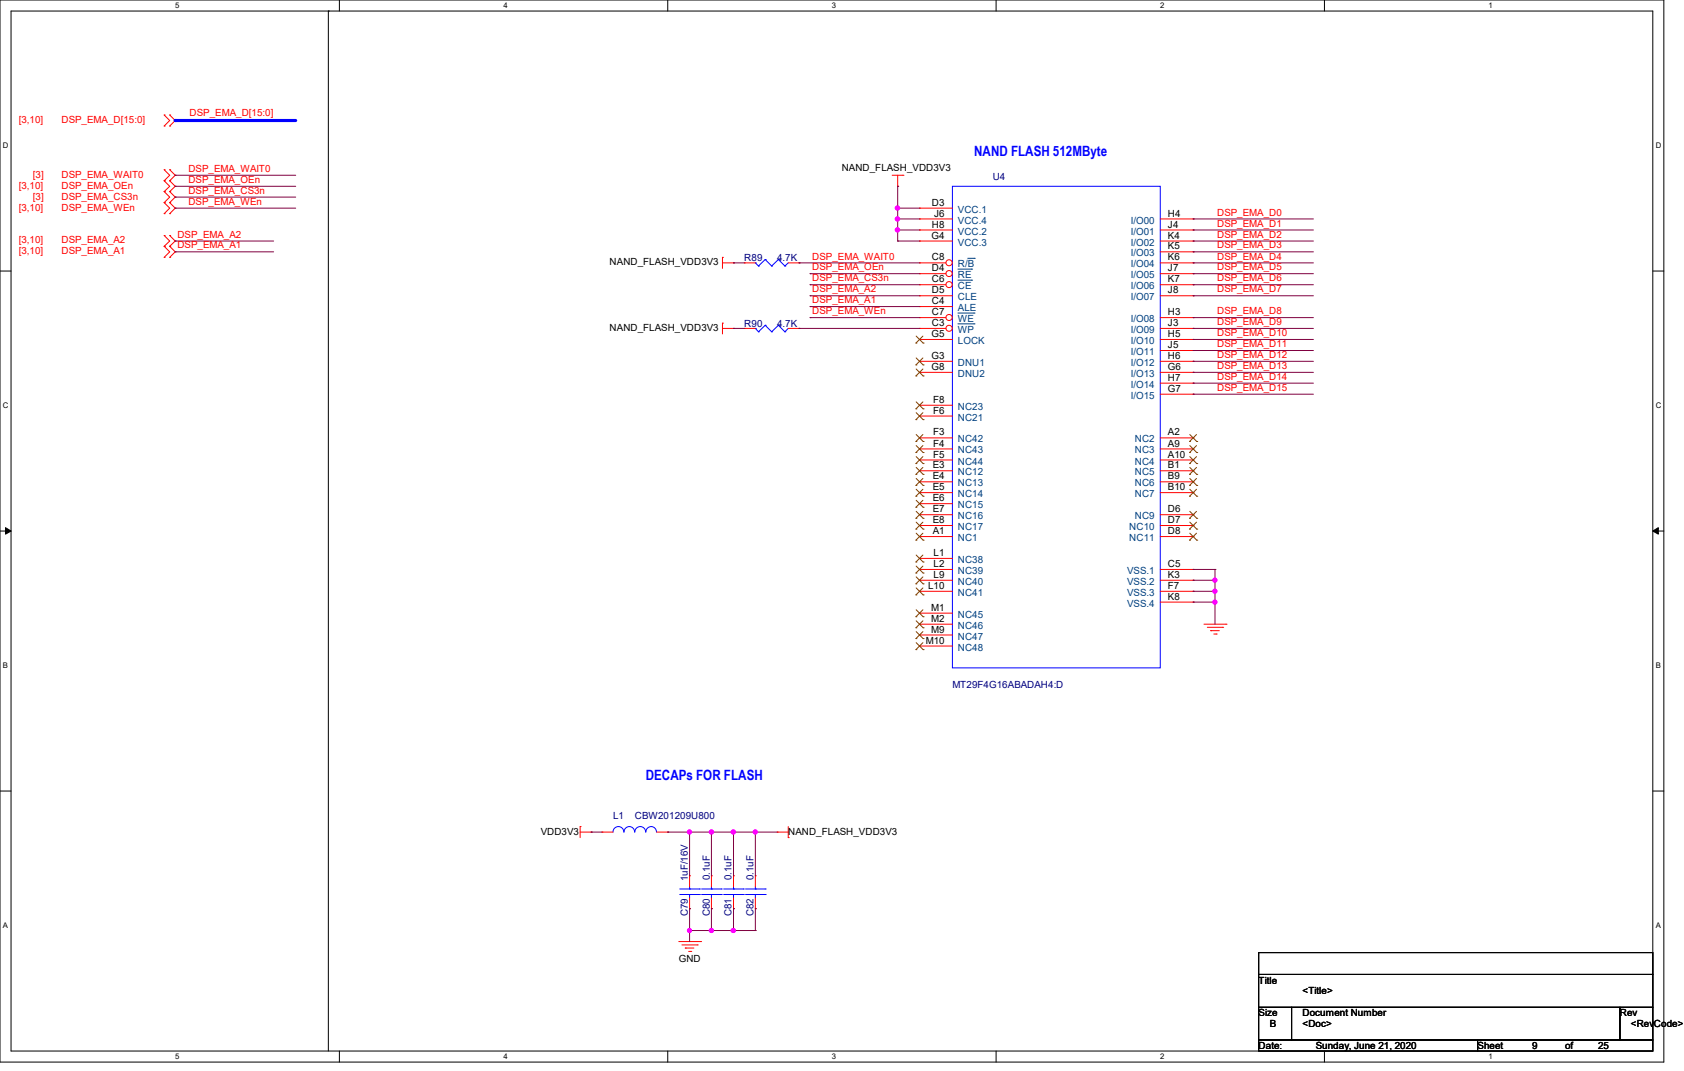
[picture p88: page 9]

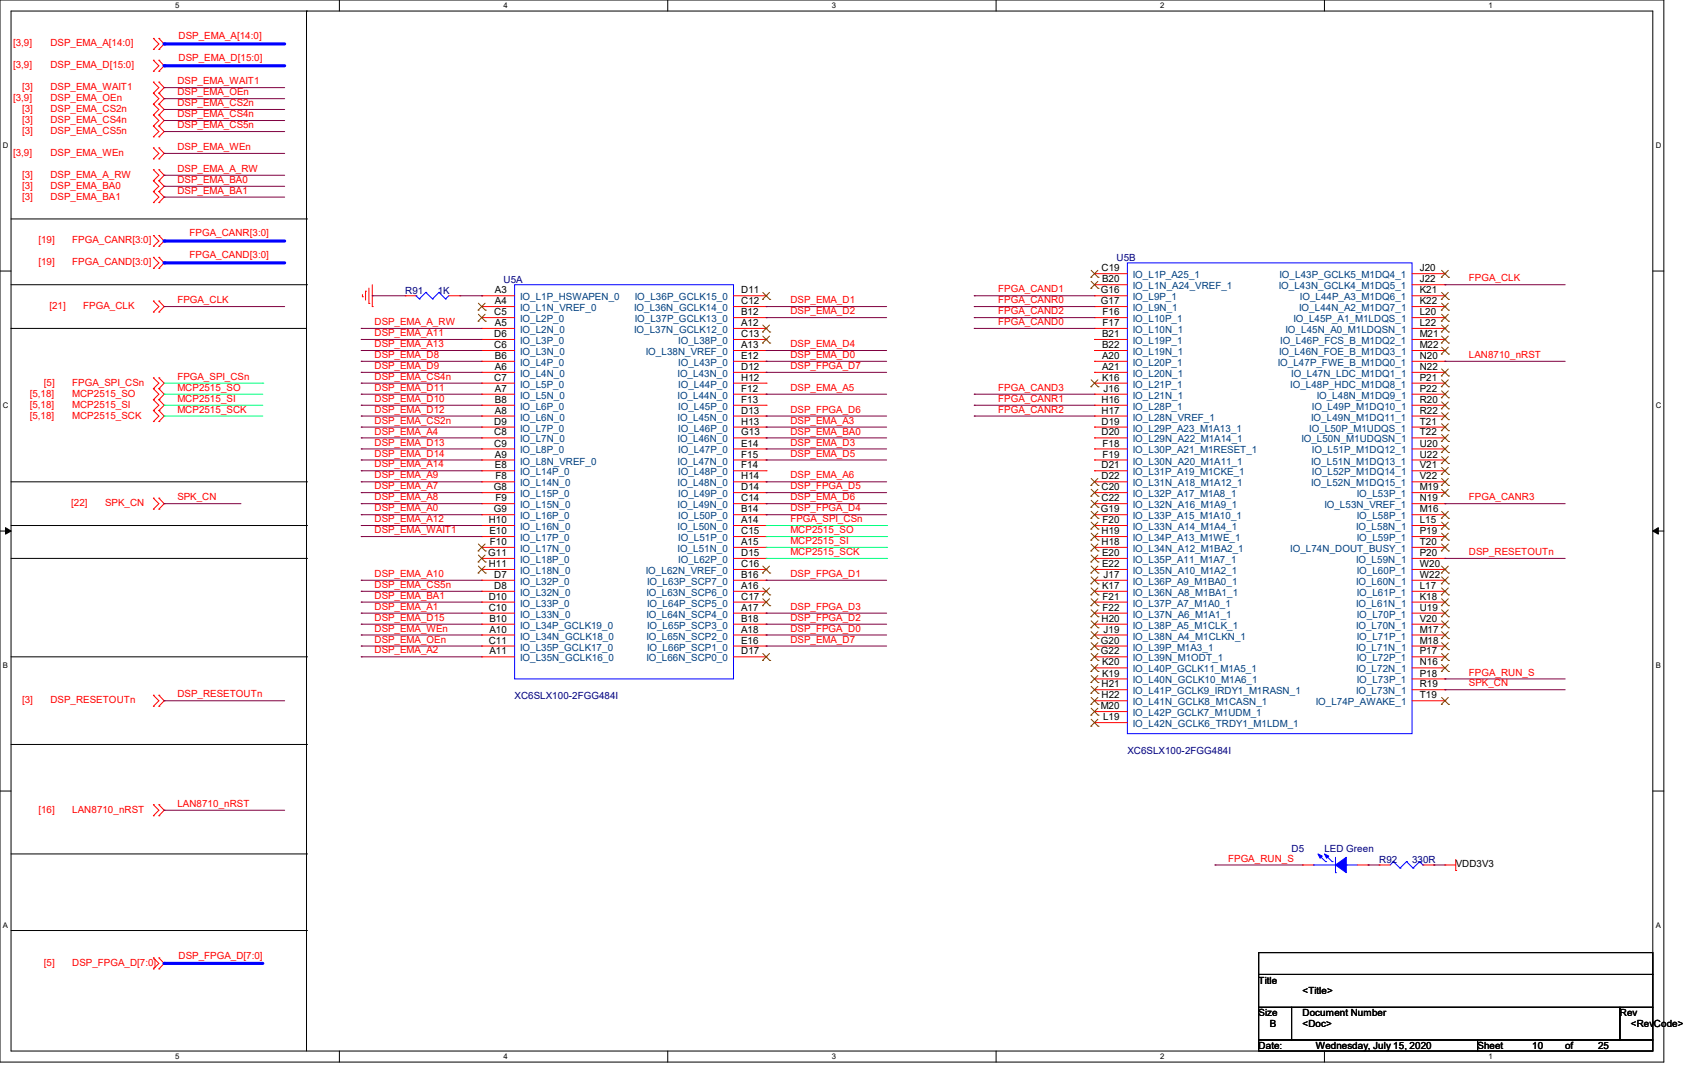
[picture p89: page 10]

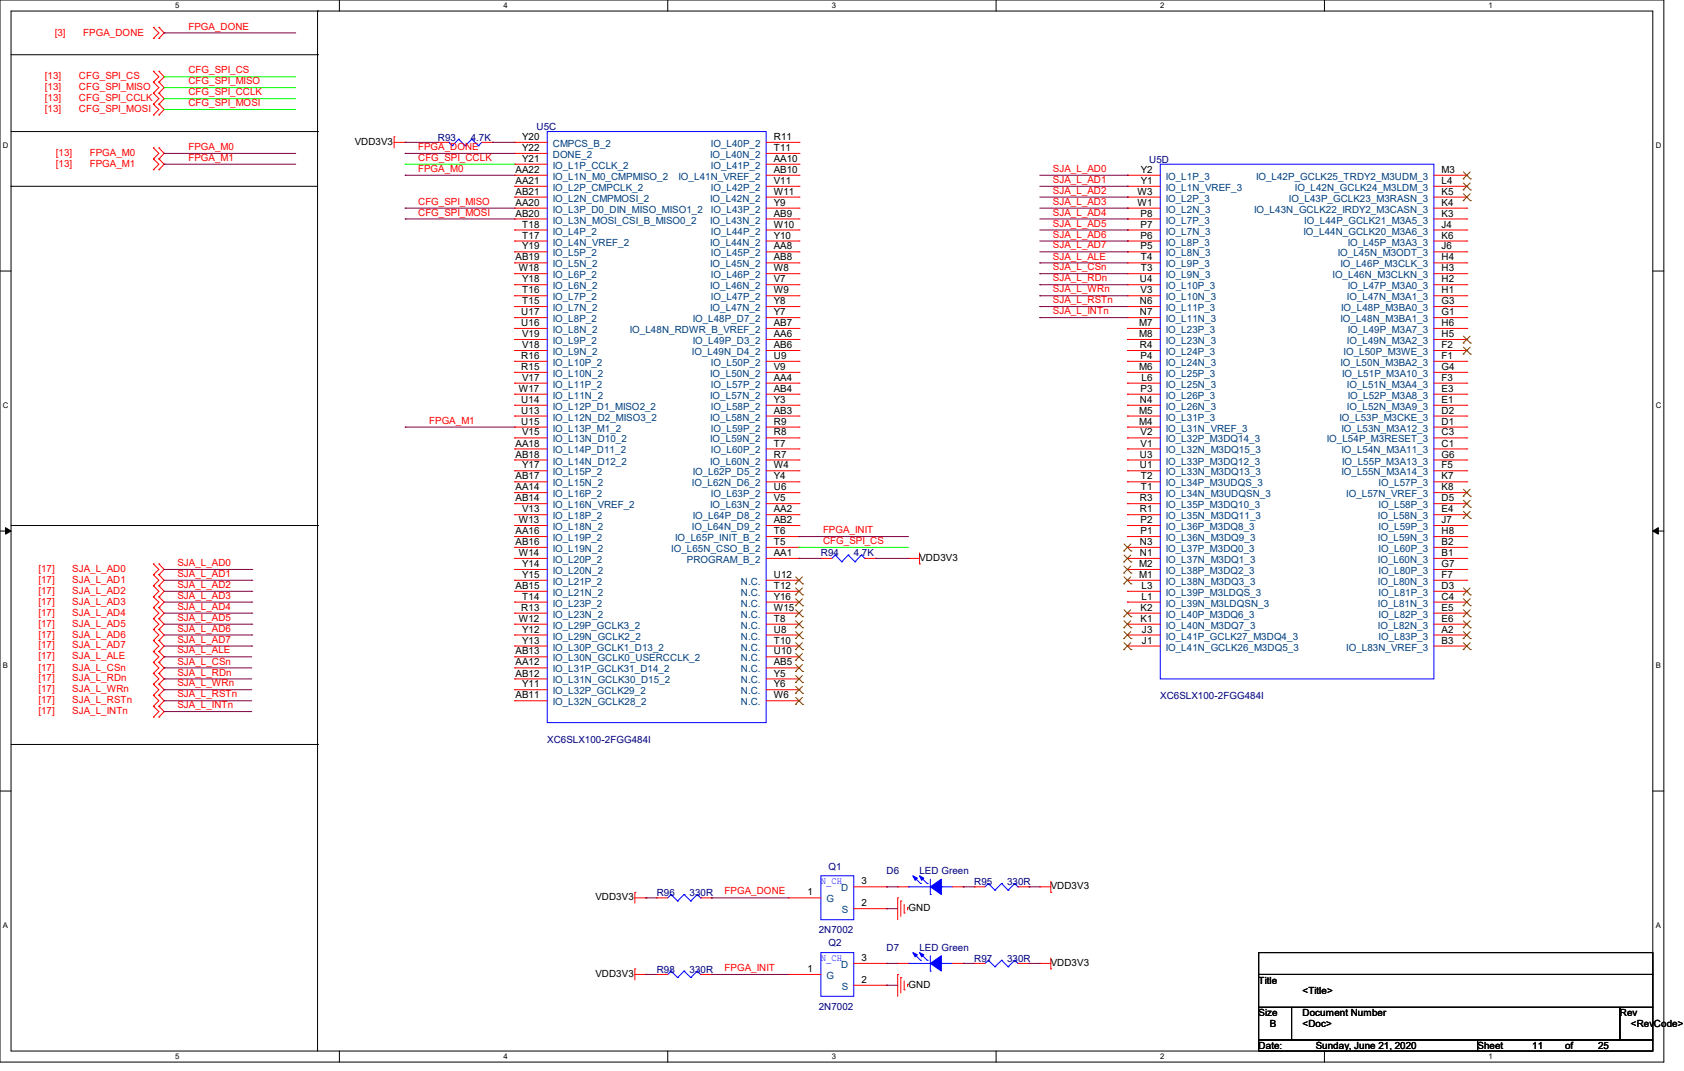
[picture p90: page 11]

# U5FXC6SLX100-2FGG484I

# 10uF/25V C97

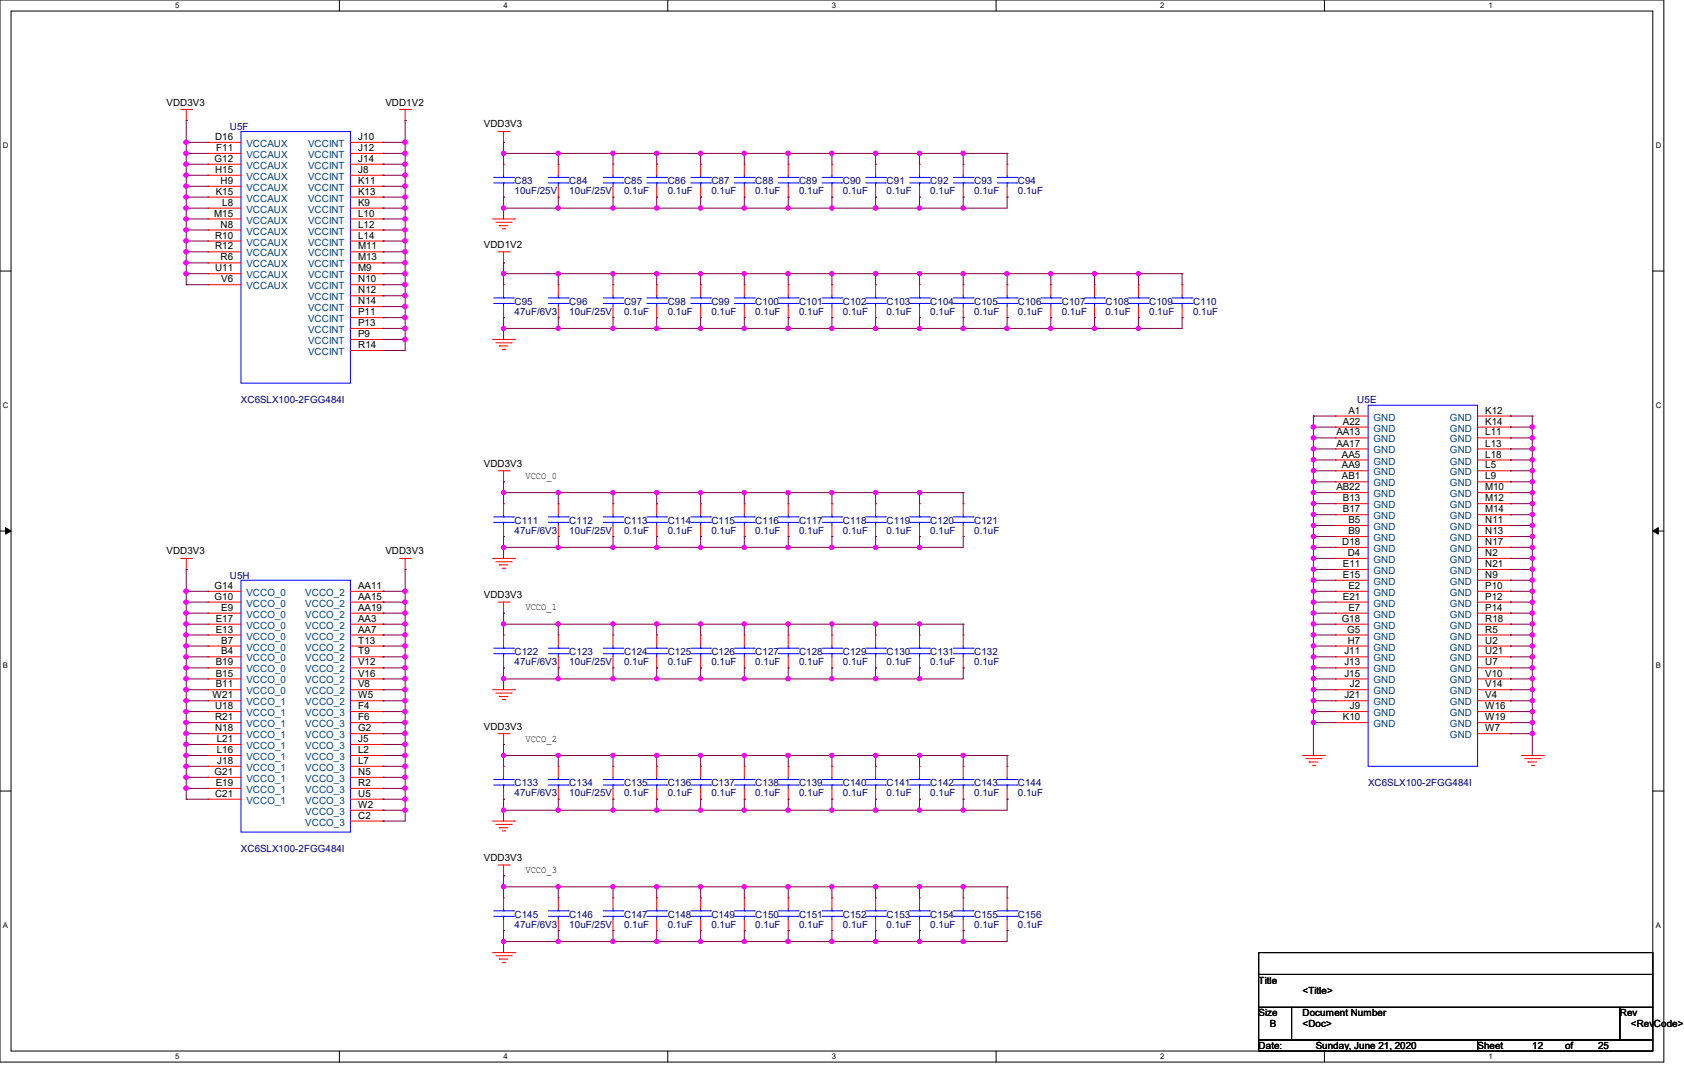
[picture p91: page 12]

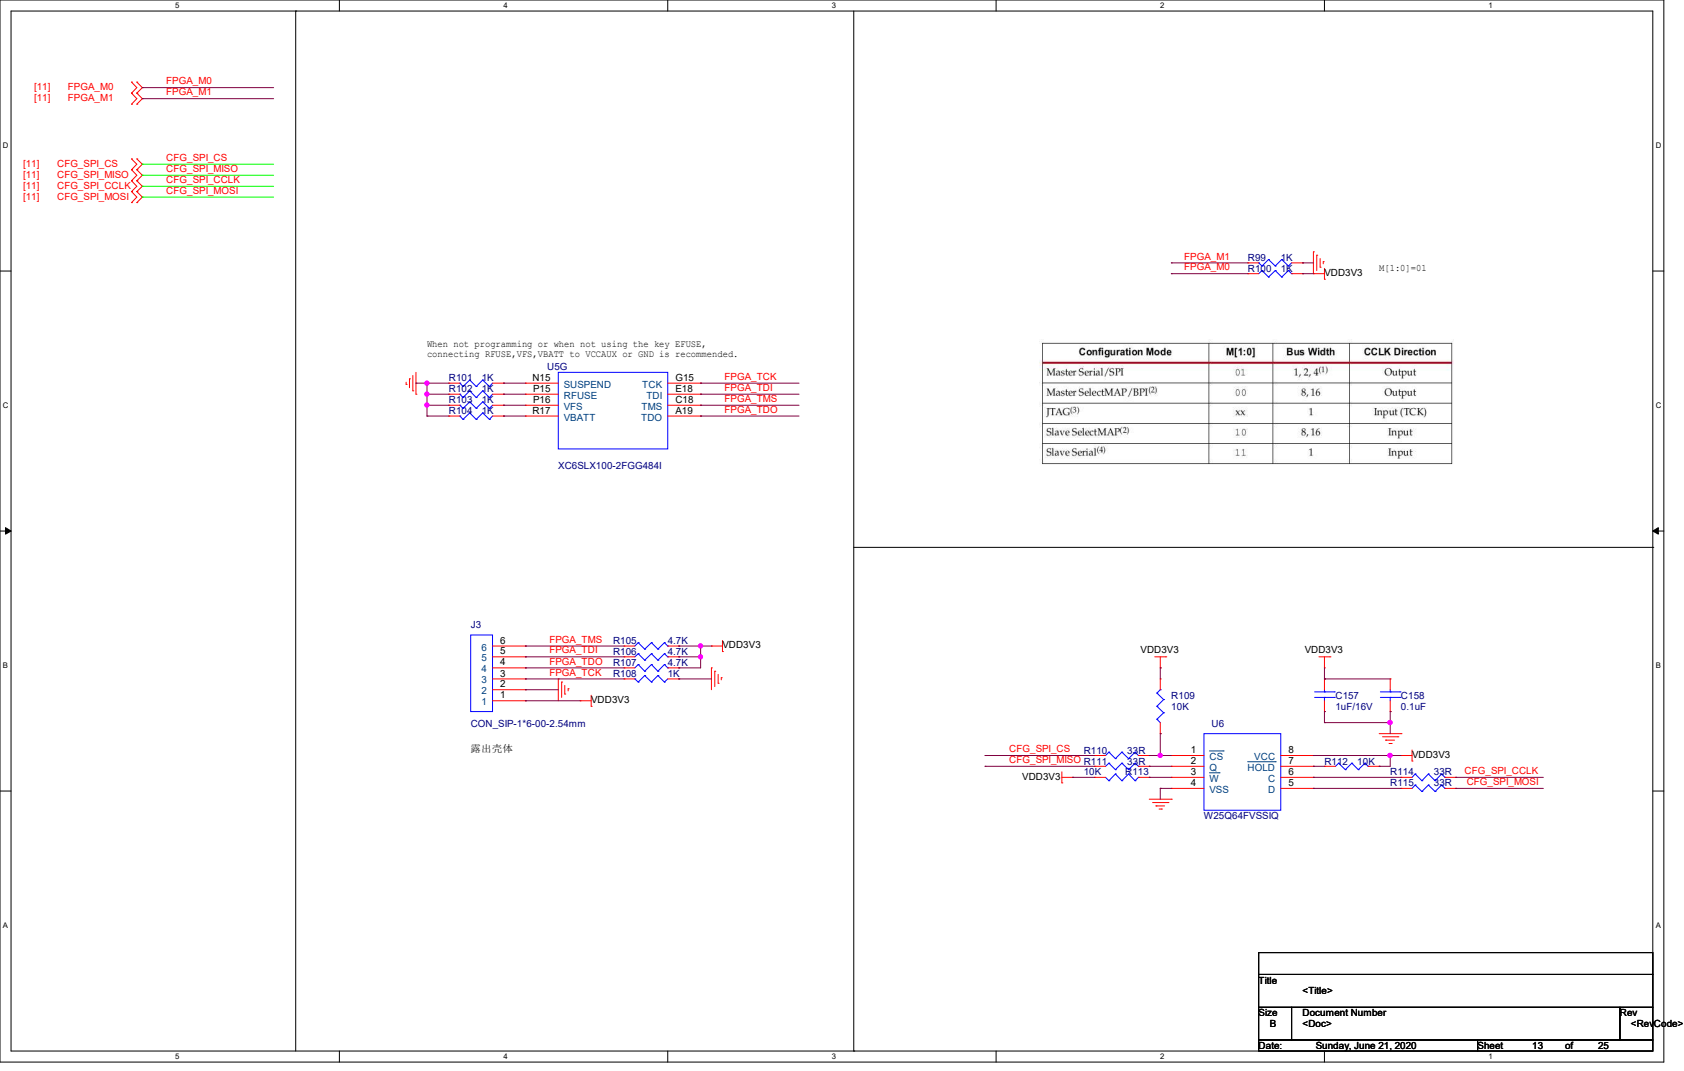
[picture p92: page 13]

When not programming or when not using the key EFUSE,
connecting RFUSE,VFS,VBATT to VCCAUX or GND is recommended.

## VDD3V3

## [5] DSP_DEG_TX

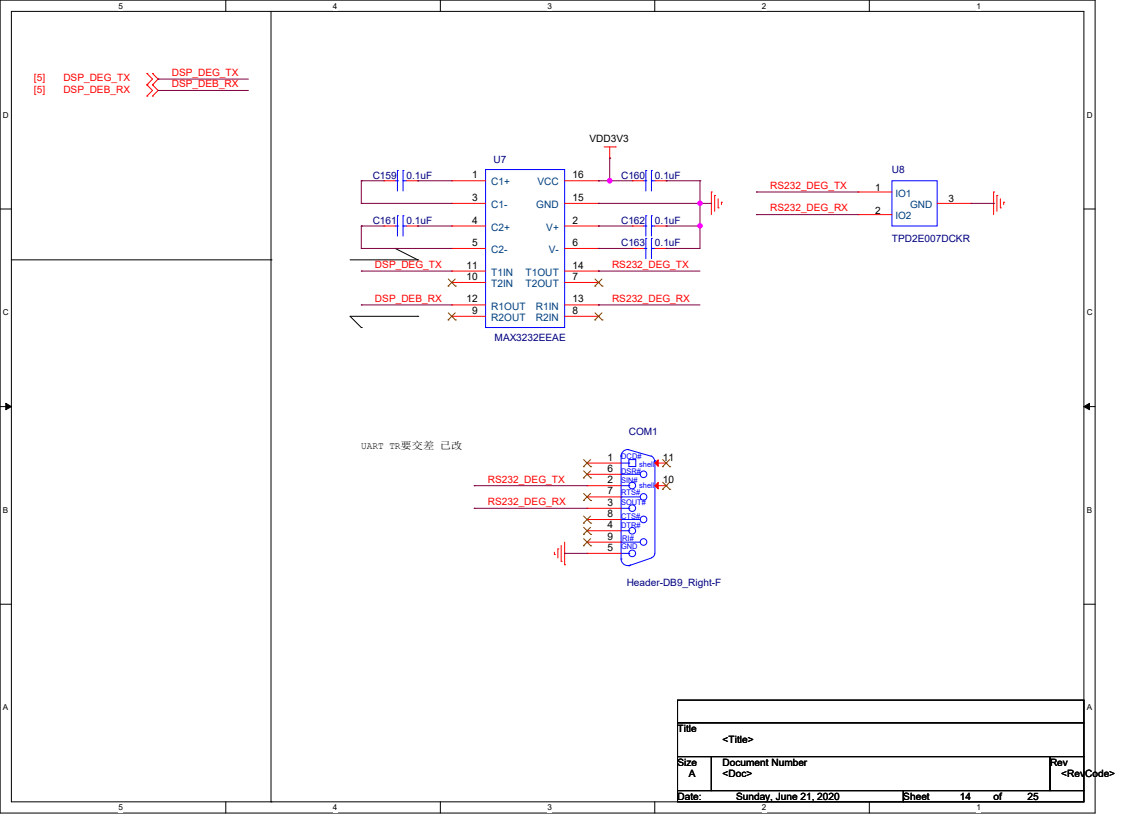
[picture p93: page 14]
[5] DSP_DEB_RX; Title; Size; Document Number; Rev; Date:; Sheet; <Doc>; <RevCode>; <Title>; Sunday, June 21, 2020; MAX3232EEAE; T2OUT 7; R2IN 8 R2OUT 9; R1OUT 12; T1OUT 14; GND 15; VCC 16; RI# CTS# DSR# DCD# SIN# RTS# SOUT# DTR# shell GND; shell COM1; Header-DB9_Right-F; TPD2E007DCKR; GND; RS232_DEG_RX; RS232_DEG_TX; DSP_DEG_TX; DSP_DEB_RX; DSP_DEG_TX DSP_DEB_RX

UART TR要交差 已改

## [5] AT24CXX_WP

## [5,20] DSP_SDA

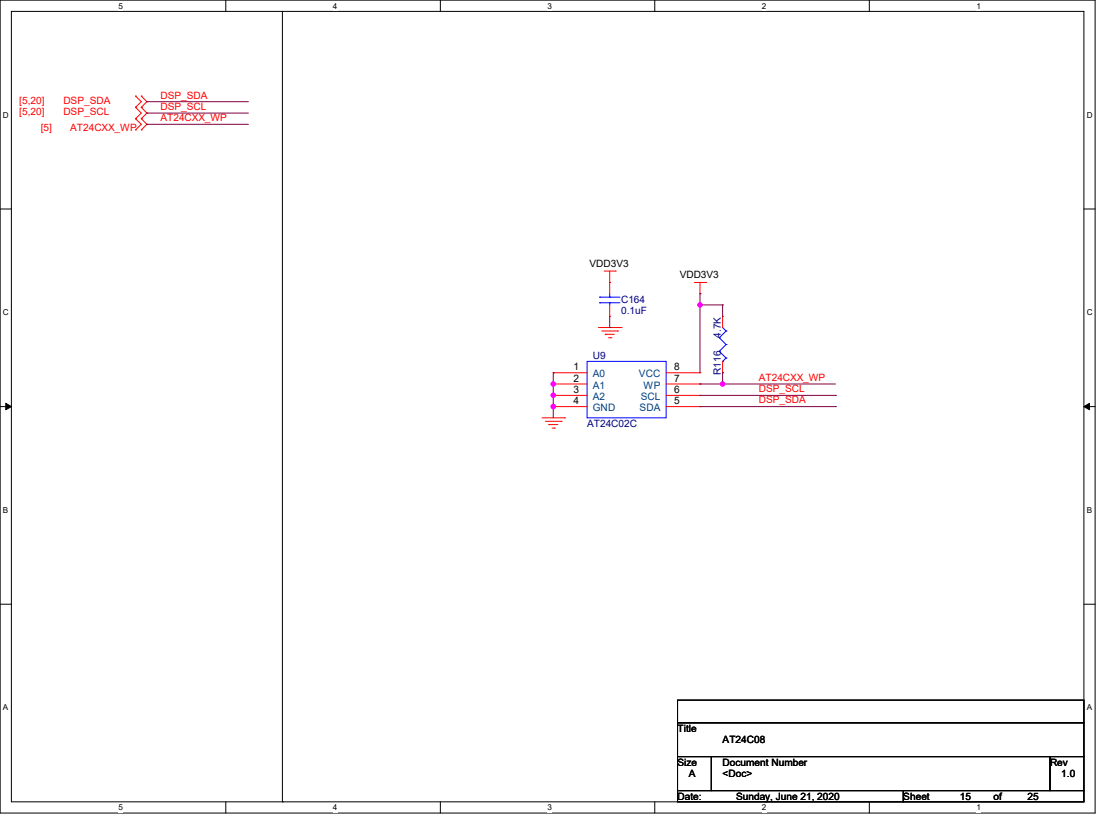
[picture p94: page 15]
VDD3V3; DSP_SCL; Title; Size; Document Number; Rev; Date:; Sheet; <Doc>; Sunday, June 21, 2020; U9 A0 1 A1 2 A2 3 GND 4; VCC 8 WP 7 SCL 6 SDA 5; R¹¹⁶ ⁴.7K; DSP_SCL DSP_SDA; AT24CXX_WP; DSP_SDA DSP_SCL

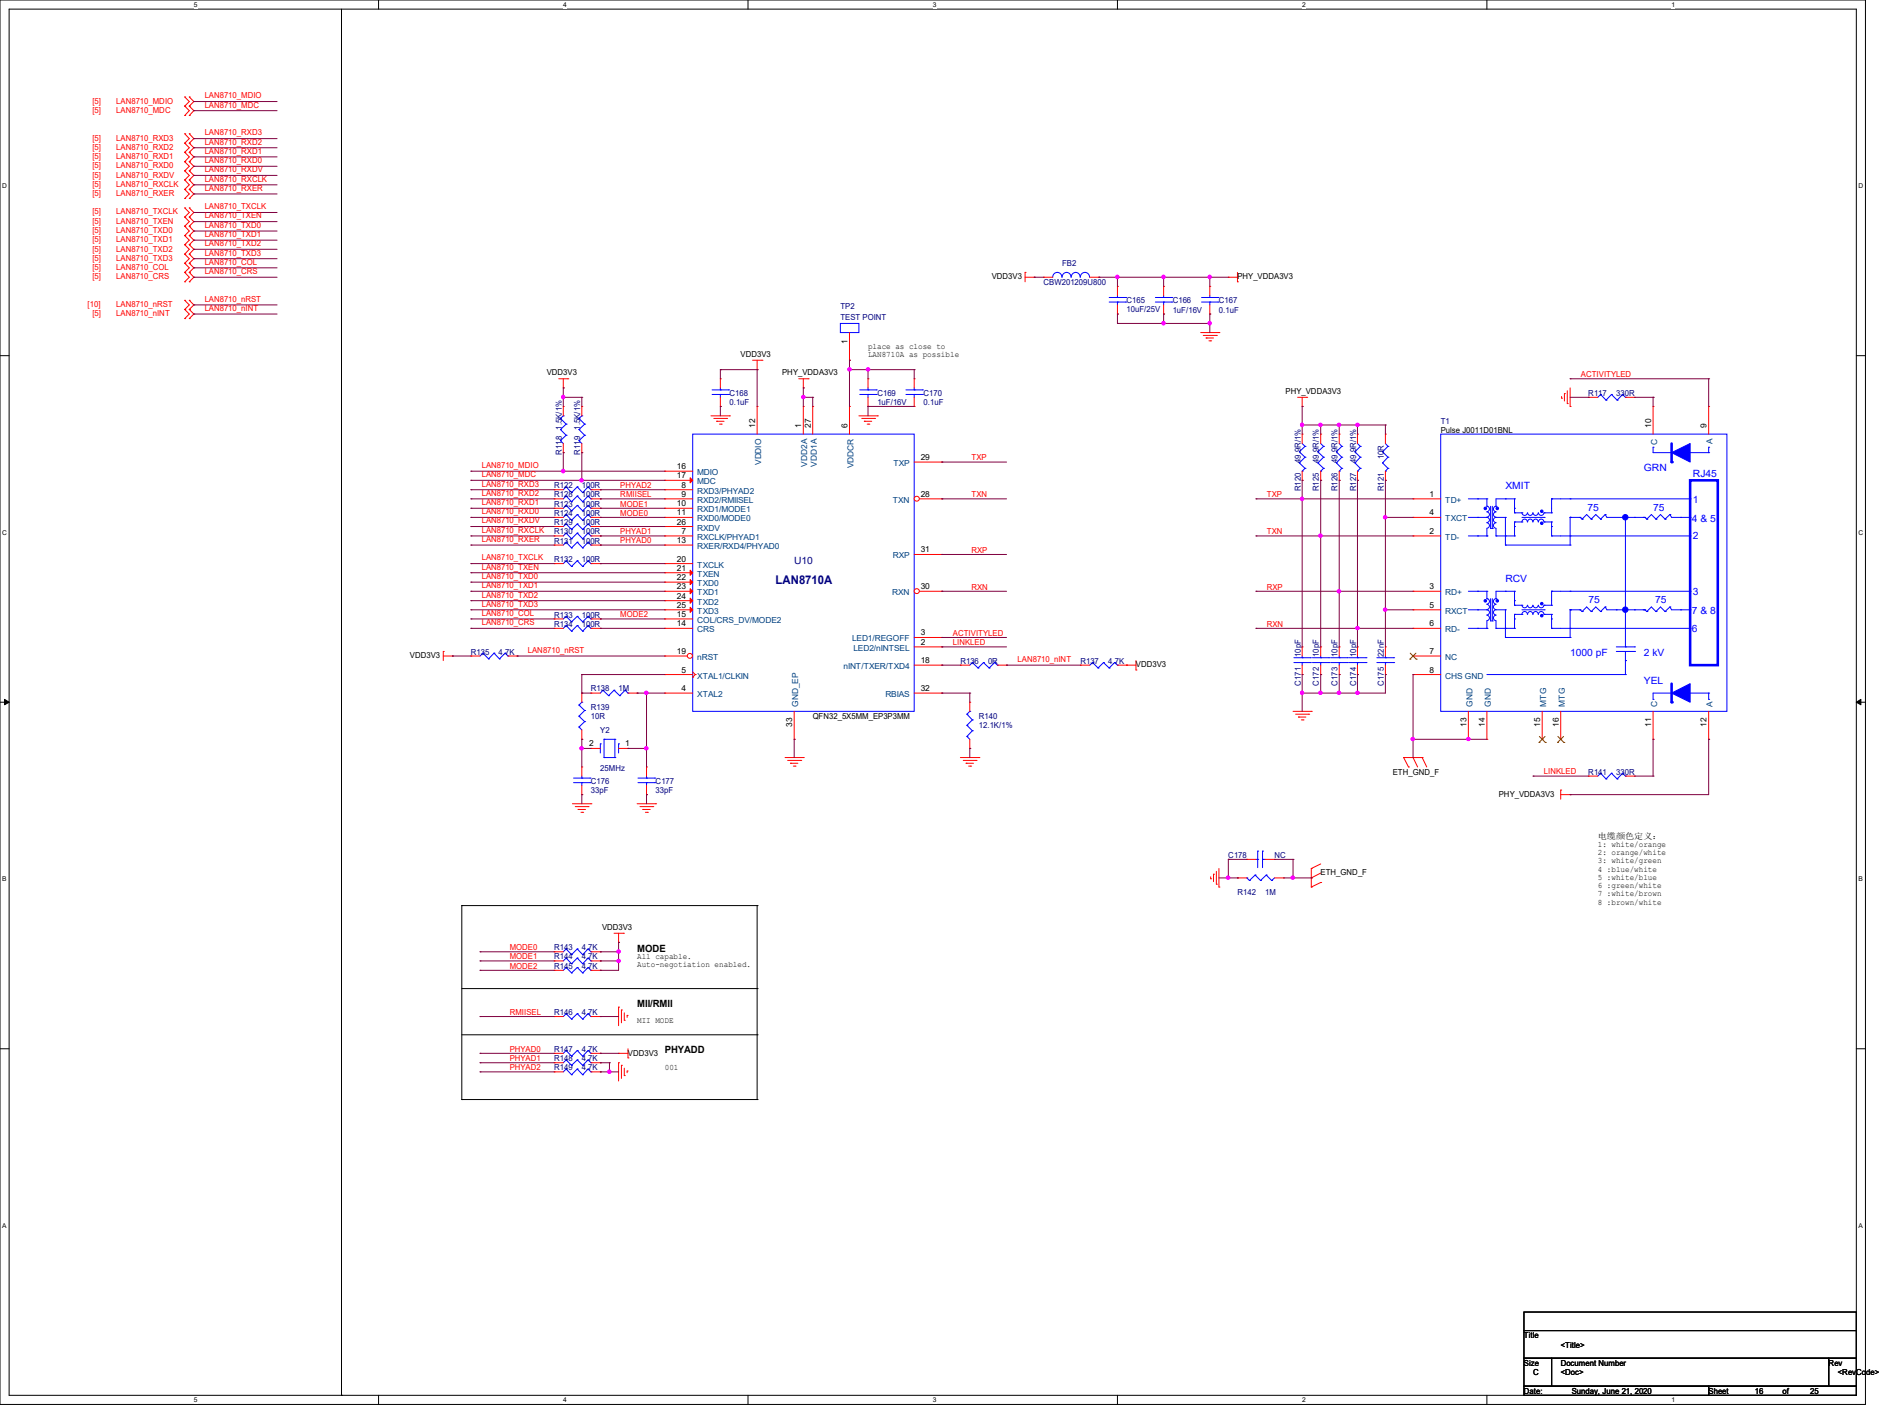
[picture p95: page 16]

place as close to
LAN8710A as possible

6 RXP 31 RXN 30 TXN 28 TXP 29

MDIO 16 MDC 17 RXD3/PHYAD2 8 RXD2/RMIISEL 9 RXD1/MODE1 10 RXD0/MODE0 11 RXDV 26 RXCLK/PHYAD1 7 RXER/RXD4/PHYAD0 13 TXCLK 20 TXEN 21 TXD0 22 TXD1 23 TXD2 24 TXD3 25 COL/CRS_DV/MODE2 15 CRS 14

8 :brown/white PHYADD MII/RMII MODE

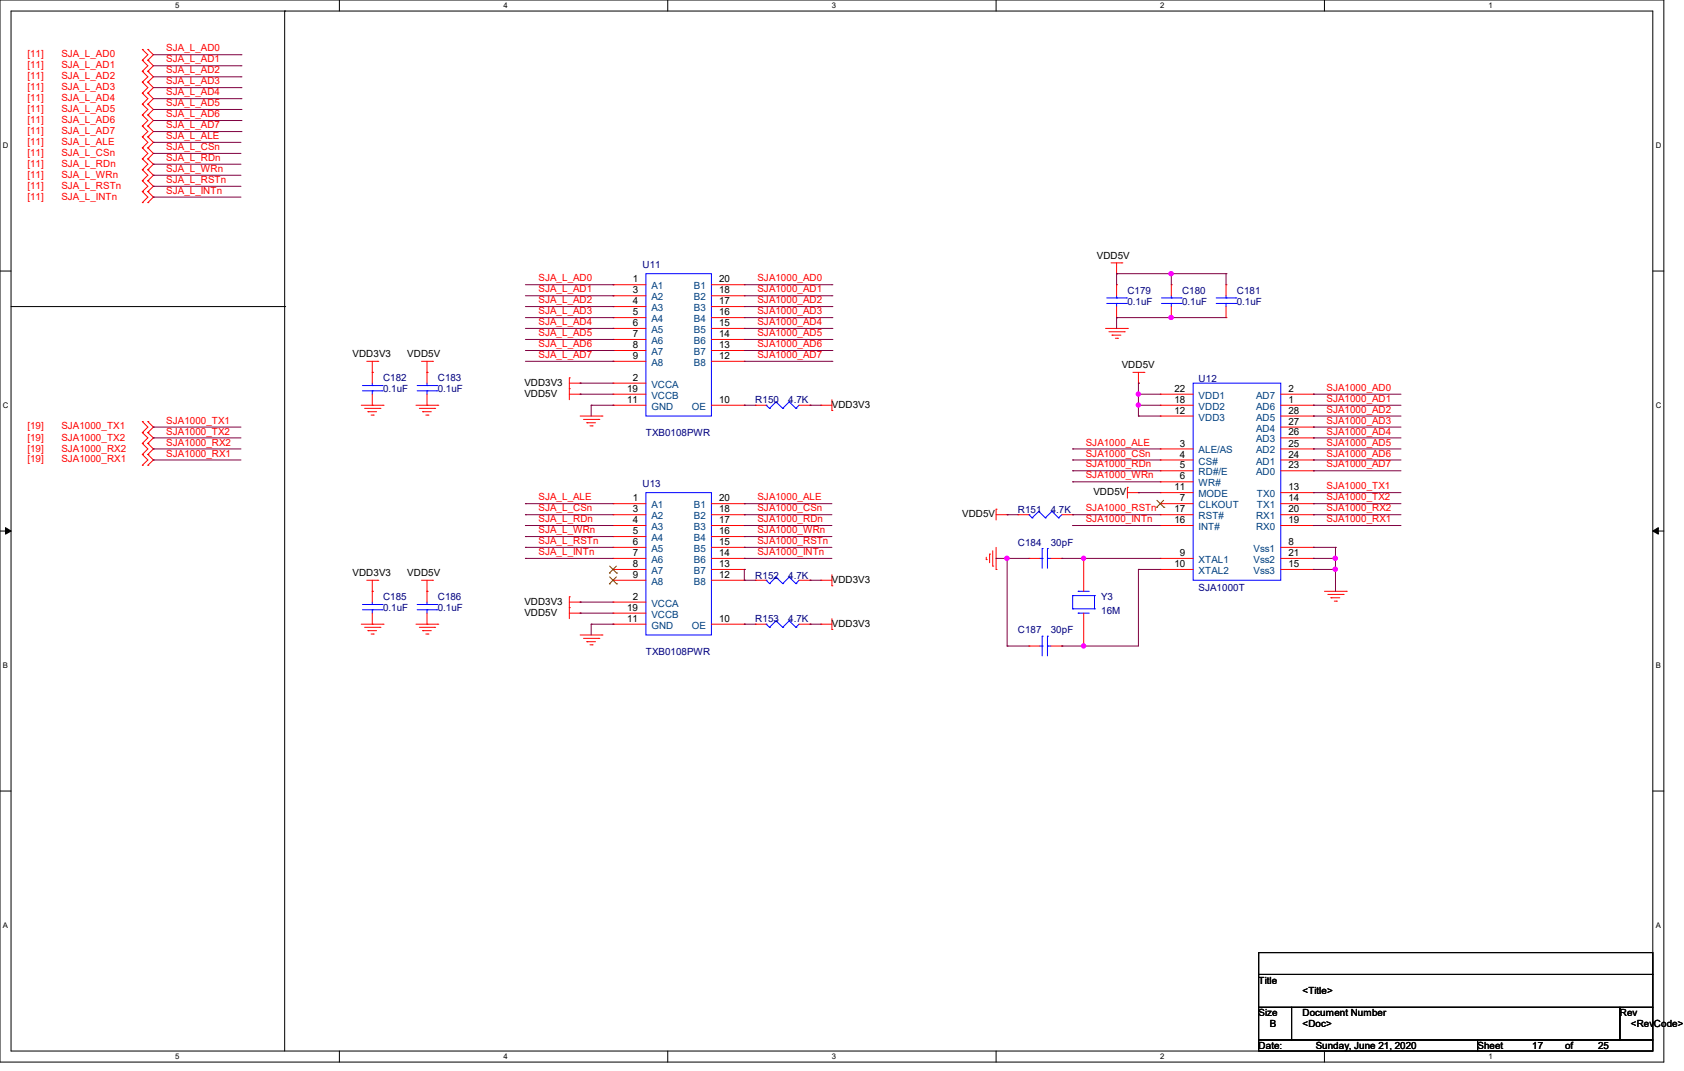
[picture p96: page 17]

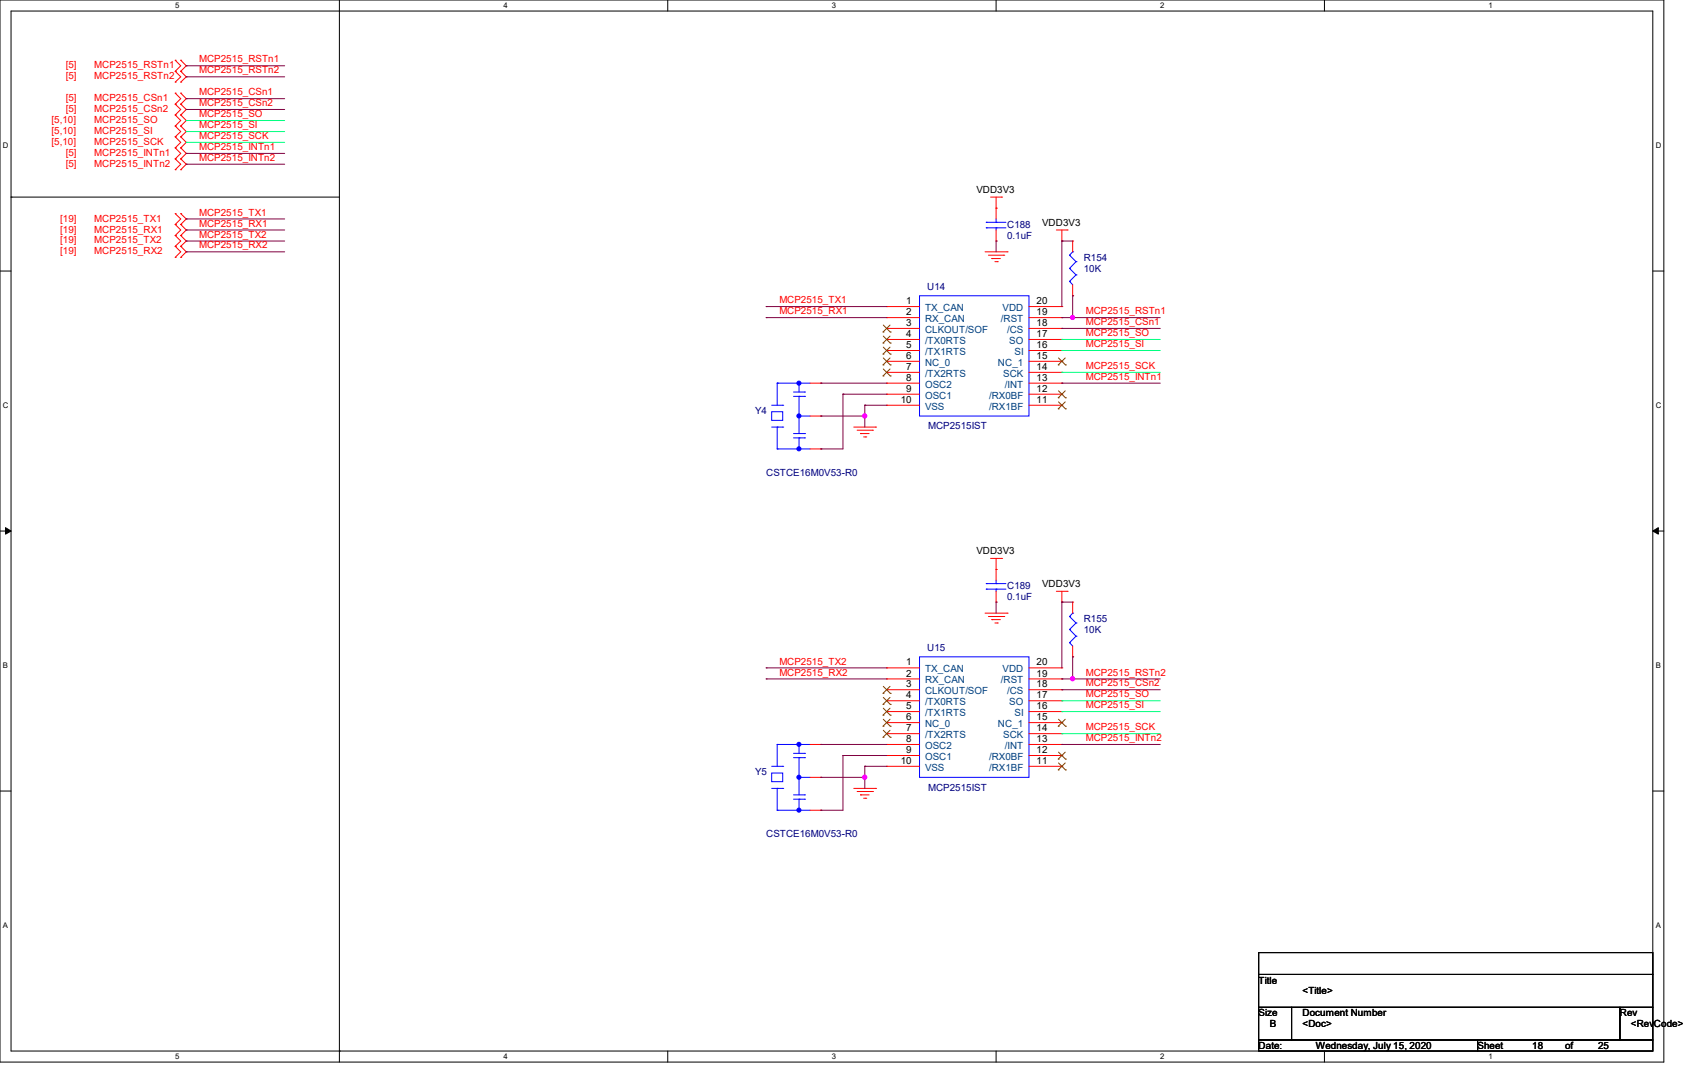
[picture p97: page 18]
VDD3V3 VDD3V3; VDD3V3; [5] MCP2515_CSn1 [5] MCP2515_CSn2; MCP2515_SO; MCP2515_SI; MCP2515_SCK; [5] MCP2515_INTn1 [5] MCP2515_INTn2; [19] MCP2515_TX1 [19] MCP2515_RX1; [19] MCP2515_RX2; [19] MCP2515_TX2; [5] MCP2515_RSTn1 [5] MCP2515_RSTn2; Title Size; Document Number; Rev Date:; Sheet; of <Doc>; <RevCode>; <Title> B; Wednesday, July 15, 2020; 25 Title Size; C188 0.1uF U14 MCP2515IST; TX_CAN 1; RX_CAN 2; CLKOUT/SOF 3; /TX0RTS 4; /TX1RTS 5; /TX2RTS 7; OSC2 8; OSC1 9; VSS 10; VDD; /RST; 15 SCK 14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

# R158 1K U20

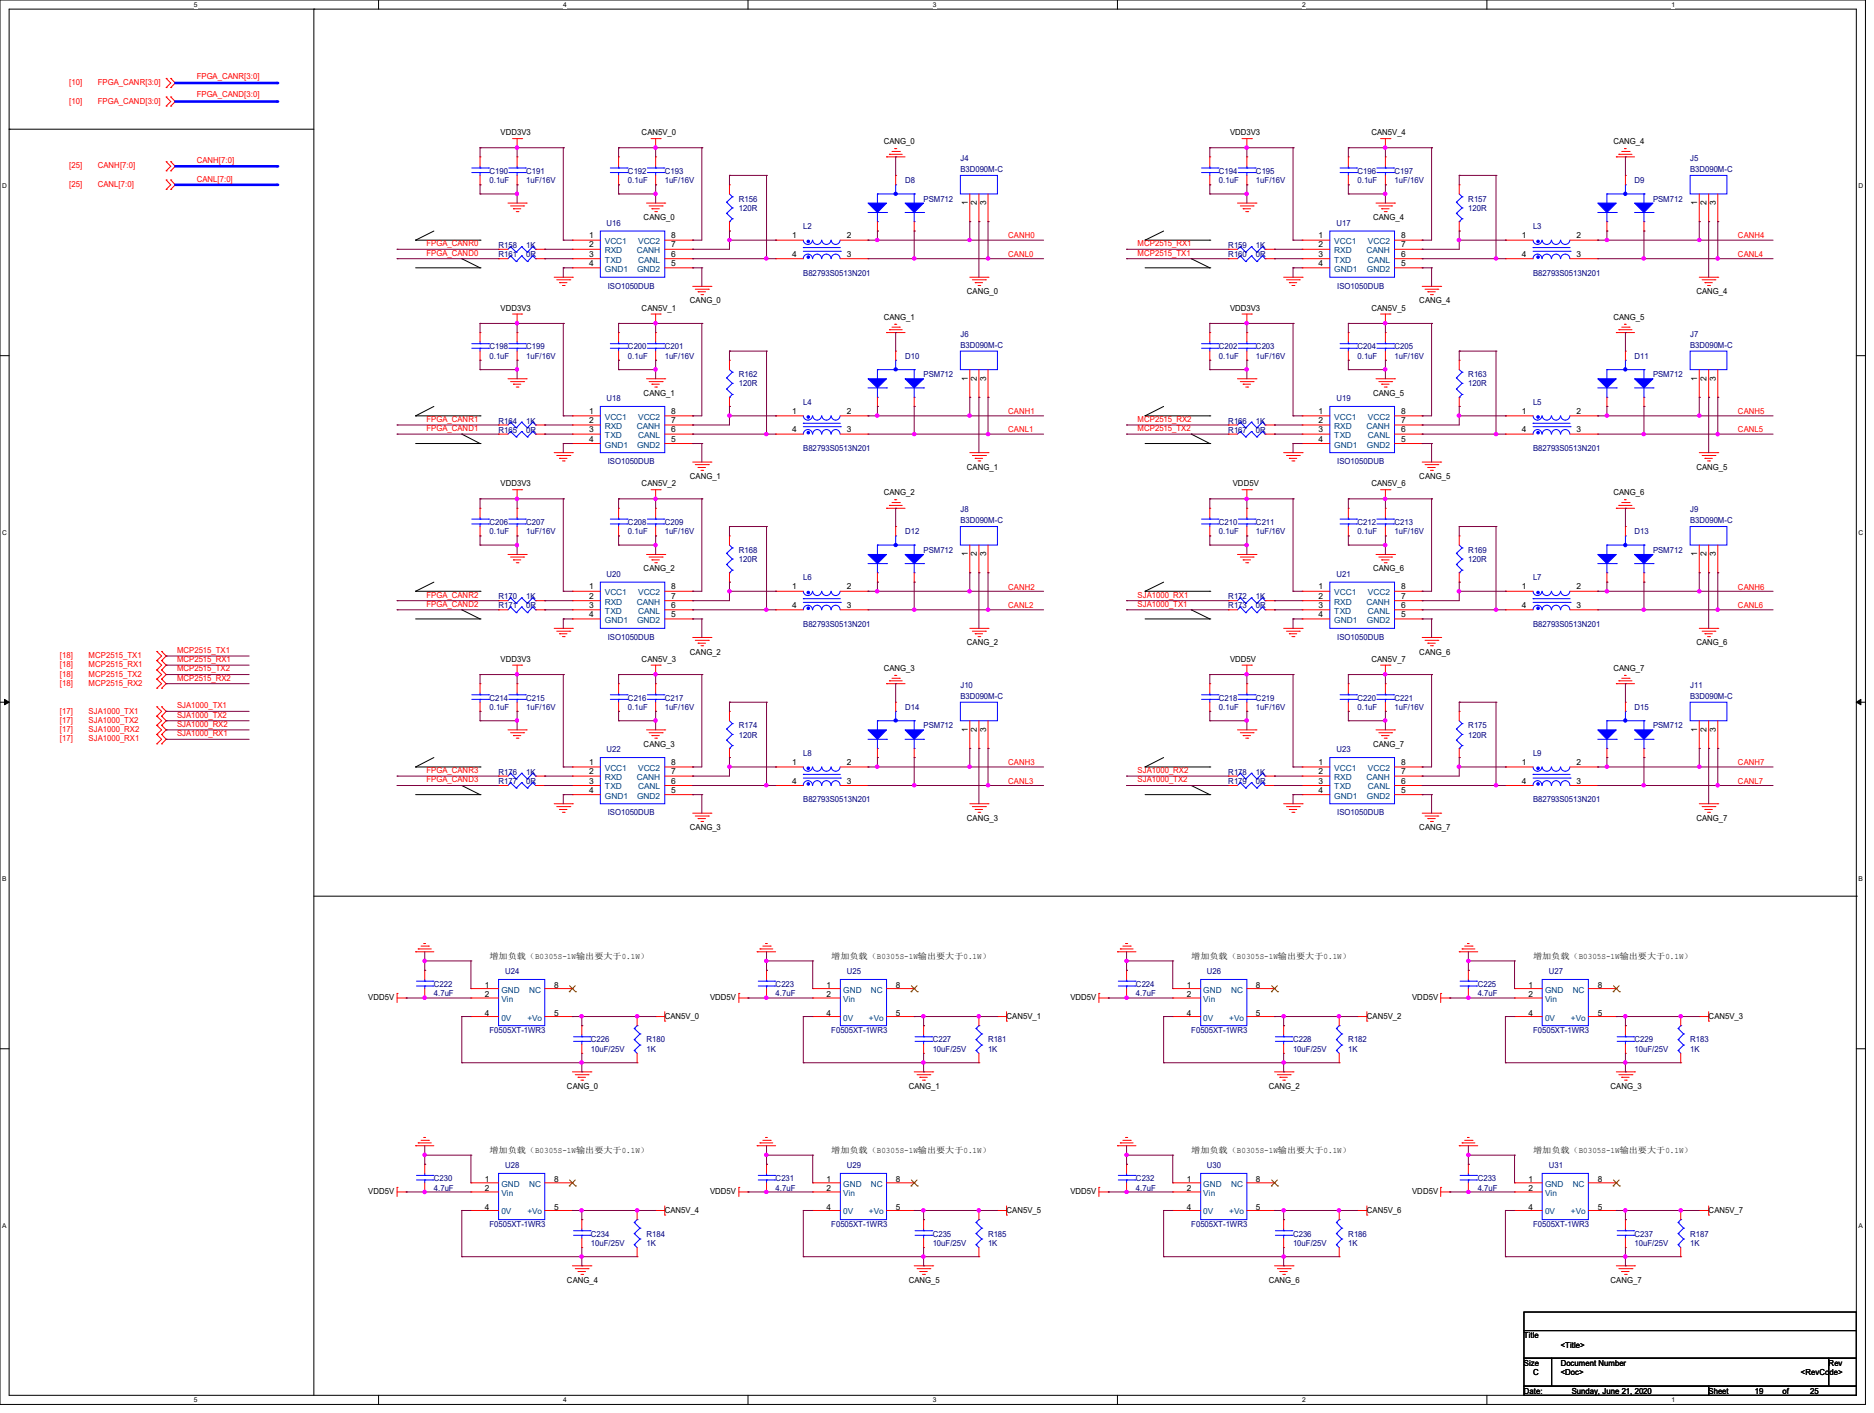
[picture p98: page 19]

[5,15] | DSP_SDA
[5,15] | DSP_SCL

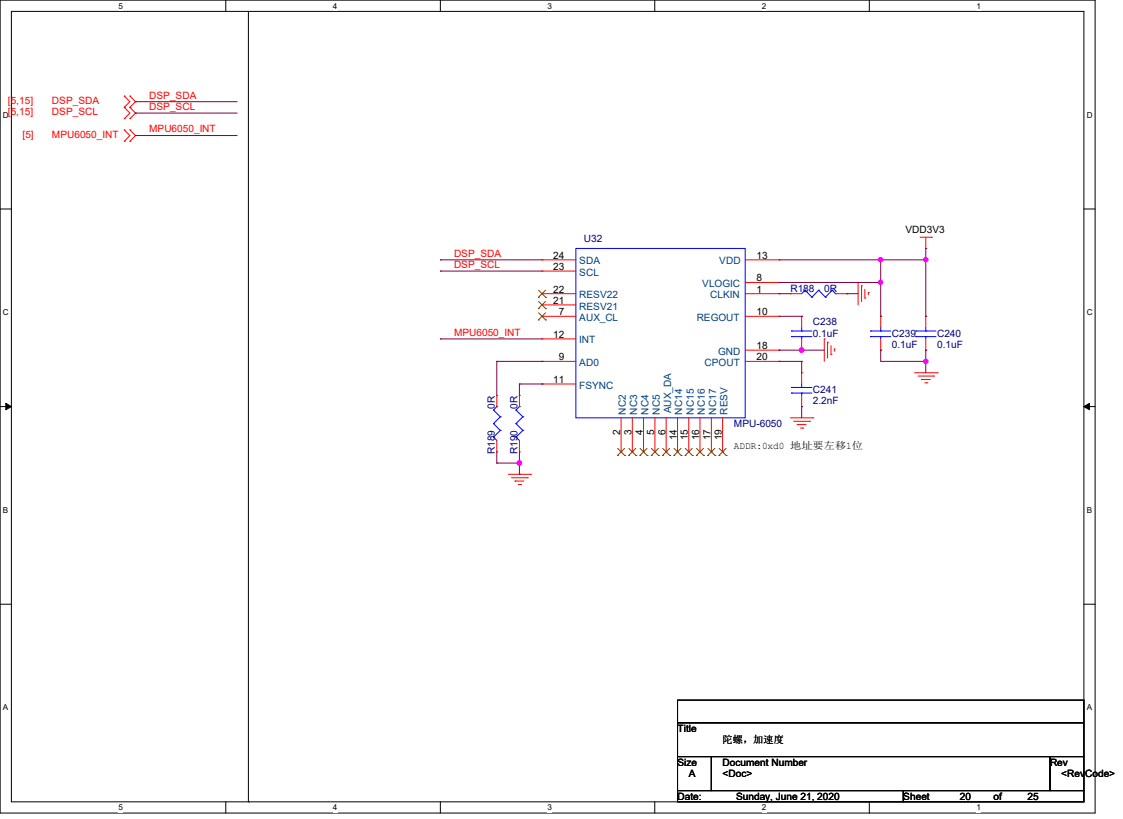
[picture p99: page 20]
ADDR:0xd0 地址要左移1位; VDD3V3; [5] MPU6050_INT; Title; Size; Document Number; Rev; Date:; Sheet; <Doc>; <RevCode>; 陀螺，加速度; Sunday, June 21, 2020; 0.1uF R¹⁹⁰ ⁰R; MPU-6050; CLKIN; 1 NC²; 5 AUX_DA; AUX_CL 7; VLOGIC; REGOUT; FSYNC 11; INT 12; VDD; 13 NC¹⁴ 14 NC¹⁵ 15 NC¹⁶ 16 NC¹⁷ 17; GND; 18 RESV 19; CPOUT; RESV21 21; RESV22 22; SCL 23; SDA 24 R¹⁸⁹ ⁰R; DSP_SDA DSP_SCL; MPU6050_INT; DSP_SCL; DSP_SDA

## DSP 1.2V OSCILLATOR

## DSP Oscillator frequency range 12MHz~30MHz

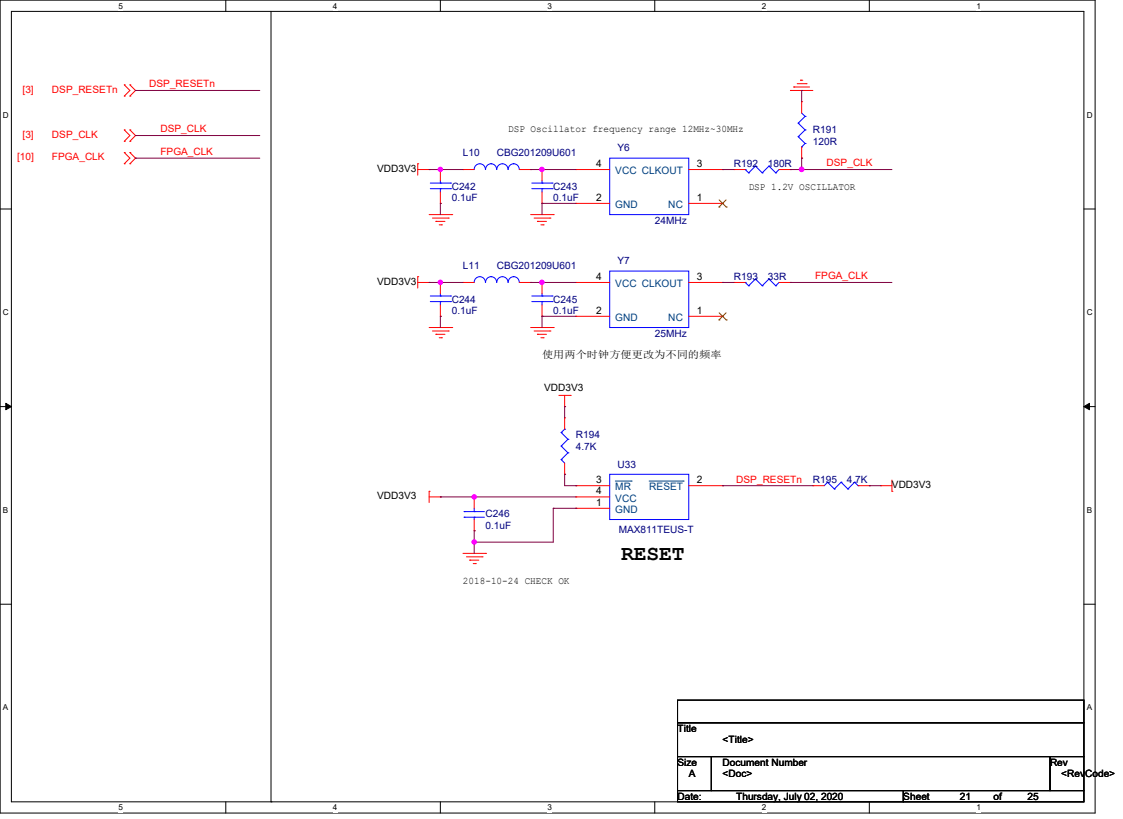
[picture p100: page 21]

## [10] SPK_CN

## SPK_CN

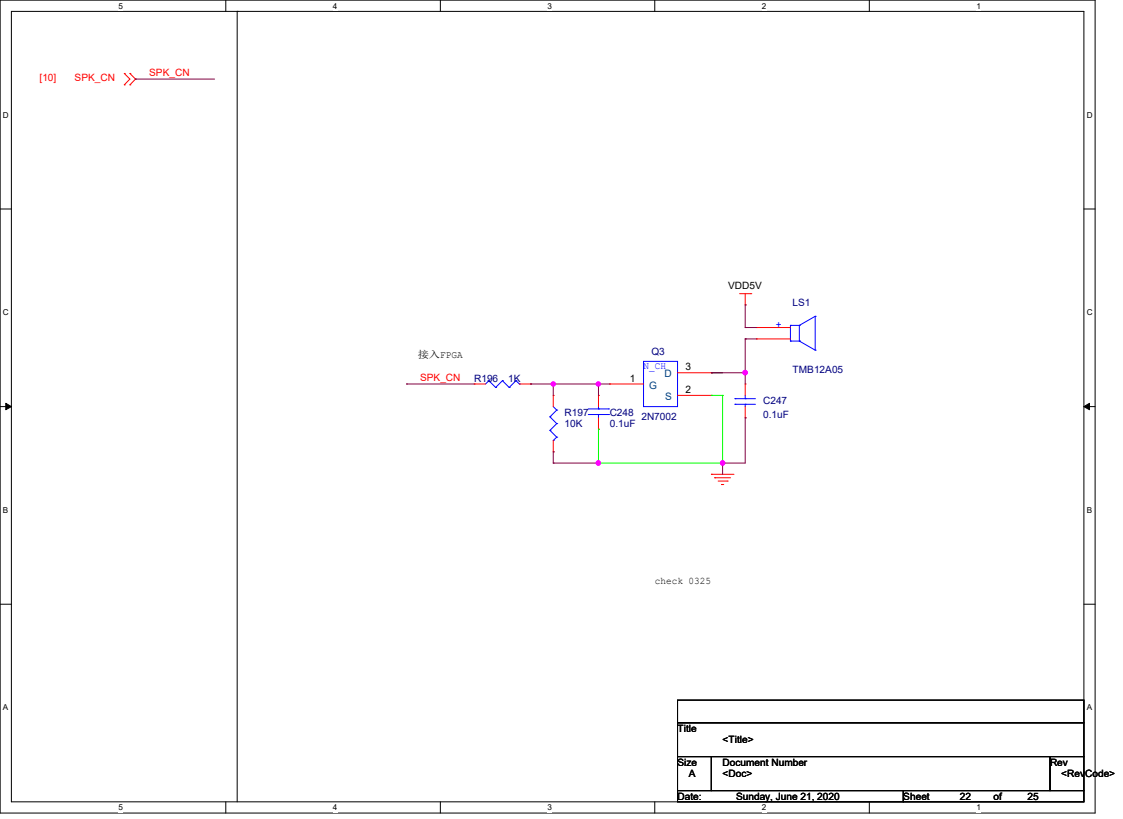
[picture p101: page 22]
接入FPGA; check 0325; VDD5V; Title; Size; Document Number; Rev; Date:; Sheet; <Doc>; <RevCode>; <Title>; Sunday, June 21, 2020; TMB12A05; SPK_CN

# 10uF/50V R201 9.1K/1%

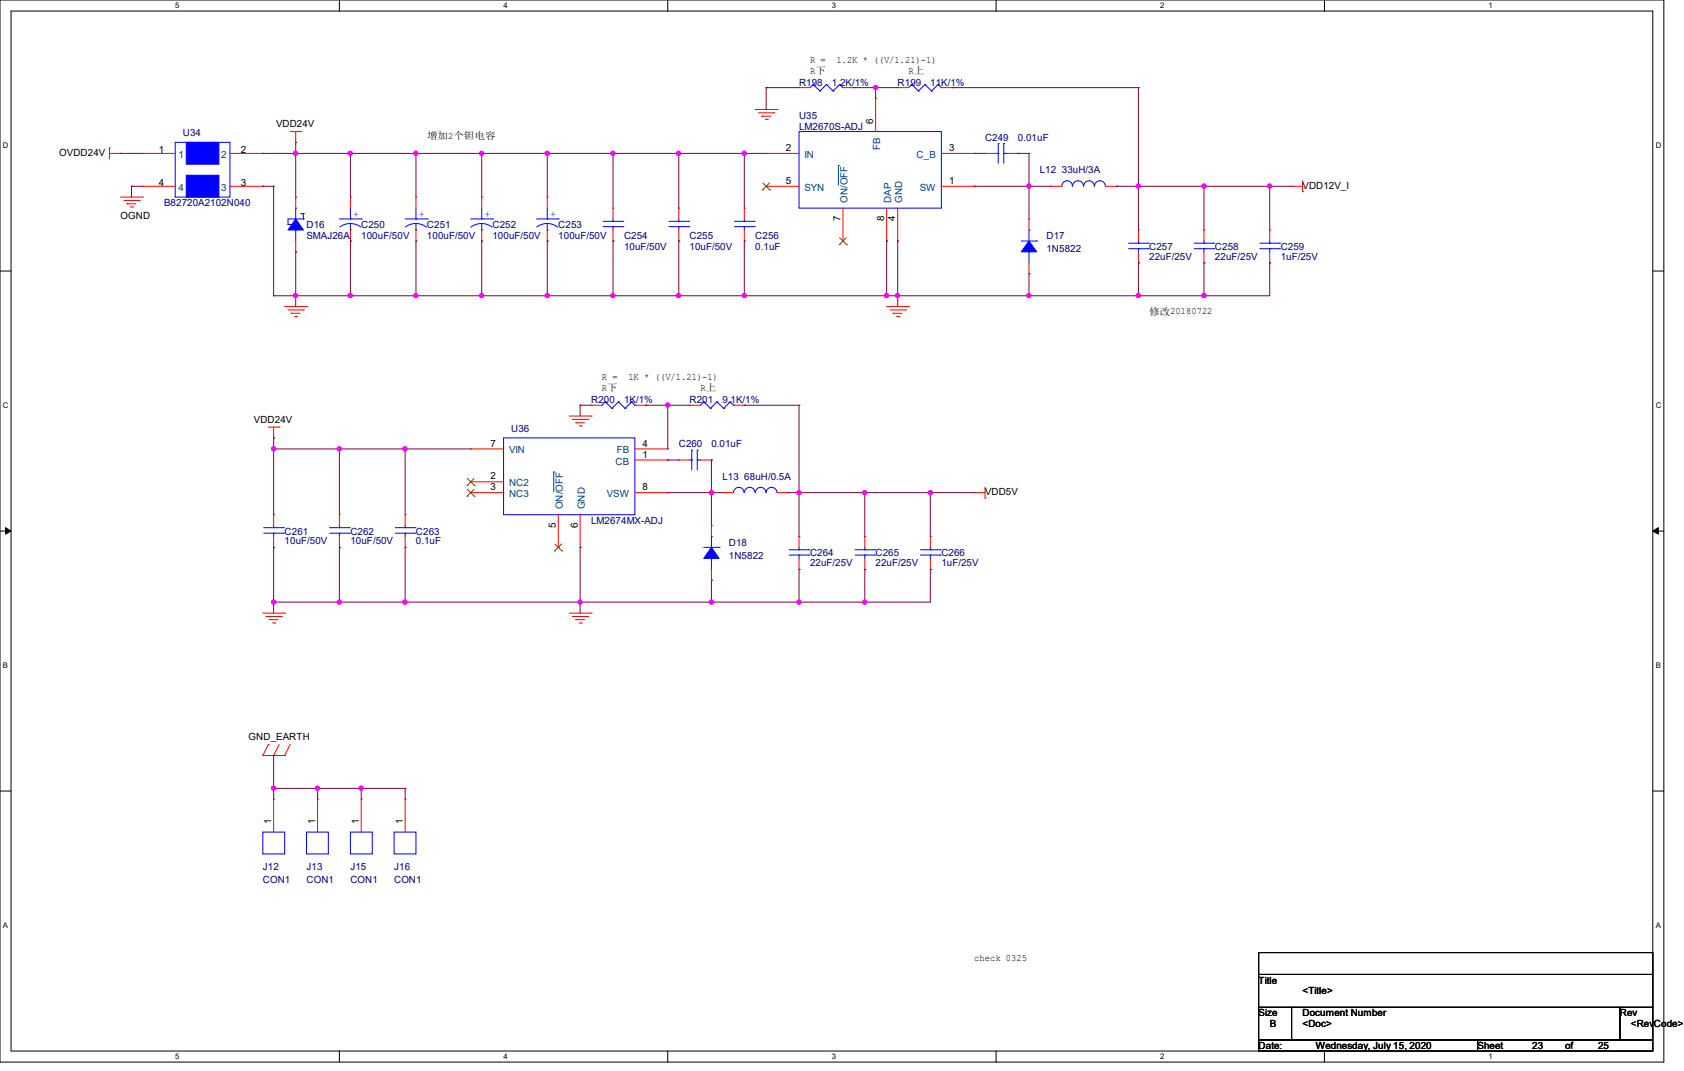
[picture p102: page 23]

# VDD1V2 VDD3V3

# U37 TPS54620

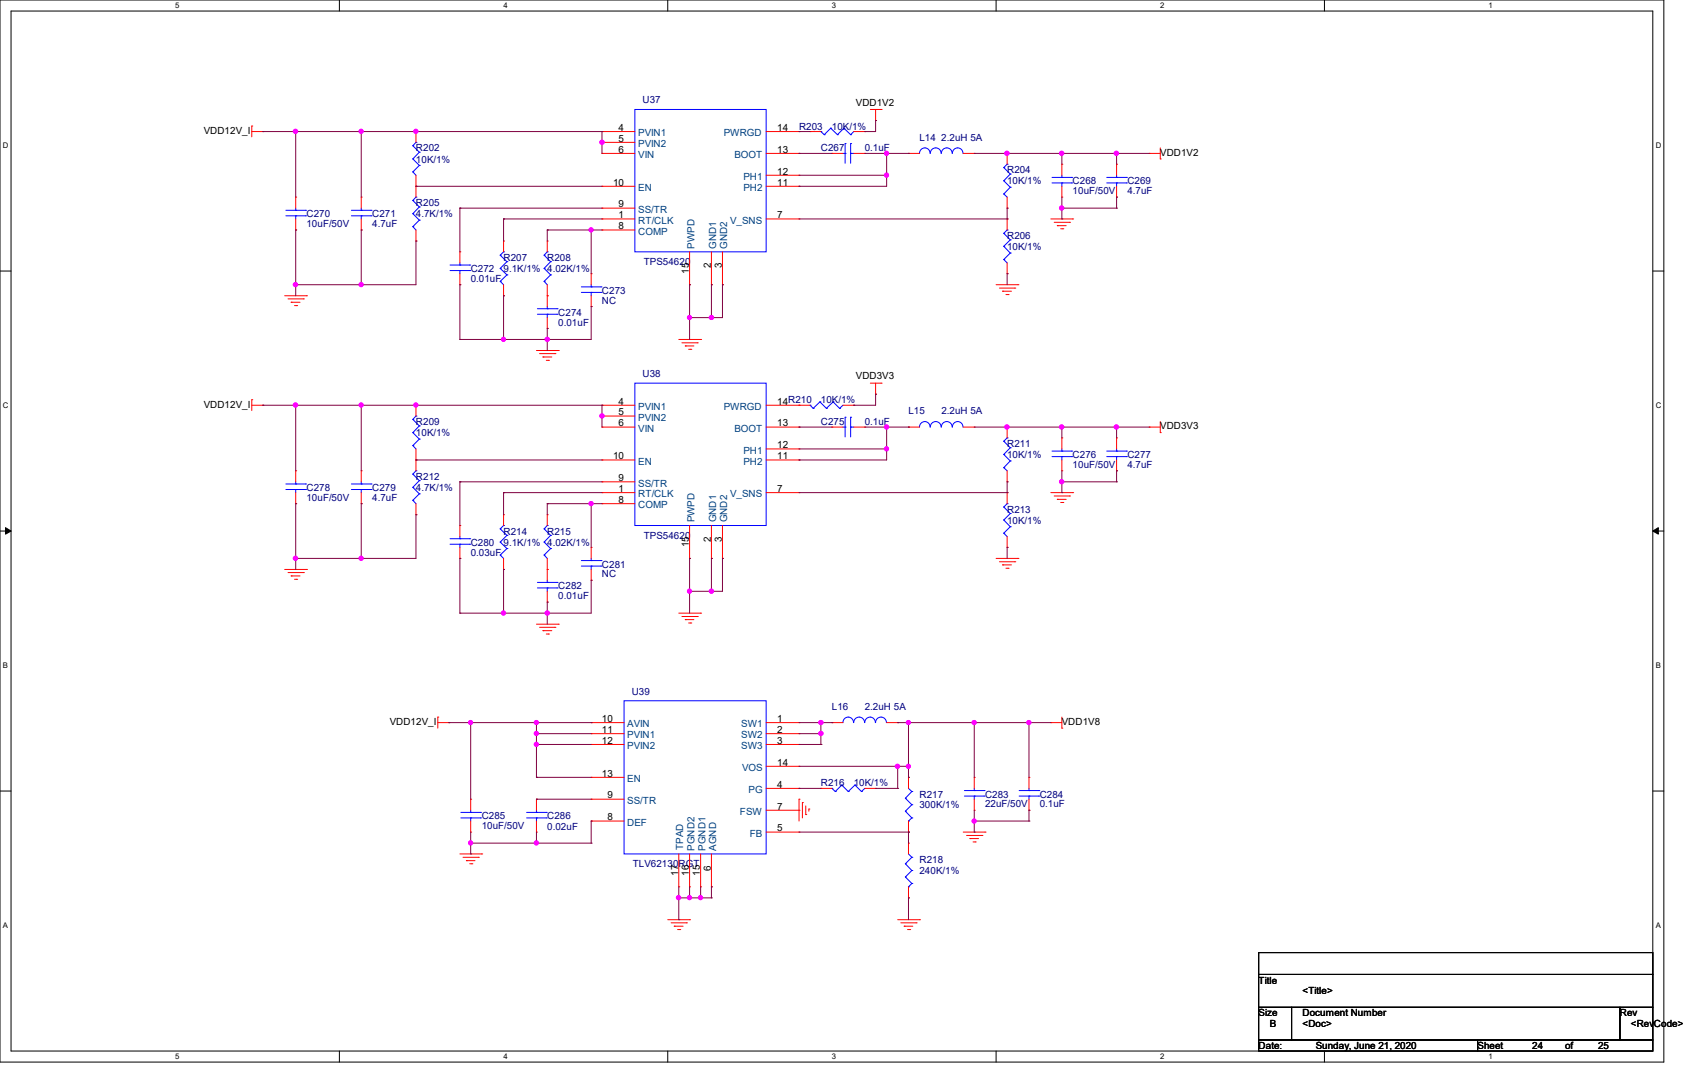
[picture p103: page 24]

## OGND

## OVDD24V

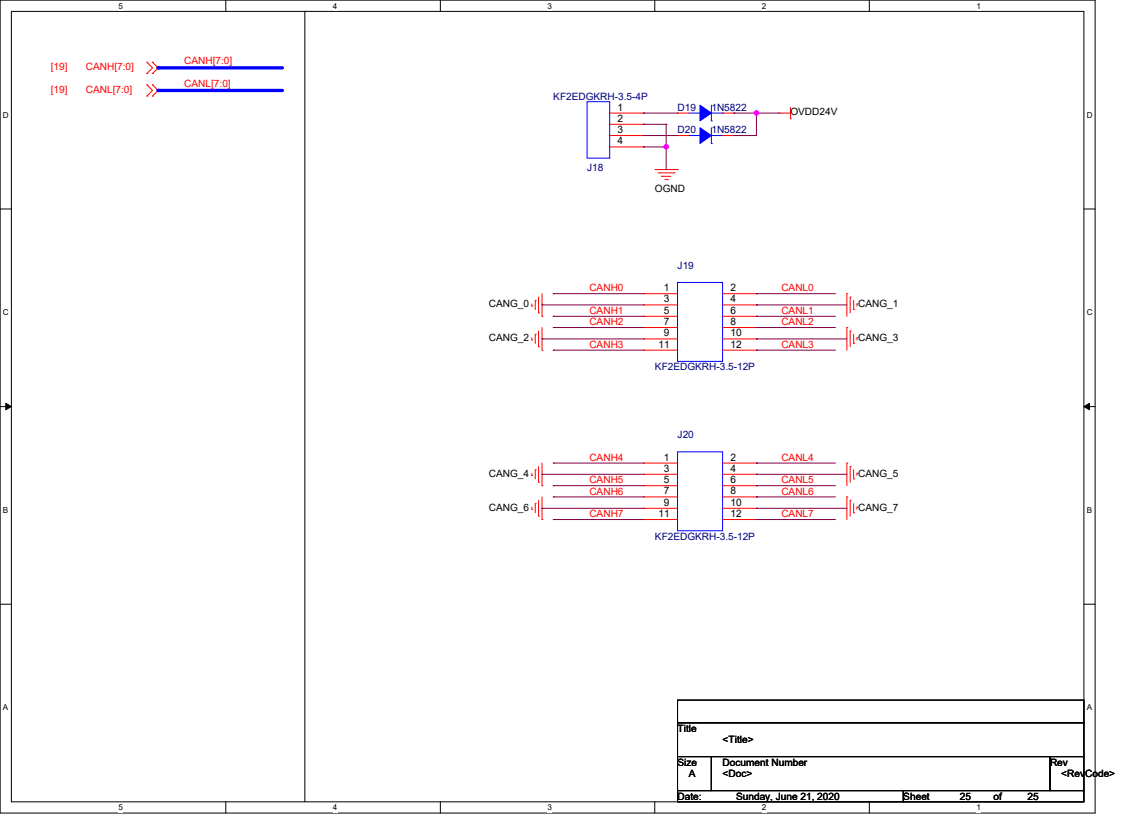
[picture p104: page 25]
CANG_0; CANG_2; CANG_1; CANG_3; CANG_4; CANG_6; CANG_5; CANG_7; [19] CANH[7:0]; [19] CANL[7:0]; Title; Size; Document Number; Rev; Date:; Sheet; <Doc>; <RevCode>; <Title>; Sunday, June 21, 2020; KF2EDGKRH-3.5-12P; KF2EDGKRH-3.5-4P 1 2 3 4; CANH[7:0]; CANL[7:0]; CANH0; CANH1; CANL0; CANL1; CANH2; CANL2; CANH3; CANL3; CANH4; CANL4; CANH5; CANL5; CANH6; CANL6; CANH7; CANL7
