donggua127/control_board/ipm/clk_wiz_25m.v

// file: clk_wiz_25m.v
// 
// (c) Copyright 2008 - 2011 Xilinx, Inc. All rights reserved.
// 
// This file contains confidential and proprietary information
// of Xilinx, Inc. and is protected under U.S. and
// international copyright and other intellectual property
// laws.
// 
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
// CRITICAL APPLICATIONS
// Xilinx products are not designed or intended to be fail-
// safe, or for use in any application requiring fail-safe
// performance, such as life-support or safety devices or
// systems, Class III medical devices, nuclear facilities,
// applications related to the deployment of airbags, or any
// other applications that could lead to death, personal
// injury, or severe property or environmental damage
// (individually and collectively, "Critical
// Applications"). Customer assumes the sole risk and
// liability of any use of Xilinx products in Critical
// Applications, subject only to applicable laws and
// regulations governing limitations on product liability.
// 
// THIS COPYRIGHT NOTICE AND DISCLAIMER MUST BE RETAINED AS
// PART OF THIS FILE AT ALL TIMES.
// 
//----------------------------------------------------------------------------
// User entered comments
//----------------------------------------------------------------------------
// None
//
//----------------------------------------------------------------------------
// "Output    Output      Phase     Duty      Pk-to-Pk        Phase"
// "Clock    Freq (MHz) (degrees) Cycle (%) Jitter (ps)  Error (ps)"
//----------------------------------------------------------------------------
// CLK_OUT1____80.000______0.000______50.0______450.000____150.000
//
//----------------------------------------------------------------------------
// "Input Clock   Freq (MHz)    Input Jitter (UI)"
//----------------------------------------------------------------------------
// __primary__________25.000____________0.010

`timescale 1ps/1ps

(* CORE_GENERATION_INFO = "clk_wiz_25m,clk_wiz_v3_6,{component_name=clk_wiz_25m,use_phase_alignment=true,use_min_o_jitter=false,use_max_i_jitter=false,use_dyn_phase_shift=false,use_inclk_switchover=false,use_dyn_reconfig=false,feedback_source=FDBK_AUTO,primtype_sel=DCM_SP,num_out_clk=1,clkin1_period=40.0,clkin2_period=40.0,use_power_down=false,use_reset=true,use_locked=true,use_inclk_stopped=false,use_status=false,use_freeze=false,use_clk_valid=false,feedback_type=SINGLE,clock_mgr_type=AUTO,manual_override=false}" *)
module clk_wiz_25m
 (// Clock in ports
  input         CLK_IN1,
  // Clock out ports
  output        CLK_OUT1,
  // Status and control signals
  input         RESET,
  output        LOCKED
 );

  // Input buffering
  //------------------------------------
  IBUFG clkin1_buf
   (.O (clkin1),
    .I (CLK_IN1));


  // Clocking primitive
  //------------------------------------

  // Instantiation of the DCM primitive
  //    * Unused inputs are tied off
  //    * Unused outputs are labeled unused
  wire        psdone_unused;
  wire        locked_int;
  wire [7:0]  status_int;
  wire clkfb;
  wire clk0;
  wire clkfx;

  DCM_SP
  #(.CLKDV_DIVIDE          (2.000),
    .CLKFX_DIVIDE          (5),
    .CLKFX_MULTIPLY        (16),
    .CLKIN_DIVIDE_BY_2     ("FALSE"),
    .CLKIN_PERIOD          (40.0),
    .CLKOUT_PHASE_SHIFT    ("NONE"),
    .CLK_FEEDBACK          ("1X"),
    .DESKEW_ADJUST         ("SYSTEM_SYNCHRONOUS"),
    .PHASE_SHIFT           (0),
    .STARTUP_WAIT          ("FALSE"))
  dcm_sp_inst
    // Input clock
   (.CLKIN                 (clkin1),
    .CLKFB                 (clkfb),
    // Output clocks
    .CLK0                  (clk0),
    .CLK90                 (),
    .CLK180                (),
    .CLK270                (),
    .CLK2X                 (),
    .CLK2X180              (),
    .CLKFX                 (clkfx),
    .CLKFX180              (),
    .CLKDV                 (),
    // Ports for dynamic phase shift
    .PSCLK                 (1'b0),
    .PSEN                  (1'b0),
    .PSINCDEC              (1'b0),
    .PSDONE                (),
    // Other control and status signals
    .LOCKED                (locked_int),
    .STATUS                (status_int),
 
    .RST                   (RESET),
    // Unused pin- tie low
    .DSSEN                 (1'b0));

    assign LOCKED = locked_int;

  // Output buffering
  //-----------------------------------
  BUFG clkf_buf
   (.O (clkfb),
    .I (clk0));

  BUFG clkout1_buf
   (.O   (CLK_OUT1),
    .I   (clkfx));




endmodule
