donggua127/control_board/src/can/can_register.v

// =================================================================================/
// Project Name :
// Author       : chendong
// Email        : dongfang219@126.com
// Creat Time   : 2018/10/25 17:03:26
// File Name    : can_register.v
// Module Ver   : V1.0
// Abstract     :
//
// CopyRight(c) 2014, Authors...
// All Rights Reserved
//
// ---------------------------------------------------------------------------------/
//
// Modification History:
// V1.0         initial
// =================================================================================/
`timescale 1ns/1ns

module can_register #(
parameter                           WIDTH = 8, // default parameter of the register width
parameter                           U_DLY = 1
)(
input           [WIDTH-1:0]         data_in,
input                               we,
input                               clk,

output  reg     [WIDTH-1:0]         data_out
);
// Parameter Define

// Register Define

// Wire Define


always @ (posedge clk)
begin
    if (we == 1'b1)                        // write
        data_out <= #U_DLY data_in;
    else;
end



endmodule
