donggua127/control_board/(commit log)

2019-05-27 V1.0版本Git归档
2019-05-28 V2.0编译通过
2019-07-19 添加信号检测
2019-09-12 添加signal_int_enb寄存器，解决DSP中断处理过程中，无法收到中断的问题
2019-09-14 1.增加编码器功能，占用io[5:7](A/B/Z三相) 2.调整Signal的位置，占用io[2:4],共3个信号检测
2019-10-14 增加光电对管的高电平编码器检测；
2019-11-22 添加编码器Z轴上升沿检测
2019-11-22 增加一路编码器
2020-03-29 添加刹车心跳检测模块代码，尚未综合
2020-04-05 编译通过版本，待测试
2020-07-03 添加FPGA的SPI FLASH在线更新接口
2020-09-09 docs: 增加V3.0的原理图相关文档
    [interface.brd]
2020-09-28 feat: V3.0 FPGA修改
2020-10-26 fix: 增加V3.0的SJA1000控制接口
2020-12-02 修改FPGA刹车的寄存器初始值和地址
